Pcfccn/Dash/docs/future/README.md

# Доработки: исследования, планы и сборка

Здесь — то, что начиналось как исследование или план. Часть уже в прошивке (статус ниже), остальное ждёт деталей или решения. Каждая доработка — отдельный файл: идея, железо, BOM, план интеграции в прошивку и открытые вопросы.

| Доработка | Статус | Файл |
|---|---|---|
| GPS-скорость и замер разгона (0–100, 1/4 мили, «свой Dragy») | **в прошивке** — страница PERF (`perf.c`, 2026-10-22); в машине не проверено | [gps-performance-meter.md](gps-performance-meter.md) |
| Свой одометр по GPS (общий, поездка, счётчик A) и расход дизеля (мгновенный, за поездку, средний) | одометр **в прошивке** — страница TRIP, хранение в SPI NOR (`odo.c`, `nvlog.c`, 2026-10-22); расход — источник на E98 ещё искать | [gps-odometer-fuel.md](gps-odometer-fuel.md) |
| Чистовая сборка: питание, CAN, драйвер подсветки, разъёмы, корпус, список покупок | выбран вариант A, детали заказаны; порядок проверки — §5 | [build-hardware.md](build-hardware.md) |
| Плата-носитель 7×9 см: раскладка, гнёзда под WeAct, клеммники с ключами, список проводов | раскладка готова, не собрана (2026-10-14) | [carrier-board.md](carrier-board.md), чертёж [carrier-board.svg](carrier-board.svg), шаблон [carrier-template.pdf](carrier-template.pdf) |
| Сборка платы-носителя по шагам: каждая деталь и провод, проверка после шага | готово к сборке (2026-10-20) | [assembly.md](assembly.md), картинки в [assembly/](assembly/) |
| Жгут: пять веток из коробки (питание, CAN, GPS, кнопки + габариты, дисплей), цвета, врезки | готово к сборке (2026-10-21) | [harness.md](harness.md), [harness.svg](harness.svg), общая схема [wiring-overview.svg](wiring-overview.svg) |
| Экран: качество картинки и скорость (этап 0 без покупок, IPS-замена, ESP32-S3 со встроенным экраном и CAN) | этап 0 сделан 2026-10-09; палитра под TN и проверка контроллера (настоящий ILI9488) — 2026-10-22; новое железо не выбрано | [display-upgrade.md](display-upgrade.md) |

Чертежи (`*.svg`, `assembly/`, `carrier-template.pdf`) генерируются скриптами из `tools/drawings/` — правится скрипт, а не картинка.
