Pcfccn/Dash/design/Photos/20260724_9/SESSION_NOTES.md

# Сессия 2026-07-24, утро (~10:19–10:20) — расшифровка фото

25 фото. Прошивка с коммитами `1c3979f` (passive CAN oil P), `e9b38e5` (RAIL в bar), `49c65be` (fix false 0.0).
Двигатель запускался, работал на холостом, несколько раз газовали.

---

## DRIVE page

| Фото | RPM  | CLT | OIL | ATF | OIL P | Статус  |
|---|---|---|---|---|---|---|
| 434  | 0 | 13°C  | 13°C  | 13°C  | 0.7 bar 🟠 | CHECK 1 |
| 435  | 842  | 29°C  | 14°C  | 19°C  | 2.5 bar 🟢 | NOMINAL |
| 440  | 787  | 28°C  | 14°C  | 18°C  | 0.5 bar 🟠 | NOMINAL |
| 441  | 2550 | 29°C  | 14°C  | 19°C  | 1.5 bar 🟡 | NOMINAL |
| 442  | 1021 | 27°C  | 14°C  | 17°C  | 0.5 bar 🟠 | NOMINAL |
| 447  | 763  | 17°C  | 13°C  | 14°C  | 2.3 bar 🟢 | NOMINAL |
| 451  | 916  | 17°C  | 13°C  | 14°C  | 0.4 bar 🔴 | NOMINAL |
| 453  | 1023 | 27°C  | 14°C  | 17°C  | 1.2 bar 🟢 | NOMINAL |
| 458  | 842  | 29°C  | 14°C  | 19°C  | 2.0 bar 🟢 | NOMINAL |

Все фото: GEAR=P, Speed=0 km/h, BOOST=0.0 bar. OIL temp не греется — двигатель работал коротко, холодный.

**Проблема:** OIL P хаотично скачет даже на одном и том же RPM — 842 RPM даёт и 2.5 и 2.0 bar, 916 RPM — 0.4 bar (RED), 787 RPM — 0.5 bar. Нет корреляции с RPM. Подозрение на неверный CAN-фрейм или смещение байта в passive decode.

---

## DIAG page

| Фото | BATT | IAT | LOAD | RAIL | Debug footer | Статус  |
|---|---|---|---|---|---|---|
| 439  | 11.9V🟡| 16°C  | 0% | 2 bar | GR 01 OILP 00=0.70 NRC 22/31 | WARN 1  |
| 449  | 13.8V  | 16°C  | 18%  | 395 bar | GR 01 OILP 00=1.17 NRC 22/31 | NOMINAL |
| 455  | 13.7V  | 17°C  | 16%  | 394 bar | (footer обрезан) | NOMINAL |
| 457  | 13.7V  | 16°C  | 20%  | 365 bar | GR 01 OILP 00=1.50 NRC 22/31 | NOMINAL |

Все фото: MIL/CHECK ENGINE=OFF, NO STORED CODES ✓, PID probe: no reply yet.

**Debug строка формат:** `GR 01 OILP [OBD_byte]=[passive_CAN_decoded] NRC 22/31`
- OBD grouped mode-01 всегда возвращает `00` для oil pressure (ECM игнорирует PID)
- `=X.XX` — это значение из passive CAN decode (работает!)
- NRC 22/31 = negative response на DID probe (как и ожидалось)

**BATT 11.9V** в фото 439 (двигатель не работал) — граничное значение, предупреждение появилось.
**RAIL 365–395 bar** при работающем двигателе — норма для дизеля на холостом.
**RAIL 2 bar** при заглушенном — остаточное давление, нормально.

---

## DPF page

| Фото | SOOT | dP DPF | EGT | SINCE REGEN | EGR T° | Статус  |
|---|---|---|---|---|---|---|
| 436  | 8% | 0.0 kPa | -- °C  | -- km | -- °C  | NOMINAL |
| 437  | 8% | -- kPa 🔴 | -- °C  | -- km | -- °C  | WARN 1  |
| 448  | -- % | -- kPa | -- °C  | -- km | -- °C  | NOMINAL |
| 458b | 8% | -- kPa | -- °C  | -- km | -- °C  | NOMINAL |

**ВАЖНО:** dP DPF теперь показывает `--` (NaN) вместо `0.0 kPa` — Astra K DID не отвечает на этом ECM.
Фото 448 — SOOT тоже `--` (NaN!), значит иногда DID для soot тоже не отвечает.
Фото 436 показывает SOOT=8% и dP=0.0 kPa — другое состояние.
REGEN=Inactive, EGT/EGR T°/SINCE REGEN — всегда NaN, как ожидалось.

---

## SNIFF page

### Фото 438 — WARN 1, 60 fps, IDS 38, L120 (повёрнут)
**STATE**:
```
287.0  4  820043C1
0C9.7  2  FF00
0C9.3  4  000D070A
199.0  4  (нечётко)
```
**ANALOG**:
```
1E1.1  00>FF =00
0BE.5  00>FF =FF
19D.3  00>FF =FD
3D3.5  00>FF =00
1AA.2  06>F6 =16
```

### Фото 443 — NOMINAL, 45 fps, IDS 31, L322, OBD paused
**STATE** (ключевые данные):
```
0BE.0  4  04080C00
0BE.5  4  FFFEFD00
0C9.1  2  0F0E           ← НОВОЕ: 2 байта; 0x0F=15, 0x0E=14 (похоже на температуры)
0C9.3  4  070A0D00
191.3  6  B4B0AFB1B2B5   ← расширился до 6 байт (вчера было 5)
191.5  6  B4B0AFB1B2B5
```
**ANALOG**:
```
0BE.5  00>FF =FE
1E1.1  00>FE =FE
19D.3  00>FE =FE
1AA.5  00>F0 =40
0C9.2  27>FF =FF         ← НОВОЕ: диапазон 0x27(39)..0xFF(255), сейчас 0xFF
```

### Фото 446 — NOMINAL, 46 fps, IDS 31, L327, OBD paused
**STATE**:
```
0BE.0  4  04080C00
0BE.5  4  FFFEFD00
0C9.3  4  070A0D00
191.1  7  B4B1B0AFB1B2B5B6  ← 7 байт! (вчера 5, сегодня раньше 6)
191.3  7  B4B0AFB1B2B5B6
191.5  7  B4B0AFB1B2B5B6
```
**ANALOG**:
```
0BE.5  00>FF =FE
1E1.1  00>FF =FD
19D.3  00>FE =FE
1AA.5  00>F0 =50
0C9.2  27>FF =E1
```

### Фото 458 — NOMINAL, 45 fps, IDS 30, L313, OBD paused
**STATE**:
```
0BE.0  4  04080C00
0BE.5  4  FFFEFD00
0C9.3  4  070A0D00
0F1.0  4  8DB1A599
199.0  2  CF0F
199.5  2  8D90
```
**ANALOG**:
```
0BE.5  00>FF =FE
1E1.1  00>FE =FD
19D.3  00>FD =00
1AA.5  00>F0 =00
287.0  00>C1 =82
```

---

## Сводный анализ сессии

### Что работает (улучшения после коммитов)
1. **OIL P читается с CAN** — passive decode подхватывает значение, "--" больше нет при работающем двигателе
2. **RAIL в bar** — 365-395 bar на холостом, физически корректно
3. **Нет false 0.0 CRIT** при работающем двигателе (в большинстве случаев)
4. **MIL OFF / NO STORED CODES** — чисто

### Проблемы

#### 1. OIL P нестабильна — приоритет высокий
| Состояние | Значение | Ожидание |
|---|---|---|
| RPM=0 (прогрев) | 0.7 bar 🟠 | должно быть NaN или скрыто |
| RPM=842 | 2.5 / 2.0 bar | норма ~2-3 bar ✓ |
| RPM=787 | 0.5 bar 🟠 | слишком мало |
| RPM=916 | 0.4 bar 🔴 | CRIT при работающем моторе |
| RPM=2550 (газ)  | 1.5 bar 🟡 | при 2550 ожидается 4-5 bar |

Вывод: passive CAN decode видит нужный фрейм, но **значения не коррелируют с RPM** и физически неправдоподобны. Скорее всего: неверный байт или неверная формула масштабирования. При 2550 RPM должно быть >4 bar, а показывает 1.5 bar.

#### 2. DPF данные нестабильны
- SOOT: иногда 8%, иногда "--" — DID отвечает не каждый раз
- dP DPF: иногда 0.0, иногда "--" — аналогично
- Astra K DIDs (soot, dP) на этом ECM ненадёжны

#### 3. DPF page WARN при dP=NaN
Фото 437: dP показывает "--" и статус WARN — скорее всего alert триггерится на NaN для dP DPF, что неверно. NaN = не читается, а не критическое значение.

#### 4. BATT 11.9V — WARN alert
При заглушенном двигателе (ключ вставлен). Реальная проблема или порог слишком высокий?

### Новые CAN ID (интересные)
- `0C9.1` байты = `0F 0E` → 15, 14 в десятичном. Совпадает с ATF (~14-16°C) и OIL (~13-14°C) — возможно, это broadcast темп. масло/КПП?
- `0C9.2` analog range `27>FF` = 39..255 — широкий диапазон, возможно давление масла в raw байтах? 0x27=39 (min), 0xFF=255 (max). При текущем значении 0xFF=255 и 0xE1=225 — с формулой `/36` → 7 bar и 6.25 bar. Выглядит как давление масла!
- `199.0/199.5` = `CF0F` / `8D90` — значения меняются; неизвестный смысл
- `191.x` расширился с 5 до 7 байт — странно (либо фрейм CAN длиннее, либо разные субфреймы захватываются)
