Pcfccn/Dash/docs/enhanced-dids.md

# GM-enhanced DIDs (mode 22) for the Colorado 2.8 / E98

These are the manufacturer-specific parameters that apps like Car Scanner,
Torque and OBD Fusion read — not standard J1979 PIDs, but **UDS mode 22
ReadDataByIdentifier** DIDs. The scaling GM uses varies by ECM and model year,
so every value here is decoded but **must be checked against a known reading on
the car** (the DIAG probe line surfaces the raw byte and, for a wrong DID, the
negative-response code) before its scaling is trusted.

Header: engine parameters are requested from the **ECM at 0x7E0** (response
0x7E8); transmission parameters from the **trans controller at 0x7E2** (response
0x7EA) — confirmed for this truck.

## Confirmed on this vehicle

| Parameter | DID | request | formula | notes |
|---|---|---|---|---|
| Trans fluid (ATF) temp | `0x1940` | `22 19 40` → 7E2 | A − 40 °C | reads plausibly (19 °C cold, KOEO 2026-07-21) |
| Engine oil temp | `0x1154` | `22 11 54` → 7E0 | A − 40 °C | ✅ confirmed — DRIVE OIL 17 °C cold (KOEO 2026-07-21) |
| DPF soot accumulation | `0x336A` | `22 33 6A` → 7E0 | A × 100/255 % | ✅ confirmed — SOOT 8 % (KOEO 2026-07-21); intermittent 2026-07-24 (polled-RX era); **polled again as a DIAG probe since 2026-10-23** |
| DPF differential pressure | `0x20F4` | `22 20 F4` → 7E0 | SIGNED(A) kPa | ✅ answers — 0.0 kPa engine-off (correct); scaling under load TBD; **DIAG probe since 2026-10-23** |
| Selector / PRNDL | (broadcast `0x1F5`, not a DID) | — | b3: 1 P / 2 R / 3 N / 4 D | see [sniff-selector.md](sniff-selector.md) |

## Oil pressure — mode 22 confirmed absent on this E98

Both known GM mode-22 DIDs have been probed with engine running and rejected:

| DID | result |
|-----|---|
| `0x1470` | ❌ NRC 22/31 (requestOutOfRange) — not in this ECM's table |
| `0x115C` | ❌ NRC 22/31 (requestOutOfRange) with engine running, confirmed 2026-07-23 |

The gasoline Colorado V6 uses a different ECM where `0x1470` works; it does not carry over to the diesel E98.

> **Update 2026-10-10:** the LWN's oil pressure is GM PID **`0xA22C`** (`A × 4 kPa`),
> read GMLAN-style with `$2C`/`$AA` per ScanGauge's LWN 2.8 list — now in the
> firmware, see [oil-pressure-test.md](oil-pressure-test.md). The broadcast hunt
> below is history: `0x1BA[3]` was rejected and `0x0C9[2]` is the RPM low byte.

### Oil pressure via passive CAN broadcast (superseded)

The OEM cluster reads oil pressure from a periodic broadcast frame the ECM transmits unconditionally (same approach as the selector via `0x1F5`).

**Candidate: CAN ID `0x1BA`, byte 3**
- Source: SNIFF ANALOG capture, 2026-07-23
- Observed range: `0x06..0xF6` (6–246 counts)
- Values at cold idle (RPM ≈ 1056): 214–246 counts
- Provisional formula: `bar = A / 100.0` → 2.14–2.46 bar at cold idle ✓
- KOEO: 6 counts → 0.06 bar (sensor unloaded) ✓
- **Status: FDCAN filter 2 + passive decode ADDED to firmware** (provisional)
- **Confirmation needed:** throttle blip with SNIFF active — byte 3 of `0x1BA` must track RPM rise; if it doesn't, try byte 6 (range `0x09..0xF9`, near-identical) or other ANALOG candidates (`0x1AA` byte 2, `0x287` byte 0)

## DPF probe (2026-10-23)

The four DPF DIDs were dropped on 2026-07-24 (`b92b875`) as "never answered".
The notes of that day show soot reading 8 % on some photos and `--` on others.
At the time RX was drained only from the main loop behind a blocking display
flush, which also killed every multi-frame reply. Since stage C, RX is
interrupt-driven, so they are asked again, as a probe, not a gauge:

- **When:** the second slow slot (`req_dpf()`), once the PID support maps are
  read. One DID per slot in turn (soot → ∆p → regen → since-regen), each about
  every 2–3 s.
- **Refused:** a DID refused with an NRC other than `0x21` busy / `0x22`
  conditions-not-correct is not asked again (`Xnn` on DIAG).
- **Silent:** a DID unanswered 10 times in a row is not asked again either
  (`SIL`). Each miss holds the one transaction slot for 150 ms.
- **DIAG line 3, view 4:** `DPF SOOT 23% DP 1kPa REGEN OFF KM --`.
- **DIAG line 3, view 5:** `DPF OK S48/48 P46/48 R48/48 K48/48`, answers per
  our requests for each DID. These counts decide whether a gauge or a strip
  alarm (soot high, regeneration running) is worth building.

## Added, awaiting on-car confirmation
| Distance since regen | `0x3039` | `22 30 39` → 7E0 | A×256 + B km | ⚠️ answers **0xFFFF** = no-data (now guarded → `--`); confirm real value after a recorded regen |
| DPF regen status | `0x20F6` | `22 20 F6` → 7E0 | A & 1 → active | reads Inactive KOEO — can't distinguish answer from default; verify during active regen |

The DPF set comes from the **Opel/Vauxhall Astra-K** extended-PID lists — the
same GM Global-B diesel family as this E98, so the `22 30xx / 33xx / 20xx` DID
block is expected to carry over. The soot `A×100/255 %` scaling also matches the
independent Colorado hint that soot there is reported in percent, not grams.
Other Astra-K DIDs seen and worth trying if these miss: `0x2320/0x2321` (O2
sensors, A×0.01 V), `0x3035` (DPF Δp sensor raw, A×5.5/255 V), `0x20F5`
(calculated DPF flow).

The standard oil-temp PID `0x5C` and the wide diesel PIDs `0x6B` (EGR temp) and
`0x78` (EGT) are **not answered** by this E98, so the enhanced DIDs above are the
real source. Oil pressure decodes to bar; DIAG line 3 (its first view) shows
the probe as `OILP <path> 22/<nrc> 2C/<nrc> AA/<nrc> RAW <byte>` — verify the
raw byte against ~2–3 bar warm idle before the tile loses its `?`
(docs/oil-pressure-test.md).

## Standard diesel PIDs: what the support maps say (not polled)

No open source gives a verified formula for the LWN 2.8 diesel-emissions set, and
the Colorado forums are paywalled. An earlier image probed the standard J1979
diesel PIDs below one per cycle; **that probe is gone** (each unanswered PID held
the one transaction slot for 150 ms, and 0x78 never answered). Today the ECM's
own PID support maps are read once per power-up and shown on DIAG line 3
(`PID 00:… 20:… 40:…`, then `60:… 80:… A0:… 5E±`, 8 hex digits per map,
`--------` = not read): whether a PID below is supported is read off those
bits (`obd_pid_supported()`), and only then is it worth a decoder. Their
decoders still run on another tester's replies. The DPF values themselves come
from the GM DIDs above (DIAG views 4 and 5, `DPF SOOT …` / `DPF OK …`).

| PID | parameter | data bytes | notes |
|---|---|---|---|
| `0x78` | EGT bank 1 | 9 | sensor 1 = (256·B+C)/10−40 °C (already decoded) |
| `0x7A` | DPF differential pressure | 7–9 | scaling TBD from raw |
| `0x7C` | DPF temperature | 9 | (256·B+C)/10−40 °C likely, confirm from raw |
| `0x8B` | diesel aftertreatment status | 7 | bit-encoded regen/soot status |
| `0x86` | particulate matter (soot) | 5 | scaling TBD from raw |
| `0x6B` | EGR temperature | 5 | B−40 °C (this ECM did not answer earlier) |

If the maps show one of these as supported, it goes back on the scheduler for
its raw bytes, and the scaling is derived against known conditions (e.g. DPF
dp ≈ 0 at idle, EGT ≈ ambient cold) before it gets a decode and a gauge.

Community hint to check against the raw: on the 2.8 the DPF **soot is reported
in percent, not grams**, and one forum listed soot via `PID 8B` byte C as
`(100/255)·C`.

If a standard PID never answers, the fallback is the SNIFF ANALOG list (a
warm-up / throttle-blip broadcast capture) — the method that found the selector.

## Sources

- [coloradofans — GM PIDs for scantools/OBD tools](https://www.coloradofans.com/threads/gm-pids-for-scantools-obd-tools-torque-app-xgauge-etc.294922/)
- [ssforums — OBD2 PID codes](https://www.ssforums.com/threads/obd2-pid-codes.41346/)
- [Torque forum — GM oil pressure PID](https://torque-bhp.com/community/main-forum/gm-oil-pressure-pid-2/)
- [Harry's LapTimer forum — GM oil temp & pressure, trans temp](http://forum.gps-laptimer.de/viewtopic.php?t=2292)
