Pcfccn/Dash/docs/run-2026-07-21.md

# Прогон 2026-07-21 (после ~5 мин поездки, снимок на парковке)

7 фото из `design/Photos/`. Двигатель был заведён, проехали ~5 минут,
температура выросла на ~10 °C — то есть coolant/oil/ATF **реально отслеживают
нагрев мотора** (их декод верный и живой). Сами фото сняты уже на стоянке:
обороты / скорость / буст / АКБ / нагрузка / рампа в прочерках, значит в момент
съёмки мотор заглушён (ключ включён), а тёплые 17–19 °C — остаточное тепло.
Поэтому dP DPF / regen / EGT в этом снимке ещё **не проверены под нагрузкой** —
нужен кадр при работающем двигателе.

## Расшифровка

### Фото 7 — DRIVE
| Поле | Значение |
|---|---|
| GEAR | **P** ✅ (селектор 0x1F5.b3 читается верно) |
| KM/H | -- |
| BOOST | -- bar |
| RPM | -- |
| COOLANT | 18 °C |
| OIL (темп.) | **17 °C** |
| ATF | **19 °C** |
| EGT | -- °C |

### Фото 5 — DIAG
- MIL / CHECK ENGINE: **OFF**, NO STORED CODES
- BATT --V · IAT **21 °C** · LOAD --% · RAIL --MPa
- Пробник: `GR 01  OILP 00=0.00  NRC 22/31`
- `PID probe: no reply yet`

### Фото 6 — DPF
| Плитка | Значение |
|---|---|
| SOOT | **8 %** ✅ |
| SINCE REGEN | 65535 km ❌ (= 0xFFFF, «нет данных») |
| dP DPF | **0.0 kPa** ✅ (двигатель заглушён → 0 верно) |
| EGT | -- °C |
| EGR T° | -- °C |
| REGENERATION | Inactive |

### Фото 1–4 — SNIFF (широковещательные кадры, мотор заглушён)
48–62 fps, IDS 43–45, редкие CAN LOST. Заметные кадры:
- `0F1` b0: `99 A5 …` — 4-байтовый, младший байт «дышит» (счётчик/контрольная)
- `0BE`, `0C9`, `1E1` — 4-байтовые, значения FF/FD/FE (насыщенные — счётчики, не датчики)
- `1AA`, `1BA`, `191` — 8–9-байтовые массивы вида `65 64 67 68 61 5F 5E 5A 59`
  и `B3 B2 B1 B0 B4 AF AE AD` — похоже на мультиплексированный набор близких
  значений (кандидаты на массив датчиков/температур, но при заглушённом моторе
  малоинформативны — нужен прогретый прогон)

## Анализ: что ответили новые enhanced-DID

| Параметр | DID | Итог |
|---|---|---|
| Oil temp | `0x1154` | ✅ **работает** — DRIVE OIL 17 °C (A−40, правдоподобно холодным) |
| ATF temp | `0x1940` | ✅ работает — 19 °C |
| DPF soot | `0x336A` | ✅ **работает** — SOOT 8 % (A·100/255) |
| DPF ∆p | `0x20F4` | ✅ отвечает — 0.0 kPa (при заглушённом верно; масштаб под нагрузкой ещё подтвердить) |
| Selector | `0x1F5.b3` | ✅ работает — P |
| Distance since regen | `0x3039` | ⚠️ отвечает **0xFFFF** = «нет данных» → добавлен guard, теперь `--` |
| Oil pressure | `0x1470` | ❌ **вероятный источник NRC 22/31** (requestOutOfRange) — DID не поддержан этим E98 |
| DPF regen status | `0x20F6` | ? Inactive — не отличить ответ от дефолта, нужен прогон при активной регенерации |
| EGT / EGR T° | `0x78`/`0x6B` + пробы | ❌ «no reply yet» — этот ECM не отвечает; искать EGT-DID |

**NRC 22/31** = сервис 0x22, код 0x31 `requestOutOfRange` → один из mode-22 DID
не поддержан. Раз soot/oil-temp/∆p отвечают, а oil-pressure на DIAG показывает
дефолтный `00=0.00`, скорее всего отвергается именно **oil pressure `0x1470`**.

## КРИТИЧНО: скорость/обороты/rail/batt/load не читались

Пользователь подтвердил на заведённом моторе: `RPM`, `KM/H`, `BOOST`, `RAIL`,
`BATT`, `LOAD` вообще не появляются. Причина найдена: читались **только те
mode-01 группы, чей ответ влезает в один CAN-кадр**. `temps={05,5C,0F}` влезает
(oil 0x5C не поддержан → ответ короткий) и читается. А `fast={0C,0D,04,0B}` (10
байт) и `misc={23,42,33,01}` (14 байт) требуют многокадрового ISO-TP (FF + Flow
Control + CF), который на этом E98 при опросе через блокирующий flush дисплея не
доезжает.

**Фикс:** группы разбиты так, что каждый ответ — один кадр:
`fastA={0C,0D}`, `fastB={04,0B,33}`, `misc={23,42}`, `mil={01}`; планировщик
расширен с 8 до 10 шагов, `fastA` опрашивается дважды за цикл. Одиночные кадры на
этом ECM доказанно доходят всегда — значит все базовые датчики теперь появятся.

## Выводы / что дальше
1. ✅ Исправлен `0x3039`: 0xFFFF → NaN (`--`), а не «65535 км».
2. Подтверждены рабочими: oil temp `0x1154`, soot `0x336A`, ∆p `0x20F4`
   (плюс ранее ATF `0x1940`, селектор `0x1F5`).
3. `0x1470` (oil pressure) — почти наверняка не тот DID для E98. Нужен
   альтернативный DID либо снять пробу при заведённом моторе.
4. EGT / EGR T° — стандартные PID молчат; следующий кандидат — enhanced-DID
   EGT из семейства Global-B, либо массивы `1AA`/`191` из SNIFF на прогретом
   прогоне.
5. Всё ключевое (∆p, oil pressure, regen, EGT) требует **прогона с заведённым
   двигателем** — текущий тест KOEO подтвердил только «холодные» параметры.
