Pcfccn/Dash/docs/future/carrier-board.md

# Плата-носитель 7×9 см: раскладка и провода

Картинка: [carrier-board.svg](carrier-board.svg) — вид сверху (сторона, где стоит WeAct). Что к чему подключается снаружи платы (машина, экран, кнопки, GPS) — [wiring-overview.svg](wiring-overview.svg). **Пайка по шагам, с каждой деталью и проводом — [assembly.md](assembly.md).** **Шаблон 1:1 для печати** — [carrier-template.pdf](carrier-template.pdf): вид сверху, вид снизу (зеркально, с шинами), бирки на провода. Схема узлов и номиналы — [build-hardware.md](build-hardware.md) §3, маркировка жгута X1–X5 — там же, «Маркировка жгута».

**Статус:** план для пайки, 2026-10-14; 2026-10-26 — гнёзда клеммников на проводах, ключи на X1 / X2 / X4, X3 перенесён из-под штекера USB-C, 100 Ом в линиях GPS. Ничего из этого ещё не собрано и не проверено.

## 1. Распиновка гребёнок WeAct

Источник — схема WeAct `STM32H7xx SchDoc V12.pdf` и чертёж `BoardShape V12` (репозиторий WeActStudio/MiniSTM32H7xx, папка `Hardware`). Две гребёнки 2×22: **P1** и **P2**. **Перед пайкой сверить с шелкографией своей платы:** у P1 вывод 1 = GND, 2 = 5V; у P2 вывод 1 = GND, 2 = 3V3. По чертежу (вид сверху) у P1 нечётные выводы снаружи, у P2 — внутри.

| P1 нечёт. | P1 чёт. | | P2 нечёт. | P2 чёт. |
|---|---|---|---|---|
| 1 GND | 2 **5V** | | 1 GND | 2 **3V3** |
| 3 PE1 | 4 PE0 | | 3 PE2 | 4 PE3 |
| 5 PB9 | 6 PB8 | | 5 PE4 | 6 PE5 |
| 7 PB7 | 8 PB6 | | 7 PE6 | 8 VBAT |
| 9 PB5 | 10 PB4 | | 9 PC13 (KEY) | 10 NRST |
| 11 PB3 | 12 PD7 | | **11 PC0** — дисплей CS | 12 PC1 |
| 13 PD6 | 14 PD5 | | 13 PC2 | 14 PC3 |
| 15 PD4 | 16 PD3 | | 15 GND | 16 VREF+ |
| 17 PD2 | **18 PD1** — CAN TX | | 17 PA0 | 18 PA1 |
| **19 PD0** — CAN RX | 20 PC12 | | **19 PA2** — TX → GPS | **20 PA3** — RX ← GPS |
| 21 PC11 | 22 PC10 | | 21 PA4 | 22 PA5 |
| 23 PA15 | 24 PA12 | | 23 PA6 | 24 PA7 |
| 25 PA11 | 26 PA10 | | **25 PC4** — дисплей DC | **26 PC5** — дисплей RST |
| 27 PA9 | **28 PA8** — подсветка (ШИМ) | | 27 PB0 | 28 PB1 |
| 29 PC9 | 30 PC8 | | 29 PB2 | **30 PE7** — ▶ |
| 31 PC7 | 32 PC6 | | **31 PE8** — ● | **32 PE9** — ◀ |
| 33 PD15 | 34 PD14 | | 33 PE10 | 34 PE11 |
| 35 PD13 | 36 PD12 | | 35 PE12 | 36 PE13 |
| 37 PD11 | 38 PD10 | | 37 PE14 | **38 PE15** — габариты |
| 39 PD9 | 40 PD8 | | 39 PB10 | 40 PB11 |
| **41 PB15** — дисплей SDI | 42 PB14 | | **41 3V3** | **42 5V** |
| **43 PB13** — дисплей SCK | 44 PB12 | | **43 GND** | 44 GND |

Жирным — то, что подключается. PE10–PE14 заняты экраном статуса на самой WeAct, PC13 — кнопка KEY. Земля платы-носителя берётся только с P2.43 (§5): P2.44 и P2.15 к шине не подключаются.

По чертежу `BoardShape V12` плата WeAct — 40.64 × 66.88 мм. Вывод 1 обеих гребёнок и разъём SWD (4 вывода: 3.3V, DIO, CLK, GND) — на одном торце, USB-C — на противоположном; центр USB-C — в 28.2 мм от края со стороны P2.

## 2. Гнёзда под WeAct: хватит двух 1×40

Гребёнок 4 ряда по 22 = 88 выводов, а гнёзд в заказе 2 × 40 = 80. Хватает, потому что **выводы 1–4 обеих гребёнок не нужны**: GND / 5V / 3V3 есть и внизу (P2.41–44), а PE0–PE3 не используются.

- Женская гребёнка режется **через гнездо** — одно гнездо на каждом разрезе пропадает. Из каждой 1×40 получится 20 + 19.
- **Полоски по 20** — на P1 (обе колонки): выводы 5–44. **Полоски по 19** — на P2: выводы 7–44 (P2.5 / P2.6 = PE4 / PE5, не нужны).
- Выводы 1–4 (и 5–6 у P2) просто висят над платой без гнёзд — штырьки WeAct короче высоты гнёзд и до макетки не достанут.
- Вставить гнёзда на штырьки WeAct, поставить всё вместе на макетку и только потом паять — так ряды встанут ровно.

## 3. Клеммники 3.81 мм на сетке 2.54: гнёзда на проводах

Клеммники с шагом 3.81 под макетку 2.54 выбраны ошибочно: 3.81 — это полтора шага сетки, в отверстия выводы сами не встают. Подошли бы 5.08 (ровно два шага). Клеммники уже пришли, поэтому каждый вывод попадает в своё отверстие со сдвигом.

Размеры — из чертежей KEFA KF2EDGV-3.81 (гнездо) и KF2EDGK-3.81 (вилка):

- вывод — квадрат **0.8 × 0.8 мм**, длина под корпусом **3.7 мм**;
- корпус гнезда 7.0 мм в глубину, 9.2 мм в высоту, n × 3.81 + 0.8 мм в длину; ряд выводов — в 3.0 мм от одной стенки, не посередине;
- вилка такой же длины, 11.1 мм в глубину, 15.6 мм в высоту.

### Карта отверстий

Одна для обоих способов ниже. Выводы идут парами навстречу друг другу: 1 и 2, 3 и 4, 5 и 6, 7 и 8. Каждый вывод стоит в 0.635 мм (четверть шага) от своего отверстия. Пара попадает в два соседних отверстия, между парами одно отверстие пропускается. Непарный последний вывод (у 3-контактного) сдвигается наружу. На картинке: ■ — где вывод выходит из корпуса, ● — его отверстие, ✕ — ключ (ниже, «Ключи»): вывода нет, отверстие пустое.

| Клеммник | Отверстия ряда от вывода 1 | Где на плате | Ключ |
|---|---|---|---|
| 3 конт. — X1 питание | 1, 2, 4 | C30, D30, F30 | вывод 2 (D30) |
| 4 конт. — X2 CAN | 1, 2, 4, 5 | P30, Q30, S30, T30 | вывод 3 (S30) |
| 4 конт. — X3 GPS | 1, 2, 4, 5 | W26, W27, W29, W30 | — |
| 6 конт. — X4 кнопки + габариты | 1, 2, 4, 5, 7, 8 | W16, W17, W19, W20, W22, W23 | вывод 6 (W23) |
| 8 конт. — X5 дисплей | 1, 2, 4, 5, 7, 8, 10, 11 | W2, W3, W5, W6, W8, W9, W11, W12 | — |

Отверстия **не сверлить**. В первой версии здесь было «рассверлить до Ø1.4», а через шаг — «отверстия металлизированы, припой затечёт». Одно исключает другое: сверло снимает металлизацию, и пайка держится только на пятачке снизу.

### Способ 1 — основной, для машины: гнездо на проводах

Выводы гнезда в макетку не вставляются. К каждому выводу припаивается короткая проволочка, и в своё отверстие входит уже она — обычное, металлизированное. Корпус гнезда приклеен к плате: когда вилку вставляешь и вынимаешь, усилие идёт в клей, а не в пайки. Так же гнёзда работают как разъём «провод–провод» в жгуте (build-hardware.md, «Разъёмы и жгут»).

Что нужно:

- **проволочки** — по одной на вывод, 22 шт. (ключам не нужны). Жила 22 AWG без изоляции: зачистить кусок ~12 мм, скрутить, залудить. Или откушенные ножки резисторов;
- **термоусадка 3 мм** — на каждый вывод с проволочкой. Её ещё нет: она в списке покупок (build-hardware.md §8). Белая 5.5 мм из заказа не годится: после усадки она ~2.75 мм, а стык вывода с проволочкой ~1.5 × 0.8 мм — болтается и сползает;
- **клей под корпус** — эпоксидка (5-минутка) или двусторонний вспененный скотч, тоже в списке покупок. Термоклей не годится: он размягчается при 60–70 °C, а на торпеде бывает 70–90 °C. Стяжкой корпус не прижать: в отверстие макетки (~1 мм) стяжка 2.5 мм не пройдёт, а поверх гнезда она мешает вилке.

Порядок:

1. **Ключи** — сначала (ниже, «Ключи»): вынуть штыри-ключи из гнёзд X1, X2, X4.
2. **Проволочки.** Надеть на проволочку кусок термоусадки 3 мм длиной ~4 мм. Припаять проволочку внахлёст к выводу, на 2–3 мм от кончика, **с той стороны, куда сдвинуто его отверстие**: к соседу по паре, у непарного — наружу. Ось проволочки отойдёт от оси вывода на ~0.7 мм. Это и есть нужный сдвиг: прямая проволочка сама смотрит в своё отверстие. Сдвинуть термоусадку на стык и усадить.
3. **Примерить.** Все проволочки входят в отверстия без усилия, ничего не гнуть. Корпус встанет на ~4 мм над платой: вывод 3.7 мм плюс зазор над пятачком. Подложить под корпус что-то такой толщины (стопку картона), чтобы он стоял ровно.
4. **Паять снизу**, лишнее откусить до ~1 мм (§7).
5. **Приклеить корпус.** Эпоксидку — в зазор под корпусом, с обеих длинных сторон, мимо проволочек. Или вместо картона сразу полоски вспененного скотча толщиной в зазор: они и выставят высоту, и удержат корпус. Вилку не вставлять, пока клей не встал (у эпоксидки — сутки).
6. **Прозвонить:** каждый вывод — со своим отверстием, соседние между собой — нет.

Если места под крышкой мало (§7), выводы гнёзд можно до пайки укоротить бокорезами до ~2 мм. Корпус тогда встанет на ~2.5 мм над платой.

### Способ 2 — гнуть выводы: только для стола

Каждый вывод сам входит в своё отверстие, со ступенькой на 0.635 мм. Способ годится, только если прямой вывод запасного гнезда входит в отверстие без усилия. По диагонали квадрат 0.8 мм даёт 1.13 мм, а отверстия у таких макеток около 1.0 мм. Не входит — способ отпадает: остаётся способ 1. Пробовать на запасном 2-контактном — их 20 при 10 вилках.

- Зажать вывод плоскогубцами у самого корпуса, отогнуть к соседу по паре на **~40°**, перехватить на 1 мм ниже и выпрямить кончик. Ступенька — 1 мм · sin 40° ≈ 0.64 мм, по высоте она занимает ~0.8 мм. Это внутри зазора 1.5 мм под корпусом. (Было «на 20°»: это 1 · sin 20° ≈ 0.34 мм, вдвое меньше нужного.)
- Корпус — на 1.5 мм над платой, на время пайки подложить полоску картона. Снизу кончик выходит всего на ~0.4 мм: 3.7 − 1.5 − 1.6 (плата) = 0.6 мм, и ещё ~0.2 съедает ступенька.
- **Почему только стол.** Пайка держится на коротком кончике, изгиб у корпуса расшатывает вывод в пластике, а всё усилие вилки идёт в эти пайки. От вибрации в машине они трескаются.

Если вывод сломался — припаять к остатку проволочку, как в способе 1.

### Ключи: чтобы вилка не вошла в чужое гнездо

Короткая вилка входит в любое более длинное гнездо. Без ключей вилка X1 (+12 В) встаёт в гнездо X3, и 12 В попадают на шину 3V3. Вилка X2 (CAN) встаёт в X3: CAN-H на 3V3, CAN-L на GND, и шина машины зажата в доминантном состоянии.

Схема — без покупок, из того, что есть (пар 3-контактных 10, 4-контактных 5):

- **X1** — 3-контактный: 1 +12 В ACC, **2 ключ**, 3 GND;
- **X2** — 4-контактный: 1 CAN-H, 2 CAN-L, **3 ключ**, 4 GND;
- **X4** — ключ на месте 6 (было «запас»);
- X3 и X5 — без ключа.

**Как сделать ключ:**

- **В гнезде** — вынуть этот штырь: плоскогубцами за вывод снизу. Не выходит — откусить заподлицо с обеих сторон корпуса.
- **В вилке** — это же место заткнуть. Вставить вынутый штырь в это место вилки — в отверстие, куда входит штырь гнезда, — до упора, откусить заподлицо с торцом вилки, затянуть винт этого места. Если штырь откушен и пропал — взять штырь из запасного 2-контактного гнезда.
- Проверить: штырь из вилки рукой не вынимается. Если винт его не держит — капля того же клея.

**Что получается** (перебором всех пяти вилок по всем пяти гнёздам, если торцы гнёзд закрыты):

- вилка X4 (в ней ILL+, 12 В) входит только в X4, вилка X2 — только в X2: CAN-H на 3V3 больше не попадёт;
- вилка X1 входит в X1 и ещё в X2, со сдвигом на одно место: +12 В тогда на CANL трансивера, масса на GND. Постоянные 12–14.8 В линии SN65HVD230 (−4…+16 В) выдержат, но TVS стоит у гнезда X1, не на этом пути: выброс бортсети дойдёт до CANL без ограничения (ревью C9). Поэтому вилку X1 — только по метке, и после установки проверить: на X2.1 / X2.2 нет 12 В;
- в вилках X3 и X5 12 В нет. Вилка X3 входит ещё в X2, X4 и X5, а в X5 на её RX попадут 5 В подсветки. Поэтому её всё равно вставлять по метке.

**Проверить на запасном гнезде:** закрыты ли торцы корпуса. Если открыты, вилка может встать со свесом за край гнезда, и ключ это не поймает. Тогда записать и сообщить.

### Вилка и провода

**Вилка** KF2EDGK шире гнезда: 11.1 мм против 7, по длине такая же. Она свисает примерно на 4 мм в одну сторону, на картинке пунктиром. Свес на высоте больше 10 мм, над низкими деталями, поэтому не мешает. Нарисован наружу, к краю платы.

**Провод** входит в вилку с торца, противоположного контактам. На вертикальном гнезде провода выходят **вверх**, винты смотрят вбок. Вилку удобнее прикрутить к проводам снаружи коробки и потом вставить. Из-за проводов вверх плата стоит на гайках, а не на стойках (§7).

## 4. Что где стоит

- **WeAct** — в левой части: P2 в колонках A–B, P1 в колонках O–P, ряды 2–23 (вид на картинке). Под ней на плате — только провода и шины. Вывод 1 и разъём SWD — у верхнего края (ряд 1), USB-C — у нижнего, смотрит на ряд 30. Центр USB-C — между колонками K и L, край WeAct — между рядами 25 и 26.
- **Полоса под штекер USB-C — колонки I–N, от ряда 26 до края платы.** Прямой штекер с кабелем — 15–21 мм, шириной ~12 мм, на высоте ~11–17 мм над платой (WeAct на гнёздах 8.5 мм). В этой полосе ничего не ставить. Раньше здесь, в H–L ряда 30, стоял X3 — штекер упёрся бы в его вилку. PD65W поставить в коробке за нижним краем платы, чтобы кабель шёл прямо. Если штекер толще 12 мм или кабель всё равно упирается — кабель с угловым штекером USB-C (90°), он в списке покупок «по желанию».
- **SWD смотрит в стенку коробки.** Разъём SWD WeAct — у верхнего края платы, штырями наружу. Чтобы прошивать в коробке, у этого края оставить ≥ 15 мм под колодку Dupont или заранее надеть на SWD шлейф и вывести его под крышку. В машине прошивать с открытой крышкой. Если плата при этом питается от машины, от клона ST-LINK подключать только SWDIO, SWCLK и GND, **не его 3.3 В**: иначе два источника 3V3 работают друг на друга.
- **Правый край (колонки R–X):**
  - X5 дисплей (8, ряды 2–12), X4 кнопки + габариты (6, ряды 16–23) и X3 GPS (4, ряды 26–30) — вертикально в колонке W;
  - между ними и WeAct: драйвер подсветки (2N7000 + 3 резистора, ряды 2–8), кнопки (3 × 1 к подтяжка + 3 × 100 нФ + 3 × 1 к в линию к PE7–PE9, ряды 10–16), датчик габаритов (BC547, 47 к, 100 к, 100 нФ, 1N4148, 10 к, ряды 17–23), GPS — 2 × 100 Ом в линию (ряды 26–27, колонки R–U).
- **Нижний край, ряд 30:** X1 питание (3, колонки C–F) и X2 CAN (4, P–T), между ними — полоса USB-C. Над X1, в рядах 26–27, колонки B–H, — TVS 1.5KE20A.
- **Шины по нижней стороне:** GND — голым лужёным проводом вдоль ряда 25, 3V3 — вдоль ряда 24, обе от колонки B/C до V. Каждая берётся с одной точки (P2.43 и P2.41) — без петель.
  - **3V3:** от P2.41 (B22) сначала вправо в C22, потом по колонке C вниз до ряда 24 и по ряду 24. **Не вниз по колонке B:** там P2.43 (B23) — это GND, получится КЗ.
  - **GND:** от P2.43 (B23) вниз по колонке B до ряда 25 и по ряду 25.
  - В рядах 24–25 детали не ставить: их выводы лягут на шины. Поэтому датчик габаритов — в рядах 17–23.
  - Как это выглядит снизу — лист 2 шаблона [carrier-template.pdf](carrier-template.pdf).
- **Вне платы, в коробке на двустороннем скотче:**
  - PD65W — за нижним краем платы (под прямой кабель USB-C); вход от X1 через TVS, USB-C → WeAct;
  - модуль CAN SN65HVD230;
  - модуль Si4599.

  Размеры модулей у меня неточные, поэтому на макетке под них место не планировал. Если поместятся на плату — тем лучше, провода те же.

## 5. Провода

Номер вывода WeAct — `P1.n` / `P2.n` из таблицы §1. Провод внутри платы — тонкий одножильный (или ножки деталей) по нижней стороне.

| Цепь | Откуда | Куда | Через / заметка |
|---|---|---|---|
| +12 В | X1.1 | вход PD65W «+» | TVS 1.5KE20A: катод (полоска) на X1.1, анод на GND |
| ключ | X1.2 | — | вывода нет (§3, «Ключи») |
| Масса бортсети | X1.3 | вход PD65W «−», шина GND | — |
| 5 В | кабель USB-C PD65W | USB-C WeAct | WeAct питается от него; прямой штекер — по полосе I–N (§4) |
| 5 В на плату | P2.42 | исток Si4599, R1 (10 к) | только подсветка дисплея; ~4.6–4.8 В: 5 В USB идут через диод D10 на WeAct |
| 3V3 | P2.41 | шина 3V3 | GPS, CAN-модуль, дисплей, подтяжки |
| GND | P2.43 | шина GND | одна точка; P2.44 и P2.15 к шине не подключать |
| Подсветка: ШИМ | P1.28 (PA8) | R2 1 к → затвор 2N7000 | R3 100 к затвор → GND |
| Подсветка: ключ | сток 2N7000 | затвор Si4599 и R1 10 к → 5 В | исток 2N7000 → GND; прошивка `-D BACKLIGHT_ACTIVE_LOW=0` |
| Подсветка: выход | сток Si4599 | X5.8 (LED) | 5 В через ключ |
| CAN TX | P1.18 (PD1) | CTX / TXD модуля CAN | — |
| CAN RX | P1.19 (PD0) | CRX / RXD модуля CAN | — |
| CAN питание | шина 3V3, GND | VCC, GND модуля CAN | 120 Ом на модуле снять |
| CAN-H / CAN-L | CANH / CANL модуля | X2.1 / X2.2 | витая пара; X2.3 — ключ; X2.4 → GND |
| GPS 3V3 / GND | шина 3V3 / GND | X3.1 / X3.2 | **только 3V3**; провод выходит из коробки — КЗ в нём гасит всю плату, прокладка и PTC по желанию — build-hardware.md, «GPS» |
| GPS TX → МК | X3.3 | 100 Ом → P2.20 (PA3) | резистор у X3: ряды 26–27, колонки R–U |
| МК → GPS RX | P2.19 (PA2) | 100 Ом → X3.4 | так же. Провод до GPS ~1.5 м выходит из коробки — как 1 к у кнопок (build-hardware.md, «Подключение кнопок»). На 115200 бод не влияет |
| ▶ | X4.1 | P2.30 (PE7) | узел: 1 к → 3V3, 100 нФ → GND; от узла к выводу — 1 к в линию |
| ● | X4.2 | P2.31 (PE8) | так же |
| ◀ | X4.3 | P2.32 (PE9) | так же |
| Общий кнопок | X4.4 | шина GND | — |
| Габариты | X4.5 (ILL+, в жгуте у врезки уже есть 10 к — [harness.md](harness.md), X4) | 47 к → база BC547 | база: 100 к → GND, 100 нФ → GND, 1N4148 катодом к базе, анодом к GND; эмиттер → GND |
| ключ | X4.6 | — | вывода нет |
| Габариты → МК | коллектор BC547 | P2.38 (PE15) | 10 к → 3V3 |
| Дисплей VCC / GND | шина 3V3 / GND | X5.1 / X5.2 | — |
| Дисплей CS | P2.11 (PC0) | X5.3 | провода дисплея — короткие |
| Дисплей RST | P2.26 (PC5) | X5.4 | — |
| Дисплей DC | P2.25 (PC4) | X5.5 | — |
| Дисплей SDI | P1.41 (PB15) | X5.6 | SPI 18.75 МГц |
| Дисплей SCK | P1.43 (PB13) | X5.7 | SPI 18.75 МГц |

## 6. Проверки до установки WeAct

1. Прозвонить каждую строку §5. Соседние выводы гнёзд и клеммников между собой не звонятся — у клеммников особенно пары в соседних отверстиях (1–2, 4–5, …). X3.3 ↔ PA3 и X3.4 ↔ PA2 — по ~100 Ом.
2. Шины: 3V3 ↔ GND и 5 В ↔ GND — не звонятся.
3. PE7 / PE8 / PE9 / PE15 не звонятся ни с землёй, ни друг с другом (кнопки отпущены, габариты выключены).
4. GPS (X3.1) — на 3V3, не на 5 В.
5. **Ключи:** примерить каждую из пяти вилок в каждое гнездо. Вилка X1 входит только в X1 и (со сдвигом) в X2, X2 — только в X2, X4 — только в X4.
6. **WeAct на место, кабель USB-C вставлен:** штекер ни во что не упирается, плата не выгибается.
7. После установки WeAct и прошивки: на DIAG кнопки листают страницы, режим яркости показывает DAY / NIGHT, GPS в строке 2 сначала `?`, потом `V…` или скорость.

## 7. Высота в коробке 140×82×38

Внутри ~33 мм — коробка пришла, измерить. Самое высокое на плате — клеммник с вилкой:

- корпус гнезда над платой: ~4 мм на проволочках (§3, способ 1), ~2.5 мм с укороченными выводами, ~1.5 мм с гнутыми (способ 2, только стол);
- гнездо 9.2 мм;
- вилка над гнездом 9.0 мм: у неё 15.6 мм, из них 6.6 уходит в гнездо.

Итого **~22 мм над платой** (на проволочках). Сверху должно остаться место на изгиб провода, который выходит из вилки вверх (§3):

| Под платой | Гнёзда | До верха вилки | Над вилкой |
|---|---|---|---|
| стойки 8 мм (заказаны) | любые | 8 + 1.6 + 19.7 ≈ 29 мм и выше | ≤ 4 мм — провод упрётся в крышку, **не годится** |
| **одна гайка M3, 2.4 мм** | на проволочках | 2.4 + 1.6 + 22.4 ≈ 26.5 мм | ~6.5 мм — впритык: мягкий силиконовый 22 AWG загнуть можно |
| одна гайка M3 | на проволочках, выводы укорочены до 2 мм | 2.4 + 1.6 + 20.7 ≈ 25 мм | ~8 мм |
| одна гайка M3 | гнутые (стол) | 2.4 + 1.6 + 19.7 ≈ 24 мм | ~9 мм |

Если по замеру над вилкой меньше 6 мм — укоротить выводы гнёзд (§3).

- **Крепёж.** Винт M3×8 изнутри: головка на плате → плата → гайка-проставка → дно коробки → гайка снаружи. Это 1.6 + 2.4 + дно ~2 мм, на внешнюю гайку остаётся ~2 мм резьбы. Если дно толще 2 мм, нужен M3×10. Стойки 8 мм остаются в запас.
- **Снизу до дна 2.4 мм.** Все выводы после пайки обкусить до ~1 мм. Хвосты гнёзд под WeAct торчат ~1.4 мм — это нормально.
- **WeAct:** 2.4 + 1.6 + гнёзда 8.5 + WeAct с деталями ~5 ≈ 18 мм — ниже клеммников. Штекер USB-C — на ~11–17 мм над платой (§4).
- **Отверстия под провода в стенке** — высоко, у самой крышки, на ~28–31 мм от дна, напротив клеммников: провод выходит из вилки вверх и сразу уходит вбок.
