Pcfccn/Dash/docs/future/display-upgrade.md

# Экран: качество картинки и скорость

**Статус:** этап 0 сделан; железо не выбрано. Цены найдены 2026-10-09, обновлены для Австралии 2026-10-22 (§0). Цены ориентировочные, перед заказом проверить.

**Претензия.** Не нравится качество основного 4" экрана. Ниже разобраны обе стороны: **скорость** (рывки, медленное обновление) и **картинка** (углы обзора, «молочный» чёрный, яркость, чёткость).

---

## 0. Обновление 2026-10-22: «двоится», два глаза видят разные цвета

**Почему так.** Нынешняя панель — TN. У TN углы несимметричны. У похожей 4" панели на ILI9488 (buydisplay ER-TFT040-5) по даташиту 70° влево и вправо, 70° вверх и только 50° вниз. Это для родной ориентации, вертикальной 320×480, в которой прошивка и рисует. По вертикальной оси цвет и контраст меняются резко, сильнее всего на тёмных и средних тонах (с 2026-10-22 палитра их избегает, см. ниже). Если смотреть на экран, положенный горизонтально, как на столе на фото, глаза оказываются как раз вдоль плохой оси. Тогда разница углов между глазами (~5° с полуметра) уже даёт разный цвет, и кажется, что двоится.

**Бесплатная проверка до покупки.**
1. Поставить модуль вертикально, текстом прямо, на уровне глаз, и смотреть перпендикулярно. Если двоение пропало, дело в положении. В машине экран тогда ставить вертикально и наклонять так, чтобы взгляд попадал в «хорошую» сторону: поворачивать и смотреть, с какой стороны картинка лучше.
2. Если двоится и вертикально — нужен IPS. Программно у TN это не лечится.

### Что ещё можно сделать с нынешним TN (2026-10-22)

Угол обзора у TN не исправить, но то, насколько заметно двоение, зависит от того, что и как рисовать.

1. **Палитра под TN — сделано.** Двоение видно на полутонах. У канала между «выключен» и «включён» уровень меняется с углом, поэтому смешанный цвет (мягкий зелёный, янтарный, серо-синий) каждый глаз видит своим оттенком. Канал на 0 или 255 почти не меняется. Теперь все цвета собраны из каналов «полностью вкл / выкл»: белый, жёлтый, голубой, зелёный, красный на чёрном — так устроены индикаторы в кабинах самолётов. Линии и подложки шкал — один синий канал: с углом он темнеет или светлеет, но оттенок не меняет. Нормальные показания белые: это самый яркий и устойчивый цвет. Цвет у числа теперь всегда что-то значит: голубой — двигатель холодный или параметр сейчас не оценивается, жёлтый — внимание, красный — авария. Зелёный остался для маленьких «всё хорошо»: точки, полосы, READY. Надписи NOMINAL больше нет (2026-10-23): когда всё в порядке, верхняя полоса пустая. Прежняя палитра (зелёные числа, как в макете) — вариант `-D UI_PALETTE_TN=0` («LOOK PAL0»), для сравнения.
2. **Перевернуть модуль, если на него смотрят снизу** (у нашего модуля на столе это ничего не дало, 2026-10-23). У похожих панелей плохая сторона — снизу (50° против 70°). Если экран стоит выше глаз, перевернуть модуль на 180° и прошить вариант `-D LCD_FLIP=1` («LOOK FLIP»): картинка повернётся, плохая сторона уйдёт от водителя. Проверка на столе: посмотреть сверху и снизу под одинаковым углом; где хуже, та сторона и плохая.
3. **Наклон.** Экран — перпендикулярно взгляду водителя. Разница углов между глазами та же, но у перпендикуляра цвет меняется на градус меньше всего.
4. **Узнать контроллер — вариант `-D LCD_PROBE=1`** («PROBE»). Часть 4" SPI-модулей с надписью ILI9488 на деле на ST7796S (так, например, у 4" модулей LCDWIKI). Наш init написан для ILI9488; на ST7796 команды гаммы и напряжений (E0/E1, C0/C1/C5) значат другое или без разблокировки игнорируются, и картинка может быть хуже, чем умеет панель. Образ при включении 4 с показывает три полосы, переданные 16-битными пикселями:
   - три чистые полосы на весь экран — красная, зелёная, синяя сверху вниз: это **не** ILI9488 (скорее ST7796). Тогда стоит написать init ST7796 и выводить RGB565 — заодно кадр на треть быстрее;
   - серый экран (сверху серое, ниже тёмная полоса, низ не тронут): настоящий ILI9488. Он принимает байты как 18-битные пиксели, выходят чередующиеся пурпурные и зелёные точки, а на таком шаге они сливаются в серый.

   Провод SDO для этого не нужен.

   **Результат для нынешнего 4" модуля (2026-10-22): серый — настоящий ILI9488.** Наш init — для того чипа, что стоит; выигрыша от смены драйвера нет.
5. **Полужирный мелкий текст — сделано (2026-10-23).** Мелкий текст (12 / 14 / 20 px) был встроенным Montserrat Medium, тонким: у тонкой линии больше полутонов сглаживания, а они и «плывут». Теперь он SemiBold, как крупные цифры. Раскладку проверили отрисовкой на ПК (`python tools/ui_render.py`): ничего не вылезает. Заодно: в верхней полосе метки (MIL, CLT, …) видны только при тревоге по своей системе, показания, которые ничто не оценивает (IAT, LOAD, RAIL, BOOST), белые, а не голубые.
6. **VCOM и гамма для угла почти ничего не дают.** VCOM (`C5`, сейчас `0x1E`) уже поднят против «молока»; трогать, если чёрный стал сероватым или появилось мерцание. Гамма E0/E1 влияет на полутона, а в новой палитре их почти нет.

**Провода.** Для картинки нужны 8: VCC, GND, CS, RESET, DC/RS, SDI(MOSI), SCK, LED. SDO(MISO), тач (T_*) и SD-карта на качество не влияют, их можно не подключать. Если плохо контачит один из восьми, картинка не «чуть хуже», а сломана: нет изображения, мусор или нет подсветки. Длинные провода на 18.75 МГц дают точки и полосы, а не другие цвета; тогда — провода короче или делитель SPI `/16` (`LCD_SPI_PRESCALER` в `lv_port_disp.c`).

**Замена на IPS, с доставкой в Австралию** (цены 2026-10-22, проверить перед заказом):

| Модуль | Контроллер | Что менять в прошивке | Размер | Цена | Где |
|---|---|---|---|---|---|
| **DFRobot DFR0669**, IPS 320×480 SPI, 300 кд/м², −20…+70 °C | **ILI9488 — как сейчас** | почти ничего: тот же драйвер, возможно, инверсия цвета / BGR | 3.5" | **47.90 AUD** с GST | [Core Electronics](https://core-electronics.com.au/3-5-480x320-tft-lcd-capacitive-touchscreen.html.plain.md), склад в Сиднее |
| **Waveshare 3.5" Capacitive Touch Display (F)**, IPS 320×480 SPI | ST7796S | init ST7796, вывод проще и на треть быстрее (RGB565), ~1 вечер | 3.5" | **35.30 AUD** с GST | [Core Electronics](https://core-electronics.com.au/waveshare-3-5-inch-touchscreen-for-pi-f.html.md), в наличии; к МК — кабелем GH1.25 13P из комплекта |
| Waveshare 3.5" Capacitive Touch LCD (WS-29318), IPS | ST7796S | то же | 3.5" | ~37 AUD | [Little Bird](https://littlebirdelectronics.com.au/products/3-5-capacitive-touch-ips-display-320x480-st7796s-ft6336u-ws-29318.md), везут от Waveshare |
| LCDWIKI MSP3525 / Hosyond 3.5 IPS | ST7796U | то же | 3.5" | ~15–25 AUD с доставкой | AliExpress, 2–3 недели; в названии и спецификации должно быть **IPS** |
| Waveshare ESP32-S3-LCD-4, IPS 480×480, CAN и вход 7–36 В на плате | ST7701 (RGB) | перенос прошивки на ESP32-S3, квадратная вёрстка | 4" | US$26 + доставка | waveshare.com |

**4" IPS с SPI так и не нашлось.** Все найденные 4" модули на ST7796/ILI9488 (LCDWIKI MSP4020/4030, Elecrow, Hosyond, eBay) — TN с углом обзора «12 o'clock». IPS на 4" — это RGB-панели 480×480, к нашему WeAct их не подключить (см. §4C и «Рассмотрено»).

**Рекомендация.** Сначала проверка выше. Если нужен IPS: **DFR0669** — единственный найденный IPS-модуль с тем же ILI9488. Прошивку почти не трогать, провода те же, в Австралии со склада. Дешевле — Waveshare (F) за 35 AUD, но под него драйвер ST7796. Цена обоих — размер 3.5" вместо 4" (рабочая область 49×73 мм против 56×84).

### Почему для STM32 так мало вариантов и что вместо этого

Дело не в STM32, а в интерфейсе и в нашей плате. Готовые модули «на SPI» несут свой контроллер с памятью кадра (ILI9488, ST7796). Их делают для Arduino, поэтому на 4" они дешёвые и TN. Хорошие IPS-панели от 4" и выше сделаны для телефонов и промышленности: у них RGB (16–24 линии данных и синхронизация) или MIPI DSI, своей памяти нет, кадр нужно гнать непрерывно. Для этого нужен контроллер дисплея (LTDC — в H743 он **есть**), память под кадр (800×480×2 = 750 КБ) и 20+ пинов. На WeAct MiniSTM32H743 корпус LQFP100, SDRAM нет, а нужные пины заняты экраном статуса (PE10–PE14), FDCAN и флешками. Поэтому у нас остаётся только SPI.

| Путь | Что | Экран | Цена | Чем платим |
|---|---|---|---|---|
| **Другая плата на том же STM32H743** | Китайская «Core»-плата **STM32H743IIT6** (LQFP176) с SDRAM и разъёмом RGB, продаётся с экранами 4.3" / 5" / 7" ([LVGL forum](https://forum.lvgl.io/t/support-for-affordable-stm32h743-core-board-rgb-lcd-touch/23360)); то же у Waveshare: CoreH743I / OpenH743I-C + их RGB-экраны | RGB, 800×480 и выше; **IPS — проверять по конкретному лоту** | ~US$60 с экраном (по форуму) | Перенос на другую плату того же семейства: FDCAN, FreeRTOS, LVGL, логика остаются; новый драйвер LTDC (проще SPI и быстрее), раскладка пинов, экрана статуса ST7735 нет, трансивер CAN — свой модуль |
| ST Discovery | **STM32H735G-DK**: 4.3" 480×272 RGB, тач, **3 × CAN FD на плате**; **STM32H747I-DISCO**: 4" 800×480 MIPI DSI | тип панели в доступных описаниях не указан | ~€70–90 | Тот же перенос; дороже; 480×272 — грубее нынешнего |
| Экран со своим «мозгом» по UART | **DWIN DGUS** 4.3" 800×480 **IPS** (85/85/85/85°, 270–900 кд/м², с тачем и без) | IPS | ~₹1 400–2 800 (≈ AUD 25–50) в Индии; в Австралии искать | Интерфейс рисуется в программе DWIN, плата шлёт только числа. Наш LVGL-интерфейс выбрасывается |
| EVE по SPI (BT817, Riverdi) | WeAct остаётся | IPS, до 1000 кд/м² | от ~US$60, обычно по запросу | Дорого; LVGL с EVE работает ограниченно |
| ESP32-S3 со встроенным экраном | §4C / §4D | IPS 480×480 / 800×480 | US$26–44 | Перенос на ESP32 (другой HAL) |
| IPS 3.5" по SPI | §0 | IPS | 35–48 AUD | Только размер |

**Если хочется 4"+ IPS и остаться на STM32** — плата на STM32H743IIT6 с RGB-экраном: тот же чип, код в основном переносится. Перед заказом в лоте проверить: «IPS» в характеристиках панели; разводку платы, чтобы были свободны пины FDCAN (PD0/PD1 или PB8/PB9) и UART под GPS; есть ли там SPI-флешка под журнал (иначе — внутренняя флеш H743).

### Все варианты одной таблицей (2026-10-22)

Цены — с найденных страниц, перед заказом проверить; «AUD» — с доставкой по Австралии или со склада в Австралии. «Прошивка» — сколько менять в нашем коде.

| # | Вариант | Экран | Плюсы | Минусы | Прошивка | Цена | Где заказать |
|---|---|---|---|---|---|---|---|
| 0 | **Оставить нынешний TN 4"**, поставить правильно | 4" TN 320×480 | бесплатно | TN: узкая ось никуда не денется; сначала проверить, что вертикально не двоится | ничего | 0 | — |
| 1 | **DFRobot DFR0669** | 3.5" IPS 320×480, ILI9488, 300 кд/м², −20…+70 °C | тот же контроллер, что сейчас, те же провода; склад в Сиднее | меньше: 3.5"; тач и SD лишние | почти ничего (возможно, инверсия цвета / BGR) | 47.90 AUD | [Core Electronics](https://core-electronics.com.au/3-5-480x320-tft-lcd-capacitive-touchscreen.html) |
| 2 | **Waveshare 3.5" Capacitive Touch Display (F)** | 3.5" IPS 320×480, ST7796S | дешевле всех местных; в наличии; RGB565 по SPI — вывод на треть быстрее | 3.5"; подключение кабелем GH1.25 13P (в комплекте) — сверить распиновку | драйвер ST7796, ~1 вечер | 35.30 AUD | [Core Electronics](https://core-electronics.com.au/waveshare-3-5-inch-touchscreen-for-pi-f.html) |
| 3 | Waveshare 3.5" Capacitive Touch LCD (WS-29318) | 3.5" IPS 320×480, ST7796S | гребёнка, документация Waveshare | везут от Waveshare, не со склада | драйвер ST7796 | ~37 AUD | [Little Bird](https://littlebirdelectronics.com.au/products/3-5-capacitive-touch-ips-display-320x480-st7796s-ft6336u-ws-29318) |
| 4 | Elecrow DLS30035B | 3.5" IPS 320×480, ST7796 | гребёнка, понятный магазин | доставка дороже экрана | драйвер ST7796 | US$31.19 с доставкой (16.90 + 14.29) | [Elecrow](https://www.elecrow.com/3-5-ips-spi-lcd-capacitive-touch-module-st7796-driver-320-480-resolution.html) |
| 5 | LCDWIKI MSP3525 / Hosyond 3.5 IPS | 3.5" IPS 320×480, ST7796U | самый дешёвый | 2–3 недели; под тем же названием бывают TN / ILI9488 — в лоте должно быть **IPS** | драйвер ST7796 | ~15–25 AUD | AliExpress: искать «MSP3525 IPS ST7796U» |
| 6 | Display Visions EA TFT035-34AI | 3.5" IPS 320×480, HX8357D, **850–1000 кд/м²** | читается на солнце, −20…+70 °C | голая панель со шлейфом: своя переходная плата и драйвер подсветки; дорого | init HX8357D | ~US$80 | DigiKey / Mouser (на [LCSC](https://www.lcsc.com/product-detail/LCD-Screen_Display-Visions-EA-TFT035-34AITC_C17476479.html) нет в наличии) |
| 7 | **Плата STM32H743IIT6 «Core» + RGB-экран** | 4.3" / 5" / 7" RGB, 800×480+; IPS — по лоту | **4"+ и тот же чип**: CAN, FreeRTOS, LVGL, логика переносятся; SDRAM 32 МБ, LTDC — быстрее SPI | безымянный продавец; проверять IPS и распиновку; нет маленького экрана статуса; трансивер CAN — свой модуль | перенос на другую плату, драйвер LTDC, ~1–2 выходных | ~US$35 плата, ~US$60 с экраном | AliExpress: [поиск STM32H743IIT6](https://www.aliexpress.com/w/wholesale-stm32h743iit6.html); [LVGL forum](https://forum.lvgl.io/t/support-for-affordable-stm32h743-core-board-rgb-lcd-touch/23360) |
| 8 | Waveshare OpenH743I-C + RGB-экран Waveshare | 4.3" IPS 800×480 RGB (16249) | тот же чип, документация Waveshare | дорого; совместимость экрана с этой платой проверить | как №7 | US$74 плата + ~€30 экран | [Waveshare (платы)](https://www.waveshare.com/product/mcu-tools/development-boards.htm), [экран 16249](https://welectron.com/Waveshare-16249-43inch-Capacitive-Touch-LCD) |
| 9 | ST **STM32H735G-DK** | 4.3" 480×272 RGB, тач; тип панели не указан | официальная плата ST; **CAN FD** на плате; H7 — код переносится | 480×272 грубее нынешнего; дорого | как №7 | 166.86 AUD | [RS Australia](https://au.rs-online.com/web/p/microcontroller-development-tools/2102028) |
| 10 | ST STM32H747I-DISCO | 4" 800×480 MIPI DSI, тач | 4" высокой чёткости, официальная плата | тип панели не указан; DSI сложнее; дорого | как №7 + DSI | ~€85–91 | [ST (дистрибьюторы)](https://www.st.com/en/evaluation-tools/stm32h747i-disco.html) |
| 11 | **DWIN DGUS** DMG80480T043 | 4.3" **IPS 800×480**, 85/85/85/85°, 270–900 кд/м² | IPS 4.3" дёшево; WeAct остаётся (4 провода UART) | интерфейс рисуется заново в программе DWIN, наш LVGL — в мусор; продавцы найдены только в Индии | связь по UART вместо LVGL | ~₹1 400–4 500 (≈ AUD 25–80) | [Evelta](https://evelta.com/4-3inch-800x480-display-capacitive/), [Hubtronics](https://hubtronics.in/dmg80480t043_09wn) |
| 12 | Riverdi EVE4 4.3" (BT817) | 4.3" IPS 480×272, 850–1000 кд/м² | ярко; WeAct остаётся (SPI) | дорого; LVGL с EVE ограниченно | драйвер EVE | ~US$109 | DigiKey (через [findchips](https://www.findchips.com/search/RVT43)) |
| 13 | **Waveshare ESP32-S3-LCD-4** / Touch-LCD-4 | 4" **IPS 480×480** | **CAN-трансивер и вход 7–36 В на плате**; одна плата вместо всего | перенос на ESP32 (другой процессор), квадратная вёрстка | перенос + вёрстка | US$25.99 / 32.99 | [Waveshare](https://www.waveshare.com/esp32-s3-touch-lcd-4.htm) |
| 14 | Waveshare ESP32-S3-Touch-LCD-4.3B | 4.3" IPS 800×480, 550 кд/м² | ярче остальных доступных; CAN, 7–36 В | ландшафт; подсветка только вкл/выкл | перенос + вёрстка | ~US$37 | [Waveshare](https://www.waveshare.com/esp32-s3-touch-lcd-4.3b.htm) |
| 15 | Guition ESP32-4848S040 | 4" IPS 480×480 | дешевле всех на 4" | **CAN нет** — нужен модуль; китайский ноунейм | перенос + вёрстка | ~US$20–28 | AliExpress; [описание](https://devices.esphome.io/devices/guition-esp32-s3-4848s040) |

#### Проверено в браузере на AliExpress (2026-10-22, цены для Австралии с доставкой)

| Лот | Что | Цена | Отзывы, IPS | Ссылка |
|---|---|---|---|---|
| **JR E-Shop, «IPS HD 3.5 inch SPI ILI9488»** — вариант **IPS No Touch ILI9488** | 3.5" IPS 320×480, **ILI9488, SPI, та же 14-пиновая гребёнка, что у нынешнего красного модуля** | **AU$19.44**, доставка бесплатно, ~1 неделя | 4.9★, 154 отзыва, 1000+ продано. Покупатели: «IPS-версия, нужна инверсия цвета»; «разогнал до 80 МГц». В лоте есть и TN-варианты (без «IPS» в названии), брать **с IPS** | [лот](https://www.aliexpress.com/item/1005001999296476.html) |
| XunMing, «IPS 3.5 Inch Red Module With Touch ILI9488 14Pin» | то же, с резистивным тачем | AU$20.39, бесплатно, ~1 неделя | 4.7★, 42 отзыва: «действительно IPS, очень широкие углы»; один — «углы коротковаты»; пример: 65 МГц SPI на STM32, кадр 59 мс | [лот](https://www.aliexpress.com/item/1005006333922639.html) |
| «3.5 Inch IPS Red Module No Touch ILI9488» | без тача | AU$14.59 | всего 2 продажи | [лот](https://www.aliexpress.com/item/1005009310165991.html) |
| EC-Buying: **FANKE FK743M2-IIT6** + «4.3 inch TFT LCD» | STM32H743IIT6, SDRAM, RGB, тач на 5 касаний | плата AU$32.79 + экран AU$44.39 + доставка AU$2.63 ≈ **AU$80** | тип панели **не указан**. Разъём экрана FANKE (по [схеме](https://github.com/nr-electronics/STM32H743_FANKE)) заявлен совместимым с 7" **AT070TN83 — это TN** → IPS **спросить у продавца до покупки** | [лот](https://www.aliexpress.com/item/1005004790156132.html) |
| iSolution: STM32H743XIH6 core + RGB-экраны | плата + 4.3" 800×480 / 5" / 7" | плата AU$55.99 + 4.3" AU$41.39 (5" AU$52.69, 7" AU$62.69) + AU$12.02 | тип панели не указан, документация — «вики по запросу» | [лот](https://www.aliexpress.com/item/1005010022213160.html) |

**Плата FANKE FK743M2-IIT6 под наш проект** (по схеме V1.0):
- **CAN:** PD0/PD1 заняты SDRAM. FDCAN1 переносится на **PB8/PB9** (свободны), запасной вариант — FDCAN2 на PB12/PB13.
- **GPS:** PA2 занят экраном (LCD_R1). Взять USART3 (PB10/PB11), UART4 (PA0/PA1) или USART6 (PC6/PC7).
- **Кнопки:** свободных пинов хватает (PC0–PC7, PC13, PB0/1, PB3–5, PB12–15).
- **Подсветка:** PH6 (LCD_BL), ШИМ TIM12; разъём экрана питается от 5 В.
- **Флешка для журнала:** W25Q на **QSPI**, а не на SPI — `spi_nor.c` надо переписать под QSPI.
- **ST7735:** экрана статуса нет.

**Отзыв покупателя «пришлось использовать ST7789.h».** Под одним названием продают разные контроллеры. ST7789 умеет не больше 240×320, на 480×320 его не бывает, так что отзыв, скорее всего, про меньший экран. Но и IPS 3.5" с надписью «ILI9488» может прийти на ST7796. При получении прошить вариант PROBE (§0, «Что ещё можно сделать», п. 4): он без провода SDO покажет, ILI9488 это или нет. Для ST7796 нужен свой init, ~вечер работы.

**Итог проверки:** самая выгодная замена — **IPS-вариант JR E-Shop за AU$19.44**: тот же ILI9488, те же 14 пинов и провода, в прошивке нужна только инверсия цвета (команда `0x21`), приезжает за неделю. Для 4"+ на STM32 плата FANKE подходит по пинам, но IPS её экрана не подтверждён — сначала спросить продавца.

**Коротко:**
- быстро и почти без работы — **IPS-вариант JR E-Shop** (AU$19.44) или **№1** (DFR0669);
- дешевле, но с драйвером — **№2**;
- 4"+ IPS и остаться на STM32 — **№7** (по лоту с IPS);
- лучшее «всё в одном» на 4" — **№13**, но это переход на ESP32.

## 1. Что сейчас и где теряется

> **Архив: таблица ниже — состояние до этапа 0 (2026-10-09).** Сейчас в прошивке: SPI2 /8 = **18,75 МГц**, flush через **DMA**, I-cache и D-cache **включены**, виджеты обновляются только при изменении. Полный кадр 320×480×3 байта по проводу ≈ **197 мс**, то есть не больше ~5 полных кадров в секунду: DMA освобождает CPU, но провод не ускоряет. Важна доля перерисовываемой площади, а не FPS всего экрана (ревью C7, PERF-01). Выводы про TN-панель, яркость и разрешение остаются в силе.

| | Сейчас | Чем плохо |
|---|---|---|
| Панель | Красный модуль «4.0'' TFT SPI 480X320 V1.0», ILI9488 ([wiring.md](../wiring.md)) | Скорее всего **TN**: на всех 4" модулях этого класса, у которых есть даташит, стоит TN (например, у LCDWIKI MSP4030 в даташите указаны «Panel Type TN» и «View Angle 12 O'CLOCK»). Отсюда цвет плывёт под углом и молочный чёрный, который уже пробовали лечить через VCOM в [lv_port_disp.c](../../Core/Src/lv_port_disp.c) |
| Яркость | Не измерялась. У аналогичных 4" модулей 300 кд/м² | На солнце мало. Для салона нужно 500+, для прямого солнца 800–1000 |
| Формат пикселей | ILI9488 по SPI принимает только 18 бит (3 байта на пиксель) | Передаётся на 50 % больше байт, чем при RGB565, плюс построчная конвертация на CPU |
| Частота SPI2 | **9,375 МГц** (делитель 16 от 150 МГц, [spi.c](../../Core/Src/spi.c)) | Полный кадр 320×480×24 бит = 3,69 Мбит, то есть **≈390 мс** |
| Передача | `HAL_SPI_Transmit` построчно, блокирующая, без DMA | Пока идёт передача, CPU ничего не делает. Суперцикл стоит сотни миллисекунд ([REVIEW.md R2](../REVIEW.md)) |
| Перерисовка | `cluster_ui_refresh()` каждые 40 мс заново ставит текст и стиль всем видимым виджетам. Рамка тревоги инвалидирует весь экран | Гоняются по SPI области, которые не менялись |
| Кэши | I-cache и D-cache выключены, SYSCLK 225 МГц | Рендер LVGL медленнее, чем мог бы быть |
| Разрешение | 320×480 на 4" ≈ 146 ppi | Шрифты и дуги заметно «ступенчатые» |

**Вывод.** Почти вся медлительность программная. Её можно убрать без покупок (раздел 3). Картинку (TN, яркость, разрешение) программно не исправить, для неё нужна другая панель (раздел 4).

## 2. Время передачи кадра

| Конфигурация | Полный кадр | Область цифр скорости ~200×90 px |
|---|---|---|
| **Было до этапа 0:** ILI9488, 18 бит, 9,375 МГц | **393 мс** | 46 мс |
| **Сейчас:** ILI9488, 18 бит, 18,75 МГц, DMA | **197 мс** | 23 мс |
| ILI9488, 18 бит, 37,5 МГц (делитель 4) | 98 мс | 11,5 мс |
| ST7796, 16 бит, 37,5 МГц | 66 мс | 7,7 мс |
| ST7796, 16 бит, 50 МГц (нужно поднять тактирование SPI123 до 200 МГц) | 49 мс | 5,8 мс |
| ESP32-S3 + RGB-панель | Нет шины-узкого места: панель сканируется DMA из PSRAM, LVGL пишет только изменённые области | — |

Расчёт: пиксели × бит на пиксель / частоту SPI, без учёта команд окна. С DMA и двумя буферами LVGL рендер следующей области идёт параллельно с передачей предыдущей.

Предел по частоте: у ILI9488 на практике потолок около 40 МГц (на ESP32 40 МГц работают, на 80 МГц экран чёрный). На проводах Dupont длиной 15–20 см выше 20–30 МГц может не заработать, для 40 МГц нужны короткие провода или шлейф.

## 3. Этап 0: без покупок (сделать в любом случае)

> **Сделано 2026-10-09 (`b7f9470`), прошито, на панели не проверено.** Пункты 0.1, 0.3, 0.4 как описано ниже. По 0.2 выбран делитель **8 (18,75 МГц)**, а не 4: панель висит на проводах ~15 см. Пункт 0.5 сделан не осциллографом, а замером на экране: в первой строке DIAG `LOOP` — самая долгая итерация суперцикла за секунду, мс. Детали для ревью в [REVIEW.md](../REVIEW.md), раздел «Этап 0 дисплея».

Даёт основной прирост скорости и разгружает суперцикл, а это заодно чинит OBD-таймауты из [REVIEW.md R2](../REVIEW.md). Все пункты нужны при любом выборе железа, кроме варианта на ESP32.

| # | Что | Где | Эффект |
|---|---|---|---|
| 0.1 | Обновлять текст и стиль виджета только если значение изменилось (кэш на виджет). Рамку тревоги не трогать, если цвет не поменялся | `cluster_ui.c` | Через SPI уходят только реально меняющиеся цифры, а не весь экран |
| 0.2 | SPI2: делитель 16 → 4 (37,5 МГц), пробовать ступенями 8 → 4. GPIO SPI2 и CS/DC: `GPIO_SPEED_FREQ_VERY_HIGH` | `spi.c` (секции USER CODE или `.ioc`) | Полный кадр 393 → ~98 мс |
| 0.3 | Flush через DMA: SPI2 TX на DMA1, конвертация RGB565 → RGB666 в буфер на всю область, `lv_display_flush_ready()` из колбэка завершения DMA. Буферы в некэшируемой области (MPU) или с явной очисткой D-cache | `lv_port_disp.c` | CPU свободен на время передачи, рендер идёт параллельно |
| 0.4 | Включить I-cache и D-cache (`SCB_EnableICache/DCache`) с MPU-регионом для DMA-буферов | `main.c` (USER CODE) | Рендер LVGL быстрее в разы |
| 0.5 | Замерить: дёргать GPIO на входе и выходе flush и смотреть осциллографом или логическим анализатором | — | Цифры вместо расчёта |

**Ограничение этапа 0:** TN-панель, яркость 300 кд/м² и 146 ppi остаются. Если после этапа 0 раздражает именно картинка, переходить к разделу 4.

## 4. Варианты железа

### A. IPS 3.5" ST7796U по SPI — дешёвая замена «один в один»

- **Что:** LCDWIKI **MSP3525** (без тача) / MSP3526 (с тачем), или аналог Hosyond «3.5 inch 320x480 IPS ST7796U». По [спецификации LCDWIKI](https://www.lcdwiki.com/3.5inch_IPS_SPI_Module_ST7796): IPS, 320×480, ST7796U, 4-проводной SPI, 300 кд/м², «ALL O'CLOCK» (полные углы обзора), активная область 48,96×73,44 мм, модуль 55,5×98 мм, питание 5 В.
- **Плюсы:** тот же формат 320×480 портрет, **UI не меняется**. Те же 5 проводов на SPI2 и тот же PA8 на подсветку. ST7796 принимает **RGB565 по SPI** (16 бит), поэтому конвертация в `lv_port_disp.c` не нужна и данных на треть меньше. IPS: нормальные углы, глубже чёрный.
- **Минусы:** экран **меньше**: 3,5" против 4" (активная область 49×73 мм против 56×84 мм). Яркость та же, около 300 кд/м². Чёткость почти та же (165 ppi).
- **4" IPS на ST7796 не нашёл:** все найденные 4" модули на ST7796 (LCDWIKI MSP4030/4031, Elecrow, Hosyond 4.0) по спецификации **TN**. Если продавец пишет «4.0 IPS», просить даташит с полем Panel Type.
- **Цена:** ~$10–15 (LCDWIKI на AliExpress). Готовые аналоги с понятным магазином: **Elecrow DLS30035B**, 3.5" IPS SPI ST7796, 320×480, [$16.90](https://www.elecrow.com/3-5-ips-spi-lcd-capacitive-touch-module-st7796-driver-320-480-resolution.html); **Waveshare 3.5" Capacitive Touch LCD** (IPS, ST7796S, SPI), у дистрибьюторов около $38. Тач не нужен, но на этих моделях он есть.
- **Прошивка:** новая init-последовательность ST7796 и `COLMOD = 0x55` (16 бит), flush без конвертации (сразу DMA из буфера LVGL, с перестановкой байт RGB565 через `lv_draw_sw_rgb565_swap()` или 16-битным режимом SPI). Вместе с этапом 0 это 1–2 вечера.

### B. Яркий IPS 3.5" EA TFT035-34AI — читаемый на солнце, тот же формат

- **Что:** Display Visions (Electronic Assembly) **EA TFT035-34AI**: IPS, 320×480, **850–1000 кд/м²** (меньшая цифра с тачем), контроллер HX8357D, интерфейсы SPI, 8/16-битный параллельный, RGB на одном шлейфе, 3,3 В, рабочая температура −20…+70 °C, 54,7×83,0×2,2 мм.
- **Плюсы:** формат тот же, UI не меняется, читается на солнце. HX8357D по SPI принимает 16-битный цвет.
- **Минусы:** это голая панель со шлейфом FPC, а не модуль с гребёнкой. Нужна своя переходная плата (разъём FPC, повышающий драйвер подсветки на 6 светодиодов, ключ). Дорого.
- **Цена:** DigiKey, версия с тачем EA TFT035-34AITC: **$80,90** за 1 шт (по агрегатору, проверить). Без тача немного дешевле.
- **Прошивка:** как в варианте A, init под HX8357D.

### C. ESP32-S3 со встроенным 4" 480×480 IPS и CAN — основной кандидат на апгрейд

- **Что:** **Waveshare ESP32-S3-Touch-LCD-4** (или версия без тача ESP32-S3-LCD-4). По [wiki Waveshare](https://www.waveshare.com/wiki/ESP32-S3-Touch-LCD-4):
  - 4" **480×480**, контроллер ST7701 по RGB-шине, 65K цветов, IPS, угол обзора 160°;
  - ESP32-S3, 240 МГц, 2 ядра, 16 МБ flash, 8 МБ PSRAM;
  - **CAN-трансивер TJA1051T/3 на плате**, RS485 (SP3485);
  - **питание 7–36 В** (XL1509), USB-C;
  - яркость в документации не указана.
- **Плюсы:**
  - одна плата вместо WeAct + модуль CAN + экран + плата подсветки;
  - нет шины-узкого места: RGB-панель сканируется DMA из PSRAM, LVGL рисует только изменения;
  - 480×480 на 4" ≈ 170 ppi, IPS;
  - CAN в ESP32-S3 встроен (TWAI), транслятор уже распаян;
  - LVGL 9 штатно поддерживается в ESP-IDF, `cluster_ui.c` переносится почти как есть.
- **Минусы:**
  - **квадрат вместо портрета 2:3**: раскладку страниц нужно перекомпоновать (и макет в `design/`);
  - **порт прошивки**: `fdcan_obd.c` на TWAI, суперцикл на задачи FreeRTOS ESP-IDF, `app_main.c`. Логика OBD и ISO-TP уже отделена и покрыта host-тестами (`tests/host/`), это помогает;
  - яркость не указана, вероятно 250–400 кд/м²;
  - рабочая температура Waveshare-плат обычно 0…65 °C (у 4.3B так и написано), для торпеды на солнце мало.
- **Цена:** **$25,99** без тача / **$32,99** с тачем (магазин Waveshare, проверить). Тач для приборки не нужен.
- **Две схемы:**
  - **C1 (рекомендую):** всё на ESP32-S3. CAN через TWAI, STM32 и WeAct больше не нужны.
  - **C2:** STM32 остаётся источником данных и шлёт `g_obd` по UART, ESP32 только рисует. Меньше переписывать OBD, но две прошивки, протокол между ними и лишний узел. Свободных UART на плате Waveshare мало (RS485 занимает GPIO43/44), это нужно проверить по схеме.

### D. Waveshare ESP32-S3-Touch-LCD-4.3B — больше и ярче

- **Что:** [wiki Waveshare](https://www.waveshare.com/wiki/ESP32-S3-Touch-LCD-4.3B): 4.3" **800×480 IPS, 550 кд/м²**, RGB, 65K цветов, CAN (TJA1051) + RS485 + изолированные входы и выходы на клеммнике, **питание 7–36 В**, 112,4×75,1 мм (в корпусе 116,3×79 мм), 0…65 °C. Подсветка только вкл/выкл через расширитель CH422G, **без ШИМ-диммирования**.
- **Плюсы:** ярче, чем всё остальное доступное (550 против ~300). 217 ppi, самый чёткий вариант. CAN и питание от бортсети на плате. Есть версия в корпусе.
- **Минусы:**
  - **ландшафт**: для портретного UI нужен поворот на 90°, а программный поворот на RGB-панели ESP32-S3 стоит производительности. Либо переделать UI под ландшафт;
  - физически больше 4";
  - нет плавной регулировки яркости, ночью 550 кд/м² могут слепить (нужно проверить, можно ли подключить ШИМ к драйверу подсветки);
  - порт прошивки как в C.
- **Цена:** ~$37 у Waveshare (без доставки), ~$43–44 на Amazon и AliExpress (по обзору CNX 2024, проверить).

### Рассмотрено и не рекомендуется

| Вариант | Почему нет |
|---|---|
| Оставить STM32 и подключить панель по параллельной шине FMC 8080 | Скорость да, качество нет (те же TN-панели). На LQFP100 FMC D2/D3 сидят на PD0/PD1 (FDCAN1, переносить на PB8/PB9), а D4–D12 на PE7–PE15, где встроенный ST7735 (PE10–PE14). Слишком много переделок |
| STM32 + LTDC + RGB-панель | Тот же конфликт пинов. Кадр 320×480×2 = 300 КБ влезает в AXI SRAM (512 КБ) впритык вместе с LVGL. Внешней SDRAM на WeAct нет |
| EVE BT817 (Riverdi 4.3" 1000 кд/м², Crystalfontz CFA800480E0-043SC 850 кд/м²) | Яркие и с графическим ускорителем, но цена только по запросу. LVGL поддерживает EVE ограниченно (рендерер EVE: только 4-битные шрифты, без слоёв, или пиксели по SPI, а это снова медленно) |

## 5. Рекомендация

1. **Сейчас:** этап 0. Бесплатно, делается за вечер-два, убирает рывки и разгружает OBD-цикл.
2. **Если после этапа 0 мешает картинка** (углы, молочный чёрный, яркость):
   - быстрая и дешёвая проба: **вариант A** (IPS 3.5" ST7796U, ~$12). Подключается к тем же проводам, UI тот же. Главный компромисс — размер 3,5";
   - нормальный апгрейд: **вариант C1** (Waveshare ESP32-S3-Touch-LCD-4, ~$26–33). IPS, 480×480, CAN и питание от бортсети на плате, без SPI-узкого места. Цена — порт прошивки и перекомпоновка UI под квадрат;
   - если важна яркость днём: **вариант D** (4.3B, 550 кд/м²) или **B** (EA TFT035, 1000 кд/м²).

## 6. Что купить

| Путь | Позиция | Кол-во | Цена | Где |
|---|---|---|---|---|
| Этап 0 | — | — | 0 | — |
| Этап 0 (по желанию) | Логический анализатор 24 МГц 8 каналов (клон Saleae) для замера flush | 1 | ~$8 | AliExpress |
| A | IPS 3.5" SPI 320×480 ST7796U без тача (LCDWIKI MSP3525 или Hosyond 3.5 IPS). **В названии обязательно «IPS»**, в спецификации Panel Type = IPS | 1 | ~$10–15 | AliExpress (магазин LCDWIKI/QDtech), Amazon (Hosyond) |
| A | Короткий шлейф или провода ≤ 10 см для SPI на 37,5 МГц | 1 | ~$2 | — |
| B | EA TFT035-34AI (без тача) или -34AITC (с тачем) | 1 | ~$70–81 | DigiKey, Mouser |
| B | Переходная плата: FPC-разъём, драйвер подсветки (boost CC), своя разводка | 1 | ~$10–20 + JLCPCB | своя |
| C1 | **Waveshare ESP32-S3-LCD-4** (без тача) или ESP32-S3-Touch-LCD-4 | 1 | $25,99 / $32,99 | waveshare.com, AliExpress (официальный магазин Waveshare) |
| C1 | Защита питания от бортсети: TVS SMBJ24A, Шоттки SS54, самовосстанавливающийся предохранитель 1,1 А. Вход 7–36 В на плате не защищён от выбросов 12-вольтовой сети. Номера LCSC в разделе 6a | 1 компл. | < $1 | LCSC |
| C1 | Разъём OBD-II (CAN-H/CAN-L, +12 В через замок зажигания, GND) — тот же, что сейчас | — | есть | — |
| D | Waveshare ESP32-S3-Touch-LCD-4.3B (есть версия в корпусе) | 1 | ~$37–44 | waveshare.com, AliExpress |
| C1 / D (по желанию) | Антибликовая матовая плёнка под размер экрана | 1 | ~$3 | AliExpress |

## 6a. Что из этого есть на LCSC (проверено 2026-10-09)

Весь раздел «LCD, OLED, Graphic» на lcsc.com (2567 позиций) выгружен через API сайта и отфильтрован по размеру 2.8–7", разрешению и контроллеру. Плюс поиск по ключевым словам: ST7796, ST7701S, 480x480, ESP32-S3 LCD, Waveshare, LCSC-boards.

**Экрана под эту задачу на LCSC нет.** Подходящие по характеристикам позиции все без наличия, а те, что в наличии, не лучше текущего экрана.

| LCSC | Что | Наличие | Цена за 1 шт | Почему не подходит |
|---|---|---|---|---|
| C19632787 | HS HS35B01A, 3.5" 480×320 ILI9488 | 12 шт | $9.42 | По даташиту TN («12 o'clock»), 300 кд/м², **16-битная параллельная шина**. Не лучше текущего |
| C17653087 | Focus E35RG13248LW6M250-N, 3.5" 320×480 ILI9488, SPI/MCU/RGB | нет | $55.07 | Normally White, угол «6 o'clock», 250 нит. Та же технология, что сейчас |
| C17675494 / C17476479 | EA TFT035-34AINN / -34AITC (вариант B) | нет | $77.44 / $170.19 | Нет в наличии |
| C17523578 | 4D Systems 4DLCD-35480320-CTP-CLB-IPS | нет | $98.93 | Нет в наличии, контроллер не указан |
| C17548258, C17436145 | Focus E40RD-FS1000-N / E40RC-FS1000-N, 4" 480×480 ST7701 | нет | $95–111 | Нет в наличии. Голая RGB-панель, для WeAct не годится (нужен LTDC) |
| C17463544 / C17589541 | AZ Displays ATM0400D1 / D1K, 4" 480×480 | нет | $73–90 | То же |
| C7380512 | LCKFB-LSP-RGB-4.3inch-screen (собственный бренд LCSC) | 544 шт | $14.79 | RGB-интерфейс для их платы на GD32F470 (нужен LTDC), паспорт без характеристик |
| C3294587 | Waveshare 4.3inch-DSI-LCD 800×480 | 5 шт | $33.57 | MIPI DSI для Raspberry Pi, к МК не подключить |
| — | ST7796 / ST7796S / ST7796U | 0 позиций | — | На LCSC нет ни одной |
| — | Waveshare ESP32-S3-LCD-4 / -Touch-LCD-4 / -4.3B | 0 позиций | — | Waveshare на LCSC продаёт только мелкие SPI-экраны, e-paper и HDMI/DSI-дисплеи для Raspberry Pi |

**Значит:** сам экран (или плату с экраном) придётся заказывать не на LCSC:
- вариант A: AliExpress, официальный магазин LCDWIKI/QDtech (MSP3525) или Hosyond;
- варианты C и D: магазин Waveshare (waveshare.com, отправка DHL/FedEx) или официальный магазин Waveshare на AliExpress;
- вариант B: DigiKey или Mouser.

**С LCSC берётся обвязка** для вариантов C и D (защита входа 7–36 В от бортсети), всё в наличии:

| LCSC | Что | Зачем | Цена |
|---|---|---|---|
| C123819 | MDD SMBJ24A, TVS 600 Вт, SMB, ограничение 38,9 В | Срезает выбросы бортсети ниже 40 В (предел XL1509 на плате Waveshare) | $0.061 |
| C22452 | MDD SS54, Шоттки 40 В 5 А, SMA | Последовательно по плюсу, защита от переполюсовки | $0.045 |
| C142747 | Littelfuse 1812L110/33MR, самовосстанавливающийся предохранитель 1,1 А / 33 В | Местная защита платы, вдобавок к предохранителю в фьюз-тапе | $0.124 |
| C99101 / C99102 | Amass XT30U-M / XT30U-F | Разъёмный ввод питания, чтобы снимать экран | $0.23 / $0.21 |

Для варианта A с LCSC ничего не нужно: модуль подключается к тем же проводам SPI2.

## 7. Подводные камни

- **Яркость против бликов.** На солнце мешает не только яркость, но и отражение. Матовая антибликовая плёнка и козырёк дают больше, чем +200 кд/м².
- **Температура.** У большинства модулей рабочий диапазон 0…50 / 0…65 °C. Торпеда на солнце может быть горячее, так что место установки важнее модели.
- **Питание 7–36 В на платах Waveshare** — не автомобильный вход. Нужны TVS, предохранитель и фильтр (как сейчас для понижающего преобразователя, [vehicle-install.md](../vehicle-install.md)).
- **ESP32-S3 RGB:** при одном буфере в PSRAM возможны «дрожание» и сдвиг картинки. Использовать ESP-IDF 5.x, bounce buffer, октальный PSRAM на 120 МГц, 2–3 кадровых буфера. Wi-Fi выключить, если не нужен.
- **Правило NaN и тики** из CLAUDE.md переносятся на любую платформу: `--` вместо 0, таймауты без привязки к длительности рендера.
- **GPS из [gps-performance-meter.md](gps-performance-meter.md)** в варианте C/D подключается к UART ESP32, а не к USART2 STM32.
- **Подсветка:** у вариантов A и B остаётся текущий ключ на PA8 и нерешённый вопрос полярности ШИМ ([REVIEW.md R5](../REVIEW.md)).

## 8. Вопросы до начала работы

1. Что именно не нравится сильнее всего: рывки и медленное обновление, углы обзора и цвет, яркость днём или чёткость шрифтов? От этого зависит, хватит ли этапа 0.
2. Какой размер влезает в место установки: только ~4" портрет или можно 4.3" ландшафт или квадрат?
3. Готов ли ты к перекомпоновке UI (квадрат или ландшафт) ради ESP32-варианта?
4. Нужна ли плавная регулировка яркости ночью? Это исключает D без доработки.
