Pcfccn/Dash/docs/future/carrier-template.pdf

# Плата-носитель 7×9 — шаблон 1:1, вид СВЕРХУ (сторона деталей)

Печатать в масштабе 100 % («фактический размер», без «подогнать»). Сверить линейку 50 мм внизу.
Положить на макетку отверстиями к отверстиям (колонка A слева, ряд 1 сверху) — и ставить детали по меткам.
Синие точки — используемые выводы WeAct, зелёные — отверстия под выводы гнёзд клеммников (carrier-board.md §3), красный ✕ — ключ: штыря нет, отверстие пустое. Рыжий пунктир — где ставить мелочь (assembly.md, шаги 1, 4, 6–8). Ряды 24–25 — снизу идут шины: туда детали не ставить. Полоса под штекер USB-C (колонки I–N) — пустая.

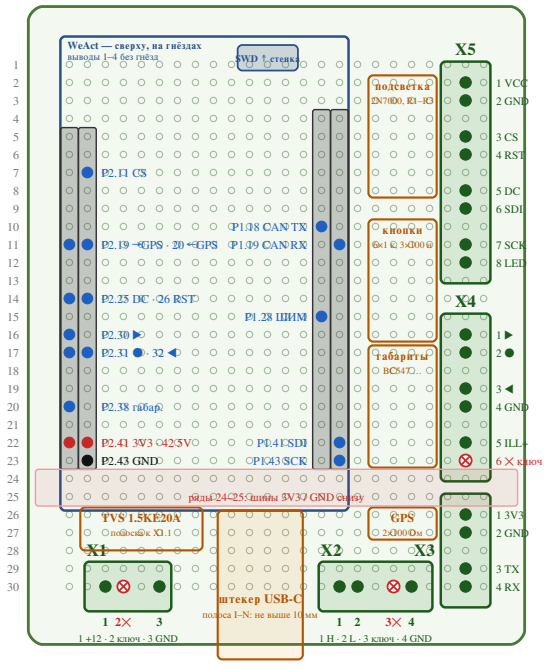
[picture p3: figure]
WeAct — сверху, на гнёздах выводы 1–4 без гнёзд; P1.18 CAN TX P1.19 CAN RX; P1.28 ШИМ; P1.41 SDI P1.43 SCK; P2.19 →GPS · 20 ←GPS; P2.25 DC · 26 RST; P2.38 габар.; P2.41 3V3 · 42 5V P2.43 GND; 1 VCC 2 GND; 3 CS 4 RST; 5 DC 6 SDI; 7 SCK 8 LED; 3 ◀ 4 GND; 5 ILL+ 6 ✕ ключ; 1 3V3 2 GND; 1 +12 · 2 ключ · 3 GND; 1 H · 2 L · 3 ключ · 4 GND; подсветка 2N7000, R1–R3; кнопки 6×1 к, 3×100 н; габариты BC547 …; TVS 1.5KE20A полоска к X1.1; GPS 2×100 Ом; штекер USB-C полоса I–N: не выше 10 мм; SWD ↑ стенка; ряды 24–25: шины 3V3 / GND снизу

A B C D E F G H I J K L M N O P Q R S T U V W X

50 мм — проверить настоящей линейкой

# Плата-носитель 7×9 — шаблон 1:1, вид СНИЗУ (сторона пайки, зеркально)

Так плата лежит, когда её паяешь: колонка A справа, ряд 1 сверху. Подписи выводов WeAct и клеммников — как они
видны снизу. Голые шины: 3V3 (красная) и GND (чёрная). 3V3 у P2.41 сначала уходит в колонку C (изолированной перемычкой), а потом вниз — чтобы не пройти по P2.43, это GND. Остальные провода — в изоляции,
по таблицам assembly.md.

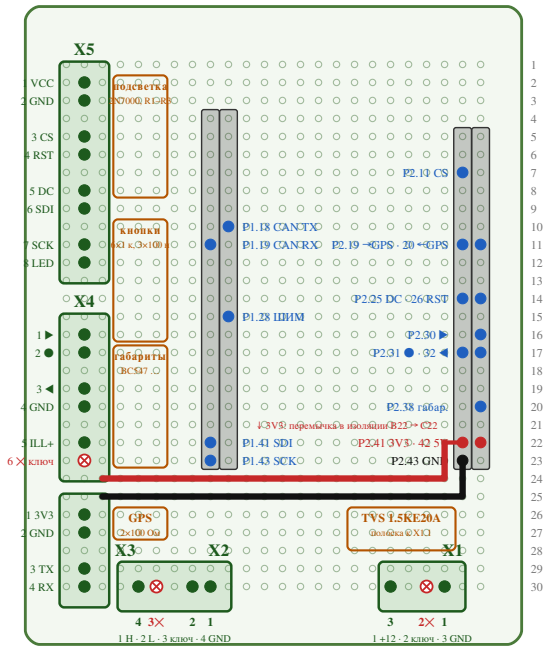
[picture p4: figure]
P1.18 CAN TX P1.19 CAN RX; P1.28 ШИМ; P1.41 SDI P1.43 SCK; P2.19 →GPS · 20 ←GPS; P2.25 DC · 26 RST; P2.38 габар.; P2.41 3V3 · 42 5V P2.43 GND; 1 VCC 2 GND; 3 CS 4 RST; 5 DC 6 SDI; 7 SCK 8 LED; 3 ◀ 4 GND; 5 ILL+ 6 ✕ ключ; 1 3V3 2 GND; 3 2✕ 1 1 +12 · 2 ключ · 3 GND; 1 H · 2 L · 3 ключ · 4 GND; подсветка 2N7000, R1–R3; кнопки 6×1 к, 3×100 н; габариты BC547 …; TVS 1.5KE20A полоска к X1.1; GPS 2×100 Ом; ↓ 3V3: перемычка в изоляции B22 → C22

X W V U T S R Q P O N M L K J I H G F E D C B A

50 мм — проверить настоящей линейкой

# Бирки на провода жгута — по две на провод (оба конца)

Вырезать по пунктиру, сложить пополам по средней линии вокруг провода, сверху — прозрачный скотч или прозрачная термоусадка. Надпись читается с обеих сторон. Последний ряд — бирки на сами вилки X1…X5.
X1.2, X2.3, X4.6 — ключи: провода нет, бирки нет. Таблица проводов — harness.md.

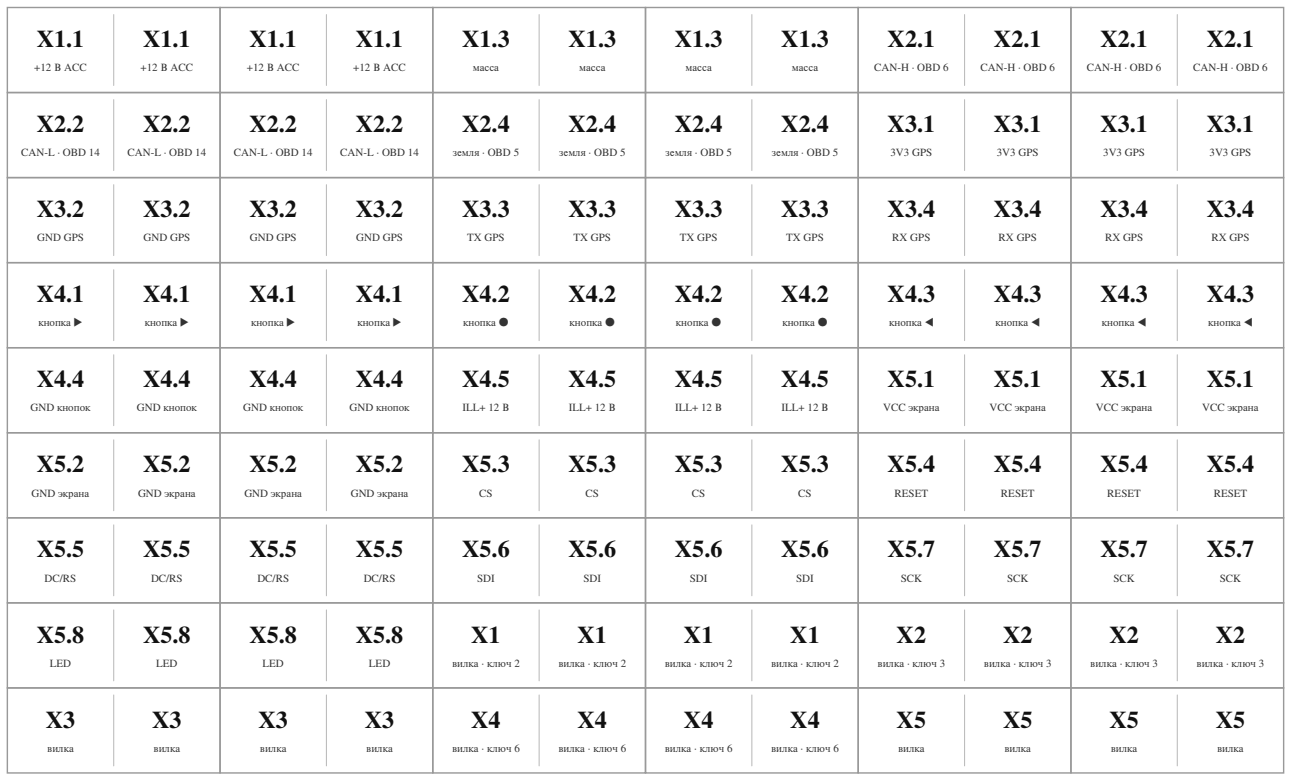
[picture p5: figure]
+12 В ACC; масса; CAN-H · OBD 6; CAN-L · OBD 14; земля · OBD 5; 3V3 GPS; GND GPS; TX GPS; RX GPS; кнопка ▶; кнопка ●; кнопка ◀; GND кнопок; ILL+ 12 В; VCC экрана; GND экрана; RESET; SDI; SCK; LED; вилка · ключ 2; вилка · ключ 3; вилка; вилка · ключ 6
