Pcfccn/Dash/docs/REVIEW.md

# Dash — обзор проекта для ревью

## Ревью C9 (2026-10-28) — полное ревью `main` и исправления

Ревью `main` @ `d169b6c` (после исправлений C8): прошивка прочитана целиком, инструменты и документы по железу проверены отдельными проходами, каждая находка сверена по файлам. Проверка тестов — намеренными поломками («мутациями») кода: из 14 поломок старые тесты поймали 9, пять пропущенных теперь ловятся. У каждого исправления прошивки есть тест, который **падает на прежнем коде** (подстановкой прежней логики или мутацией). Исправления — коммиты `65135a0` (bus-off и тесты), `8894e1c` (ассерты LVGL, инструменты), `83fe2e0` (документы по железу) в `main`. **На STM32, панели и в машине не проверено** — перед машиной прошить новый образ и пройти [bench-first-flash.md](bench-first-flash.md) §1.

**Проверки.** Тесты на ПК: 15 наборов, 0 ошибок — OBD 484 (было 446), `OILP_DPID_ENABLE 1` 525 (было 487), тревоги 139 + 139, NMEA 43, дисплей 41, perf 39, ST7735 37, GPS 33, сниффер 32, nvlog 31, одометр 31, кнопки 25, калибровка скорости 20, статистика 16. Сборки без предупреждений: `--lint-variants` (39 файлов + 62 прохода с переключателями), `-D OILP_DPID_ENABLE=1`, `OBD_DEMO=1`, `BACKLIGHT_ACTIVE_LOW=0`, `FAULT_TEST=4`. Все страницы отрисованы `tools/ui_render.py --m32`, куча LVGL — пик 57 %. Чертежи из `tools/drawings` пересобираются байт в байт; изменились только три, где добавлен резистор у врезки ILL+.

| Пункт | Что было | Что сделано | Тест / проверка |
|---|---|---|---|
| **FW-01 (P2)** bus-off без паузы | `obd_check_health()` перезапускал контроллер на каждой проверке (100 мс), без паузы и предела: модель на настоящем `fdcan_obd.c` — 600 перезапусков в минуту. При неисправности на нашей стороне (перепутаны CAN-H / CAN-L, мёртвый трансивер, плохая масса) узел 10 раз в секунду возвращался на шину ECM ↔ TCM в активном режиме ошибок и портил чужие кадры. Кроме того, PSR.BO держится всю последовательность восстановления (129 × 11 рецессивных бит), и повторный Stop её перезапускал: на загруженной шине узел мог не вернуться никогда | одно событие — на фронт BO; первый bus-off в серии — перезапуск сразу, следующие (в пределах 60 с) — пауза 1 / 5 / 15 с в режиме наблюдения шины (CCCR.MON: приём есть, на шину ничего — ни кадров, ни ACK, ни флагов ошибок; запросы не ставятся в очередь), пятый — только слушать до следующего включения. DIAG, строка 1: `BUS-OFF xN: TX PAUSED, LISTENING` / `TX OFF, CHECK CAN WIRING`, восстановленные — `BOFF<n>` | `c9_busoff_backs_off`, `c9_busoff_once_at_once`, `c9_pause_listens_resumes`, `c9_recovery_not_restarted` — на прежней логике падают все четыре (13 проверок); заглушка HAL теперь моделирует BO со временем восстановления, CCCR.MON и флаг потери FIFO |
| **HW-01 (P2)** ILL+ без предохранителя | X4.5 — 12 В от цепи габаритов (предохранитель TAIL 10–15 А) проводом 22 AWG без своей защиты, в клеммнике рядом с X4.4 (масса): одна жилка — и ночью гаснут габариты, задние фонари и подсветка приборов | 10 кОм 0.25 Вт в разрыв провода у самой врезки, под термоусадку: КЗ в любом месте после него — ~1.5 мА. Плата не меняется; порог датчика 2.5 → ~2.9 В, ток базы при 9 В 0.14 мА (запас 4×) | harness.md (X4), build-hardware.md §5 / §6c, carrier-board, assembly; чертежи harness, wiring-overview, шаг 8 |
| **HW-02 (P2)** отрезанный хвост разветвителя | «отрезать хвост и найти 6, 14, 5» — без слова об остальных жилах, а пин 16 — +12 В постоянно, без ключа | каждую лишнюю жилу обрезать вразбежку и изолировать отдельно, пин 16 — первым; проверка мультиметром | harness.md, X2 |
| **TEST-01** окно «ECM слышен» | `miss_counts()`: поломка до `return ecm_heard;` проходила все 446 + 487 проверок — случай «ECM отвечал, потом замолчал (ACC)» не проверялся, а это ровно исправление C8 | тест на старый кадр ECM (`ECM_ALIVE_MS`) и на кадр внутри окна | `c9_ecm_went_silent`: на мутации — 9 отказов |
| **TEST-02** ответ до запроса | нижнюю границу `arrived_in_time()` можно было удалить незаметно | кадр со штампом ISR раньше запроса декодируется, но транзакцию не закрывает | `c9_reply_before_request`: на мутации — отказ |
| **TEST-03** здоровье шины в тестах | в заглушке флаг потери FIFO всегда 0, bus-off не бывает: `LOST` от FIFO и восстановление не исполнялись | `__HAL_FDCAN_GET_FLAG` читает IR, модель bus-off (выше) | `c9_fifo_lost_counted`: на мутации — отказ |
| **FW-02 (P3)** ассерт LVGL = «WATCHDOG» | `LV_ASSERT_HANDLER` по умолчанию `while(1);`: кончившаяся куча LVGL (ожидаемый отказ по мере роста страниц) показывалась как `LAST RESET: WATCHDOG`, как любое зависание | `lv_conf.h`: `fault_assert_failed(__FILE__, __LINE__)` → `LAST RESET: ASSERT lv_xxx.c:<line>`; в `ui_render` ассерт завершает рендер с местом, а не висит | сборка; в рендере — заглушка |

**P3, тоже исправлено:**
- **Инструменты:**
  - `build.py` проверяет у `-D` и значение (0 / 1, `FAULT_TEST` 0..4): `-D LCD_PROBE=on` раньше собирал обычный ROAD в `build-lcd_probe_on/`. У каждого переключателя теперь `_Static_assert` — правка заголовка в CubeIDE тоже не превратится в 0 молча;
  - `ui_render.py` проверяет `-D` так же (раньше никак), удаляет картинки прошлого запуска, пересобирает LVGL при изменении любого заголовка LVGL и версии компилятора; новые сцены DIAG — со счётчиками и после отказа от передачи (там нашлось, что строка 1 с `TXOFF` не влезала, — переделана);
  - `host_test.py` честно говорит, что у zig нет ASan (на Linux / macOS он молча выбрасывал флаг), и включает для zig UBSan в режиме trap.
- **Документы:**
  - vehicle-install.md: земля — масса питания на болт кузова, OBD 5 — только опора CAN, OBD 4 не подключается (было три разных указания); что делать, если на шине ~120 Ом;
  - build-hardware.md:
    - §5: прозвонка платы — до первого включения WeAct (стояла после); ссылка на assembly.md;
    - §6c: таблица действий ● — что в прошивке, что «план» (описывала несделанное как сделанное); STATS-сброс — в любой момент;
    - SN65HVD230: ESD на линиях — 16 кВ HBM по даташиту TI, слабое место — −4…+16 В и нет ISO 7637;
    - вилка X1 в гнезде X2 — не «не страшно»: TVS не на этом пути, проверять 12 В на X2;
    - питание GPS уходит из коробки — КЗ гасит всю плату: прокладка, PTC по желанию;
    - оговорка про X1.3 + X2.4 как параллельную перемычку массы — 47 Ом в X2.4 по желанию;
  - Vgs Si4599 «выключено» — −1.3…−1.5 В (исток за D10 на 4.6–4.8 В), не −1.7 В: build-hardware, wiring, vehicle-install, комментарий в `app_main.c`;
  - docs/future/README.md: добавлены carrier-board, assembly, harness; статусы GPS-разгона и одометра — «в прошивке».

**Не менялось, решения прежние:** давление масла не входит в полосу тревог и после `OILP_VALIDATED 1` (C7, [oil-pressure-test.md](oil-pressure-test.md)); RPM у красной зоны красит только цифру, полосу и рамку — нет. Неотслеживаемый `.vscode/settings.json` владельца (`cmake.sourceDirectory` → LVGL) не трогался: с расширением CMake Tools он настроит LVGL в ту же папку `build/`, что и `build.py`.

**Проверить на железе (новое):**
- bus-off — **только на столе**, со вторым узлом CAN на шине (USB-CAN адаптер и два терминатора): без второго узла передача кончается ошибкой ACK, а она до bus-off не доводит. **В машине не проверять:** это ровно та помеха шине ECM ↔ TCM, от которой защищает исправление. Поменять CAN-H / CAN-L на X2: примерно за минуту (5 bus-off по ~5 с и паузы 1 / 5 / 15 с) DIAG должен дойти до `BUS-OFF x5: TX OFF, CHECK CAN WIRING`. После возврата проводов передача идёт только после перезапуска;
- ILL+ через 10 кОм — ночь при 9 / 12 / 14.4 В.

---

## Ревью C8 (2026-10-26) — полное ревью `main` и исправления

Ревью `main` @ `20e94d6`: прошивка, инструменты, документы, железо. Каждый пункт сверен с кодом; где можно на ПК — воспроизведён моделью на настоящем исходнике, и у исправления есть тест, который **падает на прежнем коде**. Исправления — коммиты `5252f50` … `8a27dc7` в `main`. **На STM32, панели и в машине не проверено** — перед машиной прошить новый образ и пройти [bench-first-flash.md](bench-first-flash.md) §1.

**Проверки.** Тесты на ПК: 15 наборов, 0 ошибок — OBD 446, `OILP_DPID_ENABLE 1` 487, тревоги 139 + 139, NMEA 43, дисплей 41, perf 39, ST7735 37, GPS 33, сниффер 32, nvlog 31, одометр 31, кнопки 25, калибровка скорости 20, статистика 16 (`zig cc`, UBSan). Сборки без предупреждений: по умолчанию, `--lint-variants` (39 файлов + 62 прохода с переключателями), `-D OILP_DPID_ENABLE=1`, `OBD_DEMO=1`, `BACKLIGHT_ACTIVE_LOW=0`, `FAULT_TEST=4`, `UI_PALETTE_TN=0`, `OILP_VALIDATED=1`, `LCD_PROBE=1`. Все страницы отрисованы `tools/ui_render.py`; куча LVGL на 32 бит — пик 57 %.

| Пункт | Что было | Что сделано | Тест / проверка |
|---|---|---|---|
| **ODO-01 (P1)** одометр считал дважды | `feed_gps()` отдаёт новейший фикс до разбора кадров CAN того же периода; кадр OBD на несколько мс старше уже учтённого фикса давал беззнаковое переполнение `t − gps_last_t` → «GPS нет» → участок считался ещё раз. Модель цикла на настоящем `odo.c`: +4 % (цикл 5–10 мс) … +94 % (затыки 200 мс); TOTAL пишется во флеш и не сбрасывается | все сравнения времени в `odo.c` знаковые; стоянка тоже двигает точку стыка; после паузы GPS старая скорость не начало участка; `trip_app_service()` получает время после разбора RX (`5252f50`) | `test_odo.c`: `obd_older_than_fed_gps`, `spike_after_stop`, `stamp_after_now`, `gps_gap_old_speed` — на старом коде 5 отказов |
| **GPS-01 (P2)** PERF выдумывал разгон | `fix_ms` ставится только при фиксе, `feed_gps()` срабатывал по нему — потерю фикса (туннель) и обрыв NMEA не видели ни PERF, ни одометр: READY висел, секундомер RUN шёл, READY + 20 с без фикса + 55 км/ч → 0-60 = 6.00, 0-100 = 10.00 в LAST и BEST | `rmc_ms`/`gga_ms`, `gps_gga_fresh()`; `feed_gps()` на каждый RMC; пауза снимает и READY; `perf_tick()` закрывает READY / RUN без выборок; пауза в истории OBD ломает «ровную скорость» (`c574d2c`) | `test_perf.c` `gap_disarms_ready`, `tick_without_samples`; `test_gps.c` `c8_no_fix_rmc_is_stamped`; `test_speed_cal.c` `pause_breaks_steadiness`; старый `perf.c` в том же сценарии — 6.00 / 10.00 |
| **IN-01 (P2)** сброс счётчиков из режима яркости | `btn_hold()` не смотрел на режим яркости: ● 2 с там обнулял TRIP / A, PERF, STATS, а на главном экране режим не виден | удержание ● / ◀ в режиме яркости ничего не делает (`648aa90`) | логика в `app_main.c`, на ПК не тестируется |
| **OBD-01 (P2)** отказ от проб по ложным промахам | давление масла (3), DPF (10), карты PID (6) сдаются до выключения, а считали любой таймаут — и потерянный на передаче (TXBCF), и при молчащем ECM (ACC): 10 с на ACC → `OILP NONE` | `miss_counts()`: промах — только если ни один буфер TX транзакции не отменён **и** ECM слышен ≤ 500 мс; попытка карт — по промаху, не по отправке; отказ `$22` — дважды без ответа между (NRC не называет DID) (`82351bf`) | `c8_silent_ecm_not_a_miss`, `c8_lost_tx_not_a_miss`, `c8_pidsup_silent_ecm`, `c8_dpf_refusal_then_answer`; на старом коде набор падает в 11 сценариях |
| **OBD-02 (P2)** BOOST нет на STATS | `update_boost()` ставил метку свежести, но не звал `obd_on_stamp()` | метка на каждое чтение MAP (`82351bf`) | `c8_boost_and_gear_stamps` |
| **DOC-01 (P2)** откат и вариант `INV` | `git checkout flashed-1d56fd2` + `build.py` — в теге нет `tools/`; `ROAD INV` не доходил до KOEO, отката, задач VS Code | §5–§7 чек-листа: каждый образ платы-носителя с `INV`, откат — старый тег в отдельном `git worktree` с сегодняшним `build.py` (проверено: собирается чисто), для платы-носителя — `flashed-7d0acf9` с `INV`; варианты `KOEO INV`, `DEMO INV` в VS Code (`8ffec8f`, `d30c73a`) | сборка отката в worktree |
| **TOOL-01 (P2)** UBSan молчал вне Windows | без `-fno-sanitize-recover` тест выходил с 0 | `-fno-sanitize-recover=all`, тайм-аут 120 с на тест (`d30c73a`) | — |
| **HW-01 (P2)** пайка клеммников 3.81 | §3 противоречил себе: рассверловка до Ø1.4 снимает металлизацию, а пайка рассчитывала на неё; изгиб 20° с перехватом 1 мм даёт 0.34 мм, а не 0.635 | carrier-board.md §3: одна карта отверстий; **способ 1 (для машины)** — гнездо на проволочках в обычные металлизированные отверстия, корпус на клею; способ 2 (гибка ~40°, без сверления) — только стол | расчёт по чертежу KEFA |
| **HW-02 (P2)** вилки без ключа | короткая вилка входит в любое длинное гнездо: X1 (+12 В) в X3 → 12 В на 3V3; X2 в X3 → CAN-H на 3V3, шина зажата | ключи из имеющихся деталей: X1 — 3 конт. (ключ 2), X2 — 4 конт. (ключ 3), X4 — ключ 6; штырь вынут из гнезда и зажат в вилке; таблица «что во что входит» | перебор 5 × 5; на запасном гнезде проверить, закрыты ли торцы |
| **HW-03 (P2)** USB-C упирался в X3 | центр USB-C WeAct (x ≈ 32.7 мм) смотрел в X3 на ряду 30 | X3 — вертикально в колонке W (ряды 26–30), TVS — в B–H, полоса I–N под штекер пустая; SWD у стенки — заметка про прошивку в машине (только SWDIO / SWCLK / GND клона) | по чертежу WeAct V12 и координатам генератора |

**P3, тоже исправлено:**
- **Журнал NOR** (`cbe129c`, `8a27dc7`):
  - неудачная проверка записи тратит свой `seq`, повтор с более новыми данными больше не проигрывает старому;
  - голова сектора ищется за испорченными слотами (было только 0 и 1 — новейший сектор стирался);
  - сбой чтения посреди загрузки → «NO FLASH», а не нули поверх TOTAL;
  - поиск ограничен 8 слотами.
  Тесты `c8_verify_glitch`, `c8_two_torn_slots`, `c8_read_fail_mid_scan`.
- **OBD:** DPF только после карт PID; `CAP` не считает сеансы SNIFF; ровная средняя ротация (`uint8 % 7` терял MIL раз в 256); передача / селектор −1 → NaN в STATS. **SNIFF:** байт из более длинного кадра — база, не «изменение» (`dc52981`).
- **Кнопки / свет** (`648aa90`):
  - нажатие, засчитанное EXTI на выборку позже, — то же нажатие;
  - EXTI считает нажатие только после отпускания;
  - PE15 — защёлка спада для ШИМ на ILL+;
  - старт сразу на профиле день / ночь, плавный переход по времени;
  - ST7735 округляет как главный экран;
  - `LCD_PROBE` с подсветкой.
- **UI** (`51a36e2`, `d30c73a`):
  - `LAST RESET xN:` — серия не теряется (буфер 56);
  - TRIP / PERF / STATS обновляются при входе (не старый кадр);
  - TN: «не оценивается» белым, не голубым «холодный», зелёный `C_OK` у передачи;
  - строка MEMORY через `cat()`;
  - гонка `s_need_repaint`;
  - подсказка SNIFF больше не наезжает на точки страниц.
- **Инструменты** (`d30c73a`):
  - `-D` только из переключателей прошивки;
  - `--lint-variants`;
  - метка `+` видит неотслеживаемые файлы и `build.py`;
  - `--clean` не трогает кэши тестов и рендера;
  - поиск CubeProgrammer;
  - рендер без Pillow, все виды DIAG и SNIFF, честные заглушки;
  - `OILPV` в метке образа.
- **Документы** (`8ffec8f`): CLAUDE.md, oil-pressure-test, enhanced-dids, vehicle-install, wiring, gps-performance-meter, bench-first-flash — по коду.
- **Железо** (build-hardware, carrier-board, assembly, harness + все чертежи из `tools/drawings`, пересобраны байт в байт):
  - R3 драйвера подсветки 10 к → 100 к (на затворе 3.27 В вместо 3.0 = max Vgs(th));
  - на гребёнке 5 В за диодом D10 — ждать ~4.6–4.8 В; резисторы CC на WeAct есть;
  - замер вывода LED экрана до пайки драйвера (может быть управляющим входом);
  - цвета GPS (TX белый, RX синий) и ряды зоны кнопок (10–16) — везде одинаково;
  - 2 × 100 Ом в линиях GPS;
  - отвод CAN ≤ 30 см вместе с хвостом разветвителя;
  - врезка в ACC с вынутым ключом и подальше от SRS;
  - пуск от ACC = перезапуск;
  - коробка 140×82×38, провод 22 AWG, масса на болт кузова, одна точка GND;
  - в список покупок: штекер OBD2 (если у разветвителя нет хвоста), кольцевые клеммы, термоусадка 3 мм, клей под гнёзда.
- **Проверить на деталях:**
  - закрыты ли торцы гнёзд;
  - держит ли винт вилки штырь-ключ;
  - диаметр отверстий макетки;
  - высота под крышкой;
  - ширина штекера USB-C (≤ 12 мм);
  - ток в LED экрана;
  - есть ли хвост у разветвителя;
  - пропадает ли ACC на START;
  - болт массы.

**Не менялось:** `feed_gps()` по-прежнему отдаёт только новейший RMC итерации — для PERF это проверено моделью: при постоянном ускорении и выборках раз в 500 мс времена совпадают до 0.001 с; паузу > 600 мс PERF считает обрывом.

---

## Для ревьюера — состояние на 2026-10-15

**Новое после C6** (всё в `stage-c`, на железе не проверено):
- **ECM:** читает свои карты поддержки PID (DIAG, строка 3).
- **GPS:** драйвер ATGM336H (USART2, сам находит модуль и настраивает 115200 / 10 Гц).
- **Кнопки:** ▶ ● ◀ на PE7–PE9.
- **День / ночь:** по габаритам (PE15) — два профиля яркости.
- **Документ:** раскладка платы-носителя (`docs/future/carrier-board.md`).
- **Исправления по ревью C7:** статус — первая таблица ниже. Проверки там же: 8 наборов тестов на ПК, 4 сборки без предупреждений.
- **После C7:**
  - метка образа (коммит и вариант ROAD / BENCH / INV) на DIAG и на ST7735 при старте;
  - счётчики `TXL` (потерянные одиночные передачи CAN) и `O<n>` (потерянные байты GPS);
  - тревоги с выдержкой и гистерезисом (`alert.c`, C7 SW-05);
  - чек-лист первой прошивки — [bench-first-flash.md](bench-first-flash.md).

Абзацы ниже до разделителя — состояние на 2026-10-11, оставлены для истории.

**Машина уточнена:** это **Toyota Land Cruiser 100** (1998–2007) **со свапом Holden Colorado RG 2.8 Duramax** — ECM E98 и АКПП от Colorado. Всё, что читается по CAN, — от ЭБУ Colorado, и проверенная в машине таблица сигналов (CLAUDE.md) остаётся в силе. А всё «салонное» — тойотовское: заглушки кнопок, предохранители, подсветка приборов, бак. Приборки и BCM от Colorado в машине нет, если их не оставили при свапе. Ранние документы, где написано «в RG Colorado», читать именно так.

**Ветки.** `main` — прошитая `f0a0844` (+ коммит графа). **`stage-c`** — всё новое, на железе **не прошито и не проверено**. Ревьюить `stage-c`.

**Прошивка после ревью C5** (`8184c94`, `667befe`): проверки «был ли сбой SPI на этом шаге» (окно, init) идут по счётчику событий `s_err_seq` без насыщения, а не по счётчику DIAG, который стоит на 0xFFFF (C5-SW-01). `BACKLIGHT_ACTIVE_LOW` задаётся при сборке; по умолчанию 1, как сейчас (C5-HW-04).

**Прошивка после ревью C4** (`d0aad74`): owed re-init дисплея теперь отдельный флаг `s_reinit_pending`, хороший DMA-кадр его не снимает (C4-SW-01, таблица ниже).

**Прошивка после ревью C3** (`6e98002`, `2c281cd`, `ab08a11`, `8b6d3d6`, статус — таблица ниже):
- ISO-TP: последний CF после 10-секундного предела больше не закрывает транзакцию.
- SNIFF: неудачный возврат узкого фильтра повторяется (`WIDE` на DIAG); честное `NOT LISTENING`; ранжирование по возрасту через переход тиков.
- Дисплей: тесты драйвера на ПК с внесением отказов; найденная ими ошибка (неудачный re-init не повторялся) исправлена.
- DIAG: три строки без обрезки; плитка `OIL P ?`.

**Проверки:** `python tools/host_test.py` — 4 набора, 0 ошибок: OBD по умолчанию 261, экспериментальная сборка (`OILP_DPID_ENABLE 1`) 302, сниффер 29, дисплей 41 проверка (15 сценариев). `python tools/build.py` и `python tools/build.py -D OILP_DPID_ENABLE=1` — без предупреждений. На STM32, панели и в машине — ничего.

**Новые проекты доработок** (только документы, кода нет), `docs/future/`:

| Документ | Что | На что посмотреть |
|---|---|---|
| [gps-odometer-fuel.md](future/gps-odometer-fuel.md) | Одометр по GPS (интеграл доплеровской скорости, запасной путь — скорость машины с поправкой, обученной по GPS); расход дизеля — источник на E98 ещё искать (PID `0x5E` / кадр ECM / DID подачи), калибровка по заправкам; хранение в SPI NOR | Подход к расходу без MAF; журнал в NOR и обрыв питания посреди записи |
| [build-hardware.md](future/build-hardware.md) | Сборка из макетки, **один выбранный вариант A** (после C4-HW-04): питание от купленного PD65W (вход 8–30 В) + TVS 1.5KE20A + 2 А; драйвер затвора подсветки на 2N7000 (10 к / 1 к); GPS ATGM336H-6N (только 3V3) на макетке с пассивным патчем; клеммники вместо Dupont; лист LCSC (§6b); **управление (§6c)**; чек-лист (§8) | См. вопросы ниже |
| [gps-performance-meter.md](future/gps-performance-meter.md) | Замер разгона; модуль выбран: ATGM336H-6N, NMEA 10 Гц (±0.1 с на 0–100 владельца устраивает) | — |

**Управление (§6c).** Экран под панелью, поэтому кнопки отдельные — OE-style Toyota LC100 (40×20, momentary) в штатных заглушках. ▶ страница / удержание = яркость (+10 % на нажатие, как сейчас с KEY), ● действие / удержание = сброс, ◀ по желанию, ▶ + ● = сервисный режим (DIAG, SNIFF). Энкодер убран. День/ночь — по габаритам: 12 В подсветки приборов через делитель 220 к / 100 к на затвор 2N7000 → PE15 (кнопки PE7 / PE8 / PE9; не PD3–PD6, C4-HW-01), чтобы выключенная плата не питалась от габаритов; два профиля яркости. Подсветка самих кнопок — от штатного реостата.

**Вопросы ревьюеру:**
1. ~~Датчик габаритов через 2N7000~~ — подтверждено в C5-HW-05 (Vgs(th) до 3.0 В против 2.81 В при 9 В), заменён на BC547 с 47 к / 100 к и 1N4148 от отрицательных выбросов. Открыто: постоянный ли ILL+ в LC100 и подпитка выключенной платы через переход база–коллектор (C6, стенд в §5).
2. Кнопки на 12 В / 3 А как «сухой» контакт: подтяжка 1 кОм (~3 мА) для смачивания — разумно ли.
3. PD65W: допущение, что без запроса быстрой зарядки модуль держит 5 В; на WeAct может не быть резисторов CC 5.1 кОм — тогда модуль не отдаст ничего.
4. ~~1.5KE22A против входа до 30 В~~ — подтверждено в C4-HW-03, заменён на 1.5KE20A (ограничение ≤ 27.7 В). Открыто: настоящий предел PD65W неизвестен (смотреть контроллер и входные конденсаторы, когда модуль придёт).
5. ATGM336H на макетке: пассивный патч на проводке ~5 мм от `RF_IN`, земля — медный скотч. Насколько это рабоче.
6. Раскладка кнопок по страницам: не перегружено ли для двух кнопок на ходу.

Лист заказа владельца (не в репозитории): `C:\CLD\Parts and Hardware\order-2026-10-11.md` (папка раньше называлась `myHardware`).

---

## Статус исправлений (2026-10-09)

Разделы 1–9 ниже — исторический снимок на `f9635ab`, по которому делались ревью. Что с тех пор изменилось:
- ветка `review/stage-a` влита в `main` (`9843f1f`), прошита (тег `flashed-110c90d`) и **на столе работает**, в поездке ещё не проверялась;
- поверх неё сделан «этап 0» ускорения дисплея (`b7f9470`, подробности в разделе ниже). Собран, прошит, **на панели и в поездке не проверен**.

Все пункты собраны (`tools/build.py`, 0 предупреждений) и, где это касается протокола, покрыты тестами на ПК (`tools/host_test.py`).

### Ревью Stage C7 (2026-10-15) — статус

Полное ревью (архив `Dash-stage-c.zip`, без `.git`). Ветка `stage-c`. Каждый пункт сверен с кодом; подтверждённые дефекты исправлены, у каждого исправления, которое можно проверить на ПК, есть тест, и он **падает на прежнем коде** (сверено подстановкой старых файлов: EGT — 5 отказов, передача — 3, GPS — 2; тест ST7735 со старым драйвером не собирается — там нет API ремонта).

Тесты на ПК: 8 наборов, 0 ошибок:

| Набор | Проверок |
|---|---:|
| OBD | 293 |
| OBD, сборка `OILP_DPID_ENABLE 1` | 334 |
| сниффер | 29 |
| GPS | 29 |
| NMEA | 43 |
| кнопки | 19 |
| главный дисплей | 41 |
| ST7735 (новый набор) | 33 |

Здесь это `zig cc` (Clang) с UBSan; GCC и ASan за ревьюером. Сборки — без предупреждений: по умолчанию, `-D OILP_DPID_ENABLE=1`, `-D BACKLIGHT_ACTIVE_LOW=0`, `-D FAULT_TEST=4`. **На STM32, панели и машине не проверено.**

**Исправлено в коде:**

| Пункт | Что сделано | Тест / проверка |
|---|---|---|
| CAN-01 (P2) маска EGT `$78` | Датчик 1 берётся только при `A.bit0`. Без бита значение возвращается в NaN («никогда не присылали») и не получает метку свежести. Этот ECM `$78` не опрашивает; ответ мог прийти на запрос другого сканера | `c7_egt_mask`: маски 0x00 / 0x02 / 0x01 / 0x03 / 0x0E, края −40 и 6513.5 °C |
| CAN-02 (P2) передача «свежая» до первого ответа | `policy_value(M_GEAR)` — NaN при `gear < 0`. Это и −1 при старте, и сырой байт ≥ 0x80. DRIVE берёт `policy_fresh()`, а не голый `obd_is_fresh()`. Общая причина записана у `policy_fresh()`: при `upd_ms = 0` метка «свежая» первые `metric_stale_ms` после загрузки, поэтому «хоть раз пришло» проверяется по значению | `c7_gear_not_fresh_before` |
| SW-01 (P1) ST7735 без восстановления | Сделано по образцу главного экрана (подробнее под таблицей) | `test_st7735_status.c`: 9 сценариев — ошибка в init, удержание, команда без параметров, не чаще 1/с, повтор после отказа init SPI4, насыщенный счётчик DIAG |
| SW-02 (P2) ST7735 перерисовывает без изменений | `key_dbg()` и окно яркости пишут надпись и флаг только при изменении | там же, 2 сценария |
| SW-03 (P2) `off += lv_snprintf` в SNIFF | Обе таблицы SNIFF (STATE, ANALOG) переведены на `cat()`. Ошибка была скрытой: сегодня 6 строк в буфер помещаются. Но после обрезанного поля `sizeof rows - off` как `size_t` становится огромным, и следующий `"\n"` пишется за массив | на ПК не тестируется: у `cluster_ui.c` тестов нет; `cat()` уже используется в DIAG |
| SW-04 (P2) нажатия читаются несогласованно | `btn_snapshot()`: счётчик и время нажатия читаются парой под PRIMASK. Последствие было мелкое: новое нажатие засчитывалось сразу, только если кнопку уже отпустили, то есть при очень коротком касании | логика `btn_step()` — `test_input.c`; гонка с ISR на ПК не воспроизводится |
| SW-06 (P2) время GPS = время выгрузки | Метки времени ставятся в IRQ (подробнее под таблицей) | `c7_fix_time_is_receive_time`: цикл стоит 1.9 с, фикс свежий до t0 + 2 с, а не до t0 + 3.9 с |
| SW-07 (P2) `osThreadNew` не проверяется | `NULL` → `FAULT_RTOS_INIT` и остановка, плату сбрасывает IWDG загрузки. DIAG живёт в этой задаче, поэтому код увидит только отладчик | сборка |
| SW-08 (P2) `configASSERT` → безликий WATCHDOG | `configASSERT` → `fault_assert_failed(__FILE__, __LINE__)` → `FAULT_ASSERT`. На DIAG `LAST RESET: ASSERT tasks.c:1234`; файл — адрес строки во flash, перед чтением сверяется с диапазоном flash и с инверсной копией. Новый `FAULT_TEST 4` = `configASSERT(0)`; `FAULT_TEST` задаётся через `-D`, `_Static_assert` 0..4 | образ `-D FAULT_TEST=4` собран; на столе не проверено |
| SW-10 (P3) ссылка на несуществующий макет | Шапка `cluster_ui.c` → `design/Diesel_Cluster_v2_3.html` и сознательные отличия от него (ниже) | — |
| CAN-05 (P2) смысл «нет кодов» | DIAG: `ECM: NO EMISSION CODES` / `ECM: n EMISSION CODES`. Счётчик из PID 0x01 есть только у ECM, а у TCM, ABS и SRS свои коды. Строки «NO STORED CODES» в прошивке нет | — |
| PERF-03 (P2) «1 КБ ≈ 0.9 с» | Комментарий исправлен (подробнее под таблицей). Переполнения считаются (`gps_state()->overruns`); **после C7** выводятся на DIAG: `O<n>` после поля GPS | — |
| §8 сборка: флаги не инвалидируют объекты | `build.py` хранит хэш версии компилятора и всех флагов (`flags.stamp`). Если что-то из этого изменилось, пересобирается всё | первый запуск: «rebuilding everything», второй — инкрементальный |

**Подробности к исправлениям:**

- **ST7735 (SW-01).** Что сделано:
  - `st_tx()` возвращает `bool`, каждая ошибка считается в `st_err_seq` (без насыщения; счётчик DIAG стоит на 0xFFFF);
  - пока ремонт не сделан, весь трафик держится: один таймаут 50 мс на попытку, а не на каждую передачу;
  - `st7735_status_service()` (в цикле перед `lv_timer_handler()`) делает DeInit/Init SPI4 и перерисовывает весь экран, не чаще 1/с;
  - команды init при загрузке не пропускаются никогда;
  - отказ `HAL_SPI_Init` при ремонте не вызывает `Error_Handler`, ремонт просто повторяется.

  **Не сделано:** повторный init контроллера панели. Базовый init MIPI в LVGL — `static`. Таймаут на стороне MCU панель не сбрасывает, а самосброс панели от просадки не даёт ошибки, как и у главного экрана.
- **GPS (SW-06).** IRQ ставит метку времени на каждый `'\r'`/`'\n'` (отдельное кольцо на 128 меток, синхронное с байтами). `rx_ms` и `fix_ms` берутся по метке конца предложения; `now` для автомата связи берётся после выгрузки.
- **GPS-буфер (PERF-03).** Сколько покрывает 1 КБ:
  - сплошной поток на 115200 — 89 мс;
  - настроенный трафик (RMC + GGA 10 Гц) — ~0.7 с;
  - 9600 — больше 1 с.

  Это «хватает против затыка 0.2–0.4 с», но не гарантия.

**Не менялось — решение или замер за владельцем:**

| Пункт | Почему / что нужно |
|---|---|
| SW-05 гистерезис, движок тревог | **Сделано после C7** (`fdb0391`, `test_alert.c`): `alert.c` — выдержка до входа, гистерезис и выдержка на выходе; АКБ и давление масла оцениваются только при работающем двигателе; без свежего значения состояния нет. Пороги — из макета, времена — первые прикидки: подбирать по логам из машины |
| SW-09 SPI2 `/16` в `spi.c`, `/8` в рантайме | Рантайм-переинициализация главная и описана в CLAUDE.md; ещё одна таблица дрейф CubeMX не остановит |
| SW-11, §2 разбить большие файлы, модель `quality` у сигналов, профили `ROAD`/`BENCH`/`HW_REV` | Согласен в принципе; после того, как контракты подтвердятся в машине. Сейчас вариант железа задаёт `BACKLIGHT_ACTIVE_LOW` (с `_Static_assert` и меткой BL INVERT) |
| SW-12 `AutoRetransmission = DISABLE` | Осознанно (подробнее под таблицей). **После C7** (`9d4a7ac`): счётчик `TXL` на DIAG |
| PERF-01, PERF-02 SPI2 и кольцо CAN | Телеметрия уже есть: `LOOP`, `Q`, `LOST`, `R`, `F`. Решать по цифрам со стола и из машины; частоту SPI без осциллографа не поднимать |
| CAN-03 «read-only ≠ passive» | Согласен, формулировка в CLAUDE.md исправлена. Журнал отправленных SID — не сделан |
| CAN-04 тайминги, калибровка скорости | После замеров в машине; многоточечная сверка GPS ↔ OBD (40/60/80/100) — в плане GPS |
| HW-01…HW-06 | Питание A — стенд и опытная езда (C5-HW-03, без изменений). Подпитка через габариты — стенд §5 шаг 3a (C6). Перфоплата с подогнутыми клеммниками 3.81 — прототип, согласен (`carrier-board.md` §3). Яркость ST7735 ночью: у него только вкл/выкл (PE10) — открыто |
| §8 Release-профиль, CI, `FW_VERSION`, ветки | Испытуемый образ — Debug; `-O2` — отдельный эксперимент со своим прогоном на столе. CI (GitHub Actions: тесты на ПК + сборка ARM) — **решение владельца**. Работа уже идёт в `stage-c`, `main` = прошитое |
| Макет ↔ прошивка | Сознательные отличия: на DRIVE нет строки-заголовка; четвёртая плитка температур — `OIL P ?` вместо EGT (EGT этот E98 не даёт); PRNDL — из рассылки `0x1F5`. `IAT` подписан как IAT, не как наружная температура |

- **SW-12, `AutoRetransmission = DISABLE`.** Запрос, проигравший арбитраж или испорченный ошибкой, аппаратно не повторяется. Транзакция закрывается по таймауту (150 мс), и планировщик идёт дальше. Плюс: на столе без второго узла кадр без ACK не повторяется бесконечно. На момент C7 отдельного счётчика потерянных одиночных передач не было, и в DIAG такая потеря была неотличима от неответа. **После C7 он есть:** буфер TX, закончившийся TXBCF, а не TXBTO, считается в `TXL` (DIAG, строка 1; тест `c7_tx_lost_counted`). На столе без шины `TXL` растёт — запросы некому подтвердить; в машине он покажет, нужно ли включать повтор.

### Ревью Stage C6 (2026-10-11) — статус

Ревьюер принял C6 как базу: дефект C5 закрыт (его тесты на коде C5 дают 3 отказа, на C6 — 0), новых ошибок в коде не найдено; GCC и Clang с ASan + UBSan у ревьюера — 0 ошибок. Ветка `stage-c`, коммит ниже. **На STM32, панели и машине не проверено.**

| Пункт | Что сделано | Проверка |
|---|---|---|
| Проверка `BACKLIGHT_ACTIVE_LOW` ∈ {0, 1} | Макрос переехал в `app_main.h`; `_Static_assert` (не `#if`: там `-D …=yes` прочиталось бы как 0) | `-D BACKLIGHT_ACTIVE_LOW=2` и `=yes` не собираются; 0 и 1 — без предупреждений |
| Метка варианта железа | Образ `=0` в режиме яркости пишет на ST7735 «BRIGHTNESS / BL INVERT». У маленького экрана своя подсветка: метку видно, даже когда не тот образ погасил большой экран | раскладка на панели не проверена |
| BC547: порог открытия преувеличен | «от ~1 В» — только начало проводимости; уверенный ноль на PE15 (усиление 10) — примерно от 2.5 В; на 9–16 В запас в 5–10 раз | расчёт, §6c |
| BC547: подпитка выключенной платы | Утверждение «не запитает» снято: **не проверено**. Добавлен стенд (ACC выкл., габариты вкл., плата без питания: 3V3, PE15, ток) и готовая развязка — BAT85 в коллектор анодом к PE15 (из лота CubeCrossPro) | §5 шаг 3a, §6c |
| Питание A для постоянной установки | Без изменений: стенд и опытная езда; постоянная — после замеров или с модулем с документированной стойкостью | — |

### Ревью Stage C5 (2026-10-11) — статус

Ветка `stage-c`. C5-SW-01 — `8184c94`: тесты ревьюера добавлены без изменений по сути (убран лишний `reset()`, его и так делает обвязка); на прежнем драйвере упали 3 проверки, как в ревью. C5-HW-04 — `667befe` (сборочный флаг, по умолчанию поведение то же). Остальное — документы. Тесты на ПК: OBD 261 + 302, сниффер 29, дисплей 41 — 0 ошибок; здесь это `zig cc` (Clang) с UBSan, **GCC и ASan на этой машине (Windows) нет** — их прогон за ревьюером. Сборки по умолчанию, `-D OILP_DPID_ENABLE=1` и `-D BACKLIGHT_ACTIVE_LOW=0` — без предупреждений. **На STM32, панели и машине не проверено.**

| Пункт | Что сделано | Тест / проверка | Остаётся |
|---|---|---|---|
| C5-SW-01 (P2) насыщение `s_spi_err` ослепляет проверки | `s_err_seq` (uint32, без насыщения, не сбрасывается) растёт в `spi_err()`; окно в `disp_flush_cb()`, init при загрузке и re-init сравнивают его, а не `s_spi_err`. Счётчик DIAG не тронут | `saturated_init_failure`, `saturated_window_failure` (падали на прежнем коде); 37 прежних проверок проходят | — |
| C5-HW-01, C5-HW-02 | Приняты ревьюером | — | PE7/8/9/15 по схеме WeAct и прозвонкой; ВЧ-тракт голого модуля на макетке — риск, запасной вариант — готовая плата GPS с антенной (другая схема питания) |
| C5-HW-03 (P1) питание A не доказано | `build-hardware.md` §2/§3/§6: питание A — **стенд и опытная езда, не постоянная установка**; убрано «сгорит предохранитель — так задумано»; предохранитель — защита проводки при КЗ, не от выбросов и не доказанная от переполюсовки; 27.7 В — только точка даташита (10/1000 мкс, 54 А); маркировка контроллера и конденсаторов — необходимое условие, не доказательство. Путь к постоянной установке: замеры (5 В при 9–16 В, пуск, выбросы на входе осциллографом) или модуль с документированной стойкостью (§6a) | — | **за владельцем** |
| C5-HW-04 (P1) драйвер подсветки инвертирует логику | `app_main.c`: `#ifndef BACKLIGHT_ACTIVE_LOW` → по умолчанию 1 (нынешняя проводка); образ для платы с 2N7000 — `python tools/build.py -D BACKLIGHT_ACTIVE_LOW=0`. Документы называют это переходом: старый образ на новой плате = подсветка выключена при «100 %» | дизассемблер: образы отличаются только `backlight_set()` (`rsb …, #100` есть только в образе по умолчанию) | на столе: 0 / 50 / 100 %, уровень при сбросе и загрузке, Vgs, нагрев |
| C5-HW-05 (P2) датчик габаритов на 2N7000 на грани | Заменён на **BC547**: 47 к / 100 к, 100 нФ, 1N4148 к базе от отрицательных выбросов; открывается от ~1 В, при 9 В насыщение с большим запасом. Детали: BC547 из лота CubeCrossPro (6 шт., там 2), остальное дома. Брать ILL+ (TAIL), а не ILL− реостата | расчёт в §6c | постоянный ли ILL+ (мультиметр / осциллограф), работа при 9 В и на холоде |
| C5-DOC-01 (P3) износ NOR | 7200 записей в день = ~56 стираний в день (было «меньше 30»); ~10 циклов на сектор в год по кругу | — | проверить, когда будет код журнала |

### Ревью Stage C4 (2026-10-11) — статус

Ветка `stage-c`. C4-SW-01 — коммит `d0aad74`. Сначала приложенный тест ревьюера и вариант с загрузкой упали на прежнем драйвере: 4 проверки. Пункты по железу — правка документов `docs/future/` и `docs/wiring.md`, кода нет. Тесты на ПК: OBD 261 + 302, сниффер 29, дисплей 37 — 0 ошибок. Обе прошивки собираются без предупреждений. **На STM32, панели и машине не проверено.**

| Пункт | Что сделано | Тест / источник | Остаётся проверить |
|---|---|---|---|
| C4-SW-01 (P1) хороший DMA стирает долг re-init | `s_reinit_pending`: ставится при 3 ошибках подряд и при init с ошибкой (и при загрузке), снимается **только** чистым init; `HAL_SPI_TxCpltCallback()` его не трогает; сервис и пауза 5 с — от него | `failed_reinit_then_good_dma` (тест ревьюера; проверка «долг ещё есть» читает `s_reinit_pending`, потому что серию ошибок хороший кадр теперь сбрасывает по замыслу), `boot_errors_then_good_dma` (тот же дефект при загрузке: первый кадр уходит по DMA раньше первого прохода сервиса). Сохранён `good_area_resets_streak`: разрозненные ошибки re-init не вызывают | `FAULT_TEST 3` на столе: `R` растёт, экран восстанавливается |
| C4-HW-01 (P1) PD6 = CS SPI-флешки, PD4 = датчик SD | Подтверждено двумя описаниями платы (Zephyr DTS, MicroPython `mpconfigboard.h`); PD3 — D5 порта камеры. Кнопки → **PE7 / PE8 / PE9**, габариты → **PE15**; `wiring.md` дополнен CS, датчиком карты, пинами DCMI и запланированными входами | Zephyr: `cs-gpios = <&gpiod 6>`, `cd-gpios = <&gpiod 4>`; MicroPython: `SPIFLASH_CS (pin_D6)`, `SDCARD_DETECT_PIN (pin_D4)` | сверить PE7/8/9/15 со схемой WeAct и прозвонить до пайки |
| C4-HW-02 (P1) GPS: 5 В на схеме против 3V3 у модуля | Схема §3 перерисована под выбранный вариант: голый ATGM336H-6N — **только 3V3**; готовая плата (5N31) — отдельная деталь, питание по её стабилизатору; `gps-performance-meter.md` поправлен | документация ATGM336H: 2.7–3.6 В (для 6N сверить по даташиту 6N) | VCC GPS на 3V3 — прозвонка §5 шаг 4 |
| C4-HW-03 (P1) TVS ограничивает выше предела входа | 1.5KE22A (30.6 В) → **1.5KE20A** Littelfuse, LCSC C1976464: 17.1 В рабочее, ≤ 27.7 В. Следствие: от 19 В (прикуривание от 24 В) TVS проводит; сгорит ли предохранитель раньше TVS — не гарантировано (поправлено в C5-HW-03). Предохранитель назван защитой от КЗ и переполюсовки, а не от выбросов. Вариант Pololu: конденсатор 35 → **50 В** (1.5KE27A до 37.5 В) | LCSC API 2026-10-11: 285 шт., $0.16 | предел PD65W неизвестен: контроллер и конденсаторы смотреть по приходу (§5 шаг 1); устойчивость к ISO 7637-2 / 16750-2 **не подтверждена** и дома не проверяется |
| C4-HW-04 (P2) варианты и цены вперемешку | `build-hardware.md`: §2 — таблица выбранного варианта A, §3 — только его схема (PD65W, SN65HVD230, 2N7000 10 к / 1 к / 10 к), §6 — стоимость только A; Pololu / TJA1051 / u-blox — в §6a со своей схемой; цена Pololu US$23.95 + доставка. «PD65W держит 5 В» и «CC-резисторы на WeAct» — допущения, замер в §5 шаги 1–2 | — | замеры §5 |
| Средние 1–3: SNIFF-фильтр, раскладка DIAG, `flush_ready` до конца DMA | Согласен, только железо | — | **за владельцем**: `WIDE`, `Q`, `LOST`, вход/выход SNIFF; три строки DIAG между y = 382 и точками страниц; нет сбросов по сторожевому таймеру при постоянной перерисовке |
| Средний 4: `SNIFF_MAX_IDS` 80 | Не менялось; при переполнении новые ID тихо не попадают в таблицу | — | смотреть `IDS` в машине; флаг «таблица полна» — когда понадобится |
| Средний 5: `docs/future` — предложения | Согласен; CS флешки теперь записан, `0x3E9` и PID расхода в документах помечены как неподтверждённые | — | — |

### Ревью Stage C3 (2026-10-10) — статус

Ветка `stage-c`, коммиты `6e98002` (C3-01), `2c281cd` (C3-02), `ab08a11` (тесты дисплея), `8b6d3d6` (C3-03). C3-01 и C3-02 сначала воспроизведены тестами, которые падали на предыдущем коде. Тесты на ПК теперь: OBD 261 (сборка по умолчанию) + 302 (экспериментальная), сниффер 29, дисплей 32 — 0 ошибок; обе прошивки собираются без предупреждений. `OILP_DPID_ENABLE` по умолчанию 0. **На STM32, панели и машине ничего из этого не проверено.**

| Пункт | Изменения | Тест (проходит) | Возможная регрессия | Проверить на железе |
|---|---|---|---|---|
| C3-01 ISO-TP мимо 10-секундного предела | `past_txn_cap()`; путь CF: после предела — отказ транзакции, `CAP` один раз; опоздание N_Cr больше не считается `BAD` | `c3_01_cf_after_cap_rejected`, `…_before_cap_ok`, `…_cap_across_wrap` | ответ, легитимно дошедший позже 10 с, теряется (для наших чтений не ожидается); в режиме `POLL` предел только по времени обработки | `CAP` на DIAG остаётся скрытым |
| C3-02 неудачный возврат узкого фильтра | `can_sniff_set_active()` → bool, `restore_pending`, `can_sniff_service()` (повтор каждые 100 мс из `cluster_app_run`), `WIDE` на DIAG; на SNIFF `FILTER ERR: NOT LISTENING` и повтор входа 1/с | `test_can_sniff.c`: `failed_restore_is_retried`, `restore_retry_is_paced`, `failed_enter_reports`, `enter_while_restore_pending` | запись фильтра в момент восстановления контроллера — тот же цикл, что `obd_check_health()`, но на настоящем FDCAN не проверено | войти/выйти из SNIFF несколько раз: `WIDE` не появляется; при ошибке — исчезает сам |
| (найдено при тестах C3-02) сортировка SNIFF через переход 0 | ранжирование кандидатов по возрасту, не по сырой метке; изменение на тике 0 больше не теряется | `candidates_rank_by_age_wrap`, `change_at_tick_zero_counts` (на старом коде падали) | — | — |
| LCD без тестов | `tests/host/test_lv_port_disp.c` + моки SPI/DMA/LVGL; `host_test.py` берёт `tests/host/mock_<имя>/`; состояние сервиса — в `s_svc` | 11 сценариев: запасной путь OK/ошибка, 3 потери → re-init, неудачный re-init, ошибки при старте, окно CASET/PASET, пропущенное прерывание DMA, слишком большая область | — | `FAULT_TEST 3` на столе |
| (найдено тестом) неудачный re-init не повторялся | `lv_port_disp_service()`: флаг ремонта держится, пока re-init ещё должен состояться | `failed_reinit_retried` (на прежнем коде падал) | при постоянных ошибках SPI — перерисовка раз в секунду и re-init раз в 5 с, как задумано | `R` растёт не чаще раза в 5 с |
| C3-03 обрезка DIAG | `cat()` с ограничением смещения, буфер 160; три строки по ≤ ~40 символов, y = 382; ошибки дисплея вытесняют длинную пробу масла в 3-й строке | (UI на ПК не тестируется; сборка) | раскладка не проверена на панели | нижние три строки DIAG не налезают на точки страниц |
| «Неподтверждённое» давление на DRIVE | плитка `OIL P ?`, пока `OILP_VALIDATED 0` | — | — | подпись помещается в плитку |
| ST7735: восстановление и лишние обновления | не менялось (повтор надписей уже убран в C) | — | — | только если маленький экран зависает |
| Схема, питание, CAN-защита, Si4599, сборка на STM32 у ревьюера | **за владельцем** | — | — | as-built схема и замеры |

### Глубокий аудит Stage C2 (дополнение, 2026-10-10) — статус

Ветка `stage-c`, коммиты `2210d23` (патч 1), `f0078d5` (2), `1f9dbb3` (3), `4f1c04f` (4). D01–D05 сначала воспроизведены тестами на ПК, которые падали на предыдущем коде (6 тестов, 9 проверок), затем исправлены. Тесты: 243 проверки (сборка по умолчанию, `OILP_DPID_ENABLE 0`) и 284 (экспериментальная сборка, `test_oilp_dpid.c`), 0 ошибок; обе прошивки собираются без предупреждений. **На машине и на панели ничего из этого не проверено**, одобрения для поездок по тестам на ПК нет.

| Пункт | Изменённые функции | Тест (проходит) | Возможная регрессия | Проверить в машине |
|---|---|---|---|---|
| Риск 1: `$2C` включён по умолчанию | `cluster_config.h` `OILP_DPID_ENABLE 0`; `tools/build.py -D` → `build-<tag>/` | сборка по умолчанию: мок TX падает на любом `$2C`/`$AA`; экспериментальная — `test_oilp_dpid.c` | давление масла `--`, если ECM отказывает в `$22 A22C` (тогда нужна экспериментальная прошивка на KOEO) | DIAG `OILP 22 …` в обычной прошивке; при `NONE 22/31` — KOEO-сессия с экспериментальной |
| Риск 2: допуск SNIFF и `$2C` в N / без селектора | `policy_sniff_allowed()` (только P), `oilp_standstill()` (P **и** свежие 0 км/ч) | `sniff_fail_closed`, `oilp_define_waits_standstill` | SNIFF больше не открывается в N (поиск по селектору — только из P) | в N и D SNIFF не открывается; из P открывается и закрывается при переключении |
| D01 SNIFF видит не все кадры | `obd_rx_poll()`: `can_sniff_feed()` сразу после проверки типа/DLC | `d01_sniff_sees_every_frame` (было 1 из 4, стало 4 из 4; при выключенном SNIFF 0) | нагрузка CPU на SNIFF при плотной шине (не измерена) | fps на SNIFF выше прежнего, `0x1F5`/`0x7E8` видны в таблице; `Q`/`LOST` при SNIFF |
| D02 `0xFF` оставлял старое давление | `oilp_value()` | `d02_oilp_ff_clears_value` | если `0xFF` на этом ECM — реальное значение, оно не покажется (`RAW FF` на DIAG) | значение `RAW` на KOEO и на ходу; появляется ли `FF` вообще |
| D03 бесконечные NRC 0x78 | `obd_rx_poll()` (продление ≤ `await_start + 10 с`), `obd_poll_tick()` (общий предел), `txn_cap_cnt` | `d03_nrc78_total_cap`, `d03_nrc78_within_cap` | ответ, легитимно ждущий дольше 10 с, будет брошен (для наших чтений не ожидается) | `CAP` на DIAG должен оставаться скрытым (0) |
| D04 частичный групповой ответ закрывал запрос | `req_mode01()` (`await_pids`), `mode01_covers()`, `reply_is_ours(…, complete)` | `d04_grouped_reply_must_cover` | ECU, который сам дробит групповой ответ на несколько SF, будет каждый раз ждать таймаут 150 мс | `LOOP` и частота RPM/скорости не хуже прежнего |
| D05 срок по времени обработки | `arrived_in_time()`; SF/FF/CF/UUDT; дедлайны NRC 0x78 и N_Cr от времени приёма | `d05_late_arrival_not_answer`, `d05_arrival_check_wrap` (переход счётчика через 0) | в режиме опроса без прерывания (`POLL` на SNIFF) правило прежнее — там время приёма неизвестно | `POLL` не горит; MIL не уходит в `--` без причины |
| D06 возраст в SNIFF по времени обработки | `can_sniff_feed(…, rx_ms)` | `d06_sniff_gets_rx_time` | — | порядок «недавно изменилось» на SNIFF после задержек отрисовки |
| D07 восстановление ST7735 | не менялось | — | — | только если на столе маленький экран зависает |
| D08 `FILTER ERR` залипал | `apply_filter()` | (не тестируется на ПК) | — | `FILTER ERR` гаснет после удачного входа в SNIFF |
| C2: MIL без срока по времени | `obd_mil_fresh()`, `MIL_STALE_MS 15 с`; DIAG, полоса тревог, `policy_complete()` | `mil_expires_by_time` | MIL `--` после 15 с без ответа на PID 01 (например, после долгого SNIFF) — это и есть цель | MIL/DTC после выхода из SNIFF возвращаются в течение ~секунд |
| C2: LCD — удачный запасной путь считался ошибкой; неудачный init не повторялся | `disp_flush_cb()`, `lcd_tx()` → bool, `lv_port_disp_init()`, `lv_port_disp_service()` | (на ПК не тестируется; сборка) | лишние повторные init при постоянных ошибках SPI — не чаще раза в 5 с | `SPI …  R F` на DIAG при ошибках; `FAULT_TEST 3` на столе |

### Канонический аудит Stage C (2026-10-10) — статус по пунктам

Всё в ветке `stage-c` (`244eceb`…`b3ba159`), собрано без предупреждений; протокол и решения UI покрыты тестами на ПК: два прогона одного набора, 245 и 207 проверок (с `OILP_DPID_ENABLE` 1 и 0). На железе ничего из этого ещё не проверено.

| Пункт | Статус | Что сделано / что осталось |
|---|---|---|
| A02 / SC-04 метка свежести = время декодирования | исправлен | у каждой записи кольца время приёма из ISR; все метки (метрики, MAP, передача, селектор, `last_rx_ms`) берут его. Тест: кадр, пролежавший 2,4 с, устаревает; мутационная проверка ловит старое поведение |
| A03 / SC-10 запас кольца | сделан замер | максимум заполнения кольца — `Q` в 1-й строке DIAG. Нагрузочный замер в машине (SNIFF + полная перерисовка) — за владельцем |
| C02 / SC-02 `$2C` без ограничений | ограничен | флаг `OILP_DPID_ENABLE`: при 0 `$2C`/`$AA` не отправляются никогда (отдельный прогон тестов падает на любом таком кадре). При 1: `$2C` только на стоянке (свежий P/N или свежие 0 км/ч, «неизвестно» ≠ стоянка), не больше 6 раз за включение, затем `NONE`. `FF` — не показание. После дополнения C2 флаг **по умолчанию 0**; `1` — только отдельная KOEO-сборка (`tools/build.py -D OILP_DPID_ENABLE=1`), `$2C` в ней только в P при свежих 0 км/ч |
| C02 / SC-06 тревоги OIL P без валидации | исправлен | `OILP_VALIDATED 0`: значение показывается, но никогда не окрашивается как тревога; верхних порогов нет (99). Процедура с независимым эталоном — [oil-pressure-test.md](oil-pressure-test.md). В полосу тревог OIL P не входит, решение после реальных цифр |
| §8 «read-only» в vehicle-install.md | исправлен | §3 перечисляет всё, что отправляется, включая временное определение пакета `$2C`; §5 приведён к проверенной таблице сигналов |
| U01 / SC-03 SNIFF открывается при неизвестном состоянии | исправлен | закрыт по умолчанию: только свежий P (после C2 — без N) и нет свежей скорости > 3 км/ч. Проверка и в `cluster_ui_set_page()` для любого вызова; выход с SNIFF при R/D или потере селектора (было с 390d9ec, теперь та же функция). `SNIFF_BENCH_OVERRIDE` для стенда. Тесты |
| U02 / SC-05 `NOMINAL` сильнее, чем проверено | исправлен | `NOMINAL` только когда свежи RPM, ОЖ, масло, ATF, АКБ и MIL; иначе серое `PARTIAL DATA`. Решения в `cluster_policy.h`, тесты |
| U04 / SC-08 АКБ на ST7735 без свежести | исправлен | общая проверка с главным экраном; строка связи `ECM OK` / `NO ECM` / `CAN --` (C05); надписи перерисовываются только при изменении |
| C03 / C04 / SC-09 скорость по одной точке, два источника M_OIL | исправлен | `SPEED_GPS_SCALE` в `cluster_config.h` с пометкой «нужно ещё 3–4 точки по GPS»; температура масла только из DID `0x1154`, чужой PID `0x5C` её не перезаписывает (тест) |
| D02 / SC-07 восстановление LCD | сделан, на панели не проверен | после любой ошибки SPI2 — полная перерисовка (≤ 1/с); после 3 ошибок подряд — сброс и инициализация панели (≤ 1 раз в 5 с), `R` в суффиксе SPI на DIAG; если окно CASET/PASET не установилось, пиксели области не шлются. `FAULT_TEST 3` вносит ошибки для проверки на столе. Сброс самой панели по питанию так не обнаружить |
| A04 серия сбросов | исправлен | `LAST RESET: WATCHDOG x3` — подряд идущие аварийные сбросы, обнуляется после 60 с работы (это и S02 ниже) |
| U06 пороги | частично | OIL P: противоречие шкалы и верхних порогов убрано. Остальные пороги — по-прежнему макет, нужны данные двигателя (S01); гистерезиса нет |
| H01–H04 / SC-01 схема, питание, CAN, Si4599, монтаж | **за владельцем** | as-built схема и BOM, замеры (ток, пульсации, Vgs, температура, прокрутка стартером) |
| SC-11 CI, README, сборка ARM у ревьюера | открыто | локально `tools/build.py` собирает без предупреждений. CI не добавлен: GitHub Actions в приватном репозитории тратит минуты, и workflow отсюда не проверить |
| U05 читаемость на солнце, D01/D03 реальный FPS | **за владельцем** | замеры на машине (`LOOP`, `Q`, `LOST`) |

### Полный аудит 2026-10-10 — статус по пунктам

**Про «откат» Stage C в main:** отката не было. Этапы B и C — отдельные ветки `stage-b` и `stage-c` (C поверх B), они ещё не влиты в `main` и ждут проверки на железе. `main` = прошитая `f0a0844` (+ коммит с обновлением графа graphify). Сравнивать нужно `stage-c` с `main` как «новое» с «прошитым», а не как регрессию.

| Пункт аудита | Статус | Где |
|---|---|---|
| A01 кольцо 64 — магическое число | кольцо 256 (6 KB), потери считаются в `LOST`; реальную частоту кадров измерить | `stage-c` |
| A02 таймауты в тиках | мс-дедлайны (было в C) | `stage-c` |
| A03 `HAL_SPI_ErrorCallback` не считает | считает; отказ старта DMA и отброшенная область — тоже | `stage-c` |
| C01 свежесть BOOST через BARO | BOOST не показывается до реального BARO, свежесть = свежесть MAP | `stage-c` |
| C02 бесполезные PID | убраны (этап B) | `stage-b` |
| C03 «второй сканер — fine» | документация: best effort, не во время программирования ECU | `stage-c` |
| C05 `pid_map[]` устарел | удалён, источник — `obd_poll_tick()` + таблица в CLAUDE.md | `stage-c` |
| UX01 зелёный NOMINAL без данных ECM | `NO ECM DATA` (жёлтый), пока RPM/ОЖ не свежие | `stage-c` |
| UX02 мини-экран показывает 0 | `--` (было в C) | `stage-c` |
| UX03 тревога без причины | сводка называет причину: `CLT 101°C`, `BAT 11.4V`, `MIL ON`, `n DTC` | `stage-c` |
| UX05 SNIFF на ходу | SNIFF только при P/N, сам уходит на DRIVE в R/D | `stage-c` |
| S03 знак у `fmt()` | исправлен | `stage-c` |
| M01 `.ioc` | синхронизирован + прошивка не зависит от регенерации (этап B); проверить Generate Code в CubeIDE | `stage-b` |
| M03 мёртвый код | убран (этап C) | `stage-c` |
| H01–H07 схема, питание, Si4599, CAN-защита, механика | **за владельцем**: нужна as-built схема, модель buck, замеры Vgs. Идея аудита: N-канал того же Si4599 как драйвер затвора P-канала, затем `BACKLIGHT_ACTIVE_LOW 0` | — |
| UX04 мёртвые плитки OIL P / EGT | OIL P: источник найден (PID `0xA22C`), на машине не проверен; EGT — нет источника | `stage-c` |
| S01 пороги без калибровки двигателя | **за владельцем**: нужны реальные нормы (термостат, ATF, АКБ при работающем двигателе) | — |
| S02 повторные watchdog-сбросы | счётчик: `LAST RESET: <причина> xN` | `stage-c` |
| M02/M04 CI, тесты UI/SPI/кнопки | открыто | — |

### Этап 0 дисплея (`b7f9470`) — что смотреть ревьюеру

Закрывает основную часть R2 (а, б, в, д из предложений ниже). План и расчёты: [future/display-upgrade.md](future/display-upgrade.md).

| Изменение | Где | На что обратить внимание |
|---|---|---|
| Flush через DMA: область целиком конвертируется в RGB666 в `tx_buf`, уходит по DMA1 Stream0 → SPI2 TX. `lv_display_flush_ready()` вызывается сразу после старта DMA, поэтому LVGL рендерит следующую область, а суперцикл крутит OBD, пока идёт передача. Следующий flush ждёт окончания предыдущего DMA (не дольше 100 мс, затем `HAL_SPI_Abort`) | [lv_port_disp.c](../Core/Src/lv_port_disp.c) `disp_flush_cb`, `dma_wait`, `HAL_SPI_TxCpltCallback` | `tx_buf` (38 400 Б) лежит в AXI SRAM (`.bss`, RAM_D1), до DTCM DMA1 не достаёт. CS поднимается в колбэке завершения. Обработчики `DMA1_Stream0_IRQHandler`/`SPI2_IRQHandler` определены в этом же файле, а не в `stm32h7xx_it.c`: если включить DMA для SPI2 в CubeMX, будет дубль символа при линковке (это намеренно громкая ошибка) |
| SPI2 18,75 МГц (делитель 8, было 16 = 9,4 МГц), ножки PB13–15 на `GPIO_SPEED_FREQ_HIGH` (было LOW, ~12 МГц) | `spi2_dma_init()` в lv_port_disp.c | Переинициализация `HAL_SPI_Init` после `MX_SPI2_Init`, всё в своём файле, так что регенерация из `.ioc` не откатит. R1 (расхождение `.ioc` и кода) это не чинит: в `.ioc` по-прежнему /32, mode 3, 2LINES. 37,5 МГц не пробовали: панель на проводах ~15 см |
| I-cache и D-cache включены | [main.c](../Core/Src/main.c) USER CODE Init | **Главный риск этапа.** Когерентность: единственный DMA — flush, буфер чистится `SCB_CleanDCache_by_Addr` перед каждой передачей (буфер выровнен на 32 и кратен 32). Запись `fault` в `.noinit` лежит в DTCM, она не кэшируется и переживает сброс. Message RAM FDCAN — память устройства. Любой новый DMA обязан чистить/инвалидировать буферы или жить в некэшируемом регионе MPU |
| `cluster_ui_refresh()` пишет текст и цвета, только если они изменились | [cluster_ui.c](../Core/Src/cluster_ui.c) `ui_text`, `ui_text_color`, `ui_bg_color`, `ui_border_color` | В LVGL 9.3 `lv_label_set_text` и `lv_obj_set_style_*` инвалидируют объект без сравнения. `lv_bar_set_value` и флаг `HIDDEN` уже проверяют изменение сами. Геттер цвета может вернуть унаследованное или тематическое значение, если локального стиля ещё нет; совпало — значит виджет и так выглядит нужным образом. `s_dirty` по-прежнему не используется |
| На DIAG в первой строке `LOOP` — самая долгая итерация суперцикла за последнюю секунду, мс (вместе с `osDelay(5)`) | [app_main.c](../Core/Src/app_main.c) `loop_time_tick`, cluster_ui.c | Это замер, которого просил R2. По расчёту полный кадр на проводе стал ≈197 мс против ≈393 мс, а обычная смена цифр — единицы мс |

Не сделано из R2: (г) приём FDCAN по прерыванию (этап C), поэтому правило «таймауты в тиках» остаётся. Init-команды панели по-прежнему идут блокирующим `HAL_SPI_Transmit` с `HAL_MAX_DELAY` (N6 частично). Таймауты IWDG (~3 с в работе) не ужесточались.

**Ошибка первой прошивки этапа 0 (`b7f9470`), исправлена в следующем коммите.** Экран мигал чёрным и белым и плата перезагружалась каждые ~4 с. Причина: `buf1`/`buf2` были объявлены как `lv_color_t[]`, а в LVGL 9 `lv_color_t` занимает 3 байта при любом формате дисплея. Буферы получились в 1,5 раза больше, LVGL отдавал flush области по 60 строк вместо 40, и конвертация писала 57 600 байт в `tx_buf` на 38 400. Чёрные пиксели (нули) затирали всё после него: `s_dma_tx`, `hspi2`, `st_buf`, `htim6`, `uwTick`. С обнулённым `htim6` обработчик тика не снимал флаг TIM6, началась лавина прерываний, цикл встал, IWDG сбрасывал плату. Старый построчный flush этого не замечал. Исправление: буферы `uint8_t` размером в байтах RGB565 и проверка `n > TX_BUF_BYTES` перед конвертацией. После исправления: 25 с без единого сброса (PR IWDG стабильно 4), ядро в основном в задаче простоя. Нашлось через ST-LINK: снимки PC, PR IWDG как индикатор сброса, бисекция с выключенным D-cache (с включённым отладчик читает RAM мимо кэша и видит устаревшие данные).

Проверка на железе (нужна): панель не мерцает и без артефактов на 18,75 МГц; `LOOP` на DIAG при CAN LOST и при живой шине; OBD-значения в поездке обновляются как раньше; `LOST` на DIAG не растёт.

### Таблица пунктов

| Пункт | Статус | Что сделано / что осталось |
|---|---|---|
| R1 CubeMX drift | исправлен, нужна проверка в CubeIDE | этап B: `.ioc` приведён к коду (FDCAN 4 фильтра + FIFO0 16, стек 16 KB, куча 64 KB, SPI2 mode 0 /16); прошивка больше не зависит от регенерации: `obd_init` восстанавливает раскладку message RAM, `lv_port_disp` задаёт все параметры SPI2, `_Static_assert` на кучу. Проверить: открыть `.ioc` в CubeIDE → Generate Code → `git diff` (ожидается только 2LINES в `spi.c`) |
| R2 перерисовка UI / блокирующий SPI | исправлен, нужен стенд | этап 0 дисплея (`b7f9470`): обновление только изменившегося, SPI 18,75 МГц, DMA, кэши, замер `LOOP`; этап C: приём FDCAN по прерыванию в кольцо 64 кадра, таймауты протокола в мс |
| R3 устаревшие значения | исправлен, пороги подобрать | этап C: у каждой метрики метка времени последнего декодирования и порог (`metric_stale_ms`: RPM/скорость/наддув/селектор 2 с, остальное 15 с — с запасом до замера `LOOP`); устаревшее показывается `--` и не участвует в полосе алертов; MIL/DTC — по 3 попыткам PID 01 |
| R4 давление масла | источник найден, нужна машина | источник — сам ECM, PID `0xA22C`, `A × 4 кПа` (ScanGauge для LWN 2.8): сначала `$22`, при отказе GMLAN `$2C`/`$AA` с ответом UUDT на `0x5E8`. Путь, NRC и сырой байт показаны во 2-й строке DIAG ([oil-pressure-test.md](oil-pressure-test.md)). `0x0C9[2]` оказался младшим байтом оборотов (ECMEngineStatus), `0x1BA[3]` отвергнут — оба кандидата удалены |
| R5 подсветка | программно исправлен, нужен замер | этап C: `backlight_set()` принимает яркость, полярность P-FET в `BACKLIGHT_ACTIVE_LOW`; диагностический 0 убран (электрически при загрузке то же). Открыто: замер Vgs при 0/50/100 %, при необходимости драйвер затвора |
| R6 зависание / watchdog | исправлен, нужен стенд | IWDG сразу после `HAL_Init`, до настройки тактирования (~10 с), в работе ~3 с; проверка стека, запись причины в `.noinit`, `LAST RESET` на DIAG; самотест `FAULT_TEST` |
| R7 ISO-TP SF за границей буфера | исправлен | проверка SF_DL ≤ 7 и ≤ DLC−1; тест |
| R8 владение FC | исправлен | одна диагностическая транзакция за раз (общая на все ECU): новый запрос не уходит, пока текущий не закрыт; ответ матчится по ID + SID + PID/DID, FC только своему FF. Остаётся неустранимое: другой сканер, спросивший ровно то же, неотличим |
| R9 дубли / неотвечающие запросы | исправлен | этап B: `0x5C`, `0x78` и mode 03 убраны из опроса (декодеры остались для чужих ответов); тест `schedule_contents` |
| R10 MIL без данных | исправлен | `--` / NO DATA до ответа PID 01 и после 3 пропусков |
| N1 длина кадров | исправлен | DLC проверяется для каждого ID, ответ mode 01 принимается только целиком; тесты |
| N2 игнор статусов HAL | в основном исправлен | TX запросов и Flow Control (TXF); этап B: отказ настройки фильтров/Start при инициализации — `Error_Handler` (`LAST RESET: HAL ERROR`), отказ Start после bus-off — повтор на каждой проверке (счётчик `start_fail`), отказ фильтра SNIFF — `FILTER ERR` на SNIFF, OBD не останавливается. Открыто: статусы SPI init-команд панели (N6) |
| N3 переполнение RX FIFO | замер | счётчики LOST/BAD/TXF на DIAG — нужен снимок после поездки |
| N5 FF > 64 | исправлен | отвергается до FC; CF только от отправителя FF; тест |
| N6 SPI без таймаута | исправлен | ожидание DMA flush ограничено 100 мс; этап C: все блокирующие передачи обоих дисплеев с таймаутом (10/100/50 мс), abort и счётчик `SPI` на DIAG |
| N8 подписи DTC | исправлен | «EMISSION CODES» (счётчик из PID 01) |
| N10 кнопка | исправлен, нужен стенд | EXTI + счётчик нажатий (A5) |
| N11 нет OEM-индикаторов | снят | экран дополнительный, штатная приборка остаётся |
| A1–A5 (ревью этапа A) | см. выше | A1 исправлен (R8), A2 исправлен, A3 исправлен, A4/A5 — нужен стенд |
| F1–F4 (повторное ревью) | исправлены | одна транзакция за раз; сборка ISO-TP закрывает только свою транзакцию; ожидание после NRC 0x78 до 40 тиков; невалидный ответ не закрывает транзакцию. Четыре теста ревьюера добавлены как есть и зелёные |
| F5 IWDG после тактирования | исправлен | запуск перенесён в USER CODE Init, до `SystemClock_Config` |
| F6 свежесть остальных метрик | исправлен | см. R3 |
| F7 семантика MIL_MAX_MISS | исправлен | `--` после ровно 3 попыток подряд без ответа (таймаут или отказ TX); тест |
| F8 ошибка отправки FC | исправлен | отказ FC прерывает сборку и закрывает транзакцию; тест |
| F9 комментарий FAULT_TEST=2 | исправлен | HardFault записывает причину, сброс делает IWDG через ~3 с |
| F10 состояние планировщика в тестах | исправлен | вынесено в `sched`, тесты сбрасывают |
| F11 кнопка | нужен стенд | — |
| F12 прочее | в основном закрыт | R1, R9 — этап B; R2, R3, R5 (программно), N6 — этап C; потери RX — приём по прерыванию, счётчик `LOST` |
| Мёртвый код | убран | этап C: заглушки `can_gauges`/`ui_dashboard`, неиспользуемые функции SNIFF, `s_dirty` |

---

Состояние на коммит `f9635ab` (2026-08-23), ветка `main`. Документ составлен по чтению кода, `docs/`, заметок с выездов и истории git. Я **не собирал** прошивку (на машине, где писался обзор, нет тулчейна STM32CubeCLT) и **не запускал её на железе**.

> Важно: последний коммит `f9635ab` в сообщении помечен как «Built clean … NOT yet flashed». Текущий `main` в машине ещё не проверялся. Последняя прошивка, которую реально гоняли, — `1d56fd2`.

---

## 1. Что это

Прошивка самодельного **дополнительного** экрана для **Toyota Land Cruiser 100** (1998–2007) **со свапом Holden Colorado RG 2.8 Duramax** (дизель, ECM **E98** и его АКПП). Данные — с ЭБУ Colorado; салон (заглушки кнопок, предохранители, подсветка) — тойотовский. Штатная приборка остаётся на месте со всеми обязательными индикаторами (уточнено у автора после составления обзора).

- **MCU:** STM32H743VIT6 на плате WeAct MiniSTM32H743. FreeRTOS (CMSIS-RTOS2), HAL, LVGL 9.3.
- **Источник данных:** HS-CAN 500 кбит/с через OBD-II разъём и трансивер SN65HVD230. Прошивка задумана как «только чтение»: ничего не пишет и не стирает коды (mode 04 не используется). Но это **активный узел шины**: она сама шлёт запросы OBD (mode 01/03/22) к ECM и TCM, как сканер.
- **Дисплеи:**
  - основной 4" **ILI9488** 320×480 на SPI2, страницы DRIVE / DIAG / SNIFF;
  - встроенный в плату 0.96" **ST7735** 160×80 на SPI4, отладочный экран статуса. Его SPI/GPIO настроены вручную в коде, мимо `.ioc`.
- **Ввод:** одна кнопка KEY (PC13). Короткое нажатие листает страницы, удержание 3 с переключает режим «яркость».
- **Подсветка 4":** ШИМ TIM1_CH1 (PA8) на модуль с MOSFET Si4599 (P-канал, ключ по плюсу).

Проект одиночный: пуш прямо в `main`, без PR, без CI и без тестов. Большая часть коммитов сделана с Claude Code, поэтому в репо есть `CLAUDE.md` с инструкциями для агента. Он местами устарел (см. §7).

**Объём собственного кода:** около 2 900 строк C в `Core/`, без сгенерированного CubeMX и без шрифтов. Вендорные `Drivers/` (HAL, CMSIS) и `Middlewares/` (FreeRTOS, LVGL) лежат в репо целиком.

**История:** 66 коммитов с 2026-07-15 по 2026-08-23. Основная работа шла 15–24 июля, затем один коммит 23 августа.

---

## 2. Что работает в машине (по заметкам с выездов)

| Сигнал | Откуда | Статус |
|---|---|---|
| Обороты | mode 01 PID `0x0C` | ✅ работает |
| Наддув | PID `0x0B` (MAP) − PID `0x33` (баро) | ✅ работает |
| Скорость | PID `0x0D` × 60/67 | ✅ читается. Поправка на GPS снята по **одной точке** (60 по GPS = 67 на экране). Перенос в быструю полосу опроса на машине **не проверен** |
| ОЖ, IAT, нагрузка, рейка, АКБ | PID `0x05`, `0x0F`, `0x04`, `0x23`, `0x42` | ✅ работают |
| Температура масла | DID `0x1154` на 0x7E0 | ✅ правдоподобно. В то же поле пишет и PID `0x5C`, но он на этом ECM не отвечает |
| Температура ATF | DID `0x1940` на **0x7E2** | ✅ работает, `A − 40` |
| Передача (номер) | DID `0x199A` на 0x7E2 | ✅ но это включённая передача, а не положение селектора: P тоже даёт 1 |
| Селектор P/R/N/D | широковещательный кадр `0x1F5`, байт 3 | ✅ найден через страницу SNIFF |
| MIL и число DTC | PID `0x01` | ✅ |
| Список DTC | mode 03 | запрашивается, но ответ **игнорируется** |
| EGT | PID `0x78` | ❌ ECM не отвечает, но всё ещё опрашивается |
| **Давление масла** | PID `0xA22C` у ECM: `$22`, иначе `$2C FE A22C` + `$AA 01 FE` → `0x5E8` `[FE][A]`, `A × 4 кПа` | ⚠️ **на машине ещё не проверено**. Прежние кандидаты мертвы: `0x1BA[3]` не следует за оборотами, `0x0C9[2]` — младший байт RPM |
| Сажевый фильтр (сажа, ΔP, регенерация) | — | удалено из кода: на этом ECM данных нет |

Подробности: [enhanced-dids.md](enhanced-dids.md), [oil-pressure-test.md](oil-pressure-test.md), [sniff-selector.md](sniff-selector.md), заметки с выездов в `design/Photos/*/SESSION_NOTES*.md`.

---

## 3. Архитектура

### Поток управления

Вся логика крутится в одной задаче FreeRTOS, по сути это суперцикл. Прерываний от FDCAN нет, приём идёт опросом.

```
StartDefaultTask (freertos.c, стек 16 KB)
├─ AppMain_Init()                         app_main.c
│   ├─ LED PE3, кнопка PC13
│   ├─ lv_port_disp_init()                lv_init + ILI9488 на SPI2
│   ├─ cluster_app_init()                 cluster_ui_build() + obd_init() (фильтры FDCAN, старт)
│   ├─ st7735_status_init()               второй дисплей на SPI4
│   └─ старт ШИМ подсветки
└─ for (;;) { AppMain_Run(); osDelay(5); }
    ├─ heartbeat_led_tick(), автомат жестов кнопки
    ├─ lv_timer_handler()                 рендер + БЛОКИРУЮЩИЙ SPI flush обоих дисплеев
    ├─ cluster_app_run()                  cluster_app.c
    │   ├─ obd_rx_poll()                  вычитать RX FIFO0, декодировать → g_obd
    │   ├─ obd_poll_tick()        ≥25 мс: отправить ОДИН OBD-запрос
    │   ├─ obd_watchdog_tick_1hz()  1 с: can_ok = false, если шина молчит > 1 с
    │   └─ cluster_ui_refresh()   ≥40 мс: переписать все виджеты из g_obd
    └─ st7735_status_*()         ≥250 мс
```

Данные идут в одну сторону: ECM/TCM → FDCAN1 → `obd_rx_poll()` → декодеры → глобальная структура `g_obd` → UI. Поток один, гонок нет; `volatile` у `g_obd` по сути лишний, но не мешает.

### Модули

| Файл | Строк | Роль |
|---|---|---|
| [cluster_config.h](../Core/Inc/cluster_config.h) | 195 | Доменная модель: ключи метрик, пороги и цвета (`metrics[]`), CAN ID, флаг `OBD_DEMO` |
| [fdcan_obd.c](../Core/Src/fdcan_obd.c) | 550 | OBD-II поверх FDCAN: фильтры, планировщик запросов, ISO-TP, декодеры, состояние шины, демо-сценарий |
| [cluster_ui.c](../Core/Src/cluster_ui.c) | 903 | LVGL UI: построение 3 страниц, полоса алертов, рамка тревоги на весь экран, `cluster_ui_refresh()` |
| [can_sniff.c](../Core/Src/can_sniff.c) | 338 | Пассивный детектор изменений на шине для страницы SNIFF: им искали селектор и давление масла |
| [app_main.c](../Core/Src/app_main.c) | 171 | Инициализация, суперцикл, кнопка, светодиод, подсветка |
| [lv_port_disp.c](../Core/Src/lv_port_disp.c) | 178 | Драйвер ILI9488: init-последовательность, flush с конвертацией RGB565 → RGB666 построчно |
| [st7735_status.c](../Core/Src/st7735_status.c) | 281 | Второй дисплей через встроенный драйвер LVGL |
| [cluster_app.c](../Core/Src/cluster_app.c) | 29 | Связка OBD ↔ UI, частоты вызовов |
| `can_gauges.c`, `ui_dashboard.c` | 3 | Пустые заглушки от старой реализации |

CubeMX-файлы (`main.c`, `gpio.c`, `spi.c`, `tim.c`, `fdcan.c`, `freertos.c`, `stm32h7xx_*`) — шаблонный код плюс правки (см. находку R1).

### Ключевые соглашения (их легко сломать)

1. **NaN = «шина это значение ещё не присылала».** Все float в `g_obd` стартуют с `NaN`, UI рисует их как `--`. Подставлять 0 по умолчанию нельзя: неподдерживаемый PID нарисует правдоподобную ложь вроде «0 В на АКБ».
2. **Таймауты считаются в тиках опроса, а не в миллисекундах.** Одна итерация цикла может длиться сотни мс из-за блокирующего flush. Дедлайн по `HAL_GetTick()` истекал до следующего `obd_rx_poll()`, и все многокадровые ответы ISO-TP молча терялись ([fdcan_obd.c:50-58](../Core/Src/fdcan_obd.c#L50-L58)).
3. **Каждый ответ mode 01 должен помещаться в один кадр CAN** (≤7 байт полезной нагрузки). Отсюда пары PID в запросах и чередование MAP/скорости в быстрой полосе ([fdcan_obd.c:424-445](../Core/Src/fdcan_obd.c#L424-L445)).
4. **Flow Control отправляется только на свой запрос** (`await_resp_id`), чтобы не мешать второму сканеру на той же шине.
5. **SNIFF ставит OBD-опрос на паузу.** Широкий фильтр забивает тот же RX FIFO, поэтому сниффинг включается только при видимой странице SNIFF.

### Планировщик запросов (`obd_poll_tick`)

Один запрос за тик (тик — не чаще раза в 25 мс, фактически раз за итерацию цикла):

- **FAST** (~62 % тиков): RPM в каждом тике, вторым PID по очереди MAP и скорость.
- **MEDIUM** (каждый 3-й тик, ~31 %): по кругу 7 запросов — рейка+АКБ, ATF, передача, температуры (`0x05`/`0x5C`/`0x0F`), MIL, mode 03, нагрузка+баро.
- **SLOW** (каждый 16-й тик, ~6 %): DID `0x1154` (масло) и PID `0x78` (EGT).

### Фильтры FDCAN

Из 4 стандартных фильтров ([fdcan_obd.c:350-422](../Core/Src/fdcan_obd.c#L350-L422)): `0x7E8–0x7EA` (ответы ECU), `0x1F5` (селектор), `0x5E8` (UUDT-пакеты ECM — ответ на `$AA` за давлением масла); четвёртый слот свободен. Остальное отбрасывается. SNIFF на время работы переключает фильтр 0 на весь диапазон `0x000–0x7FF`.

---

## 4. Сборка, прошивка, инструменты

- Проект **STM32CubeIDE** (Eclipse `.project`/`.cproject`), не CMake. Конфигурация периферии лежит в [Dash.ioc](../Dash.ioc).
- Сборка из CLI возможна через makefile, который генерирует CubeIDE в `Debug/`. Но `Debug/` в `.gitignore`, поэтому **в свежем клоне собрать без CubeIDE нельзя**. Инструкции и подводные камни описаны в [CLAUDE.md](../CLAUDE.md) (главное: всегда `make all`, голый `make` делает clean).
- Прошивка и отладка через ST-LINK ([Dash.launch](../Dash.launch)); для VS Code есть `.vscode/`.
- `OBD_DEMO` в `cluster_config.h` включает 40-секундный синтетический сценарий для проверки на столе. Сейчас стоит `0`, как и нужно для машины.
- `graphify-out/` — граф знаний о коде для Claude Code. Он **устарел**: собран на `558e291`, на 4 коммита раньше HEAD. `.claude/settings.json` вешает хуки, которым нужен CLI `graphify`. Для ревью всё это не требуется.

---

## 5. Находки ревью

Отсортированы по важности. Номера строк даны для `f9635ab`.

### Высокий приоритет

**R1. Перегенерация из CubeMX молча сломает прошивку.** Ключевые параметры правились прямо в сгенерированном коде вне блоков `USER CODE`, а `.ioc` остался со старыми значениями:

| Параметр | В `.ioc` | В коде | Что будет после «Generate Code» |
|---|---|---|---|
| SPI2 direction | `2LINES` | `1LINE` ([spi.c:42](../Core/Src/spi.c#L42)) | откат режима |
| SPI2 CPOL/CPHA | mode 3 | mode 0 ([spi.c:44-45](../Core/Src/spi.c#L44-L45)) | по комментарию в коде, клон ILI9488 работает только в mode 0, то есть дисплей, вероятно, погаснет |
| SPI2 prescaler | /32 (4,7 МГц) | /16 (9,4 МГц) ([spi.c:47](../Core/Src/spi.c#L47)) | flush станет вдвое медленнее |
| FDCAN `StdFiltersNbr` | не задан (0) | 4 ([fdcan.c:55](../Core/Src/fdcan.c#L55)) | фильтры не установятся |
| FDCAN `RxFifo0ElmtsNbr` | не задан (0) | 16 ([fdcan.c:57](../Core/Src/fdcan.c#L57)) | приём умрёт полностью (комментарий: «was 0 → nothing could be received») |
| Стек `defaultTask` | 1024 слова (4 KB) | 16 KB ([freertos.c:55](../Core/Src/freertos.c#L55)) | вернётся переполнение стека, которое уже раз «молча вешало цикл» |
| `configTOTAL_HEAP_SIZE` | 40960 | 65536 ([FreeRTOSConfig.h:72](../Core/Inc/FreeRTOSConfig.h#L72)) | куча уменьшится |

Предложение: занести эти значения в `.ioc` и перегенерировать, проверив diff. Либо явно объявить `.ioc` мёртвым и написать об этом в README/CLAUDE.md.

**R2. UI каждые 40 мс перерисовывает всё подряд, а вывод на экран блокирующий и медленный.** Скорее всего, отсюда растут ноги у большинства обходных решений в OBD-коде.

- `cluster_ui_refresh()` безусловно вызывает `lv_label_set_text()` и `lv_obj_set_style_*()` для всех виджетов ([cluster_ui.c:668-897](../Core/Src/cluster_ui.c#L668-L897)). В LVGL 9.3 оба вызова инвалидируют объект **без сравнения со старым значением** (проверено по `lv_label.c:133`, `lv_obj_style.c:275`). Скрытые страницы пропускаются, но всё видимое перерисовывается на каждом обновлении.
- Флаг `s_dirty` выставляется в `obd_on_update()`, но **нигде не читается** ([cluster_ui.c:104](../Core/Src/cluster_ui.c#L104), [:900](../Core/Src/cluster_ui.c#L900)).
- Когда видна рамка тревоги (любой CRIT **или CAN LOST**), ей каждый раз заново ставится `border_color`. Это инвалидирует **весь экран 320×480**.
- Flush идёт через `HAL_SPI_Transmit` построчно, без DMA, на 9,375 МГц. Полный кадр — 460 800 байт, то есть **≈390 мс только на передачу**.
- Итог: суперцикл стоит сотни миллисекунд, причём дольше всего в момент, когда шина ещё не поднялась (горит CAN LOST). Отсюда в OBD-коде таймауты в тиках, запрет многокадровых ответов и 10-секундная задержка скорости, которую чинили переносом PID в быструю полосу.
- Что предлагаю, по возрастанию трудозатрат: (а) обновлять текст и стиль, только если значение изменилось (кэш на виджет) или хотя бы по `s_dirty`; (б) поднять частоту SPI и скорость GPIO (сейчас `GPIO_SPEED_FREQ_LOW`, [spi.c:104](../Core/Src/spi.c#L104)); (в) flush через DMA; (г) приём FDCAN по прерыванию в кольцевой буфер, чтобы приём не зависел от рендера; (д) включить I-cache: сейчас кэши выключены, SYSCLK 225 МГц.
- Это вывод из кода и расчёта. **Стоит замерить** длительность итерации на железе, например дёргая GPIO.

**R3. Нет признака устаревших данных по каждому сигналу.** «Живость» — это один флаг `can_ok`, и его поддерживают **широковещательные кадры** `0x1F5`, `0x1BA`, `0x0C9` ([fdcan_obd.c:275-308](../Core/Src/fdcan_obd.c#L275-L308)). Если ECM перестанет отвечать на OBD (второй сканер, сессия программирования, наши запросы теряются), а broadcast продолжится, то скорость, обороты и ОЖ **замрут на последних значениях и будут показываться как живые**. Например, ОЖ застынет на 88 °C, пока реальная температура растёт. Предложение: метка времени на каждое поле и `--` после N секунд без обновления.

**R4. Плитка OIL P на DRIVE показывает непроверенную догадку.** Сейчас это `0x0C9[2] / 36` ([fdcan_obd.c:301-308](../Core/Src/fdcan_obd.c#L301-L308)), и при < 0,4 бар плитка красная. Два замечания:
- По открытым описаниям GMLAN (по памяти, **не проверял**) кадр `0x0C9` обычно несёт **обороты двигателя в байтах 1–2**. Если это так, байт 2 — младший байт RPM. Он и выглядит как «широкий диапазон 0x27..0xFF». Дешёвая проверка: на DIAG сравнить `(b1·256 + b2)/4` с живыми оборотами.
- Давления масла нет в полосе алертов ([cluster_ui.c:837-847](../Core/Src/cluster_ui.c#L837-L847)), поэтому настоящее падение давления не включит красную рамку. Пока источник не подтверждён, это даже правильно, но решение стоит принять явно.

**R5. Подсветка: ШИМ работает наоборот, и в коде остался диагностический ноль.**
- `BACKLIGHT_DUTY_PCT 0u` с пометкой «DIAGNOSTIC… Revert to 100u» ([app_main.c:12](../Core/Src/app_main.c#L12)), а комментарии всё ещё говорят про IRF520.
- Ключ — P-канальный по плюсу: PA8 LOW = подсветка горит ([vehicle-install.md §5](vehicle-install.md)). Таймер же настроен как PWM1 с полярностью HIGH ([tim.c:62-64](../Core/Src/tim.c#L62-L64)), и `backlight_set(pct)` ставит pct % времени в HIGH. В итоге реальная яркость ≈ 100 − pct: в режиме «яркость» нажатие «+10 %» делает экран темнее, а «100 %» на маленьком экране означает, что подсветка выключена. Мигание светодиода с кодом уровня тоже перевёрнуто.
- Аппаратная гипотеза, требует проверки: если исток P-FET сидит на 5 В, а затвор качается 0–3,3 В, то в «выключенном» состоянии Vgs ≈ −1,7 В. Этого может не хватить, чтобы транзистор закрылся полностью. Тогда диммирование будет слабым или его не будет вовсе. Обычно ставят NPN/N-FET, который тянет затвор, и подтяжку к 5 В.

**R6. Зависание замораживает последний кадр на экране.** Нет IWDG. `Error_Handler()` — это `__disable_irq(); while(1);`. Проверка переполнения стека FreeRTOS не включена (`configCHECK_FOR_STACK_OVERFLOW` не задан), хотя такое переполнение уже случалось. ILI9488 хранит кадр в своей памяти, так что при любом зависании на приборке **навсегда остаются последние правдоподобные цифры**. Это ровно та «правдоподобная ложь», с которой проект борется через NaN. Предложение: IWDG, который сбрасывается из суперцикла, `configCHECK_FOR_STACK_OVERFLOW 2` с хуком, а в `Error_Handler` — по возможности гасить подсветку.

### Средний приоритет

**R7. Чтение за границей буфера в ISO-TP Single Frame.** `len = d[0] & 0x0F` может быть до 15, а `dispatch(&d[1], len)` читает из 8-байтового `d[]` на стеке ([fdcan_obd.c:322-325](../Core/Src/fdcan_obd.c#L322-L325)). Сработает только на кривом кадре, но исправление в одну строку: отбрасывать `len > 7`.

**R8. Защита Flow Control смотрит только на ID ответа.** `reply_is_ours()` сравнивает ID, но не содержимое запроса. Если второй сканер получает многокадровый ответ на `0x7E8`, пока мы ждём свой ответ от того же ECM, наш FC всё равно уйдёт. Сейчас риск мал, потому что многокадровыми бывают только ответ на `0x78` (его нет) и mode 03 с большим числом кодов. Но документация ([vehicle-install.md](vehicle-install.md)) обещает больше, чем код гарантирует.

**R9. В одно поле пишут два источника, и опрашивается то, что не отвечает.**
- `g_obd.oil` пишут PID `0x5C` ([fdcan_obd.c:155](../Core/Src/fdcan_obd.c#L155)) и DID `0x1154` ([:185](../Core/Src/fdcan_obd.c#L185)). Сейчас `0x5C` не отвечает, но если он появится, по экрану не понять, откуда пришло значение.
- `0x5C` и `0x78` подтверждённо не отвечают, но остаются в ротации. mode 03 запрашивается, хотя ответ `0x43` игнорируется ([fdcan_obd.c:215](../Core/Src/fdcan_obd.c#L215), [:497](../Core/Src/fdcan_obd.c#L497)). Это лишняя нагрузка на шину и потерянные слоты опроса.

**R10. DIAG показывает «MIL OFF» без данных.** `d.mil` по умолчанию `false`, и текст `OFF` рисуется, даже когда `live == false` ([cluster_ui.c:721](../Core/Src/cluster_ui.c#L721)). Мелочь, но противоречит принципу NaN.

### Низкий приоритет и гигиена

- **Мёртвый код:** заглушки `can_gauges.*` и `ui_dashboard.*`; функции `can_sniff_top`, `can_sniff_top_ids`, `can_sniff_get`, `can_sniff_frame_count` не вызываются; таблица `pid_map[]` нигде не используется и уже разошлась с кодом (в ней `0x5C` и EGT как рабочие); не используются `OBD_REQ_TCM`/`OBD_RESP_TCM`; `s_dirty` (см. R2).
- **Слепое пятно SNIFF:** кадры `0x1F5`, `0x1BA`, `0x0C9` обрабатываются до `can_sniff_feed()` и в сниффер не попадают ([fdcan_obd.c:275-317](../Core/Src/fdcan_obd.c#L275-L317)).
- Поправка скорости 60/67 вшита в декодер и снята по одной точке GPS. Её стоит вынести в `cluster_config.h` и подтвердить ещё парой скоростей.
- `fmt()` теряет минус у отрицательных значений с одним знаком после запятой (−0,4 → «0.4»). Сейчас таких метрик нет.

---

## 6. Что сделано хорошо

- Соглашение NaN = «нет данных» последовательно проведено от декодера до UI и задокументировано, включая причину.
- Комментарии объясняют **почему**, со ссылками на конкретные выезды и симптомы. По ним можно восстановить историю каждого решения.
- Учтён второй сканер на шине (FC только на свои запросы), есть восстановление после bus-off и счётчики переполнения FIFO и состояния шины на экране.
- Неизвестные сигналы ищут методично: страница SNIFF с ранжированием по числу значений и по размаху, затем проверка через корреляцию с оборотами на снимках. Каждый выезд задокументирован фотографиями и разбором.
- Есть демо-режим со сценарием, чтобы проверить всю визуализацию без машины.

---

## 7. Устаревшая документация (расходится с кодом)

- [CLAUDE.md](../CLAUDE.md): «3-page DRIVE / DPF / DIAG» и «4-page … DPF(1)» — на деле 3 страницы, DRIVE / DIAG / SNIFF. В таблице сигналов селектор PRNDL числится как «no known identifier», хотя он найден (`0x1F5`); давления масла и поправки скорости там нет.
- [vehicle-install.md §5](vehicle-install.md): там написано, что EGR `0x6B` опрашивается (нет) и что «всё по J1979 работает как есть», включая масло `0x5C` и EGT (не работают).
- [enhanced-dids.md](enhanced-dids.md): сажа `0x336A` помечена «✅ confirmed — SOOT 8 %», а коммит `b92b875` удалил DPF, потому что «this E98 never answered». Одно из двух неверно.
- Комментарии в коде: [app_main.c:52](../Core/Src/app_main.c#L52) («DRIVE → DPF → DIAG»), IRF520 в `app_main.c`, заголовок [cluster_ui.c](../Core/Src/cluster_ui.c#L12) (DPF), заголовок `fdcan_obd.c` (0x7E1/0x7E9 вместо 0x7E2/0x7EA). Комментарий к фильтру 2 в [fdcan_obd.c:379-392](../Core/Src/fdcan_obd.c#L379-L392) говорит, что `0x1BA` питает `oil_press` (уже нет), и ссылается на несуществующий `OILP_BCAST_ENABLED`.
- `graphify-out/` собран на `558e291`.

---

## 8. Вопросы автору

1. `.ioc` ещё считается источником истины для периферии, или перегенерацию забросили? От ответа зависит, как чинить R1.
2. Как на самом деле ведёт себя подсветка при 0 %, 50 % и 100 % в коде? Меряли напряжение на затворе и истоке?
3. Сажевый фильтр: «SOOT 8 %» из `enhanced-dids.md` реально был или это ошибка документа?
4. Когда источник давления масла подтвердится, должно ли низкое давление включать красную рамку на весь экран?
5. Нормально ли, что приборка в движении постоянно шлёт запросы ECM с частотой цикла? Были ли проблемы с другими блоками или дилерской диагностикой?

---

## 9. В каком порядке читать

1. [cluster_config.h](../Core/Inc/cluster_config.h) — доменная модель и CAN ID.
2. [fdcan_obd.h](../Core/Inc/fdcan_obd.h) → [fdcan_obd.c](../Core/Src/fdcan_obd.c) — самая содержательная часть.
3. [cluster_app.c](../Core/Src/cluster_app.c) и [app_main.c](../Core/Src/app_main.c) — как всё крутится.
4. [cluster_ui.c](../Core/Src/cluster_ui.c), функции `cluster_ui_refresh()` и `set_metric()`.
5. [lv_port_disp.c](../Core/Src/lv_port_disp.c) — функция `disp_flush_cb()`, причина R2.
6. [can_sniff.c](../Core/Src/can_sniff.c) — по желанию, инструмент для стенда.
7. `docs/` и `design/Photos/*/SESSION_NOTES*.md` — контекст с машины. Визуальный эталон UI: `design/Diesel_Cluster_v2_3.html`.
