Pcfccn/Dash/docs/bench-first-flash.md

# Первая прошивка stage-c: чек-лист

**Статус:** 2026-10-23 на столе образ `ROAD` `7d0acf9` (тег `flashed-7d0acf9`, `main`): stage-c, TRIP / PERF, журнал во флешке, палитра под TN, полужирный текст, полоса только с тревогами, проба DPF на DIAG. По ST-LINK сбросов нет, на столе экраны посмотрены глазами. **В машине ещё не был** — §6. Последний образ, который ездил, — `flashed-1d56fd2`.

**2026-10-26, ревью C8:** в `main` исправления — одометр больше не считает дважды, PERF и одометр видят потерю GPS, удержание ● в режиме яркости ничего не сбрасывает, проба давления масла / DPF / карт PID не сдаётся, пока ECM молчит. Тесты на ПК и сборки чистые, **на железе ещё не прошито** — перед машиной прошить новый образ и пройти §1.

В `stage-c` всё, что сделано после прошлой прошивки (`flashed-f0a0844`):

- GPS;
- кнопки ▶ ● ◀ и день/ночь;
- карты PID;
- восстановление обоих экранов;
- тревоги с выдержкой;
- метка образа;
- правки ревью C4–C7.

Здесь — что прошить, что должно быть на экранах и что записать. Порядок:

1. стол сейчас;
2. DEMO;
3. сбросы;
4. GPS;
5. плата-носитель;
6. машина.

Если что-то не так — фото DIAG и маленького экрана, и откат (§7).

## 0. Какой образ шить

| Железо / задача | Сборка | Файл | Метка (DIAG внизу справа, ST7735 первые 10 с) |
|---|---|---|---|
| **Сейчас:** макетка, подсветка — затвор Si4599 прямо от PA8 | `python tools/build.py` | `build/Dash.elf` | `ROAD` |
| Плата-носитель с 2N7000 | `python tools/build.py -D BACKLIGHT_ACTIVE_LOW=0` | `build-backlight_active_low_0/Dash.elf` | `ROAD INV` |
| Стол без машины: цвета и тревоги | `python tools/build.py -D OBD_DEMO=1` | `build-obd_demo_1/Dash.elf` | `BENCH DEMO` (жёлтым) |
| Проверка сбросов, n = 1…4 | `python tools/build.py -D FAULT_TEST=n` | `build-fault_test_n/Dash.elf` | `BENCH FTn` |
| Прежняя палитра, для сравнения с TN-палитрой | `python tools/build.py -D UI_PALETTE_TN=0` | `build-ui_palette_tn_0/Dash.elf` | `ROAD PAL0` |
| Модуль перевёрнут на 180° | `python tools/build.py -D LCD_FLIP=1` | `build-lcd_flip_1/Dash.elf` | `ROAD FLIP` |
| Какой контроллер у экрана: 4 с полос при старте ([display-upgrade.md](future/display-upgrade.md) §0) | `python tools/build.py -D LCD_PROBE=1` | `build-lcd_probe_1/Dash.elf` | `ROAD PROBE` |

**Прошить** — STM32CubeProgrammer (из CubeCLT или отдельно), ST-LINK по SWD:

```
STM32_Programmer_CLI -c port=SWD -w build/Dash.elf -v -rst
```

Можно и из CubeIDE (`Dash.launch`), но CubeIDE собирает свою конфигурацию Debug: это всегда образ по умолчанию, а на DIAG вместо хэша будет `IDE`. Варианты с `-D` — только через `tools/build.py`. В CubeIDE перед первой сборкой нажать Refresh: появились новые файлы `alert.c`, `gps*.c`, `input.c`.

**Слева внизу на DIAG** — коммит, из которого собран образ. `+` после хэша значит, что исходники отличались от коммита.

## 1. Стол сейчас: WeAct + 4" на макетке, KEY, без машины и GPS

Образ `ROAD`.

1. **Светодиод на WeAct (PE3).** Мигает — цикл идёт, это главное.
   - Не горит вовсе — не дошло до `AppMain_Init`.
   - Горит постоянно — завис init дисплея.
   - После загрузки мигает кодом яркости: число вспышек = уровень / 10, потом длинная пауза.
2. **ST7735, первые 10 с:** внизу `ROAD` (или `ROAD INV` для образа под 2N7000), потом `P0 KEY0 #0`. Выше:
   - `SPEED km/h --`;
   - `RPM --`;
   - `CAN --` (красным);
   - `B --`;
   - `t Ns` (секунды растут).
3. **Главный экран:** страница DRIVE, в полосе сверху `CAN LOST`, красная рамка по краю. **Без машины так и должно быть.**
4. **KEY коротко** → TRIP → PERF → DIAG → STATS → DRIVE. SNIFF пропускается: нет свежего селектора в P. Так и задумано, страница закрыта «на отказ».
   - **TRIP** без машины и GPS: счётчики `0.0` (или сохранённые), `SPEED FROM -- (no speed)`, внизу `MEMORY: EMPTY #0` или `MEMORY: OK #n`. `MEMORY: NO FLASH` — флешка WeAct не ответила, пробег и яркость не сохраняются: сказать мне.
   - **PERF** без GPS: `NO GPS`, все времена `--`.
   - **На STATS в шапке** `FOR m:ss  LOOP n  MEM a/b%`. **MEM** — занятость памяти LVGL сейчас / в пике. Записать. Если пик выше ~85 % — сказать мне: при нехватке памяти плата уходит в перезагрузки.
   - Строки сигналов без машины — прочерки и `0`.
5. **DIAG:**
   - **Вверху** `LAST RESET: POWER ON` / `RESET PIN` / `SOFTWARE` серым — норма. Жёлтым (`WATCHDOG`, `HARDFAULT`, `ASSERT …`, `HAL ERROR`, `STACK OVERFLOW`) — сбой, сфотографировать. `xN` значит N аварийных перезагрузок подряд.
   - **Внизу:** слева хэш, справа `ROAD`.
   - **Строка 1** `NRC -- LOOP n Q0`. **Записать LOOP** — самую долгую итерацию цикла за секунду, мс. Отдельно — значение LOOP сразу после перелистывания страницы (полная перерисовка ~200 мс по проводу).
     - Если модуль CAN к PD0 / PD1 не подключён, вывод RX висит, передача не видит свои же биты и узел уходит в bus-off. Тогда примерно через минуту строка 1 целиком меняется на `BUS-OFF x5: TX OFF, CHECK CAN WIRING` (ревью C9: после пяти bus-off подряд узел только слушает до перезапуска). **Без трансивера это нормально.** LOOP тогда читать в шапке STATS. С модулем CAN, но без машины, этого быть не должно: там запросы кончаются ошибкой ACK, а она до bus-off не доводит.
   - **Строка 2** `LOST 0 BAD 0 TXF n GPS -`. **Без шины `TXF` и `TXL` (в строке 1) растут — это нормально:** запросы некому подтвердить. В машине должны стоять на 0 или почти.
   - **Строка 3** каждые 4 с меняется, пять видов по кругу 20 с: `OILP …` → `PID 00:-------- …` → `60:… 5E?` → `DPF SOOT …` → `DPF OK …`. Без ECM — прочерки.
6. **Яркость:**
   - KEY держать 3 с — на ST7735 `DAY` и `100%`;
   - каждое короткое нажатие +10 %, после 100 — снова 10 %;
   - 4" должен заметно меняться, светодиод — менять число вспышек;
   - через 5 с без нажатий режим выходит сам;
   - удержание ● в режиме яркости ничего не сбрасывает (на TRIP, PERF, STATS — тоже).
7. **День / ночь:** перемычка **PE15 (P2.38) → GND**. Через ~0.6 с (фильтр от дребезга и ШИМ реостата) яркость плавно уходит на 30 % — ещё ~0.7 с, в режиме яркости подпись `NIGHT`. Снять перемычку — обратно на дневной уровень. Уровни сохраняются во флеш WeAct и переживают выключение (с 2026-10-22). Включить плату с перемычкой — подсветка сразу на ночном уровне, без вспышки 100 %.
8. **Кнопки ▶ ● ◀**, если уже подключены. Это PE7 / PE8 / PE9 = P2.30 / P2.31 / P2.32, замыкание на GND.
   - ▶ — следующая страница, ◀ — предыдущая.
   - В режиме яркости ▶ даёт +10 %, ◀ и ● дают −10 %.
   - Неподключённые выводы сами не срабатывают: внутренние подтяжки.
9. **10–15 минут просто включённым:** картинка не замирает, светодиод мигает, `t` на ST7735 растёт, `LAST RESET` после этого не поменялся.

## 2. Образ DEMO: цвета и тревоги без машины

`-D OBD_DEMO=1`. Внизу DIAG `BENCH DEMO` жёлтым, справа в полосе `DEMO` (с тревогой — `DEMO ⚠ …`).

Сценарий идёт по кругу 40 с:

| Время в цикле | Что на экране |
|---|---|
| 0–12 с | крейсер: числа белые, полосы шкал зелёные, меток в полосе нет |
| 12–20 с | R: оранжевая рамка и оранжевая `R` |
| 20–26 с | P |
| 26–40 с | температура ОЖ растёт 88 → 108 °C |

Что проверить — тревоги с выдержкой (`alert.c`):

- жёлтый на ОЖ (и метка `CLT` в полосе) появляется **примерно через 2 с** после 93 °C, а не в момент перехода;
- красный и рамка — **примерно через 1 с** после 97 °C;
- когда в начале цикла ОЖ падает обратно на 88, красное держится ещё **~3 с** и гаснет сразу в норму;
- АКБ (14.1 В) оценивается только через 3 с после «запуска», обороты ≥ 500.

После проверки — прошить обратно `ROAD`.

## 3. Проверка сбросов (FAULT_TEST)

Прошить `-D FAULT_TEST=n`, держать KEY **10 с**. Через 3 с включится режим яркости — это не мешает, держать дальше.

| n | Что делает | Ожидание |
|---|---|---|
| 1 | цикл зависает | через ~3 с перезагрузка, DIAG: `LAST RESET: WATCHDOG` жёлтым |
| 2 | HardFault | перезагрузка, `LAST RESET: HARDFAULT` |
| 3 | ошибки SPI главного экрана, без перезагрузки | пока держите: экран перерисовывается, не чаще раза в 5 с переинициализируется. В строке 3 DIAG (в первом из пяти сменяющихся видов, где обычно `OILP`) — `SPI n/0 Rm`; этот вид на экране 4 с из каждых 20. Отпустить — работает дальше |
| 4 | `configASSERT(0)` | перезагрузка, `LAST RESET: ASSERT fault.c:<строка>` |

- Повторить один и тот же пункт подряд — должно стать `x2`.
- Через минуту нормальной работы серия сбрасывается.

После всех — прошить обратно `ROAD`.

## 4. Когда придёт GPS (ATGM336H)

**Подключение:**

| Модуль | WeAct |
|---|---|
| VCC | **только 3V3** (P2.41) |
| GND | GND |
| TX | PA3 (P2.20) |
| RX | PA2 (P2.19) |

Антенну — к окну или на улицу. Если на плате GPS есть PPS, он пока не нужен.

**Что видно на DIAG (строка 2, после `GPS`):**

| Показание | Что значит |
|---|---|
| `?` | ищет модуль: слушает 115200, потом 9600. При первом включении он на 9600; прошивка сама переключит его на 115200 / 10 Гц и один раз сохранит это в модуль |
| `V0`…`V5` | модуль слышен, фикса нет, число спутников. Первый холодный фикс на улице — до нескольких минут |
| `9/0.0` | фикс: спутники / скорость, км/ч |
| `-` | модуля нет на обеих скоростях: проверить TX ↔ RX (часто перепутаны), 3V3, землю |

`O<n>` после поля GPS — потерянные байты. Должно не появляться; если появляется — записать вместе с LOOP.

## 5. Когда будет плата-носитель

Что куда паять — по шагам: [assembly.md](future/assembly.md); общая картинка — [wiring-overview.svg](future/wiring-overview.svg). Сборка и прозвонка — [carrier-board.md](future/carrier-board.md) §6 и [build-hardware.md](future/build-hardware.md) §5.

Образ — **`ROAD INV`** (`-D BACKLIGHT_ACTIVE_LOW=0`). В первые 10 с ST7735 должен показать `ROAD INV`.

- Если главный экран тёмный, а на ST7735 `ROAD` — прошит не тот образ.
- Дальше — яркость 0 / 50 / 100 %: подсветка меняется в ту же сторону, ключ не греется.

**С этого момента каждый образ для этой платы — с `-D BACKLIGHT_ACTIVE_LOW=0`**, иначе главный экран тёмный: KOEO — `-D OILP_DPID_ENABLE=1 -D BACKLIGHT_ACTIVE_LOW=0` (`BENCH KOEO INV`), DEMO — `-D OBD_DEMO=1 -D BACKLIGHT_ACTIVE_LOW=0`. В VS Code — варианты с `INV` в «Build + flash image variant». Задача `Flash (ST-LINK)` и F5 шьют образ CubeIDE по умолчанию, то есть **без** `INV`: для этой платы ими не пользоваться.

## 6. Первый раз в машине

Подключение — [vehicle-install.md](vehicle-install.md) §4 (60 Ом на CAN, ключ на ON, потом пуск). Разветвитель OBD2 1 → 2 есть: Dash и сканер можно держать одновременно. Образ — `ROAD` на макетке, **`ROAD INV` на плате-носителе**: внизу DIAG коммит не старше исправлений C8 (§ «Статус»).

**Как читать верхнюю полосу.**

| Полоса | Что значит |
|---|---|
| пустая | данные полные, тревог нет |
| метки `CLT` `ATF` `BAT` `MIL` `DTC` `CAN` … жёлтым / красным, справа самая серьёзная с показанием | тревога по этим системам; красная рамка по экрану — критическая |
| `PARTIAL DATA` | тревог нет, но не все нужные значения приходят |
| `NO ECM DATA` | кадры на шине есть, ECM не отвечает |
| `CAN LOST` | шины нет |

Число без цвета — норма или параметр, который никто не оценивает. Голубое — двигатель холодный (< 50 °C), жёлтое — внимание, красное — авария.

### 6.1 Ключ на ON, двигатель заглушён — фото

- ST7735: `ECM OK` зелёным.
- DIAG: `LAST RESET` без `xN`; `LOST`, `BAD`, `TXF`, `TXL` — 0 или единицы.
- **Все пять видов строки 3 DIAG** (меняются каждые 4 с, круг 20 с):
  - `OILP …` — проба давления масла;
  - `PID 00/20/40` и `60/80/A0 5E…` — что ещё отдаёт этот ECM, в том числе есть ли расход топлива (`0x5E`);
  - `DPF SOOT … DP … REGEN … KM …` — сажевый фильтр: сажа %, перепад, идёт ли регенерация, км после неё (`--` — нет свежего ответа, `Xnn` — ECM отказал с кодом nn, `SIL` — не отвечал и больше не спрашиваем);
  - `DPF OK S…/… P…/… R…/… K…/…` — сколько наших запросов к каждому параметру получили ответ. По этим счётчикам решим, делать ли метку DPF в полосе.
- Полоса: через несколько секунд после включения — **пустая**. В первые секунды может стоять `PARTIAL DATA`: температура масла (`0x1154`) спрашивается в медленном слоте и приходит не сразу. АКБ с заглушённым двигателем не оценивается, метки `BAT` быть не должно.

### 6.2 Давление масла — по желанию, только стоя в P

Отдельный образ `BENCH KOEO`: на макетке `python tools/build.py -D OILP_DPID_ENABLE=1 --flash`, на плате-носителе `python tools/build.py -D OILP_DPID_ENABLE=1 -D BACKLIGHT_ACTIVE_LOW=0 --flash` (`BENCH KOEO INV`). Порядок — [oil-pressure-test.md](oil-pressure-test.md). Потом вернуть `ROAD` / `ROAD INV`. Если давление подтвердится, ячейка `OIL P ?` станет настоящим датчиком.

### 6.3 Пуск

- Dash питается от ACC, а у Тойоты ACC на время прокрутки (START) обычно отключается — плата перезагрузится. После пуска `LAST RESET: POWER ON` серым, без `xN` — это норма. Жёлтый `LAST RESET` или `xN` — нет: фото.
- Если ACC на прокрутке не пропадает (плата не перезагрузилась), во время прокрутки не должна появиться метка `BAT`: при оборотах прокрутки ниже 500 АКБ не оценивается.
- После пуска полоса пустая; на холодном двигателе температуры голубые.

### 6.4 Поездка — смотрит пассажир, не водитель

- **DRIVE:** скорость, обороты, передача (P/R/N/D + ступень), температуры; цвет только при отклонении.
- **DIAG:** `LOOP` (максимум за секунду), `Q`, `TXL`; после поездки — снова оба вида `DPF` в строке 3. Если по дороге началась регенерация (обороты холостого выше, вентилятор, запах) — фото вида `DPF SOOT …`: `REGEN` должен стать `ON`.
- **TRIP:** пробег растёт; строка `SPEED FROM GPS` (без GPS — `OBD x SCALE`); `MEMORY: OK #n` — номер растёт, пока едем (запись раз в секунду).
- **PERF** (только с GPS): после остановки на 1 с — `READY - GO`. Замер разгона — только там, где это безопасно и законно.
- **Спидометр:** 40 / 60 / 80 / 100 км/ч ровным ходом, хотя бы по минуте на каждой (STATS, внизу; нужен GPS).
- **Экран днём:** читается ли с места водителя, бликует ли, двоится ли ещё.

### 6.5 Выключить и включить зажигание

TRIP / A / TOTAL те же — они в журнале во флешке. Если машина стояла больше 30 минут и GPS поймал время, TRIP обнуляется сам — так задумано.

### 6.6 В конце — фото всех страниц, особенно STATS

STATS копит с включения. Удержание ● 2 с на ней сбрасывает статистику: например, после прогрева, чтобы видеть только поездку. В шапке `MEM сейчас/пик` — куча LVGL. На ПК в 32-битной сборке пик 57 % (`python tools/ui_render.py --m32`); если на плате больше 85 % — сообщить.

| Столбец | Что значит |
|---|---|
| `N` | сколько раз пришёл сигнал |
| `P95` | 95 % интервалов между приходами не длиннее этого, мс — по нему настраивается свежесть (`metric_stale_ms`, сейчас «с запасом» 2 / 15 с) |
| `GAP` | самый длинный перерыв. Сюда попадают и паузы, пока открыт SNIFF или ECM молчит, поэтому смотреть надо `P95` |
| `MIN..MAX` | диапазон за поездку — сверить с порогами тревог |

**Внизу STATS — спидометр против GPS** по диапазонам скоростей:
- `1.000` — показывает верно;
- `0.980` — показывает на 2 % больше, чем на самом деле;
- **строка `ALL`** даёт текущую поправку `SCALE` и новую. Подставлять её в `SPEED_GPS_SCALE` (cluster_config.h) только если диапазоны между собой близки, иначе ошибка не пропорциональная.

Считаются только ровная скорость от 40 км/ч и GPS с ≥ 6 спутниками.

**SNIFF** — только стоя в P. Ничего не нажимать на ходу.

## 7. Потом

Фото — мне. По ним:
- свежесть (`metric_stale_ms`) по `P95`;
- поправка `SPEED_GPS_SCALE`;
- есть ли источник расхода (`5E`);
- отвечают ли параметры DPF стабильно (счётчики `DPF OK`) — тогда метка DPF в полосе при высокой саже и во время регенерации;
- пороги тревог по `MIN..MAX`.

**Если в машине что-то сломалось** — фото DIAG и маленького экрана, затем откат. Рабочую копию не переключать: старый образ собирается в отдельном дереве git. Путь — короткий (у Windows предел длины пути, глубокий каталог ломает сборку LVGL).

- **Макетка (Si4599 от PA8):** последний образ, который ездил, — `flashed-1d56fd2`. В нём ещё нет `tools/build.py`, поэтому взять сегодняшний (проверено 2026-10-26: собирается без предупреждений):
  ```
  git worktree add C:/Temp/dash-1d56fd2 flashed-1d56fd2
  copy tools\build.py C:\Temp\dash-1d56fd2\tools\
  cd C:/Temp/dash-1d56fd2
  python tools/build.py --flash
  ```
  Этот образ не знает кнопок ▶ ● ◀ (только KEY) и не показывает коммит на DIAG.
- **Плата-носитель (2N7000):** `flashed-1d56fd2` на ней — тёмный экран (флага `BACKLIGHT_ACTIVE_LOW` тогда не было) и без кнопок. Откат — на последний прошитый `flashed-7d0acf9`, в нём `tools/build.py` уже есть:
  ```
  git worktree add C:/Temp/dash-7d0acf9 flashed-7d0acf9
  cd C:/Temp/dash-7d0acf9
  python tools/build.py -D BACKLIGHT_ACTIVE_LOW=0 --flash
  ```

Вернуться — в основной рабочей копии (`main`): `python tools/build.py --flash` (на плате-носителе — с `-D BACKLIGHT_ACTIVE_LOW=0`). Дерево отката убрать: `git worktree remove C:/Temp/dash-…`.
