Pcfccn/Dash/docs/sniff-selector.md

# SNIFF capture — selector / PRNDL search

Transcribed from the two in-vehicle SNIFF runs (`design/Photos/1/` and `/2/`,
2026-07-21). Firmware: full-payload watch view (commit `dce35ed`), so each row
is `ID  b0 b1 b2 b3 b4 b5 b6 b7  age`. Bus was healthy throughout: **48 fps**,
`ERRPASS` + rising `L` overflow count are expected on the promiscuous filter and
do not affect reception.

Goal: find the byte that tracks the gear selector (P R N D M 1 2 3).

---

## Run 1  (design/Photos/1/, frames 023–035)

```
frame  ID   b0 b1 b2 b3 b4 b5 b6 b7   (fps/ids/lost)
023    1AA  00 66 06 64 6A 00 00 00    48 / 50 / L505
       135  00 00 00 02 00 00 00 00
       1BA  16 B3 6B 46 63 65 36 5F
       19D  C0 00 3F FD 01 00 00 FF
       1F5  0F 0F 00 01 00 00 03 00
       0F9  00 00 40 00 00 00 00 FF
       1A1  00 10 05 00 5C 5C 00 00
       1C3  06 A0 06 53 00 00 00 00
024    1F5  0D 0D 00 03 00 00 03 00    49 / 50 / L491
       0F9  79 FD 40 00 00 00 00 FF
       1A1  00 10 45 00 5C 5C 00 00
       19D  80 00 3F FE 01 00 00 FF
025    1F5  0D 0D 00 03 00 00 03 00    48 / 50 / L477
       1A1  00 10 05 00 5C 5C 00 00
       0F9  00 00 40 00 00 00 00 FF
026    1F5  0D 0D 00 04 00 00 03 00    48 / 48 / L464
       0F9  07 A3 40 00 00 00 00 FF
       1A1  00 10 45 00 5C 5C 00 00
027    1F5  0D 0D 11 04 00 01 03 00    48 / 48 / L453
       0F9  07 A3 40 00 00 00 00 00
028    1F5  0D 0D 12 04 00 01 03 00    48 / 48 / L441
       0F9  04 74 40 00 00 00 00 00
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

### Conclusion

**The selector frame is `0x1F5`, byte 3.** It takes exactly four values and steps
them in sweep order across both runs (start 01 → up → back to 01):

```
1F5.3 = 01  →  P   (rest position at start & end of every sweep)
1F5.3 = 02  →  R
1F5.3 = 03  →  N
1F5.3 = 04  →  D
```

While in D (`b3=04`), **`1F5` byte 2** carries the manual/commanded gear
(`0x11/0x12/0x13` ≈ manual 1/2/3) and **byte 5** is a "manual mode" flag — that
is where the tap-shift positions live, not in byte 3.

**0F9 is ruled out**: its changing bytes (0 and 1) sweep a wide continuous range
(00…FD) — a 16-bit sensor value, not the small fixed code set a selector has.

Confidence: high on `1F5.3` being the PRNDL range and on the P=01…D=04 order
(clean 4-value staircase, matches the physical detent order); medium on the
byte-2 manual-gear codes. The distinct-value "candidates" view (commit `d0b338d`,
already flashed) will confirm the exact map in one slow sweep — `1F5.3` should
list `01 02 03 04` in swept order.

### Next

1. One slow sweep on the candidate view to lock `1F5.3` and the byte-2 map.
2. Decode `0x1F5` (listen-only, no request needed — it is broadcast) and render
   real P/R/N/D on the DRIVE page in place of the gear number.
