Pcfccn/Dash/design/Photos/20260722_21/photo_1_2026-07-21_22-55-05.jpg

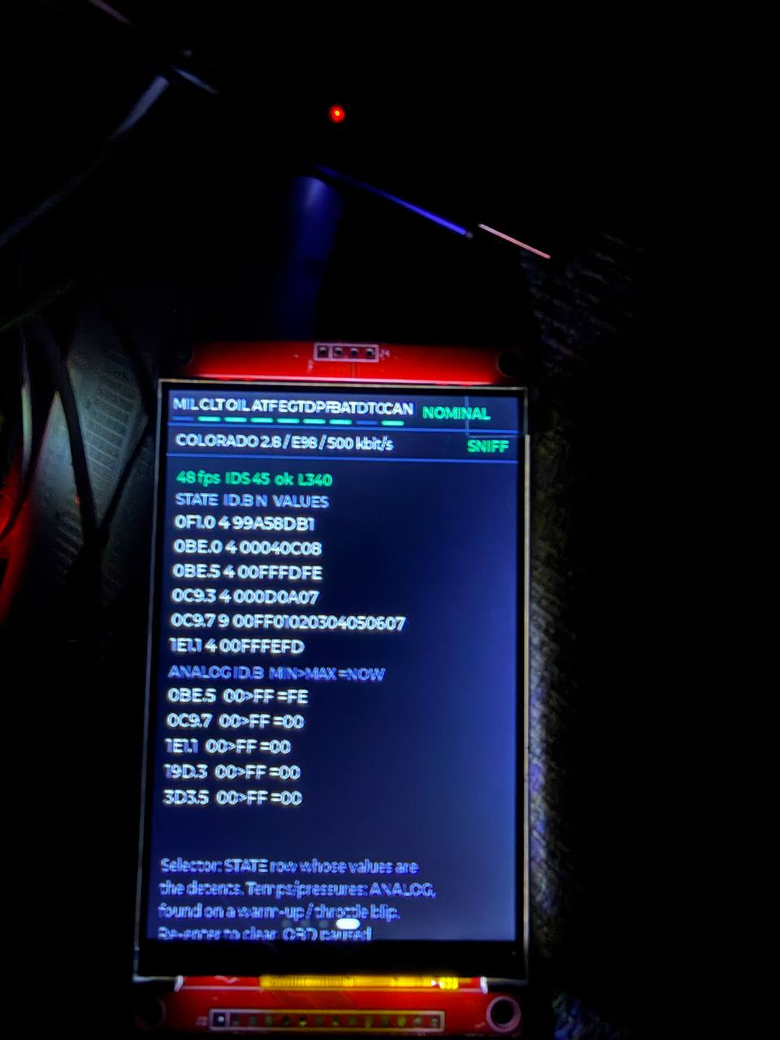
design/Photos/20260722_21/photo_1_2026-07-21_22-55-05.jpg
