Pcfccn/Dash/design/Photos/20260722_21/photo_3_2026-07-21_22-55-06.jpg

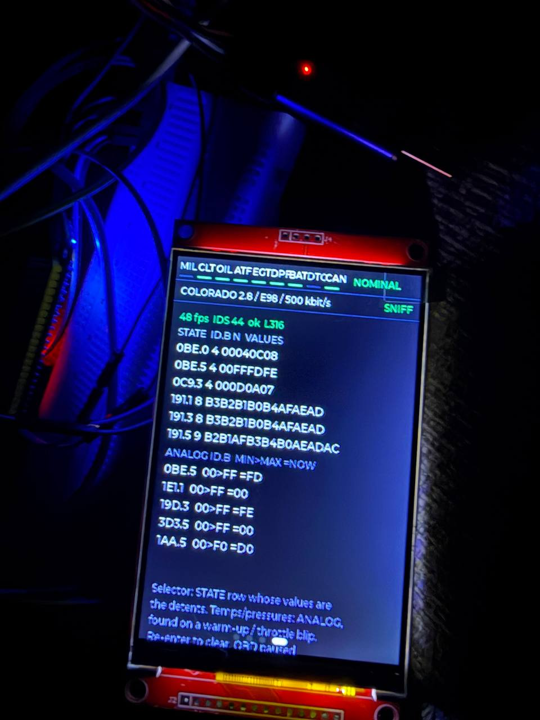
design/Photos/20260722_21/photo_3_2026-07-21_22-55-06.jpg
