Pcfccn/Dash/design/Photos/20260723_9/photo_5407021963907111625_y.jpg

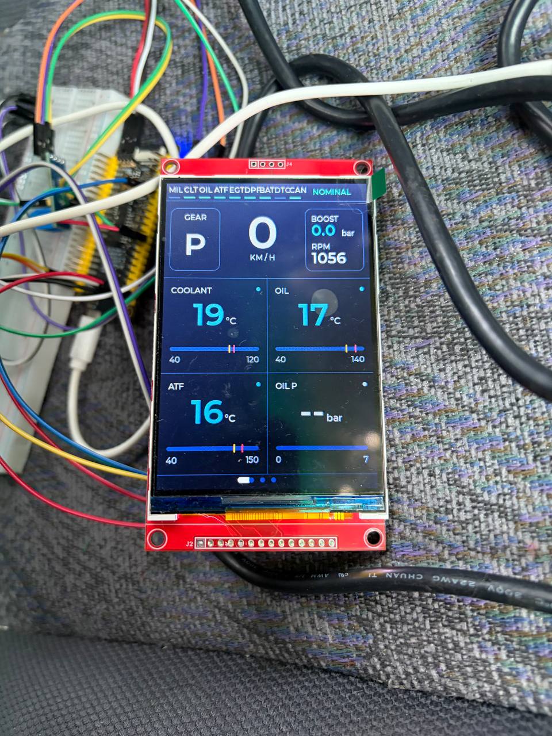
design/Photos/20260723_9/photo_5407021963907111625_y.jpg
