Pcfccn/Dash/design/Photos/20260724_9/photo_5411108204382459439_y.jpg

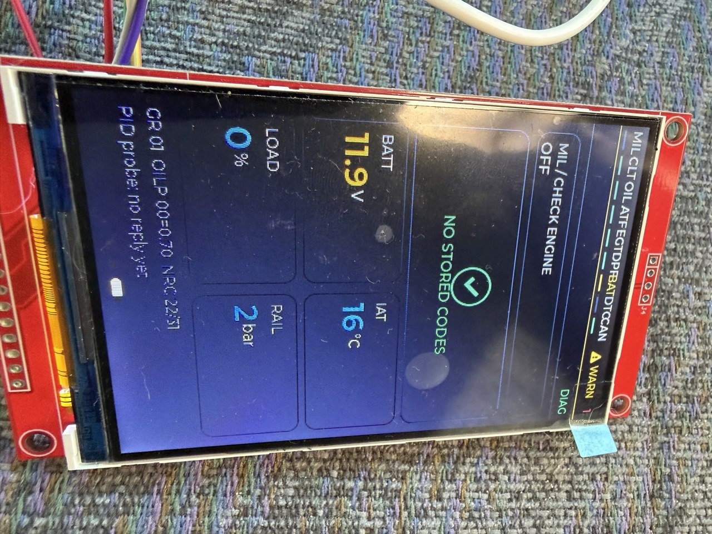
design/Photos/20260724_9/photo_5411108204382459439_y.jpg
