Pcfccn/Dash/design/Photos/20260724_9/photo_5411108204382459448_y.jpg

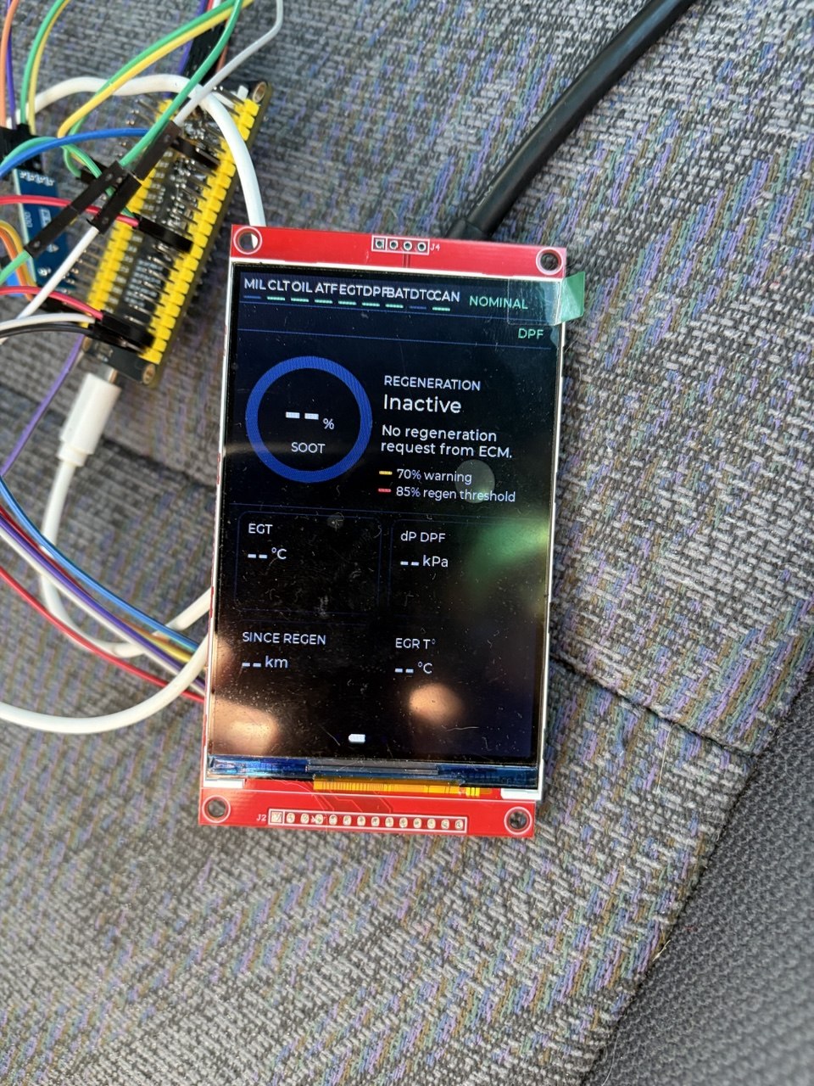
design/Photos/20260724_9/photo_5411108204382459448_y.jpg
