Pcfccn/Dash/design/Photos/20260724_9/photo_5411108204382459456_y.jpg

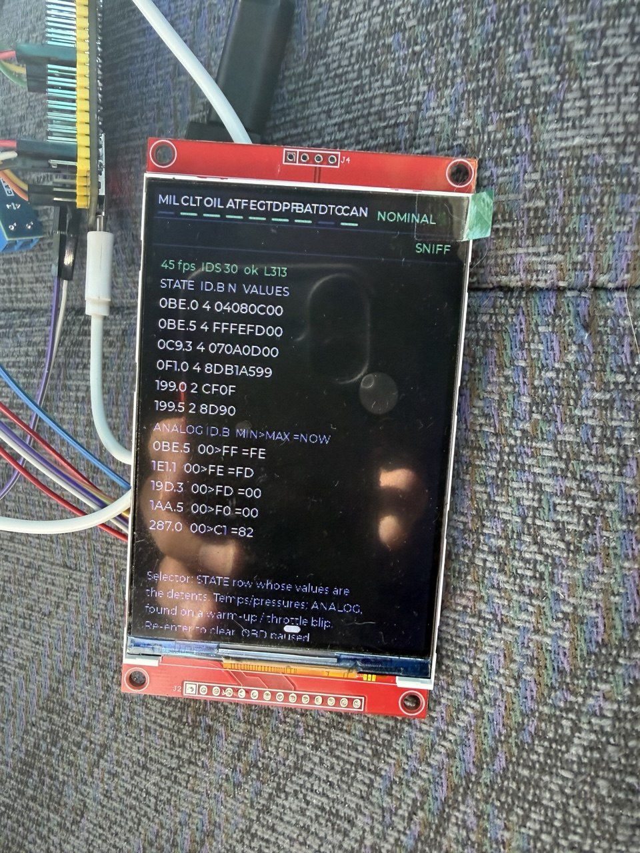
design/Photos/20260724_9/photo_5411108204382459456_y.jpg
