Pcfccn/Dash/design/Photos/20260823/photo_13_2026-08-23_19-55-01.jpg

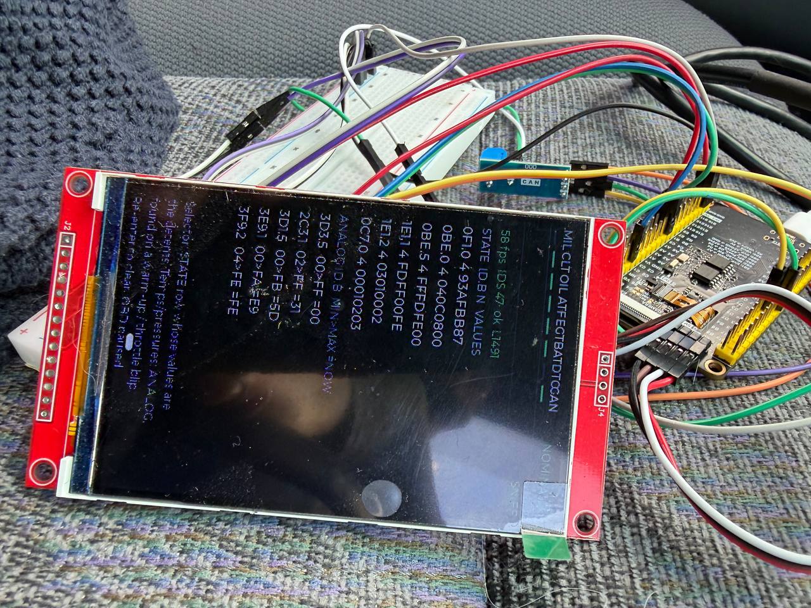
design/Photos/20260823/photo_13_2026-08-23_19-55-01.jpg
