Pcfccn/Dash/docs/vehicle-install.md

# In-vehicle install — from bench demo to a live car

How to take this cluster off the desk (USB-powered, `OBD_DEMO 1`) and run it in
the car — a Toyota Land Cruiser 100 with a Holden Colorado RG 2.8 Duramax swap
(the CAN data is the Colorado ECU's; fuses, switch blanks and illumination are
Toyota's) — for real: powering the WeAct board from the car, tapping
the HS-CAN bus through the SN65HVD230, and the bring-up sequence.

> **Firmware prerequisite:** `OBD_DEMO` in `Core/Inc/cluster_config.h` must be
> `0` (real CAN). It is now 0. With demo on, the screens show synthetic values
> and the CAN transceiver is never actually read.

---

## 1. Powering the board in the car

> **The build as chosen (2026-10):** a PD65W-type module (8–30 V in) feeds the
> WeAct's **USB-C**, with a TVS and a 2 A fuse, from the **ACC wire tapped
> directly** (no add-a-fuse), ground to a body bolt — see
> [build-hardware.md](future/build-hardware.md) §2/§3 and
> [harness.md](future/harness.md). On USB-C the 5 V rail sits behind D10:
> expect ~4.6–4.8 V on the header `5V` pins, not 5.0. Toyota's ACC usually
> drops during START, so the board restarts on every crank (`LAST RESET:
> POWER ON` without `xN` afterwards is normal). The rest of this section is
> the general background and the alternative of a buck on `V+`.

The WeAct MiniSTM32H743 wants **3.3–5.5 V** on its 5 V/USB input (onboard DC-DC,
~1 A). The car's electrical system is nominally 12 V but swings **~9 V during
cranking to ~14.8 V charging**, with much larger transient spikes (load dump).
You **cannot** feed 12 V straight in, and you **must** protect against the noise.

**Use a 12 V → 5 V step-down (buck) converter:**

- Pick an **automotive-grade buck** with a wide input range (e.g. 8–40 V in) and
  **≥ 2 A at 5 V** output. The board + 4" ILI9488 + its backlight + the 0.96"
  status panel can pull several hundred mA; 2 A gives headroom.
- A quality **12 V USB car-charger module** (the guts of a car phone charger)
  works and already has automotive input filtering — feed its 5 V/USB into the
  board's USB/5 V.
- Add a **1–3 A inline fuse** on the 12 V feed, as close to the tap as possible.
- Add **reverse-polarity protection** (a series Schottky, or a P-FET ideal-diode)
  if your buck doesn't have it.

**Where to tap 12 V — use IGNITION-SWITCHED power, not constant:**

- Tap a **switched/accessory (ACC) circuit** so the cluster powers down with the
  car. The chosen build taps the ACC wire directly with its own inline fuse
  (harness.md); a fuse-tap ("add-a-fuse") on an ACC fuse in the cabin fuse box
  is the alternative. Make the tap with the key out, and keep clear of the
  yellow SRS harness.
- **Do NOT** power from OBD pin 16 (constant +12 V) for a permanent install — it
  never switches off and will **flatten the battery** over days. (Fine for a quick
  bench/driveway test only.)
- During engine **crank** the rail dips; the board may brown-out/reset on start.
  That's acceptable — it comes back once the alternator is up. If you want it to
  survive cranking, use a buck with a low dropout and a bulk input capacitor.

**Grounding:** one common ground on the board. The supply's ground, the board's
ground, and the SN65HVD230's ground all tie to **vehicle chassis ground** at a body
ground bolt (X1.3), not to OBD pin 4/5. OBD **pin 5** (signal ground) goes to X2.4
as the CAN reference only; **pin 4 is not connected** (harness.md, build-hardware.md
§3). One caveat (review C9): X1.3 + X2.4 make a thin parallel strap between body
and ECM signal ground; build-hardware.md §3 has the optional 47 Ω in X2.4 that
keeps starter current out of it if the engine ground strap ever fails.

**Where the 5 V actually connects on the board — there is NO power jack.** Per the
WeAct V1.2 schematic the power path is:

```
USB-C VBUS ─► D10 (Schottky) ─► 5V rail ─► DC-DC U2 (1-2 A) ─► 3V3 rail
```

Feed the buck's output into the board's supply input:

- Buck **+5 V → the `V+` pin** (next to the DC-DC input caps). This is the entry
  of the **5 V rail** that feeds the regulator; it's the same net as the header
  `5V` pins, so those work too, but `V+`/`GND` is the intended input pair.
- Buck **GND → the `GND`** beside it.
- Supply **5 V (max 5.5 V — DC-DC input limit).** The board makes 3.3 V from it and
  the same 5 V rail feeds the panel backlight.
- The `3V3` pins are the regulator **output** — do NOT inject supply there.
  `VBAT` is RTC backup only (BAT54C), not a power input.
- USB is **diode-isolated** from the 5 V rail by D10, so external 5 V can't
  back-feed the USB port — but run one source at a time. (In the chosen build
  USB-C *is* the supply input and `V+` stays unused.)
- Multimeter sanity check: `V+` ↔ header `5V` = continuity (same rail); `V+` ↔
  `3V3` = none (post-regulator); `V+` ↔ USB-C 5 V = reads through D10 as a diode
  drop (~0.2-0.3 V), NOT a dead short — that's normal.

**Current display wiring (bench, keep it):** the 4" panel's **VCC is on the
board's 3.3 V** and its **backlight is on the board's 5 V**. Feeding the board 5 V
as above reproduces this 1:1 — the board passes 5 V to the backlight and makes
3.3 V for VCC, just like USB does. (This is also why a 3.3 V-only supply won't
work as wired: the backlight would lose its 5 V.)

---

## 2. Connecting to the CAN bus (OBD-II port)

The RG's **HS-CAN** (ISO 15765-4, 500 kbps — what this firmware speaks) is on the
**OBD-II / DLC connector** under the dash:

| OBD-II pin | Signal | Connect to |
|---|---|---|
| **6** | **CAN-H** | SN65HVD230 **CANH** |
| **14** | **CAN-L** | SN65HVD230 **CANL** |
| 4 | Chassis GND | **not connected** (power ground is the body bolt, X1.3) |
| 5 | Signal GND | X2.4 — CAN reference only |
| 16 | +12 V constant | (bench test power only — see above) |

**SN65HVD230 transceiver (3.3 V):**

- **VCC = 3.3 V** — this is a 3.3 V part; do **not** feed it 5 V. Take 3.3 V from
  the board's 3V3 pin.
- **TXD → PD1** (MCU `FDCAN1_TX`), **RXD → PD0** (MCU `FDCAN1_RX`). 3.3 V logic
  both sides — direct wire, no level shifter.
- **Rs pin → GND** for high-speed mode (fine for 500 kbps). Most breakout modules
  handle this on-board.
- Keep **CANH/CANL as a twisted pair** and the stub from the OBD port short.

### Sharing the OBD port with another device

Running this cluster alongside a scan tool / insurance dongle / logger (Y-splitter
or a second tap on pins 6 + 14) works on a best-effort basis — CAN is multi-drop
and this firmware never writes or clears anything, but it is an active tester
too. **Never run it during ECU programming or a dealer tool session**: unplug it
(or keep it on the SNIFF page, which pauses its polling). Two wiring rules:

- **Do not add a termination resistor.** The vehicle already has 2 x 120 Ω (60 Ω
  total). Many SN65HVD230 breakout boards ship with a 120 Ω resistor populated —
  remove/disable it, or the bus impedance drops far enough to cause errors.
- **Keep each stub short** (< ~30 cm); long branches reflect at 500 kbps.

Protocol-wise the firmware tries to stay out of a second tester's way: one
request at a time, and it only answers a multi-frame **First Frame** with Flow
Control when the reply matches its own outstanding request by module, service
and PID/DID (`reply_is_ours()` in `fdcan_obd.c`). A tester asking the very same
thing at the same moment is indistinguishable — test the combination before
relying on it. Without that gate both
readers would send Flow Control for the same transfer and corrupt each other's
multi-frame reads (mode 22 DIDs, mode 03 DTC lists). Single-frame replies are
decoded regardless of who asked, and `decode_mode01()` keys off the echoed PID —
so the other tool's polling transparently feeds these gauges as a bonus.

### ⚠️ Bus termination — the #1 thing to get right

HS-CAN is already terminated by the vehicle: **120 Ω at each end = 60 Ω total**.
Many SN65HVD230 breakout boards ship with **their own 120 Ω resistor on board**.
If you add that as a third terminator you load the bus to ~40 Ω and can cause
bus errors / no comms.

- **Remove or disable the module's 120 Ω resistor** when tapping the live bus.
- **Verify:** ignition OFF, measure resistance CANH↔CANL at the OBD port — a
  healthy bus reads **~60 Ω**. If you see ~40 Ω, your module's resistor is still
  in circuit — take it out.
- **~120 Ω with the module unplugged** (review C9): the bus has only one
  terminator — a swap can lose the second one with a body module that was left
  out — or one has failed. Do not "fix" it with the module's resistor: a
  terminator belongs at the end of the bus, not on a 30 cm stub. Note it, check
  the truck's own CAN (ECM ↔ TCM) for errors with a scan tool, and decide then.
  Dash itself works on a 120 Ω bus; the module's resistor stays off either way.
- **0 Ω / open:** a short in the wiring / the wrong pins (harness.md, X2).

---

## 3. What the firmware sends

It is an **active diagnostic node** (it transmits requests, like any scan tool)
that never writes calibrations, memory or actuators and **never clears codes**
(no mode 04). Requests:

- **Reads:** OBD mode 01 live data and, once per power-up, the ECM's PID
  support maps (mode 01 PIDs `0x00`, `0x20` … `0xC0`); `$22`
  (ReadDataByIdentifier) for the GM DIDs: ATF temp and gear on `0x7E2`; oil
  temp `0x1154`, oil pressure `0xA22C` and the DPF probe (soot `0x336A`, ∆P
  `0x20F4`, regen `0x20F6`, since-regen `0x3039`, one per slow slot) on
  `0x7E0`. Mode 03/07 (DTC lists) is not requested; the DTC count comes from
  PID `0x01`.
- **One volatile configuration, for oil pressure only:** if the ECM refuses
  `$22 A22C`, GMLAN `$2C FE A22C` defines diagnostic data packet `0xFE` in ECM
  RAM (gone at the next ECM reset), then `$AA 01 FE` reads it. This is **not a
  pure read**, so it is **off in the default build** (`OILP_DPID_ENABLE 0` in
  `cluster_config.h`: `$2C`/`$AA` are never sent — host-tested). Only a
  separate KOEO experiment build turns it on, and even then `$2C` goes out
  only with the selector in P and a fresh 0 km/h, at most 6 times per
  power-up. A second tester on the port using DPID `0xFE` may redefine it;
  see `docs/oil-pressure-test.md`.

Do the first power-up **key-on / engine-off (KOEO)** to validate before driving.

---

## 4. Bring-up sequence

1. **Flash** the firmware with `OBD_DEMO 0` (done) via ST-LINK.
2. *(Optional but recommended)* Bench-test CAN first with a USB-CAN adapter or an
   OBD-II simulator, so you know the transceiver + wiring work before the car.
3. In the car, **KOEO**: connect CAN + power (buck on switched 12 V).
   - Check the small status screen: **ECM OK** (green; amber **NO ECM** = frames
     on the bus but the ECM answers nothing), speed `0`, battery **~12.4 V**.
   - If CAN shows `--` (red): re-check termination (60 Ω), CANH/CANL not swapped,
     transceiver VCC = 3.3 V, and PD0/PD1 not reversed.
4. **Verify termination** reads ~60 Ω (ignition off) if you haven't already.
5. **Start the engine**: RPM, coolant, load, MAP/boost, rail pressure and battery
   should come alive on the main 4" cluster.
6. **Road-test** safely (ideally a passenger watches the screen, or parked).

---

## 5. Known gaps for a "complete" in-car build

- **Enhanced metrics.** What this truck answers is the signal table in
  `CLAUDE.md` (verified in the car): ATF temp `0x1940` and gear `0x199A` on
  `0x7E2` work; oil temp comes from DID `0x1154`; EGR temp `0x6B`, EGT `0x78`
  and oil temp `0x5C` are not supported by this E98. **Oil pressure** (PID
  `0xA22C`) is wired but not yet seen in the car — `docs/oil-pressure-test.md`.
  **DPF soot %, ∆P, regen and distance-since-regen** are polled again as a
  DIAG probe (2026-10-23, DIDs from the Astra-K list, `docs/enhanced-dids.md`):
  DIAG line 3 shows the values and answered/asked counts per DID; no gauge or
  alarm until the counts show they answer reliably. (ScanGauge's LWN 2.8 list
  reads them the `$2C`/`$AA` way, as for oil pressure — the fallback.)
- **Main-display backlight polarity.** The Si4599 **P-channel** (high-side)
  MOSFET conducts while PA8 is LOW. `app_main.c` handles that with
  `BACKLIGHT_ACTIVE_LOW 1`: `backlight_set()` takes **brightness** (100 = full,
  PA8 held LOW at boot as before), and brightness mode steps really brighten.
  Still to measure on the bench: gate–source voltage at 0/50/100 %. From a 3.3 V
  pin with the FET source on 4.6–4.8 V (5 V after the WeAct's D10 diode), "off" is
  only Vgs ≈ −1.3…−1.5 V and may not fully
  close the FET, so dimming can be weak; the fix is a small NPN/N-FET stage
  pulling the gate — the carrier board's 2N7000 (build-hardware.md §3), whose
  image is `python tools/build.py -D BACKLIGHT_ACTIVE_LOW=0` (`ROAD INV`).
- **Mounting:** secure the board and modules, insulate exposed pins (no shorts to
  chassis), and keep the LCDs out of direct sun-baked dash heat where possible.

---

## Appendix: full connection & power map

### Power distribution

Everything hangs off the WeAct board. Drawn here for the buck-on-`V+`
alternative; the chosen build feeds the same 5 V net through USB-C and D10
(section 1).

```
Car 12 V  (IGNITION/ACC, inline fuse 2-3 A)
  │
  └─►  12 V → 5 V buck (automotive, ≥ 2 A)
             +5V │              │ GND
                 ▼              ▼
        WeAct pin `5V`     WeAct pin `GND`
        (5 V net after D10: no other protection — one source at a time)
                 │
    ── on the board, already wired ─────────────────────────────
        board passes 5 V ───────────►  4" backlight LED+  (5 V)
        board regulator → 3V3 rail ─►  4" panel VCC        (3.3 V)
                                   └─►  SN65HVD230 VCC      (3.3 V, never 5 V)
                                   └─►  STM32H743 + on-board 0.96" ST7735

GND: one common star ground — buck GND · WeAct GND · display GND · transceiver
     GND · vehicle chassis at a body bolt (X1.3); OBD pin 5 only as the CAN
     reference (X2.4), OBD pin 4 not connected.
```

### Signal wiring (all MCU I/O is 3.3 V logic — do not exceed ~3.6 V on any pin)

| MCU pin | Function | Connect to |
|---|---|---|
| PB13 | SPI2 SCK | 4" ILI9488 **SCK** |
| PB15 | SPI2 MOSI | 4" **SDI/MOSI** |
| PB14 | (SPI2 MISO) | **not wired** — the firmware drives SPI2 TX-only (1-line); `-D LCD_PROBE=1` tells the controller without it |
| PC0 | GPIO | 4" **CS** |
| PC4 | GPIO | 4" **DC/RS** |
| PC5 | GPIO | 4" **RESET** |
| PA8 | TIM1_CH1 PWM | breadboard: **Si4599 gate** (active-LOW, default image); carrier board: **2N7000 gate** through R (`ROAD INV`) |
| PD1 | FDCAN1_TX | SN65HVD230 **TXD/D** |
| PD0 | FDCAN1_RX | SN65HVD230 **RXD/R** |
| — | CAN bus | SN65HVD230 **CANH → OBD pin 6**, **CANL → OBD pin 14** (twisted pair) |
| — | transceiver mode | SN65HVD230 **Rs → GND** (high-speed) |
| PA2 / PA3 | USART2 TX / RX | GPS module **RX / TX** (ATGM336H, 3V3 only) |
| PE7 / PE8 / PE9 | GPIO, EXTI, pull-up | buttons **▶ ● ◀** to GND (1 k series, build-hardware.md §6c) |
| PE15 | GPIO, EXTI, pull-up | parking-light sense (BC547 collector; LOW = lights on) |

**On-board already, nothing to wire:** 0.96" ST7735 status screen (SPI4: SCK PE12,
MOSI PE14, CS PE11, DC PE13, backlight PE10), KEY button (PC13), heartbeat LED (PE3).

### Voltage / current — how much can/should each take

| Node | Feed it | Draw (typical) | Hard limit |
|---|---|---|---|
| 5 V rail (buck out) | 5 V | ~0.4–0.6 A total | size buck ≥ 2 A |
| WeAct board input | 5 V (3.3–5.5 V ok) | — | onboard DC-DC 3V3 rail = **1 A max** |
| STM32H743 (3V3) | 3.3 V (from board) | ~0.2–0.3 A | — |
| 4" panel VCC (logic) | 3.3 V (from board 3V3) | ~20–40 mA | 3.3–5 V |
| 4" backlight | 5 V (from board 5V pin) | ~40–120 mA | — |
| SN65HVD230 VCC | **3.3 V** (from board) | ~20 mA | **3.6 V max — never 5 V** |
| OBD pin 16 (+12 V) | 12 V constant | bench test only, fuse it | drains battery if left on |

Notes:
- As wired now, **everything is fed through the WeAct board** — you only connect
  the buck's 5 V to the board's `5V` pin. The board passes 5 V to the backlight and
  its regulator makes 3.3 V for the panel VCC, transceiver, MCU and ST7735.
- The backlight's 5 V draw passes through the board's `5V`/USB net (not the 1 A
  3V3 DC-DC), so the onboard regulator only carries the 3.3 V loads.
- Backlight PWM sense is inverted (P-FET, PA8 LOW = ON); `BACKLIGHT_ACTIVE_LOW`
  in `app_main.c` compensates, so brightness 100 % holds PA8 LOW. Confirm on the
  bench before wiring in the car.
