Pcfccn/Dash/docs/future/gps-performance-meter.md

# GPS-скорость и замер разгона («свой Dragy»)

**Статус:** замер разгона **реализован** — `perf.c` (страница PERF, тесты `tests/host/test_perf.c`); скорость на DRIVE по-прежнему из OBD. Ниже — исходное исследование; цены и наличие проверены 2026-10-09.

> **Решение 2026-10-11:** модуль — **ATGM336H-6N-74** (LCSC C5804601, $3) с патч-антенной C784398, см. [build-hardware.md](build-hardware.md) §6b. Точность замера 0–100 около ±0.1 с владельца устраивает. Поэтому прошивка разбирает **NMEA** (RMC — скорость и время, GGA/GSA — фикс, число спутников, HDOP), частота 10 Гц, а не UBX NAV-PVT, как в §4–§6 ниже. ~~Время отсчётов берётся из поля времени RMC~~ — сделано иначе: время отсчёта — момент приёма конца строки RMC, метка `HAL_GetTick()` из прерывания UART (`gps_hw.c`, как у кадров CAN). Поле времени RMC с шагом 0.1 с ровнее, но его не с чем сопоставить по шкале платы, а задержка модуля постоянна и в разности времён сокращается. Переход на u-blox M10 (C4153167, ~$11) возможен без переделки платы: тот же корпус, но нужно подключить `VCC_IO` (вывод 7).

**Идея.** Подключить GNSS-модуль к той же плате WeAct и получить:
1. точную скорость на DRIVE вместо OBD-шной;
2. замеры разгона как у Dragy: 0–60, 0–100, 60–100, 100–200 км/ч, 1/8 и 1/4 мили. К каждому заезду прикладываются обороты, наддув и передача из OBD.

---

## 1. Зачем GPS, если есть OBD-скорость

По заезду 2026-08-23 (`design/Photos/20260823/SESSION_NOTES.md`) у OBD-скорости (PID `0x0D`) такие проблемы:
- отставание до ~10 с (частично вылечено переносом в быструю полосу опроса, на машине ещё не проверено);
- завышение ~12 % относительно GPS. Сейчас это компенсирует зашитый коэффициент 60/67, снятый по одной точке;
- шаг 1 км/ч;
- скорость считается по колёсам, поэтому зависит от размера шин и врёт при пробуксовке.

Для замера 0–100 с точностью до сотых нужна скорость по эффекту Доплера от GNSS.

## 2. Аналоги

| Устройство | GNSS | Частота | Прочее | Цена |
|---|---|---|---|---|
| Dragy DRG70-C | u-blox 10-го поколения, 4 системы | до 25 Гц (10/20/25 настраивается) | Расхождение с официальным хронометражем на 1/4 мили ≤ 0.03 с; откат 1 фут по NHRA; показывает уклон | $130–180 |
| RaceBox Mini / Micro | u-blox SAM-M10Q (Micro) | 25 Гц | Акселерометр и гироскоп 1 кГц | — |

## 3. Выбор GNSS-чипа

| Чип | Частота | Комментарий |
|---|---|---|
| **u-blox M10** (SAM-M10Q, MAX-M10S) | До 25 Гц на 1 системе, 20 Гц на 2, 16 Гц на 3, 10 Гц на 4. По даташиту MAX-M10S в режиме по умолчанию: 10 Гц на GPS+Galileo; в high performance mode — 20 Гц | На нём сделаны Dragy и RaceBox. Высокую частоту нужно включать настройкой |
| **u-blox NEO-M9N** | 25 Гц сразу на 4 системах, точность скорости 0.05 м/с | Проще настраивать, но дороже |
| NEO-6M / 7M | ≤ 5–10 Гц | Устарели, не брать |
| ATGM336H (Zhongkewei) | — | Дешёвый, но чувствительность −148 дБм и только NMEA. Не для замеров |

**Оценка точности.** Colorado разгоняется до 100 примерно за 10 с, ускорение около 2.8 м/с². Погрешность скорости 0.05 м/с даёт ≈ 0.02 с на каждом конце замера. С линейной интерполяцией моментов пересечения 0 и 100 км/ч между отсчётами **10 Гц достаточно** (±0.02–0.04 с). 20–25 Гц полезны для 1/4 мили и скорости на финише.

## 4. Интеграция в текущую систему

Отдельного контроллера, экрана и питания не нужно. GPS становится вторым источником данных рядом с CAN:

```
ECM/TCM ─CAN─► obd_rx_poll() ─► g_obd ─┐
                                       ├─► cluster_ui_refresh() ─► DRIVE / PERF / DIAG
GPS ─UART/DMA─► gps_poll() ──► g_gps ──┤
                                       └─► perf_tick() (автомат замера)
```

### Железо
- 4 провода до гребёнки WeAct. По `Dash.ioc` ни один UART не занят. Предлагается **USART2: PA2 = TX → RX модуля, PA3 = RX ← TX модуля**. Запасной вариант — USART3 (PD8/PD9). Ни тот, ни другой не пересекаются с SPI2, SPI4, FDCAN1, TIM1 и периферией на плате (SPI-флешка PB3/PB4/PD7 + CS PD6, QSPI, SD PC8–PC12/PD2 + датчик карты PD4).
- Питание зависит от того, что куплено. **Голый модуль ATGM336H-6N** (выбран) — **только 3V3** с WeAct, 5 В ему нельзя ([build-hardware.md](build-hardware.md) §3 «GPS»). 5 В — только плате со своим стабилизатором: готовой плате ATGM336H, если на ней есть стабилизатор, или своей плате u-blox (вариант C ниже, AP2112). Потребление десятки мА. UART 3.3 В, преобразователь уровней не нужен (перед подключением проверить мультиметром).

### Изменения в прошивке

| Что | Где |
|---|---|
| `gps_ubx.c/.h`: инициализация USART2 и DMA (кольцевой буфер + прерывание IDLE), разбор UBX-NAV-PVT (время эпохи `iTOW`, скорость `gSpeed` в мм/с, точность `sAcc`, `fixType`, `numSV`, высота), настройка модуля при старте. Структура `g_gps` с тем же правилом: `NaN` = нет фикса | новый файл |
| `perf.c/.h`: автомат замера. Читает `g_gps`, на отсечках сохраняет снимок `g_obd` (обороты, наддув, передача) | новый файл |
| Вызовы `gps_poll()` и `perf_tick()` рядом с `obd_rx_poll()` | `cluster_app.c` |
| Страница PERF (страниц станет 4). DRIVE показывает GPS-скорость при хорошем фиксе и OBD при плохом. Метка `GPS` в полосе алертов | `cluster_ui.c` |
| Пороги, частота, набор систем | `cluster_config.h` |
| Число спутников и состояние фикса | `st7735_status.c` |

**Настройка UART.** Пока `Dash.ioc` расходится с кодом (см. ревью, пункт R1), USART2 безопаснее поднять вручную в коде, как уже сделано для ST7735. Иначе перегенерация из CubeMX затрёт чужие правки.

**Кнопка.** Короткое нажатие уже листает страницы, поэтому замер взводится автоматически: стоим с хорошим фиксом → `READY` → тронулись → время пошло. Кнопка нужна только для сброса или удаления результата.

**Бонус.** Поправку OBD-скорости можно подбирать автоматически по GPS (при ровном движении и хорошем `sAcc`) вместо зашитого 60/67. Тогда без фикса OBD-скорость тоже станет точнее.

### Отдельная коробка: почему нет
Вариант «ESP32 + GPS + приложение на телефоне» — по сути самодельный Dragy; проще купить готовый. Он не даёт связки с OBD, требует отдельного питания и телефона, а скорость на основном экране так и останется OBD-шной. Слать данные с коробки на приборку по CAN нельзя: проект сознательно не пишет в шину машины ничего, кроме стандартных OBD-запросов.

## 5. План прошивки и трудозатраты

| Этап | Объём |
|---|---|
| Драйвер UART+DMA, разбор UBX, настройка модуля (частота, системы, `dynModel` = automotive, отключение NMEA, скорость UART 115200+) | 1–2 дня |
| GPS-скорость на DRIVE с откатом на OBD | ~0.5 дня |
| Автомат замера: интерполяция старта назад к нулю, отсечки, 1/4 мили по интегралу скорости, опциональный откат 1 фут, отмена при торможении, проверка уклона по высоте и качества фикса | 2–3 дня |
| Страница PERF: таймер, скорость, история заездов | 1–2 дня |
| Сохранение результатов во внутреннюю флешку или в SPI NOR 8 МБ на плате | по желанию; пока результаты только в RAM (до выключения) |
| Проверка на машине, сравнение с Dragy или приложением | основное время |

Итого рабочая версия — примерно неделя-две вечерами.

## 6. Подводные камни

- **Время брать из GNSS (`iTOW`), а не из `HAL_GetTick()`.** Суперцикл стоит до сотен мс из-за блокирующего вывода на экран; с временем эпохи эти тормоза не влияют на точность.
- **Сообщения нельзя терять.** NAV-PVT занимает ~100 байт; на 25 Гц это ~2.5 КБ/с, а цикл стоит до ~400 мс. Нужен кольцевой DMA-буфер с запасом (~4 КБ) или разбор в прерывании.
- **Живой таймер будет дёргаться,** пока экран перерисовывается целиком каждые 40 мс (ревью, пункт R2). R2 лучше исправить до страницы PERF или параллельно с ней.
- **Антенна.** Нужен вид на небо: модуль под лобовым стеклом или внешняя активная антенна на крыше. Атермальное лобовое может глушить сигнал.
- **Холодный старт ~27 с** при каждом включении зажигания (см. §7). Всё это время работает откат на OBD-скорость.
- **Настройки модуля сбрасываются** при снятии питания, поэтому прошивка отправляет их при каждой загрузке.

## 7. Резервное питание модуля: не нужно

Приборка питается от зажигания (ACC), поэтому при выключенном ключе модуль обесточен полностью. Батарейка на `V_BCKP` дала бы горячий старт (~1 с вместо ~27 с), но:
- данные спутников устаревают за несколько часов, и после ночной стоянки старт всё равно почти холодный;
- первые ~30 с скорость берётся из OBD, а заезды сразу после запуска мотора не делают;
- настройки и так отправляются при загрузке.

Решение: батарейку не ставить, `V_BCKP` соединить с `VCC` (рекомендация u-blox для схем без резерва; сверить с integration manual).

Если когда-нибудь понадобится быстрый старт, можно питать `V_BCKP` от постоянных +12 В через маломощный стабилизатор, рассчитанный на бортовую сеть. Потребление десятки мкА, но нужен отдельный провод на постоянный предохранитель.

## 8. Железо: варианты и BOM

### Вариант A — готовый модуль на M10 (рекомендуется для прототипа), ~$30–60

| Позиция | Цена | Комментарий |
|---|---|---|
| GNSS-модуль u-blox M10 со встроенной антенной, например **Matek M10Q-5883** | $46–52 | SAM-M10Q, вход 4–9 В, JST-GH-6P, 20×20 мм. По умолчанию UBX 5 Гц на 4 системах. Компас не используется |
| Дешёвые аналоги: Flying Tech M10Q-5883P, Diatone Mamba M10 Pro | £30 / €24 | Перед покупкой убедиться, что внутри u-blox M10, а не клон M8 |
| Кабель 1–2 м, 4 жилы (5V, GND, TX, RX), со стороны WeAct — Dupont | ~$3–5 | |
| Крепёж: скотч 3M VHB или корпус | ~$2–5 | |

У Matek наличие резервного ионистора в характеристиках не найдено. Это не важно, см. §7.

### Вариант B — 25 Гц на 4 системах, антенна на крыше, ~$95–110

| Позиция | Цена |
|---|---|
| SparkFun GPS Breakout NEO-M9N, SMA (GPS-17285) | $76.50 |
| Активная антенна на магните, SMA, 28 дБ, 3–5 В, кабель 3–5 м (SparkFun / Adafruit) | €14–22 |
| Провода Dupont, корпус | ~$7 |

### Вариант C — своя плата на компонентах с LCSC, ~$13 за детали

Готовых плат на u-blox на LCSC нет, только голые модули. Нужна своя плата ~50×50 мм (JLCPCB, 2 слоя), подключённая к WeAct 4-проводным кабелем. Имеет смысл в рамках будущей своей платы под всю приборку: на ней можно собрать GNSS, CAN-трансивер, преобразователь 12→5 В и разъёмы дисплеев.

| # | Позиция | LCSC | Кол-во | Цена | Мин. партия | Наличие |
|---|---|---|---|---|---|---|
| 1 | u-blox MAX-M10S-00B | [C4153167](https://www.lcsc.com/product-detail/C4153167.html) | 1 | $10.86 | 1 | 286 |
| 2 | Пассивная керамическая антенна 25×25×4 мм, 1575 МГц, 50 Ом, вывод в отверстие (BAT WIRELESS BWGNSCNX25-25W4) | [C784398](https://www.lcsc.com/product-detail/C784398.html) | 1 | $0.77 | 1 | 373 |
| 3 | Стабилизатор 3.3 В AP2112K-3.3TRG1 | [C51118](https://www.lcsc.com/product-detail/linear%20voltage%20regulators%20(ldo)_diodes%20incorporated_ap2112k-3.3trg1_C51118.html) | 1 | $0.17 | 5 | 31 110 |
| 4 | Конденсатор 10 мкФ 10 В X5R 0603 | [C19702](https://www.lcsc.com/product-detail/C19702.html) | 3 | $0.031 | 20 | 2.2 млн |
| 5 | Конденсатор 100 нФ 16 В X7R 0402 | [C1525](https://www.lcsc.com/product-detail/C1525.html) | 2 | $0.005 | 100 | 400 |
| 6 | Разъём JST GH 4P, SMD, угловой | [C189895](https://www.lcsc.com/product-detail/Wire-To-Board-Connector_JST-SM04B-GHS-TB-LF-SN_C189895.html) | 1 | $0.31 | 5 | 28 760 |
| 7 | Корпус ответной части JST GHR-04V-S | [C160418](https://www.lcsc.com/product-detail/_JST_GHR-04V-S_GH-1-4P-pitch1-25mm_C160418.html) | 1 | $0.12 | 5 | 8 875 |
| 8 | Контакты JST SSHL-002T-P0.2, 26–30 AWG | [C189897](https://www.lcsc.com/product-detail/C189897.html) | 4 | $0.014 | 100 | 743 100 |

С учётом минимальных партий около $17, без платы и доставки (не проверялось). Контакты GH обжимать сложно, проще взять готовые GH-кабели 4P и отрезать один конец.

**Подключение на плате** (сверить с MAX-M10S Integration Manual):
- 5V с кабеля → AP2112 (EN на вход) → 3.3 В на `VCC`, `VCC_IO`, `V_BCKP`.
- `RF_IN` → ВЧ-дорожка 50 Ом → вывод антенны; под антенной сплошная земля.
- `VCC_RF`, `LNA_EN` — не подключать (антенна пассивная).
- `TXD`/`RXD` → разъём → PA3/PA2 на WeAct.
- `RESET_N`, `SAFEBOOT_N` — на тестовые площадки: через `SAFEBOOT_N` модуль можно восстановить после неудачной прошивки или настройки.

**Другие u-blox на LCSC (для справки):**

| Модуль | LCSC | Цена | Наличие | Заметка |
|---|---|---|---|---|
| MAX-M10S-00B-01 | [C24834155](https://www.lcsc.com/product-detail/gnss-modules_u-blox-max-m10s-00b-01_C24834155.html) | $11.05 | 73 | Новая ревизия |
| NEO-M9N-00B | [C5119087](https://www.lcsc.com/product-detail/gnss-modules_u-blox-neo-m9n-00b_C5119087.html) | $16.47 | 814 | Если нужны 25 Гц на 4 системах; нужна внешняя антенна |
| SAM-M10Q-00B | [C5443880](https://www.lcsc.com/product-detail/gnss-modules_u-blox-sam-m10q-00b_C5443880.html) | $23.05 | нет | Со встроенной антенной; корпус LGA, только фен или печь |
| MAX-M10M-00B | [C6293820](https://www.lcsc.com/product-detail/C6293820.html) | $22.61 | 6 | Чувствительность хуже (−164 дБм), брать незачем |
| Taoglas SGGP.25.4.A.02 (патч 25×25) | [C5894699](https://www.lcsc.com/product-detail/antennas_taoglas-sggp-25-4-a-02_C5894699.html) | $18.89 | нет | Брендовая альтернатива антенне из п. 2 |
| Разъём U.FL Hirose U.FL-R-SMT-1(80) | [C88374](https://www.lcsc.com/product-detail/Connectors_HRS_U-FL-R-SMT-1-80_3310472280-IPE-XBoard-end-IPXConnector-SMD_C88374.html) | $0.11 | 57 660 | Если вместо патча ставить внешнюю антенну |

### Опционально (для любого варианта)

| Позиция | Цена | Зачем |
|---|---|---|
| USB-UART адаптер (CP2102 / CH340) | ~$3–5 | Подключить модуль к ПК и настроить в бесплатном u-center ещё до работы с прошивкой |
| microSD-карта | ~$5 | Слот SD на 4" дисплейном модуле не занят — можно писать туда логи заездов (4 провода SPI и работа в прошивке) |
| Акселерометр LSM6DSO / ICM-42688 (I2C) | ≈$10–20, не проверялось | Точнее ловит старт. Для 0–100 не обязателен |

## 9. Что решить перед началом

1. Путь по железу: A (готовый модуль) сейчас или сразу C (своя плата).
2. Целевая частота: 10 Гц (достаточно для 0–100) или 20–25 Гц (для 1/4 мили).
3. Исправлять ли R2 (полная перерисовка экрана) до страницы PERF.
4. Где ставить антенну и есть ли атермальное покрытие на лобовом.
5. Хранить ли историю заездов и где: внутренняя флешка, SPI NOR или SD.

## Источники

- [Dragy DRG70-C — Tegiwa](https://www.tegiwa.com/products/dragy-gps-performance-monitoring-box-drg70-c)
- [Dragy up to 25Hz, u-blox 10th gen — Carrefour UAE](https://www.carrefouruae.com/mafuae/en/mobile-accessories/new-dragy-gps-based-performance-meter-up-to-25hz-gps-laptimer-upgraded-ublox-10th-gen-high-performance-gps-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)
- [Dragy DRG70-C — Paragon Performance](https://paragonperf.com/products/dragy-gps-performance-meter-drg70-c)
- [Dragy DRG70 — Subispeed](https://www.subispeed.com/products/drg70-dragy-gps-based-performance-meter-universal)
- [Track vs VBOX vs Dragy — Audizine](https://www.audizine.com/forum/showthread.php/805028-Track-vs-vbox-vs-Dragy-results)
- [RaceBox Mini tech specs](https://www.racebox.pro/products/racebox-mini/tech-specs)
- [RaceBox Micro on SAM-M10Q — Hackster](https://hackster.io/news/the-racebox-micro-is-a-teeny-tiny-25hz-bluetooth-gnss-data-logger-for-rc-racing-and-more-cf7c12fe8929)
- [MAX-M10S datasheet — u-blox](https://content.u-blox.com/sites/default/files/MAX-M10S_DataSheet_UBX-20035208.pdf)
- [SparkFun NEO-M9N SMA](https://www.sparkfun.com/sparkfun-gps-breakout-neo-m9n-sma-qwiic.html)
- [Matek M10Q-5883 — GetFPV](https://www.getfpv.com/mateksys-m10q-5883-gnss-compass.html)
- [Matek M10Q-5883 — WREKD](https://wrekd.com/products/matek-m10q-5883-gnss-compass)
- [Flying Tech M10Q-5883P](https://www.flyingtech.co.uk/product/flying-tech-gnss-gps-compass-module-m10q-5883p/)
- [Diatone Mamba M10 Pro — FPV24](https://fpv24.com/en/diatone/diatone-fpv-mamba-m10-pro-gps-qmc5883l-compass)
- [GPS/GNSS Magnetic Mount Antenna — Elektor](https://www.elektor.com/gps-gnss-magnetic-mount-antenna-3-m-sma)
- [Adafruit GPS Antenna 28 dB 5 m](https://www.adafruit.com/products/960)
- [ATGM336H-5N31 — LCSC](https://www.lcsc.com/product-detail/C90770.html)
- Карточки LCSC — ссылки в таблицах §8.
