Pcfccn/Dash/Dash.ioc

Mcu.UserName=STM32H743VITx
PA8.Signal=S_TIM1_CH1
PB13.Signal=SPI2_SCK
PC0.GPIO_Label=LCD_CS
PC0.Signal=GPIO_Output
PB15.Signal=SPI2_MOSI
PB14.Signal=SPI2_MISO
PC4.GPIO_Label=LCD_DC
PC4.Signal=GPIO_Output
PC5.GPIO_Label=LCD_RST
PC5.Signal=GPIO_Output
PD0.Signal=FDCAN1_RX
PD1.Signal=FDCAN1_TX
