Pcfccn/Dash/Core/Inc/main.h

#define LCD_CS_Pin GPIO_PIN_0
#define LCD_CS_GPIO_Port GPIOC
#define LCD_DC_Pin GPIO_PIN_4
#define LCD_DC_GPIO_Port GPIOC
#define LCD_RST_Pin GPIO_PIN_5
#define LCD_RST_GPIO_Port GPIOC
