Pcfccn/Dash/Core/Src/montserrat_semibold_12.c

/*******************************************************************************
 * Size: 12 px
 * Bpp: 4
 * Opts: --font Montserrat-SemiBold.ttf -r 0x20-0x7F,0xB0,0x2022 --size 12 --format lvgl --bpp 4 --no-compress --force-fast-kern-format -o montserrat_semibold_12.c
 * Then by hand: .fallback = &lv_font_montserrat_12, so the LV_SYMBOL_* icons
 * (not in this font) come from the built-in Montserrat Medium of the same size.
 ******************************************************************************/

#ifdef LV_LVGL_H_INCLUDE_SIMPLE
#include "lvgl.h"
#else
#include "lvgl.h"
#endif

#ifndef MONTSERRAT_SEMIBOLD_12
#define MONTSERRAT_SEMIBOLD_12 1
#endif

#if MONTSERRAT_SEMIBOLD_12

/*-----------------
 *    BITMAPS
 *----------------*/

/*Store the image of the glyphs*/
static LV_ATTRIBUTE_LARGE_CONST const uint8_t glyph_bitmap[] = {
    /* U+0020 " " */

    /* U+0021 "!" */
    0x2f, 0x82, 0xf7, 0x1f, 0x70, 0xf6, 0xf, 0x50,
    0xf4, 0x0, 0x2, 0xe6, 0x2e, 0x60,

    /* U+0022 "\"" */
    0x5f, 0xf, 0x44, 0xe0, 0xf3, 0x4e, 0xf, 0x32,
    0x80, 0x81,

    /* U+0023 "#" */
    0x0, 0x6b, 0x4, 0xd0, 0x0, 0x8, 0x90, 0x6b,
    0x0, 0x5f, 0xff, 0xff, 0xff, 0x40, 0x2c, 0x72,
    0xb8, 0x20, 0x0, 0xd4, 0xb, 0x60, 0x0, 0xe,
    0x20, 0xd4, 0x0, 0xbf, 0xff, 0xff, 0xfd, 0x1,
    0x4f, 0x23, 0xf3, 0x20, 0x4, 0xc0, 0x2e, 0x0,
    0x0,

    /* U+0024 "$" */
    0x0, 0xa, 0x50, 0x0, 0x0, 0xa, 0x50, 0x0,
    0x4, 0xcf, 0xfc, 0x50, 0x2f, 0xcc, 0x9a, 0x70,
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

    /* U+007C "|" */
    0xe8, 0xe8, 0xe8, 0xe8, 0xe8, 0xe8, 0xe8, 0xe8,
    0xe8, 0xe8, 0xe8, 0xe8, 0xe8,

    /* U+007D "}" */
    0xcd, 0x30, 0x4e, 0xb0, 0xa, 0xd0, 0xa, 0xd0,
    0xa, 0xd0, 0x9, 0xe1, 0x3, 0xfc, 0x9, 0xf3,
    0xa, 0xd0, 0xa, 0xd0, 0xa, 0xd0, 0x4e, 0xb0,
    0xcd, 0x30,

    /* U+007E "~" */
    0x0, 0x0, 0x0, 0x0, 0xbf, 0x91, 0xb5, 0x4d,
    0x4c, 0xfe, 0x11, 0x10, 0x2, 0x0,

    /* U+00B0 "°" */
    0x9, 0xd9, 0x6, 0x80, 0x87, 0x68, 0x8, 0x70,
    0x9d, 0x90,

    /* U+2022 "•" */
    0xa, 0xa0, 0x3f, 0xf4, 0xd, 0xd1
};


/*---------------------
 *  GLYPH DESCRIPTION
 *--------------------*/

static const lv_font_fmt_txt_glyph_dsc_t glyph_dsc[] = {
    {.bitmap_index = 0, .adv_w = 0, .box_w = 0, .box_h = 0, .ofs_x = 0, .ofs_y = 0} /* id = 0 reserved */,
    {.bitmap_index = 0, .adv_w = 53, .box_w = 0, .box_h = 0, .ofs_x = 0, .ofs_y = 0},
    {.bitmap_index = 0, .adv_w = 53, .box_w = 3, .box_h = 9, .ofs_x = 0, .ofs_y = 0},
    {.bitmap_index = 14, .adv_w = 79, .box_w = 5, .box_h = 4, .ofs_x = 0, .ofs_y = 5},
    {.bitmap_index = 24, .adv_w = 137, .box_w = 9, .box_h = 9, .ofs_x = 0, .ofs_y = 0},
    {.bitmap_index = 65, .adv_w = 121, .box_w = 8, .box_h = 13, .ofs_x = 0, .ofs_y = -2},
    {.bitmap_index = 117, .adv_w = 165, .box_w = 10, .box_h = 9, .ofs_x = 0, .ofs_y = 0},
    {.bitmap_index = 162, .adv_w = 136, .box_w = 9, .box_h = 10, .ofs_x = 0, .ofs_y = -1},
    {.bitmap_index = 207, .adv_w = 42, .box_w = 2, .box_h = 4, .ofs_x = 0, .ofs_y = 5},
    {.bitmap_index = 211, .adv_w = 67, .box_w = 3, .box_h = 13, .ofs_x = 1, .ofs_y = -3},
    {.bitmap_index = 231, .adv_w = 67, .box_w = 4, .box_h = 13, .ofs_x = 0, .ofs_y = -3},
    {.bitmap_index = 257, .adv_w = 80, .box_w = 5, .box_h = 5, .ofs_x = 0, .ofs_y = 5},
    {.bitmap_index = 270, .adv_w = 113, .box_w = 7, .box_h = 6, .ofs_x = 0, .ofs_y = 2},
    {.bitmap_index = 291, .adv_w = 47, .box_w = 3, .box_h = 5, .ofs_x = 0, .ofs_y = -2},
    {.bitmap_index = 299, .adv_w = 74, .box_w = 4, .box_h = 3, .ofs_x = 0, .ofs_y = 2},
    {.bitmap_index = 305, .adv_w = 47, .box_w = 3, .box_h = 3, .ofs_x = 0, .ofs_y = 0},
    {.bitmap_index = 310, .adv_w = 71, .box_w = 6, .box_h = 12, .ofs_x = -1, .ofs_y = -1},
    {.bitmap_index = 346, .adv_w = 129, .box_w = 8, .box_h = 9, .ofs_x = 0, .ofs_y = 0},
    {.bitmap_index = 382, .adv_w = 73, .box_w = 4, .box_h = 9, .ofs_x = 0, .ofs_y = 0},
    {.bitmap_index = 400, .adv_w = 112, .box_w = 7, .box_h = 9, .ofs_x = 0, .ofs_y = 0},
    {.bitmap_index = 432, .adv_w = 112, .box_w = 7, .box_h = 9, .ofs_x = 0, .ofs_y = 0},
    {.bitmap_index = 464, .adv_w = 130, .box_w = 9, .box_h = 9, .ofs_x = 0, .ofs_y = 0},
    {.bitmap_index = 505, .adv_w = 112, .box_w = 7, .box_h = 9, .ofs_x = 0, .ofs_y = 0},
    {.bitmap_index = 537, .adv_w = 120, .box_w = 8, .box_h = 9, .ofs_x = 0, .ofs_y = 0},
    {.bitmap_index = 573, .adv_w = 117, .box_w = 7, .box_h = 9, .ofs_x = 0, .ofs_y = 0},
    {.bitmap_index = 605, .adv_w = 125, .box_w = 8, .box_h = 9, .ofs_x = 0, .ofs_y = 0},
    {.bitmap_index = 641, .adv_w = 120, .box_w = 7, .box_h = 9, .ofs_x = 0, .ofs_y = 0},
    {.bitmap_index = 673, .adv_w = 47, .box_w = 3, .box_h = 7, .ofs_x = 0, .ofs_y = 0},
    {.bitmap_index = 684, .adv_w = 47, .box_w = 3, .box_h = 9, .ofs_x = 0, .ofs_y = -2},
    {.bitmap_index = 698, .adv_w = 113, .box_w = 7, .box_h = 7, .ofs_x = 0, .ofs_y = 1},
    {.bitmap_index = 723, .adv_w = 113, .box_w = 7, .box_h = 5, .ofs_x = 0, .ofs_y = 2},
    {.bitmap_index = 741, .adv_w = 113, .box_w = 7, .box_h = 7, .ofs_x = 0, .ofs_y = 1},
    {.bitmap_index = 766, .adv_w = 112, .box_w = 7, .box_h = 9, .ofs_x = 0, .ofs_y = 0},
    {.bitmap_index = 798, .adv_w = 199, .box_w = 12, .box_h = 12, .ofs_x = 0, .ofs_y = -3},
    {.bitmap_index = 870, .adv_w = 144, .box_w = 11, .box_h = 9, .ofs_x = -1, .ofs_y = 0},
    {.bitmap_index = 920, .adv_w = 146, .box_w = 8, .box_h = 9, .ofs_x = 1, .ofs_y = 0},
    {.bitmap_index = 956, .adv_w = 138, .box_w = 9, .box_h = 9, .ofs_x = 0, .ofs_y = 0},
    {.bitmap_index = 997, .adv_w = 159, .box_w = 9, .box_h = 9, .ofs_x = 1, .ofs_y = 0},
    {.bitmap_index = 1038, .adv_w = 129, .box_w = 7, .box_h = 9, .ofs_x = 1, .ofs_y = 0},
    {.bitmap_index = 1070, .adv_w = 122, .box_w = 7, .box_h = 9, .ofs_x = 1, .ofs_y = 0},
    {.bitmap_index = 1102, .adv_w = 148, .box_w = 9, .box_h = 9, .ofs_x = 0, .ofs_y = 0},
    {.bitmap_index = 1143, .adv_w = 156, .box_w = 8, .box_h = 9, .ofs_x = 1, .ofs_y = 0},
    {.bitmap_index = 1179, .adv_w = 61, .box_w = 2, .box_h = 9, .ofs_x = 1, .ofs_y = 0},
    {.bitmap_index = 1188, .adv_w = 101, .box_w = 7, .box_h = 9, .ofs_x = -1, .ofs_y = 0},
    {.bitmap_index = 1220, .adv_w = 140, .box_w = 8, .box_h = 9, .ofs_x = 1, .ofs_y = 0},
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
    {.bitmap_index = 2781, .adv_w = 71, .box_w = 5, .box_h = 13, .ofs_x = 0, .ofs_y = -3},
    {.bitmap_index = 2814, .adv_w = 58, .box_w = 2, .box_h = 13, .ofs_x = 1, .ofs_y = -3},
    {.bitmap_index = 2827, .adv_w = 71, .box_w = 4, .box_h = 13, .ofs_x = 0, .ofs_y = -3},
    {.bitmap_index = 2853, .adv_w = 113, .box_w = 7, .box_h = 4, .ofs_x = 0, .ofs_y = 3},
    {.bitmap_index = 2867, .adv_w = 80, .box_w = 5, .box_h = 4, .ofs_x = 0, .ofs_y = 5},
    {.bitmap_index = 2877, .adv_w = 64, .box_w = 4, .box_h = 3, .ofs_x = 0, .ofs_y = 2}
};

/*---------------------
 *  CHARACTER MAPPING
 *--------------------*/

static const uint16_t unicode_list_1[] = {
    0x0, 0x1f72
};

/*Collect the unicode lists and glyph_id offsets*/
static const lv_font_fmt_txt_cmap_t cmaps[] =
{
    {
        .range_start = 32, .range_length = 95, .glyph_id_start = 1,
        .unicode_list = NULL, .glyph_id_ofs_list = NULL, .list_length = 0, .type = LV_FONT_FMT_TXT_CMAP_FORMAT0_TINY
    },
    {
        .range_start = 176, .range_length = 8051, .glyph_id_start = 96,
        .unicode_list = unicode_list_1, .glyph_id_ofs_list = NULL, .list_length = 2, .type = LV_FONT_FMT_TXT_CMAP_SPARSE_TINY
    }
};

/*-----------------
 *    KERNING
 *----------------*/


/*Map glyph_ids to kern left classes*/
static const uint8_t kern_left_class_mapping[] =
{
    0, 0, 1, 2, 0, 3, 4, 5,
    2, 6, 0, 7, 8, 9, 8, 9,
    10, 11, 0, 12, 13, 14, 15, 16,
    17, 18, 11, 19, 19, 0, 0, 0,
    20, 21, 0, 0, 0, 0, 0, 0,
    0, 0, 0, 0, 0, 0, 0, 0,
    0, 0, 0, 0, 0, 0, 0, 0,
    0, 0, 0, 0, 22, 23, 0, 0,
    24, 0, 0, 0, 0, 0, 0, 0,
    0, 0, 0, 0, 0, 0, 0, 0,
    0, 0, 0, 0, 0, 0, 0, 0,
    0, 0, 0, 0, 22, 0, 0, 8,
    25, 8
};

/*Map glyph_ids to kern right classes*/
static const uint8_t kern_right_class_mapping[] =
{
    0, 0, 1, 2, 0, 3, 4, 5,
    2, 0, 6, 7, 8, 9, 8, 9,
    10, 11, 12, 13, 14, 15, 16, 11,
    17, 18, 19, 20, 20, 0, 0, 0,
    21, 22, 0, 0, 0, 0, 0, 0,
    0, 0, 0, 0, 0, 0, 0, 0,
    0, 0, 0, 0, 0, 0, 0, 0,
    0, 0, 0, 0, 23, 24, 25, 0,
    26, 0, 0, 0, 0, 0, 0, 0,
    0, 0, 0, 0, 0, 0, 0, 0,
    0, 0, 0, 0, 0, 0, 0, 0,
    0, 0, 0, 0, 0, 0, 25, 8,
    27, 8
};

/*Kern values between classes*/
static const int8_t kern_class_values[] =
{
    0, 0, 0, 0, 0, 0, 1, 0,
    0, 0, 0, 2, 0, 0, 0, 0,
    1, 0, 0, 0, 0, 0, 0, 0,
    0, 0, 0, 0, 9, 0, 5, -4,
    0, 4, 0, -11, -12, 1, 9, 4,
    3, -8, 1, 9, 0, 8, 2, 6,
    -3, 0, 12, 2, -1, 4, 0, -6,
    0, 0, 0, 0, -4, 3, 4, 0,
    0, -2, 0, -1, 2, 0, -2, 0,
    -2, -1, -4, 0, 0, -2, 0, -4,
    -3, 0, -5, 0, -24, 0, -4, -10,
    4, 6, 0, 0, -4, 2, 2, 6,
    4, -3, 4, 0, 0, -11, 0, 0,
    -7, 0, 0, -5, -2, -9, 0, -8,
    -1, 0, -6, 0, 0, 7, 0, -6,
    -2, 0, 0, 0, -3, 0, 0, -1,
    -13, 0, 0, -15, -2, 6, -9, 0,
    0, 0, 0, 0, 0, 0, 0, 0,
    7, 0, 2, 0, 0, -4, 0, 0,
    0, 0, 0, 0, 0, 0, 8, 2,
    0, 0, 1, 4, 2, 6, -2, 0,
    4, -2, -7, -26, 1, 5, 4, 0,
    -2, 0, 6, 0, 6, 0, 6, 0,
    0, 0, 0, -2, 6, 0, 0, -3,
    -7, 0, 0, -2, 0, -1, 0, 1,
    -4, -3, -4, 1, 0, -2, 0, 0,
    0, -8, 1, 0, -12, 0, 0, 0,
    0, -11, 2, -12, 0, 0, -7, -1,
    0, 18, -2, -3, 2, 2, -1, 0,
    -3, 2, 0, 0, -11, -4, 0, -18,
    0, 2, -12, 0, 12, -4, 0, -7,
    7, 0, -13, -18, -13, -4, 6, 0,
    0, -12, 0, 2, -5, 0, -3, 0,
    -4, 0, 4, 6, -23, 9, 0, 1,
    0, 0, 0, 0, 1, 1, -2, -4,
    0, 0, 0, -2, 0, 0, -1, 0,
    0, 0, -4, 0, 0, -4, 0, -4,
    0, 0, 0, 0, 2, -1, 0, 0,
    -1, 2, 2, 0, 0, 0, 0, -3,
    0, 0, 0, 0, 0, 0, 0, 0,
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
};


/*Collect the kern class' data in one place*/
static const lv_font_fmt_txt_kern_classes_t kern_classes =
{
    .class_pair_values   = kern_class_values,
    .left_class_mapping  = kern_left_class_mapping,
    .right_class_mapping = kern_right_class_mapping,
    .left_class_cnt      = 25,
    .right_class_cnt     = 27,
};

/*--------------------
 *  ALL CUSTOM DATA
 *--------------------*/

#if LVGL_VERSION_MAJOR == 8
/*Store all the custom data of the font*/
static  lv_font_fmt_txt_glyph_cache_t cache;
#endif

#if LVGL_VERSION_MAJOR >= 8
static const lv_font_fmt_txt_dsc_t font_dsc = {
#else
static lv_font_fmt_txt_dsc_t font_dsc = {
#endif
    .glyph_bitmap = glyph_bitmap,
    .glyph_dsc = glyph_dsc,
    .cmaps = cmaps,
    .kern_dsc = &kern_classes,
    .kern_scale = 16,
    .cmap_num = 2,
    .bpp = 4,
    .kern_classes = 1,
    .bitmap_format = 0,
#if LVGL_VERSION_MAJOR == 8
    .cache = &cache
#endif
};



/*-----------------
 *  PUBLIC FONT
 *----------------*/

/*Initialize a public general font descriptor*/
#if LVGL_VERSION_MAJOR >= 8
const lv_font_t montserrat_semibold_12 = {
#else
lv_font_t montserrat_semibold_12 = {
#endif
    .get_glyph_dsc = lv_font_get_glyph_dsc_fmt_txt,    /*Function pointer to get glyph's data*/
    .get_glyph_bitmap = lv_font_get_bitmap_fmt_txt,    /*Function pointer to get glyph's bitmap*/
    .line_height = 14,          /*The maximum line height required by the font*/
    .base_line = 3,             /*Baseline measured from the bottom of the line*/
#if !(LVGL_VERSION_MAJOR == 6 && LVGL_VERSION_MINOR == 0)
    .subpx = LV_FONT_SUBPX_NONE,
#endif
#if LV_VERSION_CHECK(7, 4, 0) || LVGL_VERSION_MAJOR >= 8
    .underline_position = -1,
    .underline_thickness = 1,
#endif
    .dsc = &font_dsc,          /*The custom font data. Will be accessed by `get_glyph_bitmap/dsc` */
#if LV_VERSION_CHECK(8, 2, 0) || LVGL_VERSION_MAJOR >= 9
    .fallback = &lv_font_montserrat_12,   /* LV_SYMBOL_* icons: from the built-in font */
#endif
    .user_data = NULL,
};



#endif /*#if MONTSERRAT_SEMIBOLD_12*/
