Pcfccn/Dash/Core/Src/montserrat_semibold_20.c

/*******************************************************************************
 * Size: 20 px
 * Bpp: 4
 * Opts: --font Montserrat-SemiBold.ttf -r 0x20-0x7F,0xB0,0x2022 --size 20 --format lvgl --bpp 4 --no-compress --force-fast-kern-format -o montserrat_semibold_20.c
 * Then by hand: .fallback = &lv_font_montserrat_20, so the LV_SYMBOL_* icons
 * (not in this font) come from the built-in Montserrat Medium of the same size.
 ******************************************************************************/

#ifdef LV_LVGL_H_INCLUDE_SIMPLE
#include "lvgl.h"
#else
#include "lvgl.h"
#endif

#ifndef MONTSERRAT_SEMIBOLD_20
#define MONTSERRAT_SEMIBOLD_20 1
#endif

#if MONTSERRAT_SEMIBOLD_20

/*-----------------
 *    BITMAPS
 *----------------*/

/*Store the image of the glyphs*/
static LV_ATTRIBUTE_LARGE_CONST const uint8_t glyph_bitmap[] = {
    /* U+0020 " " */

    /* U+0021 "!" */
    0xaf, 0xf4, 0x9f, 0xf3, 0x8f, 0xf2, 0x8f, 0xf1,
    0x7f, 0xf0, 0x6f, 0xf0, 0x5f, 0xf0, 0x4f, 0xe0,
    0x4f, 0xd0, 0x18, 0x60, 0x1, 0x0, 0x7f, 0xe1,
    0xcf, 0xf5, 0x5e, 0xc0,

    /* U+0022 "\"" */
    0xdf, 0x40, 0xff, 0x1d, 0xf3, 0xf, 0xf1, 0xcf,
    0x30, 0xff, 0xc, 0xf2, 0xe, 0xf0, 0xcf, 0x20,
    0xef, 0x7, 0xa1, 0x8, 0x90,

    /* U+0023 "#" */
    0x0, 0x0, 0x9f, 0x30, 0x6, 0xf6, 0x0, 0x0,
    0x0, 0xbf, 0x10, 0x8, 0xf4, 0x0, 0x0, 0x0,
    0xdf, 0x0, 0xb, 0xf2, 0x0, 0xd, 0xff, 0xff,
    0xff, 0xff, 0xff, 0xfb, 0xb, 0xde, 0xff, 0xdd,
    0xdf, 0xfd, 0xda, 0x0, 0x3, 0xf9, 0x0, 0xf,
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
    0x2b, 0xef, 0x10,

    /* U+007C "|" */
    0x2f, 0xf3, 0x2f, 0xf3, 0x2f, 0xf3, 0x2f, 0xf3,
    0x2f, 0xf3, 0x2f, 0xf3, 0x2f, 0xf3, 0x2f, 0xf3,
    0x2f, 0xf3, 0x2f, 0xf3, 0x2f, 0xf3, 0x2f, 0xf3,
    0x2f, 0xf3, 0x2f, 0xf3, 0x2f, 0xf3, 0x2f, 0xf3,
    0x2f, 0xf3, 0x2f, 0xf3, 0x2f, 0xf3,

    /* U+007D "}" */
    0xaf, 0xd6, 0x0, 0xa, 0xff, 0xf5, 0x0, 0x3,
    0xff, 0xa0, 0x0, 0xc, 0xfc, 0x0, 0x0, 0xbf,
    0xc0, 0x0, 0xb, 0xfc, 0x0, 0x0, 0xbf, 0xc0,
    0x0, 0xb, 0xfe, 0x10, 0x0, 0x5f, 0xff, 0x50,
    0x3, 0xef, 0xf5, 0x0, 0xaf, 0xe2, 0x0, 0xb,
    0xfc, 0x0, 0x0, 0xbf, 0xc0, 0x0, 0xb, 0xfc,
    0x0, 0x0, 0xbf, 0xc0, 0x0, 0xc, 0xfb, 0x0,
    0x3, 0xff, 0x90, 0xa, 0xff, 0xf4, 0x0, 0xaf,
    0xd5, 0x0, 0x0,

    /* U+007E "~" */
    0x6, 0xdd, 0x60, 0x0, 0xda, 0x5f, 0xff, 0xfa,
    0x15, 0xf8, 0xbf, 0x32, 0xdf, 0xff, 0xf3, 0xec,
    0x0, 0x9, 0xfe, 0x50,

    /* U+00B0 "°" */
    0x0, 0x0, 0x0, 0x0, 0x1, 0xaf, 0xfc, 0x30,
    0xb, 0xe6, 0x5b, 0xf1, 0x2f, 0x40, 0x0, 0xe7,
    0x2f, 0x30, 0x0, 0xe8, 0xd, 0xc3, 0x29, 0xf3,
    0x2, 0xdf, 0xff, 0x50, 0x0, 0x2, 0x30, 0x0,

    /* U+2022 "•" */
    0x3, 0x51, 0x5, 0xff, 0xe1, 0xbf, 0xff, 0x7a,
    0xff, 0xf5, 0x1c, 0xf9, 0x0
};


/*---------------------
 *  GLYPH DESCRIPTION
 *--------------------*/

static const lv_font_fmt_txt_glyph_dsc_t glyph_dsc[] = {
    {.bitmap_index = 0, .adv_w = 0, .box_w = 0, .box_h = 0, .ofs_x = 0, .ofs_y = 0} /* id = 0 reserved */,
    {.bitmap_index = 0, .adv_w = 88, .box_w = 0, .box_h = 0, .ofs_x = 0, .ofs_y = 0},
    {.bitmap_index = 0, .adv_w = 89, .box_w = 4, .box_h = 14, .ofs_x = 1, .ofs_y = 0},
    {.bitmap_index = 28, .adv_w = 132, .box_w = 7, .box_h = 6, .ofs_x = 1, .ofs_y = 8},
    {.bitmap_index = 49, .adv_w = 228, .box_w = 14, .box_h = 14, .ofs_x = 0, .ofs_y = 0},
    {.bitmap_index = 147, .adv_w = 201, .box_w = 12, .box_h = 20, .ofs_x = 0, .ofs_y = -3},
    {.bitmap_index = 267, .adv_w = 275, .box_w = 17, .box_h = 14, .ofs_x = 0, .ofs_y = 0},
    {.bitmap_index = 386, .adv_w = 226, .box_w = 14, .box_h = 15, .ofs_x = 0, .ofs_y = -1},
    {.bitmap_index = 491, .adv_w = 70, .box_w = 3, .box_h = 6, .ofs_x = 1, .ofs_y = 8},
    {.bitmap_index = 500, .adv_w = 111, .box_w = 6, .box_h = 19, .ofs_x = 1, .ofs_y = -4},
    {.bitmap_index = 557, .adv_w = 111, .box_w = 6, .box_h = 19, .ofs_x = 0, .ofs_y = -4},
    {.bitmap_index = 614, .adv_w = 133, .box_w = 8, .box_h = 8, .ofs_x = 0, .ofs_y = 7},
    {.bitmap_index = 646, .adv_w = 189, .box_w = 10, .box_h = 10, .ofs_x = 1, .ofs_y = 3},
    {.bitmap_index = 696, .adv_w = 78, .box_w = 5, .box_h = 7, .ofs_x = 0, .ofs_y = -3},
    {.bitmap_index = 714, .adv_w = 123, .box_w = 6, .box_h = 3, .ofs_x = 1, .ofs_y = 5},
    {.bitmap_index = 723, .adv_w = 78, .box_w = 5, .box_h = 4, .ofs_x = 0, .ofs_y = 0},
    {.bitmap_index = 733, .adv_w = 119, .box_w = 10, .box_h = 19, .ofs_x = -1, .ofs_y = -2},
    {.bitmap_index = 828, .adv_w = 215, .box_w = 13, .box_h = 14, .ofs_x = 0, .ofs_y = 0},
    {.bitmap_index = 919, .adv_w = 122, .box_w = 6, .box_h = 14, .ofs_x = 0, .ofs_y = 0},
    {.bitmap_index = 961, .adv_w = 186, .box_w = 12, .box_h = 14, .ofs_x = 0, .ofs_y = 0},
    {.bitmap_index = 1045, .adv_w = 186, .box_w = 11, .box_h = 14, .ofs_x = 0, .ofs_y = 0},
    {.bitmap_index = 1122, .adv_w = 217, .box_w = 14, .box_h = 14, .ofs_x = 0, .ofs_y = 0},
    {.bitmap_index = 1220, .adv_w = 187, .box_w = 12, .box_h = 14, .ofs_x = 0, .ofs_y = 0},
    {.bitmap_index = 1304, .adv_w = 201, .box_w = 13, .box_h = 14, .ofs_x = 0, .ofs_y = 0},
    {.bitmap_index = 1395, .adv_w = 195, .box_w = 12, .box_h = 14, .ofs_x = 0, .ofs_y = 0},
    {.bitmap_index = 1479, .adv_w = 209, .box_w = 13, .box_h = 14, .ofs_x = 0, .ofs_y = 0},
    {.bitmap_index = 1570, .adv_w = 201, .box_w = 12, .box_h = 14, .ofs_x = 0, .ofs_y = 0},
    {.bitmap_index = 1654, .adv_w = 78, .box_w = 5, .box_h = 11, .ofs_x = 0, .ofs_y = 0},
    {.bitmap_index = 1682, .adv_w = 78, .box_w = 5, .box_h = 14, .ofs_x = 0, .ofs_y = -3},
    {.bitmap_index = 1717, .adv_w = 189, .box_w = 10, .box_h = 10, .ofs_x = 1, .ofs_y = 2},
    {.bitmap_index = 1767, .adv_w = 189, .box_w = 10, .box_h = 7, .ofs_x = 1, .ofs_y = 4},
    {.bitmap_index = 1802, .adv_w = 189, .box_w = 10, .box_h = 10, .ofs_x = 1, .ofs_y = 2},
    {.bitmap_index = 1852, .adv_w = 186, .box_w = 11, .box_h = 14, .ofs_x = 0, .ofs_y = 0},
    {.bitmap_index = 1929, .adv_w = 331, .box_w = 20, .box_h = 18, .ofs_x = 0, .ofs_y = -4},
    {.bitmap_index = 2109, .adv_w = 240, .box_w = 17, .box_h = 14, .ofs_x = -1, .ofs_y = 0},
    {.bitmap_index = 2228, .adv_w = 244, .box_w = 14, .box_h = 14, .ofs_x = 1, .ofs_y = 0},
    {.bitmap_index = 2326, .adv_w = 230, .box_w = 14, .box_h = 14, .ofs_x = 0, .ofs_y = 0},
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
    {.bitmap_index = 6135, .adv_w = 220, .box_w = 13, .box_h = 15, .ofs_x = 0, .ofs_y = -4},
    {.bitmap_index = 6233, .adv_w = 134, .box_w = 7, .box_h = 11, .ofs_x = 1, .ofs_y = 0},
    {.bitmap_index = 6272, .adv_w = 165, .box_w = 10, .box_h = 11, .ofs_x = 0, .ofs_y = 0},
    {.bitmap_index = 6327, .adv_w = 136, .box_w = 9, .box_h = 14, .ofs_x = 0, .ofs_y = 0},
    {.bitmap_index = 6390, .adv_w = 218, .box_w = 11, .box_h = 11, .ofs_x = 1, .ofs_y = 0},
    {.bitmap_index = 6451, .adv_w = 185, .box_w = 13, .box_h = 11, .ofs_x = -1, .ofs_y = 0},
    {.bitmap_index = 6523, .adv_w = 294, .box_w = 19, .box_h = 11, .ofs_x = 0, .ofs_y = 0},
    {.bitmap_index = 6628, .adv_w = 183, .box_w = 12, .box_h = 11, .ofs_x = 0, .ofs_y = 0},
    {.bitmap_index = 6694, .adv_w = 185, .box_w = 13, .box_h = 15, .ofs_x = -1, .ofs_y = -4},
    {.bitmap_index = 6792, .adv_w = 170, .box_w = 10, .box_h = 11, .ofs_x = 0, .ofs_y = 0},
    {.bitmap_index = 6847, .adv_w = 118, .box_w = 7, .box_h = 19, .ofs_x = 1, .ofs_y = -4},
    {.bitmap_index = 6914, .adv_w = 97, .box_w = 4, .box_h = 19, .ofs_x = 1, .ofs_y = -4},
    {.bitmap_index = 6952, .adv_w = 118, .box_w = 7, .box_h = 19, .ofs_x = 0, .ofs_y = -4},
    {.bitmap_index = 7019, .adv_w = 189, .box_w = 10, .box_h = 4, .ofs_x = 1, .ofs_y = 5},
    {.bitmap_index = 7039, .adv_w = 134, .box_w = 8, .box_h = 8, .ofs_x = 0, .ofs_y = 7},
    {.bitmap_index = 7071, .adv_w = 107, .box_w = 5, .box_h = 5, .ofs_x = 1, .ofs_y = 3}
};

/*---------------------
 *  CHARACTER MAPPING
 *--------------------*/

static const uint16_t unicode_list_1[] = {
    0x0, 0x1f72
};

/*Collect the unicode lists and glyph_id offsets*/
static const lv_font_fmt_txt_cmap_t cmaps[] =
{
    {
        .range_start = 32, .range_length = 95, .glyph_id_start = 1,
        .unicode_list = NULL, .glyph_id_ofs_list = NULL, .list_length = 0, .type = LV_FONT_FMT_TXT_CMAP_FORMAT0_TINY
    },
    {
        .range_start = 176, .range_length = 8051, .glyph_id_start = 96,
        .unicode_list = unicode_list_1, .glyph_id_ofs_list = NULL, .list_length = 2, .type = LV_FONT_FMT_TXT_CMAP_SPARSE_TINY
    }
};

/*-----------------
 *    KERNING
 *----------------*/


/*Map glyph_ids to kern left classes*/
static const uint8_t kern_left_class_mapping[] =
{
    0, 0, 1, 2, 0, 3, 4, 5,
    2, 6, 0, 7, 8, 9, 8, 9,
    10, 11, 0, 12, 13, 14, 15, 16,
    17, 18, 11, 19, 19, 0, 0, 0,
    20, 21, 0, 0, 0, 0, 0, 0,
    0, 0, 0, 0, 0, 0, 0, 0,
    0, 0, 0, 0, 0, 0, 0, 0,
    0, 0, 0, 0, 22, 23, 0, 0,
    24, 0, 0, 0, 0, 0, 0, 0,
    0, 0, 0, 0, 0, 0, 0, 0,
    0, 0, 0, 0, 0, 0, 0, 0,
    0, 0, 0, 0, 22, 0, 0, 8,
    25, 8
};

/*Map glyph_ids to kern right classes*/
static const uint8_t kern_right_class_mapping[] =
{
    0, 0, 1, 2, 0, 3, 4, 5,
    2, 0, 6, 7, 8, 9, 8, 9,
    10, 11, 12, 13, 14, 15, 16, 11,
    17, 18, 19, 20, 20, 0, 0, 0,
    21, 22, 0, 0, 0, 0, 0, 0,
    0, 0, 0, 0, 0, 0, 0, 0,
    0, 0, 0, 0, 0, 0, 0, 0,
    0, 0, 0, 0, 23, 24, 25, 0,
    26, 0, 0, 0, 0, 0, 0, 0,
    0, 0, 0, 0, 0, 0, 0, 0,
    0, 0, 0, 0, 0, 0, 0, 0,
    0, 0, 0, 0, 0, 0, 25, 8,
    27, 8
};

/*Kern values between classes*/
static const int8_t kern_class_values[] =
{
    0, 0, 0, 0, 0, 0, 2, 0,
    0, 0, 0, 3, 0, 0, 0, 0,
    2, 0, 0, 0, 0, 0, 0, 0,
    0, 0, 0, 0, 14, 0, 8, -6,
    0, 6, 0, -18, -19, 2, 14, 6,
    5, -13, 2, 14, 0, 13, 3, 10,
    -5, 0, 19, 3, -2, 6, 0, -10,
    0, 0, 0, 0, -6, 5, 6, 0,
    0, -3, 0, -2, 3, 0, -3, 0,
    -3, -2, -6, 0, 0, -3, 0, -6,
    -5, 0, -8, 0, -39, 0, -6, -16,
    6, 10, 0, 0, -6, 3, 3, 11,
    6, -5, 6, 0, 0, -18, 0, 0,
    -11, 0, 0, -8, -4, -14, 0, -13,
    -2, 0, -10, 0, 0, 11, 0, -10,
    -3, 0, 0, 0, -5, 0, 0, -2,
    -22, 0, 0, -26, -3, 10, -14, 0,
    0, 0, 0, 0, 0, 0, 0, 0,
    11, 0, 3, 0, 0, -6, 0, 0,
    0, 0, 0, 0, 0, 0, 13, 3,
    0, 0, 2, 6, 3, 10, -3, 0,
    6, -3, -11, -43, 2, 8, 6, 0,
    -4, 0, 10, 0, 10, 0, 10, 0,
    0, 0, 0, -3, 10, 0, 0, -5,
    -11, 0, 0, -3, 0, -2, 0, 2,
    -6, -5, -6, 2, 0, -3, 0, 0,
    0, -13, 2, 0, -21, 0, 0, 0,
    0, -18, 3, -21, 0, 0, -11, -2,
    0, 30, -4, -5, 3, 3, -2, 0,
    -5, 3, 0, 0, -18, -6, 0, -30,
    0, 3, -21, 0, 19, -6, 0, -11,
    11, 0, -22, -30, -22, -6, 10, 0,
    0, -21, 0, 3, -8, 0, -5, 0,
    -6, 0, 6, 10, -38, 14, 0, 2,
    0, 0, 0, 0, 2, 2, -4, -6,
    0, 0, 0, -3, 0, 0, -2, 0,
    0, 0, -6, 0, 0, -6, 0, -6,
    0, 0, 0, 0, 3, -2, 0, 0,
    -2, 3, 3, 0, 0, 0, 0, -5,
    0, 0, 0, 0, 0, 0, 0, 0,
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
};


/*Collect the kern class' data in one place*/
static const lv_font_fmt_txt_kern_classes_t kern_classes =
{
    .class_pair_values   = kern_class_values,
    .left_class_mapping  = kern_left_class_mapping,
    .right_class_mapping = kern_right_class_mapping,
    .left_class_cnt      = 25,
    .right_class_cnt     = 27,
};

/*--------------------
 *  ALL CUSTOM DATA
 *--------------------*/

#if LVGL_VERSION_MAJOR == 8
/*Store all the custom data of the font*/
static  lv_font_fmt_txt_glyph_cache_t cache;
#endif

#if LVGL_VERSION_MAJOR >= 8
static const lv_font_fmt_txt_dsc_t font_dsc = {
#else
static lv_font_fmt_txt_dsc_t font_dsc = {
#endif
    .glyph_bitmap = glyph_bitmap,
    .glyph_dsc = glyph_dsc,
    .cmaps = cmaps,
    .kern_dsc = &kern_classes,
    .kern_scale = 16,
    .cmap_num = 2,
    .bpp = 4,
    .kern_classes = 1,
    .bitmap_format = 0,
#if LVGL_VERSION_MAJOR == 8
    .cache = &cache
#endif
};



/*-----------------
 *  PUBLIC FONT
 *----------------*/

/*Initialize a public general font descriptor*/
#if LVGL_VERSION_MAJOR >= 8
const lv_font_t montserrat_semibold_20 = {
#else
lv_font_t montserrat_semibold_20 = {
#endif
    .get_glyph_dsc = lv_font_get_glyph_dsc_fmt_txt,    /*Function pointer to get glyph's data*/
    .get_glyph_bitmap = lv_font_get_bitmap_fmt_txt,    /*Function pointer to get glyph's bitmap*/
    .line_height = 21,          /*The maximum line height required by the font*/
    .base_line = 4,             /*Baseline measured from the bottom of the line*/
#if !(LVGL_VERSION_MAJOR == 6 && LVGL_VERSION_MINOR == 0)
    .subpx = LV_FONT_SUBPX_NONE,
#endif
#if LV_VERSION_CHECK(7, 4, 0) || LVGL_VERSION_MAJOR >= 8
    .underline_position = -2,
    .underline_thickness = 1,
#endif
    .dsc = &font_dsc,          /*The custom font data. Will be accessed by `get_glyph_bitmap/dsc` */
#if LV_VERSION_CHECK(8, 2, 0) || LVGL_VERSION_MAJOR >= 9
    .fallback = &lv_font_montserrat_20,   /* LV_SYMBOL_* icons: from the built-in font */
#endif
    .user_data = NULL,
};



#endif /*#if MONTSERRAT_SEMIBOLD_20*/
