Pcfccn/Dash/Core/Src/montserrat_bold_72.c

/*******************************************************************************
 * Size: 72 px
 * Bpp: 4
 * Opts: --font Montserrat-SemiBold.ttf -r 0x2D,0x30-0x39 --size 72 --format lvgl --bpp 4 --no-compress --force-fast-kern-format -o montserrat_bold_72.c
 ******************************************************************************/

#ifdef LV_LVGL_H_INCLUDE_SIMPLE
#include "lvgl.h"
#else
#include "lvgl.h"
#endif

#ifndef MONTSERRAT_BOLD_72
#define MONTSERRAT_BOLD_72 1
#endif

#if MONTSERRAT_BOLD_72

/*-----------------
 *    BITMAPS
 *----------------*/

/*Store the image of the glyphs*/
static LV_ATTRIBUTE_LARGE_CONST const uint8_t glyph_bitmap[] = {
    /* U+002D "-" */
    0x8, 0x88, 0x88, 0x88, 0x88, 0x88, 0x88, 0x88,
    0x88, 0x88, 0x60, 0xff, 0xff, 0xff, 0xff, 0xff,
    0xff, 0xff, 0xff, 0xff, 0xfc, 0xf, 0xff, 0xff,
    0xff, 0xff, 0xff, 0xff, 0xff, 0xff, 0xff, 0xc0,
    0xff, 0xff, 0xff, 0xff, 0xff, 0xff, 0xff, 0xff,
    0xff, 0xfc, 0xf, 0xff, 0xff, 0xff, 0xff, 0xff,
    0xff, 0xff, 0xff, 0xff, 0xc0, 0xff, 0xff, 0xff,
    0xff, 0xff, 0xff, 0xff, 0xff, 0xff, 0xfc, 0xf,
    0xff, 0xff, 0xff, 0xff, 0xff, 0xff, 0xff, 0xff,
    0xff, 0xc0, 0xff, 0xff, 0xff, 0xff, 0xff, 0xff,
    0xff, 0xff, 0xff, 0xfc,

    /* U+0030 "0" */
    0x0, 0x0, 0x0, 0x0, 0x0, 0x0, 0x0, 0x0,
    0x2, 0x56, 0x77, 0x65, 0x30, 0x0, 0x0, 0x0,
    0x0, 0x0, 0x0, 0x0, 0x0, 0x0, 0x0, 0x0,
    0x0, 0x0, 0x0, 0x0, 0x5, 0xbf, 0xff, 0xff,
    0xff, 0xff, 0xfd, 0x82, 0x0, 0x0, 0x0, 0x0,
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
    0x0, 0x6f, 0xff, 0xff, 0xff, 0xff, 0x0, 0x1f,
    0xff, 0xff, 0xff, 0xff, 0x0, 0x0, 0x0, 0x0,
    0x0, 0x0, 0x0, 0x0, 0x0, 0x2, 0xff, 0xff,
    0xff, 0xff, 0xf6, 0x2, 0xff, 0xff, 0xff, 0xff,
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
};


/*---------------------
 *  GLYPH DESCRIPTION
 *--------------------*/

static const lv_font_fmt_txt_glyph_dsc_t glyph_dsc[] = {
    {.bitmap_index = 0, .adv_w = 0, .box_w = 0, .box_h = 0, .ofs_x = 0, .ofs_y = 0} /* id = 0 reserved */,
    {.bitmap_index = 0, .adv_w = 444, .box_w = 21, .box_h = 8, .ofs_x = 3, .ofs_y = 16},
    {.bitmap_index = 84, .adv_w = 775, .box_w = 43, .box_h = 53, .ofs_x = 3, .ofs_y = -1},
    {.bitmap_index = 1224, .adv_w = 439, .box_w = 21, .box_h = 51, .ofs_x = 0, .ofs_y = 0},
    {.bitmap_index = 1760, .adv_w = 670, .box_w = 40, .box_h = 52, .ofs_x = 0, .ofs_y = 0},
    {.bitmap_index = 2800, .adv_w = 670, .box_w = 39, .box_h = 52, .ofs_x = 0, .ofs_y = -1},
    {.bitmap_index = 3814, .adv_w = 782, .box_w = 47, .box_h = 51, .ofs_x = 2, .ofs_y = 0},
    {.bitmap_index = 5013, .adv_w = 673, .box_w = 40, .box_h = 52, .ofs_x = 0, .ofs_y = -1},
    {.bitmap_index = 6053, .adv_w = 722, .box_w = 41, .box_h = 53, .ofs_x = 3, .ofs_y = -1},
    {.bitmap_index = 7140, .adv_w = 700, .box_w = 40, .box_h = 51, .ofs_x = 2, .ofs_y = 0},
    {.bitmap_index = 8160, .adv_w = 751, .box_w = 43, .box_h = 53, .ofs_x = 2, .ofs_y = -1},
    {.bitmap_index = 9300, .adv_w = 722, .box_w = 41, .box_h = 53, .ofs_x = 1, .ofs_y = -1}
};

/*---------------------
 *  CHARACTER MAPPING
 *--------------------*/

static const uint8_t glyph_id_ofs_list_0[] = {
    0, 0, 0, 1, 2, 3, 4, 5,
    6, 7, 8, 9, 10
};

/*Collect the unicode lists and glyph_id offsets*/
static const lv_font_fmt_txt_cmap_t cmaps[] =
{
    {
        .range_start = 45, .range_length = 13, .glyph_id_start = 1,
        .unicode_list = NULL, .glyph_id_ofs_list = glyph_id_ofs_list_0, .list_length = 13, .type = LV_FONT_FMT_TXT_CMAP_FORMAT0_FULL
    }
};

/*-----------------
 *    KERNING
 *----------------*/


/*Map glyph_ids to kern left classes*/
static const uint8_t kern_left_class_mapping[] =
{
    0, 1, 2, 0, 3, 4, 5, 6,
    7, 8, 0, 2
};

/*Map glyph_ids to kern right classes*/
static const uint8_t kern_right_class_mapping[] =
{
    0, 1, 2, 3, 4, 5, 6, 7,
    2, 8, 9, 10
};

/*Kern values between classes*/
static const int8_t kern_class_values[] =
{
    1, 6, -23, -17, -23, 6, 0, -12,
    0, 0, 6, 0, -1, -1, -12, 0,
    0, -6, 0, 0, -6, 0, 0, 0,
    0, -17, 0, 0, 0, 0, 0, 0,
    0, -6, -6, 0, -12, -12, 0, 0,
    12, 0, -29, 0, -12, 0, 0, -52,
    12, -6, 0, 0, 0, -6, -6, 0,
    -6, -15, 0, 0, 6, 0, 0, 0,
    0, 0, 0, -6, 0, 0, -58, -23,
    12, 0, -9, -75, -21, 0, -21, 0
};


/*Collect the kern class' data in one place*/
static const lv_font_fmt_txt_kern_classes_t kern_classes =
{
    .class_pair_values   = kern_class_values,
    .left_class_mapping  = kern_left_class_mapping,
    .right_class_mapping = kern_right_class_mapping,
    .left_class_cnt      = 8,
    .right_class_cnt     = 10,
};

/*--------------------
 *  ALL CUSTOM DATA
 *--------------------*/

#if LVGL_VERSION_MAJOR == 8
/*Store all the custom data of the font*/
static  lv_font_fmt_txt_glyph_cache_t cache;
#endif

#if LVGL_VERSION_MAJOR >= 8
static const lv_font_fmt_txt_dsc_t font_dsc = {
#else
static lv_font_fmt_txt_dsc_t font_dsc = {
#endif
    .glyph_bitmap = glyph_bitmap,
    .glyph_dsc = glyph_dsc,
    .cmaps = cmaps,
    .kern_dsc = &kern_classes,
    .kern_scale = 16,
    .cmap_num = 1,
    .bpp = 4,
    .kern_classes = 1,
    .bitmap_format = 0,
#if LVGL_VERSION_MAJOR == 8
    .cache = &cache
#endif
};



/*-----------------
 *  PUBLIC FONT
 *----------------*/

/*Initialize a public general font descriptor*/
#if LVGL_VERSION_MAJOR >= 8
const lv_font_t montserrat_bold_72 = {
#else
lv_font_t montserrat_bold_72 = {
#endif
    .get_glyph_dsc = lv_font_get_glyph_dsc_fmt_txt,    /*Function pointer to get glyph's data*/
    .get_glyph_bitmap = lv_font_get_bitmap_fmt_txt,    /*Function pointer to get glyph's bitmap*/
    .line_height = 53,          /*The maximum line height required by the font*/
    .base_line = 1,             /*Baseline measured from the bottom of the line*/
#if !(LVGL_VERSION_MAJOR == 6 && LVGL_VERSION_MINOR == 0)
    .subpx = LV_FONT_SUBPX_NONE,
#endif
#if LV_VERSION_CHECK(7, 4, 0) || LVGL_VERSION_MAJOR >= 8
    .underline_position = -7,
    .underline_thickness = 4,
#endif
    .dsc = &font_dsc,          /*The custom font data. Will be accessed by `get_glyph_bitmap/dsc` */
#if LV_VERSION_CHECK(8, 2, 0) || LVGL_VERSION_MAJOR >= 9
    .fallback = NULL,
#endif
    .user_data = NULL,
};



#endif /*#if MONTSERRAT_BOLD_72*/
