Pcfccn/Dash/Core/Src/montserrat_bold_28.c

/*******************************************************************************
 * Size: 28 px
 * Bpp: 4
 * Opts: --font Montserrat-SemiBold.ttf -r 0x20-0x7F --size 28 --format lvgl --bpp 4 --no-compress --force-fast-kern-format -o montserrat_bold_28.c
 ******************************************************************************/

#ifdef LV_LVGL_H_INCLUDE_SIMPLE
#include "lvgl.h"
#else
#include "lvgl.h"
#endif

#ifndef MONTSERRAT_BOLD_28
#define MONTSERRAT_BOLD_28 1
#endif

#if MONTSERRAT_BOLD_28

/*-----------------
 *    BITMAPS
 *----------------*/

/*Store the image of the glyphs*/
static LV_ATTRIBUTE_LARGE_CONST const uint8_t glyph_bitmap[] = {
    /* U+0020 " " */

    /* U+0021 "!" */
    0x2f, 0xff, 0xf0, 0x1f, 0xff, 0xe0, 0xf, 0xff,
    0xd0, 0xf, 0xff, 0xc0, 0xe, 0xff, 0xb0, 0xd,
    0xff, 0xb0, 0xd, 0xff, 0xa0, 0xc, 0xff, 0x90,
    0xb, 0xff, 0x80, 0xa, 0xff, 0x70, 0x9, 0xff,
    0x60, 0x9, 0xff, 0x60, 0x8, 0xff, 0x50, 0x0,
    0x0, 0x0, 0x0, 0x32, 0x0, 0xc, 0xff, 0x90,
    0x4f, 0xff, 0xf0, 0x3f, 0xff, 0xf0, 0x7, 0xee,
    0x50,

    /* U+0022 "\"" */
    0x6f, 0xf9, 0x0, 0xff, 0xf6, 0xff, 0x80, 0xf,
    0xff, 0x5f, 0xf8, 0x0, 0xff, 0xe5, 0xff, 0x70,
    0xe, 0xfe, 0x4f, 0xf7, 0x0, 0xef, 0xd4, 0xff,
    0x60, 0xd, 0xfd, 0x3f, 0xf6, 0x0, 0xdf, 0xc2,
    0xbb, 0x30, 0x8, 0xb8,

    /* U+0023 "#" */
    0x0, 0x0, 0x0, 0xcf, 0xb0, 0x0, 0x8, 0xff,
    0x0, 0x0, 0x0, 0x0, 0x0, 0xff, 0x90, 0x0,
    0xb, 0xfd, 0x0, 0x0, 0x0, 0x0, 0x1, 0xff,
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
    0x8f, 0xff, 0xff, 0xc2, 0x0, 0xaf, 0xd0, 0x1f,
    0xfe, 0xad, 0xff, 0xfa, 0xbf, 0xf9, 0x5, 0xff,
    0x20, 0x8, 0xff, 0xff, 0xfe, 0x10, 0x7f, 0xd0,
    0x0, 0x2, 0xbf, 0xfb, 0x20, 0x0
};


/*---------------------
 *  GLYPH DESCRIPTION
 *--------------------*/
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
