Pcfccn/Dash/Core/Src/montserrat_bold_48.c

/*******************************************************************************
 * Size: 48 px
 * Bpp: 4
 * Opts: --font Montserrat-SemiBold.ttf -r 0x20-0x7F --size 48 --format lvgl --bpp 4 --no-compress --force-fast-kern-format -o montserrat_bold_48.c
 ******************************************************************************/

#ifdef LV_LVGL_H_INCLUDE_SIMPLE
#include "lvgl.h"
#else
#include "lvgl.h"
#endif

#ifndef MONTSERRAT_BOLD_48
#define MONTSERRAT_BOLD_48 1
#endif

#if MONTSERRAT_BOLD_48

/*-----------------
 *    BITMAPS
 *----------------*/

/*Store the image of the glyphs*/
static LV_ATTRIBUTE_LARGE_CONST const uint8_t glyph_bitmap[] = {
    /* U+0020 " " */

    /* U+0021 "!" */
    0xc, 0xff, 0xff, 0xff, 0x30, 0xcf, 0xff, 0xff,
    0xf2, 0xb, 0xff, 0xff, 0xff, 0x20, 0xaf, 0xff,
    0xff, 0xf1, 0x9, 0xff, 0xff, 0xff, 0x0, 0x8f,
    0xff, 0xff, 0xf0, 0x8, 0xff, 0xff, 0xfe, 0x0,
    0x7f, 0xff, 0xff, 0xd0, 0x6, 0xff, 0xff, 0xfd,
    0x0, 0x5f, 0xff, 0xff, 0xc0, 0x4, 0xff, 0xff,
    0xfb, 0x0, 0x3f, 0xff, 0xff, 0xa0, 0x3, 0xff,
    0xff, 0xf9, 0x0, 0x2f, 0xff, 0xff, 0x80, 0x1,
    0xff, 0xff, 0xf8, 0x0, 0xf, 0xff, 0xff, 0x70,
    0x0, 0xff, 0xff, 0xf6, 0x0, 0xf, 0xff, 0xff,
    0x50, 0x0, 0xef, 0xff, 0xf4, 0x0, 0xd, 0xff,
    0xff, 0x30, 0x0, 0xcf, 0xff, 0xf2, 0x0, 0xb,
    0xff, 0xff, 0x20, 0x0, 0x58, 0x88, 0x80, 0x0,
    0x0, 0x0, 0x0, 0x0, 0x0, 0x0, 0x0, 0x0,
    0x0, 0x0, 0x0, 0x0, 0x0, 0x0, 0x4, 0x76,
    0x10, 0x0, 0x1c, 0xff, 0xff, 0x50, 0xb, 0xff,
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
    0x0, 0x0, 0x0, 0xdf, 0xff, 0xff, 0xff, 0xfa,
    0xbf, 0xff, 0x50, 0x0, 0x0, 0x0, 0x0, 0x0,
    0x0, 0x3f, 0xff, 0xff, 0xff, 0xff, 0xff, 0xff,
    0x70, 0x0, 0x0, 0x0, 0x0, 0x0, 0x0, 0x6,
    0xff, 0xff, 0xff, 0xff, 0xff, 0xff, 0xff, 0xb6,
    0x20, 0x0, 0x0, 0x0, 0x0, 0x0, 0x4e, 0xff,
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
