Pcfccn/Dash/(commit log)

2026-07-15 Initial commit: STM32H743 Colorado 3-page instrument cluster
    WeAct MiniSTM32H743 + ILI9488 4" (SPI2, portrait 320x480) + on-board
    ST7735 0.96" status screen (SPI4) + SN65HVD230 FDCAN transceiver.
    LVGL 9 + FreeRTOS. 3-page cluster (DRIVE/DPF/DIAG) with read-only OBD-II
    polling over FDCAN1 @500kbit/s. Page switching via KEY (PC13).
2026-07-15 Rich cluster UI closer to HTML + high-contrast status screen
    4" cluster: warn/crit tick markers on gauges, status symbols in the alert
    strip and DIAG page, colored threshold swatches on DPF.
    ST7735 status screen: black bg, big white speed, bright green/red CAN link,
    white battery/rpm, kept uptime, removed title; page# folded into KEY line.
    Includes the FreeRTOS defaultTask stack bump (4->16 KB) that fixed the
    render freeze, plus LVGL heap 128 KB and FreeRTOS heap 64 KB.
    [cluster_ui.c, st7735_status.c]
2026-07-16 Panel-tuned dark theme, SemiBold numbers, demo mode, cold/coolant states
    - Pure-black bg + outline cards + white labels (ILI9488 fogs grey fills/text)
    - Values coloured by state (green/blue/amber/red); softer template green 37d67a
    - Cold temperature <50C shows light blue (engine warming up)
    - COOLANT thresholds warn 93C / crit 97C
    - Montserrat SemiBold for the big numbers (generated fonts in Core/Src)
    - Status symbols in alert strip and DIAG page
    - OBD_DEMO bench mode: synthetic values + coolant sweep 40..100 (set 0 for car)
    - ILI9488 VCOM nudged; small status screen high-contrast + bold speed
2026-07-17 Add Graphify knowledge graph + config; drop redundant CLAUDE.md
    graphify-out/ (graph.json/html + report) committed so other clones/agents
    query the graph instead of scanning files. .graphifyignore scopes it to
    Core/. post-commit hook (local) rebuilds it; graph.json union merge-driver
    in .gitattributes.
2026-07-17 UI: port cluster to Diesel_Cluster_v2_3 design
    - rail: per-tag state underlines; monitored systems green when healthy,
    MIL/DTC grey when nominal; summary text -> "NOMINAL"
    - replace per-page topbar with calibration eyebrow (cal ID + page name);
    drop CAN/IDLE/DTC chips (state already shown in the rail)
    - DRIVE hero: gear | speed | boost+rpm column; boost cyan, no bars;
    IAT off DRIVE; 2x2 grid takes the reclaimed height
    - add GEAR metric (obd_data_t.gear, M_GEAR); demo D6, real TCM DID TBD
    - DPF: EGR -> "EGR T", fuller regen / threshold labels
    - DIAG: circular status badge (check / ! / -) in the codes box
    - design html: fix eyebrow hidden behind the absolute rail (.brow margin)
    Co-Autho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
    [cluster_config.h, cluster_ui.c, fdcan_obd.c, fdcan_obd.h]
2026-07-17 KEY backlight control + PE3 level indicator
    - PC13: 3 s hold toggles backlight mode; in that mode a short press steps
    the duty +10% (10..100, wraps back to 10) via TIM1_CH1; otherwise a
    short press still cycles the cluster page as before
    - PE3 heartbeat is now a blink code: (backlight% / 10) short pulses then
    a long gap, so the LED shows the current backlight level while still
    signalling that the loop is alive
    [app_main.c]
2026-07-19 Add backlight-level overlay to the status screen
    Shows the current backlight duty (%) full-screen on the small ST7735
    display while the KEY gesture is in brightness-control mode. Also sets
    BACKLIGHT_DUTY_PCT to 0 at boot as a diagnostic to confirm the MOSFET
    is in the backlight current path (revert to 100 once confirmed).
    [app_main.c, st7735_status.c, st7735_status.h]
2026-07-19 Add CLAUDE.md, rebuild knowledge graph, stop tracking machine-specific graphify files
    CLAUDE.md documents the project architecture and the AppMain/cluster_app/
    fdcan_obd/cluster_ui call flow for future Claude Code sessions. graphify-out
    is refreshed to match current code, and .graphify_python/.graphify_root
    (local interpreter path and scan root, both machine-specific) are dropped
    from tracking and ignored going forward.
2026-07-19 Document auto-commit/push policy in CLAUDE.md
    Push directly to main after each logical change, no confirmation gate:
    no CI or compile check is reachable from this shell, so waiting for one
    would just stall forever. Real validation happens on hardware.
2026-07-19 Add docs/wiring.md: hardware reference from WeAct's official examples
    Distills board specs, confirmed pinout, and vendor-example behavior for
    the MiniSTM32H743 core board (status LED, KEY button, onboard ST7735
    SPI4 wiring, unused onboard flash/SD/DCMI) from WeActStudio/MiniSTM32H7xx,
    and separates that from what this project added itself (main ILI9488 on
    SPI2, FDCAN1 + external CAN transceiver, backlight PWM). Fills in the
    docs/wiring.md reference already pointed to from a comment in app_main.c.
2026-07-19 docs/wiring.md: add the three external modules as purchased
    Documents the actual add-on hardware identified from the AliExpress order:
    - Main 4" display: generic "4.0'' TFT SPI 480X320 V1.0" red module, ILI9488,
    no-touch variant, with an unused onboard microSD slot (separate SPI header).
    - Backlight control: Si4599 N+P 40V MOSFET module on TIM1_CH1/PA8. Flags that
    the app_main.c comment still says "IRF520" — a discrepancy to reconcile.
    - CAN: SN65HVD230 (VP230) 3.3V transceiver, matches cluster_config.h.
2026-07-19 docs/wiring.md: explain why backlight needs a P-channel MOSFET
    The IRF520 (N-channel, low-side switch) can't drive this backlight: the
    backlight's minus is on common ground, so there's no low side to break.
    High-side switching on the plus rail is required, which needs a P-channel
    MOSFET (the Si4599's P-channel device). Also notes the resulting inverted
    gate polarity (gate LOW = backlight ON), consistent with the existing
    BACKLIGHT_DUTY_PCT=0 diagnostic in app_main.c.
2026-07-19 cluster_ui: match design proportions — bigger SPEED, units, filled cards
    Brings the LVGL render closer to the HTML mockup after comparing against
    browser-rendered references at 320x480:
    - SPEED now uses a new 72px bold font (montserrat_bold_72, digits+'-' only,
    generated from Montserrat-SemiBold via lv_font_conv) instead of 48px, so
    it dominates like the design. GEAR bumped 28->48px.
    - New mk_value() helper renders "89°C" / "3.1kPa" with the unit hugging the
    number (baseline-aligned inline) instead of floating at the card corner.
    Applied to DRIVE grid (adds °C), SOOT ring (adds %), DPF mini + DIAG stat
    cards; stat values bumped 24->28px.
    - DPF mini-cards and DIAG stat-cards en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
2026-07-19 Add VS Code build/flash/debug config; document CLI build via STM32CubeCLT
    STM32CubeCLT is now installed, so the project builds and links from the
    shell (validated: cluster_ui.c + montserrat_bold_72 compile clean, Dash.elf
    links). Wires that into VS Code and CLAUDE.md:
    - .vscode/tasks.json: Build (make all), Clean, Flash (STM32_Programmer_CLI),
    with the CubeCLT bins on PATH.
    - .vscode/launch.json: ST-LINK debug via Cortex-Debug + the H743 SVD.
    - .vscode/c_cpp_properties.json: include paths + defines for IntelliSense.
    - CLAUDE.md: CLI build steps and two makefile gotchas — must use `make all`
    (bare `make` hits the clean default-goal and wipes the build), and a new
    Core/Src file needs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
2026-07-19 Wire up graphify: Claude Code hooks, auto-update, refreshed graph
    - Add .claude/settings.json PreToolUse hooks (graphify consulted before
    Bash/Grep/Read/Glob) so the knowledge graph is used before raw file search.
    - Append graphify usage section to CLAUDE.md (correct CLI: query/path/explain/update).
    - .graphifyignore: skip .claude/ and .vscode/ tooling config (were zero-node warnings).
    - .gitignore: ignore dated graph backups (graphify-out/20*/) and
    .claude/settings.local.json (per-machine, may hold secrets).
    - Rebuild graph against current firmware (190 nodes, 316 edges, 27 communities).
    Auto-update is via git post-commit/post-checkout hooks + a graph.json merge
    driver (installed per-m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
2026-07-19 Fix KEY reliability + brightness label overflow on status screen
    KEY (PC13): the tap was only accepted on release when the press spanned
    >=40 ms of *sampled* time. A quick tap caught in a single superloop
    iteration measured ~0 ms and was dropped ("button doesn't always react").
    Rework the gesture FSM to fire the tap on the release edge regardless of
    held duration, with a 30 ms edge-debounce to reject contact bounce; the
    3 s hold-to-toggle gesture is unchanged.
    Status screen (ST7735, 80px wide): the "BRIGHTNESS" caption in the
    backlight overlay used montserrat_14 (~84px) and had no width, so it
    overflowed off both edges. Drop it to montserrat_12, give both the caption
    and the value the full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
    [app_main.c, st7735_status.c]
2026-07-19 graphify: drop auto-rebuild git hooks + graph.json merge driver
    Keep the knowledge graph committed (browsable on GitHub) but remove the
    post-commit/post-checkout hooks: they re-stamped graph.json with each new
    commit hash (built_at_commit), leaving the working tree perpetually dirty.
    New workflow: rebuild the graph with `graphify update .` (AST-only, zero
    API cost) right before committing code changes and include it in that same
    commit. No background rebuild, so the tree stays clean between changes.
2026-07-19 Disable demo mode + add in-vehicle install guide
    - cluster_config.h: OBD_DEMO 1 -> 0 (read real OBD-II over CAN, not synthetic
    bench values). Required before use in the car.
    - docs/vehicle-install.md: end-to-end guide to run in the RG Colorado --
    12V->5V buck power off a switched circuit (not OBD pin 16 constant),
    SN65HVD230 to OBD pin 6/14 with the critical 60R-vs-40R termination warning,
    read-only safety, KOEO bring-up sequence, and the enhanced-DID / backlight
    polarity caveats.
2026-07-19 Record researched enhanced DIDs for the 2.8 LWN / E98 in the PID map
    From GM/Torque/EFILive community sources (unverified on this car):
    - ATF/trans fluid temp: mode 22 DID 0x1940, A-40 degC, TCM on 7E2/7EA [H]
    - Current gear: mode 22 DID 0x199A on 7E2/7EA, scaling TBD [M]
    - EGR temp: standard J1979 mode 01 PID 6B (multi-byte) [M]
    - DPF soot % / DPF delta-p / distance-since-regen: GM-guarded or year-specific,
    best discovered on the car [L]
    Also documents that the transmission controller answers on 7E2/7EA (not the
    7E1/7E9 assumed by SRC_TCM) and that the RX filter must widen to accept 0x7EA.
    NOTE: the poller (fdcan_obd.c) is still mode-01-only and doesn't read pid_map[],
    so these are docu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
    [cluster_config.h]
2026-07-19 Poll GM-enhanced metrics: mode 22 ATF temp + gear, standard EGR temp
    Implements the enhanced-metric polling the DID research pointed to. The proven
    mode-01 path is untouched; a parallel mode-22 path is added alongside.
    fdcan_obd.c:
    - req_mode22() + decode_mode22() (0x62 responses).
    - obd_poll_tick(): request ATF temp (DID 0x1940) and gear (DID 0x199A) from the
    trans controller on 0x7E2, and EGR temp (std PID 0x6B) in its own frame.
    - decode_mode01(): PID 0x6B -> egr_t = B-40 degC.
    - RX widened to accept 0x7EA (trans controller): filter is now a 0x7E8..0x7EA
    range and the accept guard matches.
    cluster_config.h: add OBD_REQ_TCM2/OBD_RESP_TCM2 (0x7E2/0x7EA); pid_map notes
    which DIDs are n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
2026-07-19 docs/vehicle-install: add full connection & power map appendix
    Consolidated wiring reference: 5V-rail power distribution tree, the exact
    MCU-pin-to-module signal table (SPI2 PB13/PB15/PB14, CS/DC/RST PC0/PC4/PC5,
    backlight PA8, CAN PD0/PD1), and a voltage/current limits table (incl. the
    SN65HVD230 3.3V-only warning and the onboard DC-DC 1A cap).
2026-07-19 docs/vehicle-install: correct power to match actual wiring
    Real bench wiring: 4" panel VCC on the board's 3.3V, backlight on the board's
    5V -- so everything is fed through the WeAct board. Updated the guide to say:
    feed the buck's 5V into the board's `5V` header pin (no power jack; that pin is
    the unprotected USB 5V net, so don't dual-feed with USB), and the board fans out
    5V to the backlight and 3.3V to VCC/transceiver/MCU. Fixed the power tree and the
    voltage/current table (VCC is 3.3V, not 5V) accordingly.
2026-07-19 docs/vehicle-install: schematic-accurate board power input
    Confirmed against the WeAct V1.2 schematic (02-DC-DC.SchDoc): USB-C VBUS -> D10
    Schottky -> 5V rail -> DC-DC (SY8088/TLV62569) -> 3V3. External supply goes to
    the V+ / GND input pair (the 5V rail, same net as the header 5V pins); 3V3 is the
    regulator output and VBAT is RTC-only. USB is diode-isolated from the 5V rail by
    D10, so the continuity check to USB 5V reads a diode drop, not a short.
2026-07-19 obd: only send Flow Control for transfers we requested
    The OBD port is often shared with a scan tool / insurance dongle / logger.
    Those poll too, and their multi-frame replies arrive on the same
    0x7E8..0x7EA IDs we listen to. obd_rx_poll() answered *every* First Frame
    with a Flow Control frame, so with a second tester present the ECU got two
    FC frames for one transfer — corrupting the multi-frame read for both sides
    (mode 22 enhanced DIDs, mode 03 DTC lists). The shared itp_* reassembly
    buffer could also be clobbered mid-transfer by the other tool's traffic.
    Adds a single outstanding-request slot (expect_reply/reply_is_ours): each
    request arms the expected response id (req + 8) with a 50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
2026-07-19 OBD: report "no data" honestly; fix EGT/baro/boost decode
    The in-vehicle KOEO test showed several gauges reading a confident 0 for
    values the ECM never sent, and every mode-22 metric permanently dashed out
    regardless of what arrived on the bus. Both were the UI trusting the wrong
    signal.
    - g_obd floats now start as NaN ("never received"). The UI gates on that
    instead of the old is_enhanced() blacklist, which hid real data the moment
    a DID started working and showed 0.0 V / 0 degC for unsupported PIDs.
    Alert-strip tags gate the same way: metric_state() on NaN would silently
    report ST_OK, and the bogus BATT 0.0 V was what tripped "CHECK".
    - PID 0x78 (EGT) was decoded as A,B with a 2-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
    [app_main.c, cluster_ui.c, fdcan_obd.c, fdcan_obd.h, st7735_status.c]
2026-07-20 design: 8 dashboard concept mockups across distinct visual directions
    Each is a self-contained 320×480 HTML mockup with all 3 pages (Drive/DPF/Diag)
    and full tab switching, covering genuinely different gammas and layouts:
    01 military-amber — Courier mono, amber/gold, square borders, [bracket] labels
    02 deep-space — cyan on deep navy, centered speed ring, horizontal sensor rows
    03 race-telemetry — white/red on near-black, massive speed top, horizontal gauge strips
    04 phosphor-terminal — monochrome green only, CRT scanlines, ASCII bar gauges
    05 arctic-ice — ice blue, pill-shaped rounded cards, spacious layout
    06 copper-analog — conic arc gauges (270° sweep) in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
2026-07-20 OBD: fix multi-frame reply gate; gear DID is a ratio, not a range
    The road test explained every remaining "--" at once. Single-frame replies
    (coolant, IAT, ATF, gear) decoded fine while every multi-frame one -- SPEED,
    RPM, LOAD, BOOST, BATT, RAIL, EGT -- never arrived. Those are exactly the
    PIDs whose grouped responses exceed 7 bytes.
    Cause: the outstanding-request slot expired on a 50 ms wall clock, but
    lv_port_disp flushes the 320x480 panel with a blocking row-by-row
    HAL_SPI_Transmit, so a superloop iteration can run several hundred ms. The
    deadline had always passed by the time obd_rx_poll() next ran, so First
    Frames were dropped and no Flow Control was ever sent. Single frames survived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
    [cluster_ui.c, fdcan_obd.c]
2026-07-20 Add a CAN change-detector page to find the unmapped signals
    The selector range is needed and no OBD identifier we have found reports it.
    0x199A turned out to be the engaged gear ratio, and brute-forcing 65536 DIDs
    would take half an hour per module with no guarantee. But the OEM cluster
    displayed PRNDL, so it is broadcast as an ordinary frame on the 500 kbps
    HS-CAN -- the answer is on the bus already, we were just not listening to it.
    New SNIFF page (4th, workbench-only): watches every byte of every standard ID
    and lists the ones that changed most recently. Parked with the ignition on,
    almost nothing on the bus moves, so operating one control makes exactly its
    byte surface at the top. Bytes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
2026-07-20 Record the verified PID/DID map and the two g_obd conventions
    The in-vehicle results were living only in commit messages, so the next
    session would have re-derived them by guessing -- which is how the gear DID
    got a wrong P/R/N table in the first place. CLAUDE.md now states what this
    truck actually answers, that 0x199A is the engaged ratio rather than the
    selector range, and that a grouped mode-01 reply silently omits unsupported
    PIDs instead of returning an NRC (so a missing value there yields no NRC and
    is not evidence of a fault).
    Also documents the two conventions that are easy to break by "fixing" them:
    g_obd floats start as NaN so an unsupported PID cannot render as a believable
    zero,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
2026-07-21 SNIFF: show full-frame payloads to pin down the selector value map
    The road-test sweep (P-R-N-D-manual 1-2-3-2-1-D-N-R-P) narrowed the selector
    to one frame -- 0x1F5, byte 3 stepped 00/01/02/03/04 on the detents while its
    byte 0 was just a message counter (1A1 and 0F9 are weaker candidates). But the
    per-byte "recently changed" digest cannot say WHICH detent maps to which
    value: a snapshot is not annotated with the lever position at capture.
    So the SNIFF page now lists one row per recently-changed frame with its whole
    8-byte payload (can_sniff_top_ids + can_sniff_get), chatty frames still ranked
    out. Stepping the lever one detent at a time and photographing each row yields
    an unambiguous val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
2026-07-21 SNIFF: show CAN frame rate + bus health to explain a frozen table
    A live-vehicle sniff froze at FRAMES 77 / 30 IDs, everything 20-50 s stale.
    From the table alone "bus asleep" and "we stopped receiving" are
    indistinguishable, and the RX path is byte-identical to the build that
    happily reached 3700+ frames earlier -- so guessing which it was is pointless.
    Instrument it instead.
    The SNIFF status line now leads with frames-per-second and CAN controller
    health:
    - fps 0 (amber) = no traffic arriving: bus asleep / not connected / ignition
    not in RUN. Procedural, not a firmware fault.
    - fps nonzero (green) = receiving; a frozen row table then means the tracked
    bytes genuinely are not moving.
    -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
2026-07-21 SNIFF: rank bytes by distinct-value count to isolate the selector
    The live-bus sweep confirmed the bus is fine (48 fps) but also why the
    "recently changed" digest could not pin the selector: with the transmission
    active, many frames carry live counters that change every message, so
    most-recently-changed is dominated by noise and several bytes of 1F5 wiggle at
    once. Reading a clean staircase off the photos by eye is unreliable -- it is
    what produced a wrong P/R/N map once already.
    The discriminating property of a selector is cardinality, not recency: a PRNDL
    byte only ever takes the ~8 detent codes and holds each for seconds, while a
    counter saturates. So the sniffer now records the distinct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
    [can_sniff.c, can_sniff.h, cluster_ui.c]
2026-07-21 docs: transcribe both SNIFF runs and identify the selector frame
    All 29 photos from the two in-vehicle runs transcribed to text so the whole
    capture can be analysed at once rather than two IDs at a time.
    Finding: the selector is 0x1F5 byte 3, which takes exactly {01,02,03,04} and
    steps them in physical detent order across both sweeps (rests at 01 at the
    start and end of every run) -> 01=P 02=R 03=N 04=D. While in D, 1F5 byte 2
    carries the manual/commanded gear (0x11/12/13) and byte 5 is a manual-mode
    flag. 0F9 (the other guess) is ruled out: its live bytes sweep a wide
    continuous range, i.e. a 16-bit sensor, not a discrete selector.
    Bus health from these runs also settled the earlier "froz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
2026-07-21 Decode 0x1F5 selector (live P/R/N/D) + add ANALOG span view to SNIFF
    Two things:
    1. Selector, finished. 0x1F5 byte 3 (identified in docs/sniff-selector.md) is
    now accepted through a second RX filter -- it is a broadcast frame, not an
    OBD response, so the narrow OBD filter rejected it -- and decoded to
    g_obd.sel_range (1 P / 2 R / 3 N / 4 D). The DRIVE gear card shows real
    P/R/N/D, D in nominal green, replacing the old engaged-ratio number that
    could not express park/reverse/neutral. StdFiltersNbr bumped 1->2 in
    fdcan.c to allocate the extra filter.
    2. The other dashes. The candidate view finds selectors (few distinct values)
    but hides analogue signals: a coolant/oil/EG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
    [can_sniff.c, can_sniff.h, cluster_config.h, cluster_ui.c, fdcan_obd.c, fdcan_obd.h]
2026-07-21 Selector: show engaged gear number in D (e.g. "D3")
    In D the gear card now appends the engaged gear from DID 0x199A (g_obd.gear,
    which the road test confirmed follows D1/D2/D3), rendered as the design's
    white letter + green number. Falls back to bare "D" until the gear number
    arrives. P/R/N unchanged.
2026-07-21 Add GM-enhanced oil pressure + oil temp DIDs (mode 22)
    Apps like Car Scanner read these via manufacturer mode-22 DIDs, not standard
    PIDs. Researched the GM/Colorado set (docs/enhanced-dids.md) -- the trans-temp
    DID it lists, 0x1940, matches the ATF DID already working here, which
    cross-validates the source.
    - Oil temp: switch from standard 0x5C (this E98 never answers it) to enhanced
    DID 0x1154 (A-40). Feeds the existing DRIVE "OIL" tile, so it lights up with
    no UI change.
    - Oil pressure: new DID 0x1470, A*(116/256) psi -> bar, into g_obd.oil_press.
    - Both requested from the ECM (0x7E0) via a rotating probe slot in
    obd_poll_tick step 6 (which also still probes the unanswered 0x6B/0x78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
2026-07-21 Probe standard diesel PIDs and surface raw replies for the remaining dashes
    No open source has verified scaling for the LWN 2.8 diesel-emissions set (DPF
    differential pressure, DPF temp, soot, aftertreatment status) and the Colorado
    forums are paywalled, so guessing formulas blind is a dead end. Instead, use
    the truck as the oracle:
    - obd_poll_tick step 6 now rotates one diesel PID per cycle -- 0x78 EGT, 0x6B
    EGR, 0x7A DPF dp, 0x7C DPF temp, 0x8B aftertreatment, 0x86 PM -- plus the two
    working oil DIDs. One PID per request (never grouped) so an unsupported wide
    PID cannot desync the parse.
    - Unknown PIDs are captured raw into g_obd.probe_* and shown on a second DIAG
    line as "PID xx: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
2026-07-21 graphify: rebuild for diesel PID probes
2026-07-21 Add DPF soot/dP/regen/since-regen via Opel Astra-K GM diesel DIDs
    The Colorado forums are paywalled, but the Opel/Vauxhall Astra-K community
    posts the same GM Global-B diesel extended PIDs openly, and that DID block
    (22 30xx / 33xx / 20xx) is the same family as this E98. Added to the mode-22
    ECM probe rotation and decoded:
    - DPF soot % DID 0x336A A*100/255 -> g_obd.soot (SOOT arc)
    - Distance to regen DID 0x3039 A*256+B km -> g_obd.since_regen
    - DPF diff pressure DID 0x20F4 SIGNED(A) kPa -> g_obd.dpf_dp
    - DPF regen status DID 0x20F6 A&1 -> regen_active (DPF page text)
    These feed the DPF-page tiles that were dashed, so they light up the moment
    the DIDs answer. Cross-c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
2026-07-21 Split mode-01 polls to single-frame so core gauges read again
    In-vehicle the fast (rpm/speed/load/MAP) and misc (rail/batt/baro/MIL)
    groups painted "--" while temps (cool/iat) worked. The discriminator is
    frame count: temps' reply fits one CAN frame (oil 0x5C unsupported keeps
    it short), but the 4-PID groups return 10-14 bytes needing multi-frame
    ISO-TP, which does not survive the polled RX across the blocking display
    flush on this E98. Single-frame replies always arrive.
    Split into fastA={0C,0D}, fastB={04,0B,33}, misc={23,42}, mil={01};
    scheduler 8->10 steps, fastA polled twice per cycle. Every grouped
    mode-01 request is now <=7 payload bytes.
    Also guard DID 0x3039 (distance since regen)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
    [fdcan_obd.c]
2026-07-21 DRIVE: drop the vehicle-ID eyebrow text, add oil pressure tile
    Remove the "COLORADO 2.8 / E98 / 500 kbit/s" label from the eyebrow bar
    (kept the page name on the right) — it carried no live information.
    Add an OIL P tile to the DRIVE 2x2 grid in place of EGT, which was a
    duplicate of the EGT tile already on the DPF page. New metric M_OILP
    (THR_WINDOW, 0-7 bar, low-side warn/crit) sourced from g_obd.oil_press
    (DID 0x1470). Per-tile units array so the 4th tile reads "bar" not degC.
    NOTE: this E98 currently rejects DID 0x1470 with NRC 22/31, so the tile
    reads "--" until a supported oil-pressure DID is found; the readout is
    wired and ready for when it is.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
2026-07-21 DRIVE: drop empty eyebrow, reclaim space; hunt oil-pressure DID 0x115C
    DRIVE page no longer draws the eyebrow bar (it only held the page name
    after the vehicle-ID text was removed). Hero starts at y0 and the metric
    grid grows into the reclaimed 28px: taller tiles (cell 137->149px), hero
    128px with content re-centred.
    Oil pressure: 0x1470 is rejected by this E98 (NRC 22/31). Switch the
    probe + decode to 0x115C, the Colorado-community oil-pressure DID that
    sits right next to the working oil-temp 0x1154, formula (A*0.65-17.5)
    psi->bar. If OILP populates and NRC 22/31 clears on the next drive, the
    DID is confirmed; scaling is provisional and calibrated from the raw
    byte shown on DIAG. 0x1470 de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
    [cluster_config.h, cluster_ui.c, fdcan_obd.c]
2026-07-21 Full-screen alert border + bright-orange reverse gear
    Add a transparent-centre border overlay on top of every page:
    - red when any parameter is critical (high coolant, MIL, CAN lost, ...)
    reusing the alert strip's `worst` state,
    - bright orange (0xff7a1a) when reverse is engaged (selector 0x1F5 == R),
    red outranks reverse.
    The reverse "R" gear letter itself also glows the same bright orange;
    other ranges keep the white base (D still recolors its number green).
    The overlay is non-interactive (input is the physical KEY button) and
    hidden until refresh() picks a colour.
    [cluster_ui.c]
2026-07-21 Demo: scripted 40s scenario to bench-check the new visuals
    Rewrote obd_demo_tick() from a static cruise into a 40s loop that walks
    DRIVE cruise (green) -> REVERSE (orange full-screen border + orange "R")
    -> PARK -> coolant climbing past 93/97 into the red border. Also sets
    sel_range and oil_press so the selector-based gear and the new OIL P
    tile render in demo.
    OBD_DEMO is committed as 0 (main stays vehicle-safe per CLAUDE.md); flip
    it to 1 in cluster_config.h to build the simulation. The bench board was
    flashed with the =1 build for this check.
    [fdcan_obd.c]
2026-07-23 obd: tiered poll scheduler — RPM/speed fast, temps/probes slow
    Replace the flat 10-step round-robin in obd_poll_tick() with a
    three-band priority scheduler keyed off a tick counter:
    fast (default, ~2/3 of ticks): alternate fastA (rpm+speed) and
    fastB (load+MAP+baro). At 25 ms/tick → RPM every ~80 ms;
    even at 300 ms/tick (display-blocked loop) → ~500 ms vs the
    old ~1500 ms.
    medium (every 3 ticks): rail+batt, ATF, gear, temps, MIL, DTC,
    oil-pressure. Each item hits every ~560 ms at 25 ms/tick.
    slow (every 16 ticks): enhanced-DID probes + diesel mode-01 PIDs
    (EGT, soot, DPF, …), one per slow tick — full rotation every
    N_PROB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
    [fdcan_obd.c]
2026-07-23 obd: fix false 0.0 bar oil-pressure CRIT; document DID 0x115C failure
    DID 0x115C confirmed NRC 22/31 (requestOutOfRange) on this specific E98
    with engine running (2026-07-23). The DID is simply not in this ECM's
    table. Two fixes:
    1. decode_mode22 0x115C: only commit psi > 0; A=0 (KOEO fluke where
    the ECM briefly answered before refusing) decoded to -17.5 psi →
    clamped to 0.0 bar → false CRIT alert on the dash. Now leaves NaN
    so the gauge shows "--" instead of a red 0.0.
    2. docs/enhanced-dids.md: mark 0x115C as confirmed-failed alongside
    0x1470; add note to scan with BiScan/Torque for the real DID.
    LOAD 18% at cold idle 1056 RPM confirmed correct (PID 0x04 calculated
    load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
    [fdcan_obd.c]
2026-07-23 obd: tiered poll scheduler + passive CAN oil pressure decode
    Three-band scheduler replaces flat 10-step round-robin:
    - FAST (~67% ticks): RPM, speed, load, MAP, baro — alternating pairs
    - MEDIUM (every 3rd tick): coolant/oil/IAT temps, rail/batt, MIL, DTCs, TCM gear
    - SLOW (every 16th tick): mode-22 probe rotation (0x1154, 0x336A, 0x3039,
    0x20F4/F6) + standard diesel PID probes (0x78, 0x6B, 0x7A, 0x7C, 0x8B, 0x86)
    Removes 0x115C (oil pressure mode-22) from the poll cycle — confirmed NRC 22/31
    (requestOutOfRange) on this E98 with engine running; the DID is not in this ECM's
    table. KOEO A=0 response guarded: only update g_obd.oil_press when decoded psi > 0
    to prevent false 0.0-bar CRIT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
    [fdcan_obd.c]
2026-07-23 diag: RAIL in bar instead of MPa; drop dead 0x115C probe slot
    Rail pressure formula changed from ((A*256)+B)*10/1000 MPa to
    ((A*256)+B)/10 bar — same J1979 PID 0x23 data, more familiar unit.
    380 bar reads as 380, not 38. DIAG card unit updated to "bar".
    cluster_config.h max range 200→2000. Demo value 58→580.
    Removed 0x115C from probe_did[] slow rotation — this DID returns NRC
    22/31 on the E98, was kept there by mistake after being dropped from
    the medium band. Oil pressure now tracked via 0x1BA broadcast only.
    [cluster_config.h, cluster_ui.c, fdcan_obd.c]
2026-07-23 Fix build: hoist CAN_ID_OILP_BCAST to cluster_config.h
    The macro was #defined inside obd_init() (fdcan_obd.c:446) but first used
    by the RX decode in obd_rx_poll() ~90 lines earlier, so it was out of
    scope there and the CLI build failed with 'CAN_ID_OILP_BCAST undeclared'.
    Moved the define next to CAN_ID_SELECTOR in cluster_config.h where both
    users see it. No behavioural change (same 0x1BA).
    [cluster_config.h, fdcan_obd.c]
2026-07-24 ui: drop DPF page — no data available on this ECM
    Astra-K DIDs for soot/dP/EGT/since-regen are unreliable on this E98
    calibration (respond intermittently or not at all). The DPF page has
    been all-NaN ("--") in every on-car session; removing it reduces noise
    and page count from 4 to 3 (DRIVE → DIAG → SNIFF).
    The DPF tag in the alert strip is preserved — it still lights up if
    the soot DID ever starts responding consistently.
    [cluster_ui.c, cluster_ui.h]
2026-07-24 obd/ui: drop DPF data path, speed up RPM, add oil-pressure A/B test
    Three changes from the 2026-07-24 bench review:
    1. Remove the DPF/aftertreatment feature entirely. Soot, dP, EGT-zone
    probes, EGR temp, since-regen and regen status were all-NaN in every
    on-car session (this E98 never answered their DIDs/PIDs). Gone from the
    struct, decoders, poll rotation, metric enum/table, pid_map, and the
    DPF alert-strip tag. Frees the slow-probe band and removes dead polling.
    EGT (std PID 0x78) is kept — it is mainstream and may yet read.
    2. RPM latency: rpm+speed (fastA) now polls on EVERY fast tick instead of
    alternating with load/MAP/baro, ~2x more often. load/MAP/baro (fastB)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
2026-07-24 obd: pair MAP with RPM on the fast band so boost stays responsive
    Boost read ~0 on the bench because a no-load engine makes no boost, and
    the previous commit had demoted MAP to the medium band, so the small
    free-rev MAP bumps were sampled too slowly to show at all.
    Move MAP (0x0B) up to share the fast band with RPM as a single 6-byte
    request { 0x0C, 0x0B }; RPM still polls every fast tick. Speed (0x0D)
    takes MAP's old slot in the medium fastB group { 0x04, 0x0D, 0x33 } —
    speed tolerates ~0.5 s latency (0 on the bench, slow-changing on road).
    Baro stays medium (ambient, barely moves), so boost = MAP - baro is now
    recomputed on every fast tick.
    NOTE: boost only climbs under real load. On a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
    [fdcan_obd.c]
2026-07-24 photos: add 2026-07-24 session + notes; fix folder date; set model opus
    - Add the 25 photos from the 2026-07-24 morning bench run + SESSION_NOTES
    (transcribed screen readings and the per-page analysis).
    - Add SESSION_NOTES for the 2026-07-23 run.
    - Rename design/Photos/20262207_21 -> 20260722_21 (typo'd date in folder name).
    - .claude/settings.json: pin model to opus (from /model this session).
2026-08-23 obd: speed to fast band + GPS scale; oil-pressure A/B round 2
    Speed (PID 0x0D) moved off the MEDIUM band (where it lagged ~10 s behind
    the blocking display flush) onto FAST: RPM now polls every fast tick with
    MAP and speed alternating as the 2nd PID (payload budget is 7 bytes, so
    rpm+MAP+speed can't share one single-frame request). Speed also scaled by
    60/67 to match GPS — this ECM reads ~12% optimistic (60 GPS = 67 on screen,
    2026-08-23 road test).
    Oil pressure: candidate #1 (0x1BA[3]) is confirmed NOT oil pressure and no
    longer feeds the OIL P tile — it stayed 0.1-0.4 bar at warm idle and 0.2 bar
    at 1599 rpm / 71 km/h under way (real would be 3-5 bar). The tile now shows
    candidate #2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
2026-10-09 docs: add future/ with GPS speed + performance-meter research
    Captures the research for a Dragy-style 0-100 / 1/4-mile timer and GPS
    speed source: why OBD speed is not good enough, GNSS chip choice, accuracy
    estimate, how it plugs into the existing superloop (USART2 PA2/PA3, g_gps,
    PERF page), firmware plan, pitfalls, and three hardware paths with BOMs
    (ready M10 module, NEO-M9N, custom MAX-M10S board with LCSC links).
    Nothing implemented yet.
2026-10-09 docs: mark the display as an add-on; add project review
    The OEM cluster stays installed with all required tell-tales, so this is an
    auxiliary display (resolves review item N11). Also fixes stale CLAUDE.md facts:
    3 pages DRIVE/DIAG/SNIFF (DPF removed), selector found on 0x1F5, oil pressure
    has no confirmed source. Adds docs/REVIEW.md, the review whose R-numbers the
    following commits on this branch refer to.
2026-10-09 tools: CLI firmware build without STM32CubeIDE
    tools/build.py mirrors the Debug configuration from .cproject (defines,
    include paths, cortex-m7/fpv5-d16 hard-float, -O0 -g3, nano specs, same
    linker script) and compiles from build/ with ../ paths like CubeIDE does
    from Debug/, so the image is comparable: baseline f9635ab gives
    text=593960 with Arm GNU Toolchain 13.3.rel1 vs 593728 from CubeIDE
    (the 232 B gap is ST's vs Arm's GCC build). Incremental via -MMD deps,
    response file for the link, lists warnings in Core/ separately.
    CubeIDE stays the reference build; keep the flags in sync.
2026-10-09 obd: validate every received frame; drop unverified oil pressure from DRIVE
    Review items R4, R7, N1, N5 (+ N3 instrumentation):
    - R4: 0x0C9[2]/36 no longer feeds oil_press. It was a guess with a red
    low-pressure state on DRIVE; the OIL P tile now shows "--" until a
    source is checked against an independent gauge. Both candidate bytes
    stay raw on DIAG. Stale 0x1BA comments fixed (it was rejected 08-23).
    - R7: Single Frame length must be 1..7 and fit the received DLC. An
    unchecked SF_DL of 0x0F read 8 bytes past the frame buffer.
    - N1: every broadcast byte is read only if the DLC covers it; mode-01
    replies are validated whole (each PID known and complete, exact fit)
    before anything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
    [cluster_config.h, cluster_ui.c, fdcan_obd.c, fdcan_obd.h]
2026-10-09 diag: show MIL/DTC as unknown until PID 0x01 has answered
    Review items R10, N8. mil=false / dtc_count=0 are initial values, yet DIAG
    painted "OFF" and a green "NO STORED CODES" as soon as any broadcast kept
    can_ok alive, without PID 0x01 ever answering. New g_obd.mil_valid is set
    when PID 0x01 decodes; until then MIL shows "--", the DTC box "NO DATA",
    and the MIL/DTC alert tags stay neutral. The count is relabelled
    "EMISSION CODES": PID 0x01 counts emission-related DTCs only, and the
    mode-03 list is not decoded.
    Built with tools/build.py: 0 warnings, links (text=594488). NOT flashed.
2026-10-09 fault: IWDG, stack-overflow check and last-reset reason
    Review item R6. A hang used to freeze the last frame on the ILI9488
    (it keeps its GRAM) with plausible numbers on it forever.
    - IWDG1 (LSI /64, reload 1500 = 3 s) starts at the end of AppMain_Init and
    is fed only after a complete superloop iteration. 3 s is generous on
    purpose while a blocking full-screen flush can take ~0.4 s+; tighten it
    once the display path is non-blocking. Frozen under a debugger halt.
    - configCHECK_FOR_STACK_OVERFLOW 2 (in FreeRTOSConfig.h USER CODE) with a
    hook in fault.c that overrides the weak cmsis_os2 stub.
    - HardFault, stack overflow and Error_Handler record a code in an unused
    DTCM word (survives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
    [app_main.c, cluster_ui.c, fault.c, fault.h, main.c]
2026-10-09 key: latch PC13 presses in an EXTI so taps during a flush are not lost
    Review item N10. The key was sampled once per superloop iteration, and an
    iteration can block ~0.4 s in a full-screen SPI flush, so a tap that began
    and ended inside one iteration produced no sampled edge at all - the time
    debounce could not help. PC13 now also raises EXTI15_10 on both edges: a
    rising edge after KEY_DEBOUNCE_MS of quiet latches a press (bounce edges
    only restart the quiet window, so release bounce cannot latch a phantom
    press). The loop counts a latched press as a tap when it never saw the
    level go high, once the debounce window has passed; a press it does see
    is handled by level as before (3 s hold uncha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
2026-10-09 docs: CLAUDE.md for the CLI build, IWDG/fault module, frame validation and EXTI key
2026-10-09 obd: match replies by content, honour TX status, reject short CFs
    Stage A review items A1 (partly) and A2.
    - A1: the outstanding-request slot now records service + first PID/DID,
    and a reply only counts as ours (clears the slot, or gets our Flow
    Control) if its positive-response SID and echo match, or it is an NRC
    for our service. A same-ECU reply to another tester's request no longer
    clears our slot or gets our FC. NRC 0x78 (response pending) does not
    close the slot. can_send() returns the HAL status: a request the TX FIFO
    refused registers no pending reply and counts in TXF on DIAG.
    NOT done here (stage C): one outstanding transaction per ECU and a
    scheduler that waits for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
    [cluster_ui.c, fdcan_obd.c, fdcan_obd.h]
2026-10-09 obd: MIL/DTC go stale after 3 unanswered PID 0x01 requests
    Stage A review item A3. mil_valid stayed true forever after the first PID
    0x01 answer while broadcasts kept can_ok alive, so DIAG could show "MIL OFF"
    long after the ECM stopped answering. It is now cleared once three PID 0x01
    requests in a row went unanswered (DIAG falls back to "--" / NO DATA).
    Counted in requests, not ms, so it holds however slowly the loop runs.
    The general per-metric timestamp/quality model is still stage C.
    Built with tools/build.py: 0 warnings, links (text=596168). NOT flashed.
2026-10-09 fault: watchdog from early boot, .noinit record, bench self-test
    Stage A review item A4.
    - IWDG now starts in main() USER CODE SysInit (right after the clock is
    up) with a ~10 s boot timeout, so a hang in peripheral init, RTOS start
    or the display bring-up also resets; AppMain_Init switches to the ~3 s
    run timeout. fault_init() moved there too. Timeouts are nominal (LSI is
    untrimmed).
    - The PR/RLR update wait is bounded (tick and loop count) instead of
    spinning forever if the LSI never runs.
    - The fault record moved from a magic DTCM address to a NOLOAD .noinit
    section in STM32H743VITX_FLASH.ld (DTCM, 0x20000000) and carries
    magic + code + ~code, so garbage or a torn write is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
    [app_main.c, fault.c, fault.h, main.c]
2026-10-09 key: count EXTI presses instead of latching one
    Stage A review item A5. A single latch merged several short taps inside
    one stalled iteration into one, and the ISR and the loop both wrote it.
    The ISR now only increments a free-running press count; the loop keeps its
    own "seen" copy and replays the difference as taps (capped at 4): all of
    them when it never saw the key pressed, all but the newest when it sees
    the newest press by level (that one is then handled by level as before,
    3 s hold unchanged). Neither side overwrites the other's update.
    Still to be verified on the bench: 50-100 ms taps during a full-screen
    redraw, a double tap, the 3 s hold, and taps right after boot.
    Built with tool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
    [app_main.c]
2026-10-09 tests: host-side unit tests for the OBD frame/ISO-TP logic
    tests/host/test_fdcan_obd.c #includes the real Core/Src/fdcan_obd.c with a
    mocked HAL (tests/host/mock) and checks 25 cases / 60 assertions: valid and
    grouped SF decode; SF_DL 15, truncated PID and short DLC rejected (R7/N1);
    unknown PID ignored quietly; mode 01 only from the ECM, mode-22 DIDs only
    from their module; a good multi-frame EGT with our Flow Control; FF over
    64 B refused before FC (N5); empty, short, out-of-sequence CFs rejected and
    another sender's CF ignored; reassembly timeout (A2); another tester's SF
    keeps our slot and its FF gets no FC; a refused TX registers no pending
    reply (A1); NRC 0x78 keeps the slot; MIL goes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
    [test_fdcan_obd.c]
2026-10-09 docs: fix status table in REVIEW.md; CLAUDE.md on host tests and tick timeouts
    Stage A review item A6. REVIEW.md opens with a per-item status (fixed /
    partly / open / needs bench) for R1-R10, N1-N11 and A1-A5; the original
    sections are marked as the f9635ab snapshot they were written against.
    CLAUDE.md documents tests/host + tools/host_test.py and states that
    poll-tick timeouts are a workaround until RX is interrupt-driven.
2026-10-09 obd: one diagnostic transaction at a time
    Update-review items F1-F4, F7, F8, F10. The single await slot only did the
    bookkeeping: requests still went out every tick, so the next request
    overwrote the slot mid-transfer (F1), the old transfer's last CF then
    cleared the new request (F2), a NRC 0x78 wait lasted one tick (F3), and a
    malformed but matching SF closed the slot before validation (F4).
    - request() refuses while a transaction is open; obd_poll_tick() only ages
    it (await_ttl, or itp_ttl while its multi-frame answer arrives) and the
    band position does not advance. Replies normally land before the next
    iteration, so throughput is unchanged; an unanswered request costs
    OBD_AWAIT_T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
2026-10-09 fault: start the IWDG before SystemClock_Config; docs for the transaction model
    Update-review items F5, F9, plus docs.
    - F5: fault_init() + the ~10 s boot IWDG moved from USER CODE SysInit to
    USER CODE Init, right after HAL_Init and before SystemClock_Config, so a
    hang in its VOSRDY/PLL waits also resets. The IWDG runs from the LSI,
    independent of the clock tree being reconfigured; the bounded PR/RLR wait
    uses the HAL tick, which HAL_Init already started.
    - F9: FAULT_TEST=2 is not an immediate reset: HardFault records the code
    and stops, the IWDG resets ~3 s later. Comment fixed.
    - CLAUDE.md: fault/IWDG description matches the code; the
    one-transaction-at-a-time rule added to th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
    [fault.h, main.c]
2026-10-09 graphify: rebuild after merging review/stage-a
2026-10-09 graphify: include fault.c and the stage-a OBD changes in the graph
2026-10-09 docs: add future/display-upgrade.md — display quality and speed research
    Why the main display is slow (SPI2 at 9.375 MHz, 18 bpp, blocking
    row-by-row flush, full redraw every tick: ~390 ms per full frame) and what
    fixes it without buying anything (redraw only changed widgets, SPI /4,
    DMA flush, caches). Then the hardware options for picture quality:
    3.5" IPS ST7796U drop-in (all 4" ST7796 modules found are TN), the
    1000-nit EA TFT035-34AI, and Waveshare ESP32-S3 boards with a 4"
    480x480 / 4.3" 800x480 IPS panel, onboard CAN and 7-36 V input. BOM,
    pitfalls and open questions. Nothing implemented.
2026-10-09 docs: display-upgrade — what LCSC actually stocks
    Dumped the whole LCSC 'LCD, OLED, Graphic' category (2567 parts) and
    searched by controller/model: no suitable display is in stock there (no
    ST7796 at all, every 4" IPS 480x480 panel and the EA TFT035 out of stock,
    the in-stock HS35B01A is a TN 16-bit-parallel ILI9488). So the display has
    to come from LCDWIKI/Waveshare/DigiKey; LCSC covers the 7-36 V input
    protection (SMBJ24A, SS54, PTC, XT30) with in-stock C-numbers.
2026-10-09 docs: display-upgrade — concrete buy options for the 3.5" IPS ST7796 drop-in
2026-10-09 display: stage 0 speed-up — DMA flush, 18.75 MHz SPI, caches, change-only UI
    - lv_port_disp.c: the flush converts the area into one RGB666 buffer and
    sends it by DMA (DMA1 Stream0 -> SPI2 TX), reporting the flush done at
    once so LVGL renders the next area and the loop runs OBD while the wire
    is busy; the next flush waits for the previous DMA (bounded, 100 ms).
    SPI2 re-inited at /8 = 18.75 MHz (was /16 = 9.4 MHz), PB13-15 at HIGH
    pin speed. All set up in lv_port_disp.c so a CubeMX regen cannot drop it.
    - main.c: I-cache and D-cache on (USER CODE). The flush cleans its buffer;
    the fault record is in DTCM (never cached); no other DMA in the project.
    - cluster_ui.c: refresh writes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
2026-10-09 docs: review notes for the display stage 0; CLAUDE.md on DMA flush and caches
    - REVIEW.md: status now reflects stage-a merged/flashed and the stage 0
    display work, with a per-change table of what a reviewer should check
    (the D-cache being the main risk), what is left of R2/N6, and the
    hardware checks still needed. R2 -> mostly fixed, N6 -> partial.
    - CLAUDE.md: the flush is DMA now (tick-timeout rule still stands), SPI2
    is overridden in lv_port_disp.c outside CubeMX, caches are on and any
    new DMA must handle coherency, refresh uses the change-only helpers.
    - future/display-upgrade.md: stage 0 marked done (18.75 MHz, not 37.5).
    - fault.c: watchdog comment no longer claims a 0.4 s bl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
    [fault.c]
2026-10-09 display: fix stage 0 reset loop — render buffers were 1.5x too big
    buf1/buf2 were lv_color_t[], and lv_color_t is 3 bytes in LVGL 9 whatever
    the display format. LVGL divides the byte size by the RGB565 stride, so it
    flushed 60-line areas instead of 40; converting one to RGB666 wrote 57600
    bytes into the 38400-byte tx_buf and zeroed what follows (s_dma_tx, hspi2,
    st_buf, htim6, uwTick). With htim6 zeroed the tick IRQ never cleared TIM6
    UIF, the loop starved and the IWDG reset the board every ~4 s: the panel
    blinked black/white. The old row-by-row flush never noticed.
    Buffers are now uint8_t sized in RGB565 bytes, and the flush drops any
    area that would not fit tx_buf instead of overrunning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
    [lv_port_disp.c]
2026-10-09 graphify: rebuild after the stage 0 display fix
2026-10-10 obd: stop polling what this E98 never answers (R9)
    PID 0x5C (oil temp, omitted from grouped replies; DID 0x1154 is the
    source), PID 0x78 (EGT, no reply) and mode 03 (DTC list, never decoded;
    the count comes from PID 0x01) are dropped from the schedule. With one
    transaction at a time each unanswered request held the slot for
    OBD_AWAIT_TICKS, so they cost real polling time. Medium band is now 6
    items (temps = coolant+IAT), the slow band only the 0x1154 DID; the
    decoders stay so another tester's replies still feed us. req_mode03 and
    the 0x43 dispatch case removed; pid_map comments updated.
    Test schedule_contents: over 2000 unanswered ticks none of the dropped
    requests appears and every used si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
2026-10-10 config: Dash.ioc matches the code; firmware survives a regen (R1, N2)
    R1 - a CubeMX regeneration used to silently break CAN reception (RX FIFO0
    of 0, too few filter elements), shrink the task stack to 4 KB and the heap,
    and put SPI2 back to mode 3:
    - Dash.ioc: FDCAN1 StdFiltersNbr=4, RxFifo0ElmtsNbr=16; default task 4096
    words (16 KB); heap 65536; SPI2 mode 0 (CPOL low, CPHA 1edge) at /16.
    SPI2 Direction left 2LINES: half-duplex in CubeMX would also drop MISO.
    Not opened in CubeMX here - please Generate Code once and check git diff.
    - obd_init() re-lays out the FDCAN message RAM if the counts are short
    (HAL_FDCAN_Init again in READY). Too few filter elements does not make
    ConfigFil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
    [Dash.ioc, can_sniff.c, can_sniff.h, cluster_ui.c, fault.c, fdcan_obd.c, fdcan_obd.h, lv_port_disp.c]
2026-10-10 obd: receive CAN in the FDCAN interrupt, decode in the loop (stage C)
    The 16-deep hardware RX FIFO was drained only from the superloop, so any
    stall (rendering, a long flush) could overflow it. Now:
    - FDCAN1_IT0 (RX FIFO0 new message, priority 6) copies every frame into a
    64-entry SPSC ring - copy only, no protocol work in the ISR; the ISR
    advances rxq_head, the loop rxq_tail, with __DMB between entry and
    index. obd_rx_poll() decodes from the ring exactly as before.
    - If HAL_FDCAN_ActivateNotification fails, obd_rx_poll() pumps the FIFO
    itself (the old polled behaviour) and SNIFF shows POLL.
    - Ring drops are added to LOST on DIAG. The bus-off Stop/Start in the
    health check masks th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
    [cluster_ui.c, fdcan_obd.c, fdcan_obd.h, test_fdcan_obd.c]
2026-10-10 obd: millisecond deadlines now that RX is captured by the interrupt
    With frames captured into the ring by the FDCAN interrupt, a reply that
    arrived during a stall is already queued when the deadline is checked, so
    wall-clock deadlines are correct again:
    - answer 150 ms (OBD P2 is 50 ms), after NRC 0x78 5 s (UDS P2*), ISO-TP
    reassembly 1 s without FF/CF progress (N_Cr).
    - Deadlines are only checked in obd_poll_tick(), which cluster_app_run
    calls after obd_rx_poll() - the reply is processed before its deadline
    is looked at. The polled fallback keeps that property (replies wait in
    the FIFO and are drained first).
    - CLAUDE.md: RX is interrupt-driven; the poll-tick rule is replaced by the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
    [fdcan_obd.c, test_fdcan_obd.c]
2026-10-10 ui: per-metric freshness - stale values show "--" (R3/F6)
    can_ok only says some frame arrived: the selector or oil-pressure-candidate
    broadcasts kept it true while RPM, speed and coolant stayed frozen on screen
    after the ECM stopped answering.
    - g_obd.upd_ms[M_COUNT] (+ sel_upd_ms): every decode stamps its metric via
    set_m(), also when the value did not change. Demo mode stamps everything.
    - metric_stale_ms[] / SEL_STALE_MS in cluster_config.h: RPM, speed, boost,
    selector 2 s; temps, battery, rail, load, gear 15 s. Generous on purpose
    until DIAG's LOOP is measured - tighten with real update intervals.
    - obd_is_fresh()/obd_sel_fresh() used by the DRIVE/DIAG values, the gear
    and selec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
    [app_main.c, cluster_config.h, cluster_ui.c, fdcan_obd.c, fdcan_obd.h, st7735_status.c, st7735_status.h, test_fdcan_obd.c]
2026-10-10 display: bounded SPI timeouts for panel commands and fallbacks (N6)
    Every remaining HAL_SPI_Transmit(..., HAL_MAX_DELAY) on both displays is
    replaced by a bounded send that aborts and counts on timeout or error:
    ILI9488 commands/parameters 10 ms, the blocking fallback of a refused DMA
    flush 100 ms (a full area is ~17 ms), ST7735 transfers 50 ms (~7 ms for
    the largest). A dma_wait() abort counts too. Before, a stuck SPI hung the
    loop until the IWDG reset the board; now the transfer is dropped and the
    next repaint tries again.
    DIAG line 2 appends "SPI main/status" error counts only when non-zero.
    Built with tools/build.py: 0 warnings, links. NOT flashed.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
    [cluster_ui.c, lv_port_disp.c, lv_port_disp.h, st7735_status.c, st7735_status.h]
2026-10-10 backlight: backlight_set() takes brightness; polarity in one macro (R5, software)
    The Si4599 P-channel high-side switch conducts while PA8 is LOW, but the
    code treated the PWM duty as brightness: "+10 %" in brightness mode dimmed
    the panel and "100 %" turned it off, and BACKLIGHT_DUTY_PCT was a
    diagnostic 0 with an IRF520 comment.
    - BACKLIGHT_ACTIVE_LOW 1 + BACKLIGHT_BOOT_PCT 100: backlight_set() takes
    brightness and inverts for the P-FET. Electrically unchanged at boot (PA8
    held LOW = full on); brightness steps, the ST7735 overlay and the PE3 blink
    code now show real brightness (10 blinks at boot instead of 1).
    - CCR = (ARR+1) * high% / 100: exact 0 % and 100 % (ARR * pct / 100 never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
    [app_main.c]
2026-10-10 cleanup: remove retired stubs and unused SNIFF views; status docs for stage C
    - Deleted the empty can_gauges.c/.h and ui_dashboard.c/.h stubs (CubeIDE
    drops them on Refresh; a stale Debug/ makefile needs that refresh).
    - can_sniff: removed can_sniff_top/_get/_top_ids/_frame_count, sniff_hit_t,
    SNIFF_TOP_N/SNIFF_CHATTY and the prev[]/n_frames bookkeeping only they
    used. The SNIFF page uses the candidate/mover views and is unchanged.
    - cluster_ui: s_dirty was set but never read; removed. obd_on_update()
    stays as an (empty, documented) hook.
    - REVIEW.md status: R2, R3, F6, N6 fixed; R5 fixed in software (Vgs still
    to measure); dead code removed. CLAUDE.md updated.
    Built with tools/bu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
    [can_sniff.c, can_sniff.h, cluster_ui.c]
2026-10-10 obd: boost needs a real baro and follows MAP's freshness (audit C01)
    update_boost() ran on both MAP and baro and stamped M_BOOST each time, so a
    baro reply kept boost "fresh" while MAP had stopped. And until PID 0x33
    answered, boost used an assumed 101 kPa - off by ~0.1 bar per 900 m.
    Now no boost until a real baro is known, and its stamp is MAP's time.
    Tests: boost waits for baro and a fresh baro does not refresh a stale MAP;
    tick wrap-around for freshness and transaction deadlines. 51 / 148 green.
    Built with tools/build.py: 0 warnings, links. NOT flashed.
2026-10-10 obd: RX ring 64 -> 256 frames (audit A01)
    64 was a guess. A ~200 ms render stall with a busy bus (SNIFF's wide filter
    at ~1000 frames/s) is ~200 frames, which 64 + the 16-deep hardware FIFO
    cannot hold. 256 x 24 B = 6 KB of the plenty left in RAM_D1. Overflow is
    still counted into LOST on DIAG - the real rate is to be measured.
    Built with tools/build.py: 0 warnings, links (bss +4.6 KB). Host tests green.
    NOT flashed.
    [fdcan_obd.c, test_fdcan_obd.c]
2026-10-10 display: count every lost SPI2 area, not only timeouts (audit A03)
    HAL_SPI_ErrorCallback cleared busy without counting, a refused DMA start
    fell back silently and an oversized area was dropped silently. All three
    now count into the SPI counter on DIAG, next to blocking-send timeouts and
    abandoned DMA waits. flush_ready() is still signalled in each case so
    LVGL never stalls; the counter is what tells that a repaint was lost.
    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
    [lv_port_disp.c]
2026-10-10 ui: name the alarm; NO ECM DATA instead of a green NOMINAL (audit UX01/UX03)
    - The strip summary names its cause instead of a bare CHECK/WARN: the most
    severe tag with its reading ("CLT 101°C", "BAT 11.4V"), "MIL ON" or
    "n DTC". The tags and the red border are unchanged.
    - With the link live on broadcasts but neither RPM nor coolant fresh, the
    summary reads "NO ECM DATA" (amber strip) rather than NOMINAL: no alarm
    among observed values is not the same as a healthy system.
    - fmt() printed -0.4 as "0.4" (sign lost when the integer part is 0).
    Built with tools/build.py: 0 warnings, links. NOT flashed - check that the
    summary text fits next to the tags on the panel.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
2026-10-10 ui: SNIFF only in P/N, and it leaves by itself in R/D (audit UX05)
    SNIFF pauses OBD polling, and it was one tap away in the page cycle, so a
    tap while driving froze every OBD value. The selector broadcast keeps
    arriving while sniffing (OBD replies do not), so it gates the page: the
    cycle skips SNIFF unless the selector reads P or N, and an open SNIFF page
    returns to DRIVE once the selector goes to R or D. Without a fresh selector
    (bench, another car) SNIFF stays reachable unless a fresh speed > 3 km/h
    says the vehicle is moving. The page hint says "P/N only".
    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
    [cluster_ui.c]
2026-10-10 docs/config: drop the stale pid_map; second tester is best effort; audit status
    - cluster_config.h: removed pid_map[] (documentation-only, drifted from the
    poller - audit C05); the header now says what the file really owns and
    that the thresholds are from the mockup, not an engine calibration.
    - vehicle-install.md: running alongside another tester is best effort, never
    during ECU programming or a dealer session (audit C03).
    - REVIEW.md: per-item status of the 2026-10-10 audit, incl. that main never
    had stage B/C merged (no rollback), and what is left to the owner
    (electrical, layout, thresholds).
    Built with tools/build.py: 0 warnings, links. Host tests green.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
    [cluster_config.h]
2026-10-10 obd: oil pressure from the ECM itself, PID 0xA22C (no extra sensor)
    The E98 refuses the petrol-GM oil-pressure DIDs (0x115C/0x1470, NRC 31),
    but the diesel ECM's own value is PID 0xA22C, one byte, A x 4 kPa:
    ScanGauge's X-Gauge for the LWN 2.8 Duramax reads it as
    07E0 2C FE A22C, MTH 29/50 psi. The poller now asks for it in the medium
    band, one step per slot and one transaction at a time:
    - $22 A22C first (the ECM answers $22 for 0x1154 oil temp);
    - refused (or ignored 3x): GMLAN $2C FE A22C defines data packet 0xFE,
    then $AA 01 FE reads it once; the answer is a UUDT frame on 0x5E8,
    [FE][A], decoded only while our own $AA is open;
    - $2C refused too: NONE, the slot goes back to fast poll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
2026-10-10 obd: freshness is the frame's receive time; RX ring high-water mark
    Audit A02 (Stage C canonical review): set_m() stamped a metric with the
    time it was DECODED. A reply that waited in the RX ring through a 2.4 s
    render stall was stamped "now" and showed as fresh RPM. Each ring entry
    now carries rx_ms, taken in the ISR (pump time in the polled fallback),
    and every stamp — metrics, MAP for boost, gear, selector, last_rx_ms —
    uses it. Protocol deadlines are unchanged (they stay on HAL_GetTick in
    obd_poll_tick).
    SC-10: the deepest the ring has been is kept (rx_hwm) and shown as Q on
    DIAG line 1, so the 256-frame margin gets measured instead of guessed.
    Ring entry 24 -> 28 B (7 KB).
    Host te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
    [cluster_ui.c, fdcan_obd.c, fdcan_obd.h, test_fdcan_obd.c]
2026-10-10 obd: fence the oil-pressure $2C path; no oil-pressure alarm until validated
    Stage C canonical review C02/SC-02/SC-06/U06. $2C configures a packet
    definition in the ECM, so it is no longer an unconditional fallback:
    - OILP_DPID_ENABLE (cluster_config.h). 0 = $22 A22C only; $2C/$AA are
    never transmitted. A second host suite, test_oilp_off.c, rebuilds the
    whole fdcan_obd suite with the flag at 0 and its TX mock fails on any
    $2C or $AA frame.
    - With the flag at 1 (default on this branch, see note), $2C only goes
    out at standstill: fresh selector P/N and no fresh speed >= 1 km/h, or
    without a selector a fresh 0 km/h. Unknown is not standstill (a never-
    received selector counts as unk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
    [cluster_config.h, cluster_ui.c, fdcan_obd.c, test_fdcan_obd.c]
2026-10-10 ui: SNIFF fails closed; NOMINAL needs complete data; status screen freshness
    Stage C canonical review U01/SC-03, U02/SC-05, U04/SC-08, C05.
    The UI decisions move into a header-only cluster_policy.h so the host
    tests can check them (no CubeIDE build-list change):
    - SNIFF (it pauses OBD polling) opens only with a fresh selector in P/N
    and no fresh speed above 3 km/h. Before, unknown meant allowed: CAN
    lost, NaN or stale speed and no selector all let a tap open SNIFF on
    the move. A selector never received is unknown even inside its stale
    window (sel_upd_ms is 0 at boot). cluster_ui_set_page() now applies the
    gate for every caller, and the existing per-refresh exit uses the same
    te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
    [app_main.c, cluster_policy.h, cluster_ui.c, st7735_status.c, st7735_status.h, test_fdcan_obd.c]
2026-10-10 obd: one source for oil temp; speed correction lives in the config
    Stage C canonical review C03/C04/SC-09.
    - M_OIL is written only by DID 0x1154. PID 0x5C (not supported by this
    E98) could still arrive as another tester's reply and overwrite it with
    a different sensor/scaling; it is now parsed for length only, so the
    rest of a grouped reply still decodes. Host test.
    - The one-point GPS speed correction (60/67) is SPEED_GPS_SCALE in
    cluster_config.h, with where it came from and that it needs 3-4 more
    GPS points (and a refit after a tyre change).
    - cluster_app.c: the obd_init comment no longer says RX is polled.
    245 + 207 checks, 0 failed. CLI build clean.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
    [cluster_app.c, cluster_config.h, fdcan_obd.c, test_fdcan_obd.c]
2026-10-10 display: repaint after a lost area, re-init the panel after an error run
    Stage C canonical review D02/SC-07. A dropped flush still has to call
    lv_display_flush_ready() (LVGL would wait forever), but the panel kept
    the old pixels in that area until the widget happened to change, and
    nothing reacted to a run of errors.
    - Any SPI2 error marks the screen for repair; lv_port_disp_service(),
    called from the loop before lv_timer_handler(), invalidates the whole
    active screen, at most once a second (a full repaint is ~200 ms).
    - 3 errors with no good DMA area in between: reset + re-init the
    ILI9488 first (~400 ms, inside the 3 s IWDG), at most every 5 s,
    counted. DIAG's SPI suffix is now "S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
    [app_main.c, cluster_ui.c, fault.c, fault.h, lv_port_disp.c, lv_port_disp.h]
2026-10-10 fault: count abnormal resets in a row (LAST RESET: WATCHDOG x3)
    Stage C canonical review A04 (and S02 from the 2026-10-10 audit): a
    reset storm — fault, watchdog reset, same fault again — looked like a
    single reset on DIAG. The .noinit fault record now also keeps a streak
    (with its own inverted copy, read only after a non-cold reset like the
    code): +1 on every abnormal reset, 0 on a normal one, and cleared once a
    run has lasted 60 s. DIAG shows "LAST RESET: <cause> xN" for N > 1.
    CLAUDE.md: the streak, FAULT_TEST 3, and the display recovery.
    CLI build clean (no host tests for fault.c).
    [cluster_ui.c, fault.c, fault.h]
2026-10-10 docs: status table for the Stage C canonical audit
    docs/REVIEW.md: one row per finding of the Stage C canonical review —
    fixed in stage-c (A02/SC-04, SC-10 measurement, C02/SC-02+06 fencing,
    U01/SC-03, U02/SC-05, U04/SC-08, C03/C04/SC-09, D02/SC-07, A04/S02),
    partial (U06), and what stays with the owner (as-built schematic and
    measurements, in-car load test, sun readability) or open (CI, README).
    OILP_DPID_ENABLE = 1 on this branch is called out with the condition
    for merging to main. The 2026-10-10 table now points UX04 and S02 here.
    cluster_ui.c header comment: pages are DRIVE / DIAG / SNIFF (no DPF).
    [cluster_ui.c]
2026-10-10 safety: $2C off in the road build; SNIFF and $2C need P, not N
    Stage C2 deep-audit addendum, patch 1 (release configuration and
    movement admission; risk-ranking items 1 and 2).
    - OILP_DPID_ENABLE now defaults to 0: the everyday firmware never sends
    $2C/$AA, and oil pressure is read with $22 A22C only. The default host
    suite's TX mock fails on any $2C/$AA frame.
    - KOEO experiment build: python tools/build.py -D OILP_DPID_ENABLE=1.
    build.py's new -D NAME=VALUE goes to its own build-<tag>/ directory, so
    build/ is never silently a variant (.gitignore: /build-*/). The host
    suite for that build is test_oilp_dpid.c (renamed from
    test_oilp_off.c, which now duplicated the default).
    - $2C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
    [cluster_config.h, cluster_policy.h, cluster_ui.c, fdcan_obd.c, test_fdcan_obd.c, test_oilp_dpid.c]
2026-10-10 sniff: see every accepted frame, with its receive time; honest FILTER ERR
    Stage C2 deep-audit addendum, patch 2: D01, D06, D08.
    - D01: obd_rx_poll() fed the sniffer only the IDs left over after the
    known branches (selector 0x1F5, UUDT 0x5E8 and 0x7E8-0x7EA continued
    early), so SNIFF's table and fps were a silent subset. It is now fed
    every accepted standard data frame right after the type/DLC check,
    before any decoding; decoding is unchanged. Reproduced first (a host
    test with 0x1F5, 0x7E8, 0x5E8, 0x342 saw only 0x342), now 4 of 4, and
    0 with SNIFF off.
    - D06: can_sniff_feed() takes the frame's receive time (ISR) and uses it
    for change ages instead of HAL_GetTick() at drain ti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
2026-10-10 obd: transaction ownership by arrival time, total NRC-78 cap, full grouped replies; 0xFF clears oil pressure
    Stage C2 deep-audit addendum, patch 3: D02-D05. Each was reproduced by a
    host test that failed on the previous commit (see the audit's cases),
    then fixed:
    - D02: raw oil-pressure 0xFF (no-data) now clears oil_press to NaN at
    once; before, a 4.00 bar read a second earlier stayed "fresh" for 15 s.
    The raw FF stays on DIAG.
    - D03: NRC 0x78 extensions are clipped to OBD_TXN_MAX_MS (10 s) from the
    request, and obd_poll_tick() fails any transaction past it. Five 0x78s
    4.9 s apart held the only slot for 19.6 s and counting. Counted as CAP
    on DIAG line 2 (shown only when nonzero).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
    [cluster_ui.c, fdcan_obd.c, fdcan_obd.h, test_fdcan_obd.c]
2026-10-10 mil: expire by time too; display: a good fallback is no error, retry a failed init
    Stage C2 deep-audit addendum, patch 4 (items carried over from the C2
    review: MIL absolute-time freshness, LCD fallback/recovery).
    - MIL / DTC count: obd_mil_fresh() = answered one of the last 3 PID 0x01
    attempts AND within MIL_STALE_MS (15 s) of its receive time. With
    polling paused (SNIFF) no attempt fails, so the attempt counter alone
    kept a "MIL OFF" valid indefinitely. DIAG, the alert strip and
    policy_complete() use it. Host test.
    - ILI9488: a refused DMA start whose blocking fallback delivered the
    area is no longer counted as a lost area (it triggered a repaint and
    pushed towards a re-init);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
    [cluster_config.h, cluster_policy.h, cluster_ui.c, fdcan_obd.c, fdcan_obd.h, lv_port_disp.c, lv_port_disp.h, test_fdcan_obd.c]
2026-10-10 docs: Stage C2 deep-audit addendum — per-finding status table
    docs/REVIEW.md: for each addendum item (risk 1/2, D01-D08, and the C2
    carry-overs MIL time freshness and LCD fallback/init retry): changed
    functions, the host test that now passes, possible regression, and what
    still has to be checked in the truck. States plainly that none of it is
    verified on the car or the panel. The earlier canonical-audit rows for
    $2C and SNIFF now point at the new defaults (flag 0, P only).
2026-10-11 obd: the 10 s transaction cap also binds ISO-TP Consecutive Frames
    Stage C3 review C3-01. NRC-0x78 extensions were clamped to the total
    cap, but a First Frame accepted just before it started a transfer on its
    own N_Cr deadline: with pending replies at +0.1/+4.9/+8.9 s, an FF at
    +9.9 s and the last CF at +10.2 s, the CF completed the transaction (EGT
    decoded, slot closed) and the cap was never counted.
    A CF that arrived (ISR receive time) at or after await_start +
    OBD_TXN_MAX_MS now fails the transaction, counted once as CAP; the
    transfer is dropped, not decoded. A CF past only its N_Cr deadline is
    "late" and no longer also counted as BAD. Polled fallback unchanged
    (there obd_poll_tick() enf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
2026-10-11 sniff: retry a refused filter restore; truthful SNIFF state; rank by age
    Stage C3 review C3-02, plus one defect found while writing its tests.
    - Leaving SNIFF set active=false and ignored apply_filter(false): if the
    HAL refused the narrow filter, the wide one stayed installed with OBD
    polling resumed, and nothing retried — not even another "leave" (it
    returned early). Now the narrow filter is "restore pending", kept apart
    from the sniffer state, and can_sniff_service() (cluster_app_run, after
    obd_rx_poll) retries it every SNIFF_RESTORE_RETRY_MS (100 ms) until it
    sticks. DIAG shows WIDE meanwhile. Same single loop context as the
    controller restart in obd_check_health(), so no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
2026-10-11 display: host tests by fault injection; fix a failed re-init never retried
    Stage C3 review "LCD testing" gap. tests/host/test_lv_port_disp.c builds
    the real lv_port_disp.c against a mocked SPI/DMA/GPIO HAL and LVGL
    (tests/host/mock_lv_port_disp/; host_test.py now puts a test's own
    tests/host/mock_<name>/ ahead of the shared mocks). The service's
    pacing state moved from function statics to file scope (s_svc) so the
    cases can reset it.
    The cases asked for, and what they showed:
    - DMA start refused, blocking fallback OK: F counted, no lost area, no
    repaint, no re-init. Pass.
    - DMA refused and fallback fails: lost area, one full repaint. Pass.
    - 3 lost areas in a row: re-init, repaint, streak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
2026-10-11 ui: DIAG readout in three bounded lines; OIL P marked unverified
    Stage C3 review C3-03 and the "unverified oil-pressure display" note.
    - The DIAG readout was one 96-byte buffer filled with lv_snprintf()
    return values added to the offset: once a field was cut, the offset
    passed the end and every later field — the CAP/WIDE/SPI error counters
    — was silently skipped. A cat() helper (lv_vsnprintf) now clamps the
    offset; the buffer is 160 bytes.
    - It also did not fit visually: two lines of up to ~60 characters on a
    300 px label. Now three lines, each <= ~40 characters in the worst
    case, in the gap between the cards and the pager (y 382, 1 px line
    space, ends at 429; pager at 432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
2026-10-11 docs: Stage C3 review — per-finding status table
    docs/REVIEW.md: C3-01, C3-02, the LCD test gap, C3-03 and the
    unverified OIL P label, plus the two defects the new tests found (SNIFF
    ranking across the tick wrap; a failed panel re-init never retried) —
    changes, passing tests, possible regressions, what to check on the
    hardware. Nothing here is verified on the STM32, the panel or the car.
2026-10-11 docs/future: GPS odometer + diesel fuel consumption; clean build + shopping list
    gps-odometer-fuel.md: own odometer (total / drive / trip A, optional
    since-refuel) by integrating GNSS Doppler speed over epoch time, with a
    vehicle-speed fallback (broadcast 0x3E9 if the RG has it, else PID
    0x0D) whose scale is learned from GPS. Fuel: why MAF does not work on a
    diesel, candidate sources in order (PID 0x5E, newer J1979 fuel-rate
    PIDs, the OEM cluster's broadcast — found by its zero on overrun fuel
    cut —, an injection-quantity DID), formulas, fill-up calibration
    (FUEL_CAL). Storage in FRAM MB85RC256V (A/B copies with CRC; onboard SPI
    NOR as the no-purchase fallback), TRIP page sketch, EC11 en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
2026-10-11 docs/future: budget build (~$15) as the main shopping list
    The first list (~$100-150) was too expensive. The main list is now a
    budget one: ATGM336H GPS (enough for speed and the odometer; u-blox M10
    only for Dragy-grade 0-100), a car USB charger into the WeAct USB-C (or
    LM2596 + SS54 + 1.5KE27A + add-a-circuit for hidden wiring), 2N7000
    gate driver, optional EC11, OBD2 plug, perfboard, JST-XH with
    pre-crimped leads (no crimper), heat shrink, ABS box: ~$12-18. Free:
    odometer storage in the onboard 8 MB SPI NOR (journal, wear estimate
    included), the existing SN65HVD230, drive logging by our own board, KEY.
    The earlier list stays as 6a "if budget allows". gps-odometer-fuel.md:
    SPI NOR is the d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
2026-10-11 docs/future: LCSC order (~$12.7), checked against the LCSC API
    build-hardware.md 6b: the parts to order on LCSC now that power (PD65W
    module, 8-30 V in) and the WeAct cable are bought — ATGM336H-6N-74 GNSS
    (C5804601) + 25x25 patch antenna (C784398, 26 left), ALPS EC11E09244BS
    encoder with switch (C470742), 2N7000 (C9114), 10k/1k THT resistors
    (C57436/C57435), 1.5KE22A TVS for the 30 V module input (C294184),
    3.81 mm pluggable terminal blocks instead of crimped connectors
    (C441334/C440860), 1x40 female header for the WeAct (C9811), 100 nF /
    10 uF THT (C168753/C43798). Codes, stock and prices read from LCSC's
    product API on 2026-10-11. Plus: ATGM336H-6N pin hookup (PA2/PA3, VBAT
    and ON/OFF t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
2026-10-11 docs/future: GPS module chosen — ATGM336H-6N-74, NMEA at 10 Hz
    The owner accepts ~±0.1 s on 0-100, so the cheap ATGM336H-6N-74
    (C5804601) stays; firmware will parse NMEA (RMC/GGA/GSA, RMC time as the
    time base) at 10 Hz instead of u-blox UBX NAV-PVT. Upgrade path noted:
    u-blox MAX-M10S (C4153167) fits the same footprint, plus VCC_IO.
2026-10-11 docs/future: panel buttons — 12 mm metal momentary with 5 V ring LED
    build-hardware.md 6c: LCSC has next to no illuminated metal pushbuttons
    (E-Switch ones out of stock) and Narva OE-style Holden/Isuzu inserts are
    latching, 12 V-lit and AU$33-45 each, so: AliExpress 12 mm flat metal
    momentary buttons with a 5 V ring, pre-wired, ~AU$2-4 each, mounted in
    the printed display bezel. Wiring: contact to GND with 10k pull-up +
    100 nF (PD3/PD4 suggested, check the header), ring low-side through a
    2N7000 gated from PA8 with the backlight driver so the rings dim with
    the screen. Roles: next page / brightness, and a page action (trip
    reset, PERF arm/clear); the encoder becomes optional.
    Co-Authored-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
2026-10-11 docs: the truck is a Land Cruiser 100 with a Colorado RG 2.8 swap; Toyota buttons, day/night by parking lights, assembly checklist
    The vehicle is a Toyota Land Cruiser 100 (1998-2007) running a Holden
    Colorado RG 2.8 Duramax swap: data comes from the Colorado ECU, the
    cabin (switch blanks, fuses, dash illumination) is Toyota's. CLAUDE.md
    says so now.
    build-hardware.md:
    - 6c rewritten: the screen sits under the panel, so the controls are
    OE-style LC100 momentary switches (40x20 face, 39x21 cut-out, snap
    into the stock blanks, 12 V, ~US$4-7) — 2 needed, 3 optional:
    > PAGE (short next, hold 3 s brightness mode, +10 % per press as with
    KEY today), * ACTION (short page action, hold 2 s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
2026-10-11 docs: review brief for 2026-10-11 — the truck is an LC100 with a Colorado swap
    docs/REVIEW.md gets a reviewer section on top: the vehicle is a Toyota
    Land Cruiser 100 with a Holden Colorado RG 2.8 Duramax swap (CAN data
    from the Colorado ECU, cabin hardware Toyota's), review stage-c (not
    flashed), what changed after the C3 review, current check results (4
    host suites: 261 / 302 / 29 / 32 checks, 0 failed; default and
    experiment builds clean), the new docs/future design docs, the control
    scheme (Toyota LC100 momentary switches, day/night by the parking-light
    circuit through a 2N7000) and six concrete questions for the reviewer.
    The overview, vehicle-install.md intro and the cluster_config.h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
2026-10-11 docs: harness connectors for the build — AMP 1.5 kit, SN-48B
    Inline connectors at each harness break so the box comes out without
    cutting wires: power 2-pin, CAN 3-pin, GPS 4-pin, buttons 6-pin, from a
    cheap AMP Superseal-style 1.5 series 1-6 pin kit. A crimper is now needed
    (SN-48B); signal cable cores should be 0.5 mm2 to hold in the terminals.
    Docs only, no code change.
2026-10-11 fix(display): a good DMA area no longer cancels an owed panel re-init (C4-SW-01)
    The owed re-init was encoded in s_err_streak, which HAL_SPI_TxCpltCallback
    zeroes on every good pixel area. So a failed re-init followed by one good
    DMA was forgotten for good, and so was a boot init with SPI errors whenever
    the first screen went out before the first service pass (boot is shorter
    than the 1 s repaint gap). The panel could stay half-configured while SPI
    worked.
    Now s_reinit_pending is its own flag: set when LCD_RECOVER_STREAK errors
    come in a row or an init hits an error, cleared only by a clean init. The
    streak keeps its meaning (errors since the last good area) and still only
    latches the flag,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
2026-10-11 docs: C4 hardware review — free pins, 3V3-only GNSS, TVS under 30 V, one topology
    C4-HW-01: PD6 is the WeAct SPI flash CS and PD4 the microSD card detect
    (Zephyr DTS and MicroPython board definitions agree); PD3 is a DCMI line.
    Planned buttons move to PE7/PE8/PE9 and the parking-light input to PE15;
    wiring.md now lists the flash CS, card detect and DCMI pins.
    C4-HW-02: the variant-A diagram no longer feeds the GNSS from 5 V; the bare
    ATGM336H-6N is 3V3 only, a ready-made breakout is a different part.
    C4-HW-03: 1.5KE22A clamps at 30.6 V, above the PD65W's 30 V. Now
    Littelfuse 1.5KE20A (LCSC C1976464, <= 27.7 V); it will blow the fuse on a
    24 V jump start, by design. The fuse is described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
2026-10-11 fix(display): SPI error checks no longer go blind when the DIAG counter saturates (C5-SW-01)
    The window-set check in the flush and the init checks (boot and re-init)
    detected a fresh error by comparing s_spi_err before and after. That is the
    DIAG counter and saturates at 0xFFFF, so after 65535 errors a failed PASET
    sent pixels into the wrong GRAM window and a failed re-init cleared
    s_reinit_pending. They now compare s_err_seq, an unsaturated uint32 event
    count bumped in spi_err() and never reset; s_spi_err stays as the DIAG value.
    Tests: the reviewer's saturated_init_failure and saturated_window_failure,
    added unchanged (minus a redundant reset() the harness already does); they
    failed on th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
2026-10-11 feat(backlight): BACKLIGHT_ACTIVE_LOW is a build flag, default unchanged (C5-HW-04)
    The planned 2N7000 gate driver inverts PA8 -> backlight, so the default image
    (ACTIVE_LOW 1, today's direct P-FET drive) would turn the panel off at 100 %
    on that board. The macro is now #ifndef-guarded: the new board's image is
    `python tools/build.py -D BACKLIGHT_ACTIVE_LOW=0`. Default behaviour is
    unchanged; the two images differ only in backlight_set() (checked in the
    disassembly). Both build with 0 warnings. Not run on hardware.
2026-10-11 docs: C5 review — power A is bench-only, BC547 day/night input, NOR arithmetic
    C5-HW-03: variant A power (1.5KE20A + 2 A fuse + PD65W) is stated as bench /
    trial-drive only, not approved for permanent installation. Dropped the claim
    that a 24 V event "blows the fuse by design"; the fuse protects the wiring
    against shorts and is not surge or proven reverse-polarity protection; the
    27.7 V clamp is one datasheet point (10/1000 us, 54 A); the module's IC and
    capacitor ratings are a necessary check, not proof. Lists the measurements or
    the documented-module route needed for a permanent install.
    C5-HW-04: the 2N7000 backlight driver is described as a switch-over that
    needs the -D BACKLIGHT_ACTI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
2026-10-11 C6 review: BACKLIGHT_ACTIVE_LOW checked to 0/1 and shown on the ST7735; BC547 docs
    Firmware: BACKLIGHT_ACTIVE_LOW moves to app_main.h with a _Static_assert
    (not #if, where -D ...=yes would silently read as 0); =2 and =yes now fail to
    build. The inverted-driver image adds "BL INVERT" under "BRIGHTNESS" on the
    ST7735 brightness overlay: that screen has its own backlight, so a wrong
    image is still readable there while the main panel is dark. Default image
    unchanged apart from the include.
    Docs: BC547 "switches from ~1 V" corrected to start of conduction, solid
    PE15 low from ~2.5 V (forced beta 10); the powered-off backfeed through the
    base-collector junction is marked unverified, with a bench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
2026-10-11 docs: harness connectors and small parts moved to LCSC (TE Superseal 1.5)
    Genuine TE AMP Superseal 1.5 housings (2/3/4/6 pos), 282403-1 / 282404-1
    contacts for 0.35-0.5 mm2 and 281934-4 seals, MINI and ATO 2 A fuses, 47k
    and M3 standoffs now come with the LCSC order (all checked in stock via the
    LCSC/JLCPCB catalogue). Harness wire becomes 22 AWG to fit those contacts.
    What LCSC does not carry (perfboard, tape, enclosure, OBD splitter,
    add-a-circuit, tools) stays on AliExpress. Docs only.
2026-10-11 docs: GPS on a ready-made ATGM336H board; terminal-block pairs; Superseal later
    The owner does not want to hand-solder the 10x10 module: variant A now uses
    an ATGM336H breakout with antenna and 2.54 pins (AliExpress; LCSC has no
    GPS boards in stock), powered from the WeAct 3V3, which suits boards with
    or without a regulator. The bare module stays as a fallback.
    Connections: KF2EDGV/KF2EDGK 3.81 terminal blocks in pairs (2/3/4/6/8 pos),
    usable wire-to-wire; the Superseal part numbers are kept for later. No
    crimper, fine tip or copper tape needed now. Docs only.
2026-10-13 docs: harness labelling scheme — X1..X5, pin-by-pin table with colours
    Every wire labelled X<conn>.<pin> at both ends; table of X1 power, X2 CAN,
    X3 GPS, X4 buttons + ILL+, X5 display with the MCU pin and wire colour
    (display pins checked against lv_port_disp.c and Dash.ioc). Docs only.
2026-10-14 feat(obd): read the ECM's PID support maps; show them on DIAG line 3
    Mode 01 PIDs 0x00, 0x20 ... 0xC0 are read once per power-up in the slow
    slot: only maps the previous one advertises (bit 0), one request at a time
    through request(), retried every 5 s while unanswered (ECM may still be
    asleep at ACC), given up after 6. Maps in another tester's reply count too
    (their 4-byte length is now known to the mode-01 validator).
    obd_pid_support() / obd_pid_supported() expose them (1 / 0 / -1 unknown).
    DIAG line 3 now rotates every 4 s: oil probe -> maps 00/20/40 -> maps
    60/80/A0 + "5E+/-/?" (engine fuel rate). One photo of each answers what this
    E98 offers for fuel consumption (docs/future/gps-odome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
2026-10-14 feat(gps): ATGM336H on USART2 — NMEA parser, self-configuring link, DIAG status
    gps_hw.c: USART2 at register level (PA2 TX / PA3 RX, AF7), RX interrupt into
    a 1 KB ring, no DMA, bounded polled TX. Not in Dash.ioc, like the ST7735.
    gps.c: finds the module by itself. Listens at 115200, then 9600; at 9600
    sends $PCAS01,5 and, once heard at 115200, $PCAS03 (RMC + GGA) and
    $PCAS02,100 (10 Hz), and $PCAS00 (save) only after a rate change. Silent
    3 s -> search again; nothing at either rate -> retry every 10 s. Commands
    per the CASIC protocol spec V4.2.0.3 §1.6, checksums computed.
    gps_nmea.c: checksum-validated RMC / GGA, any talker; a field that does not
    parse leaves the previous values alone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
2026-10-14 feat(input): panel buttons ▶ ● ◀ on PE7-PE9 and day/night on PE15
    input.c (pure, host-tested): btn_step() is the KEY gesture logic from stage
    A made generic — EXTI-counted presses replayed as taps across a stalled
    iteration, release-edge taps with 30 ms debounce, one hold per press, burst
    cap 4 — and daynight_step(): any LOW within 100 ms counts as lights on (PWM
    dimmer), a change is taken after 500 ms.
    app_main.c: KEY (PC13, HIGH = pressed) plus ▶ PE7 / ● PE8 / ◀ PE9 (to
    ground, pull-ups, EXTI9_5). ▶/KEY tap = next page or +10% (wrap), hold 3 s =
    brightness mode; ◀ = previous page or -10%; ● = SNIFF clean point or -10%;
    ● hold 2 s reserved. Brightness mode now also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
2026-10-14 docs: carrier board 7x9 — layout drawing, WeAct header pinout, wire list
    carrier-board.svg: top view on the 24x30 grid — WeAct on sockets (P2 cols
    A-B, P1 cols O-P), X4 / X5 on the right edge, X1 / X3 / X2 on the bottom, the
    backlight driver, button pull-ups and day/night detector between them.
    carrier-board.md: P1 / P2 2x22 pinout from WeAct's schematic V12 (extracted
    from the PDF, to be checked against the silkscreen); the two ordered 1x40
    female headers suffice (pins 1-4 / 1-6 left unsocketed: GND/5V/3V3 exist at
    P2.41-44); 3.81 mm terminal blocks on the 2.54 grid by bending every second
    pin 1.27 mm; point-to-point wire list for every signal; pre-power checks;
    height budget in the 14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
2026-10-14 graphify: rebuild after PID maps, GPS, buttons/day-night
2026-10-14 docs(carrier): real bending plan for the 3.81 terminals; board on M3 nuts
    The 3.81 mm KF2EDGV/KF2EDGK pairs were the wrong pick for a 2.54
    perfboard (5.08 would sit on every second hole); the LCSC order shipped
    before it was caught, so the board uses them with bent pins.
    The previous advice (bend every second pin 1.27 mm) does not work with
    the real part. Per the KEFA drawing the pins are 0.8 mm square and
    3.7 mm long: a plain bend enters the hole at an angle, and a 1.27 mm
    step leaves nothing below a 1.6 mm board.
    New plan:
    - Every pin is stepped 0.6 mm, pairs 1-2, 3-4, ... toward each other,
    so pins land in holes 1,2,4,5,7,8,10,11. Table per connector.
    - Test-fit first: the 1.13 mm dia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
2026-10-15 fix(c7): review C7 code findings, with regression tests
    CAN-01 PID $78: sensor 1 only with mask bit 0 (SAE J1979); otherwise
    EGT goes back to NaN and is not stamped.
    CAN-02 policy_value(M_GEAR) is NaN for gear < 0. upd_ms = 0 counts as
    fresh for metric_stale_ms after boot, so -1 passed for a fresh
    value; DRIVE now uses policy_fresh().
    SW-01 ST7735: st_tx() returns bool, failures count into an unsaturated
    st_err_seq, traffic is held while a repair is owed (one 50 ms
    timeout per attempt), and st7735_status_service() restarts SPI4
    and repaints the whole screen at most 1/s. Start-up commands are
    never held; a failed SPI4 re-init is retr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
2026-10-15 docs(review): C7 status; display-upgrade table marked as pre-stage-0
    REVIEW.md: C7 section, what was fixed with which test, and what is left
    to measurements or the owner (alert hysteresis, file split, build
    profiles, CI, AutoRetransmission counter, SPI2/CAN numbers). The
    reviewer header now lists what is new since C6.
    display-upgrade.md: the "now" table described the old 9.375 MHz
    blocking SPI with the caches off. Marked as an archive snapshot, with
    today's 18.75 MHz DMA flush, caches on, ~197 ms per full frame.
2026-10-20 feat(alerts): dwell, hysteresis and an engine-running gate for alarms
    Review C7 SW-05. metric_state() judged every single reading, so:
    - a value sitting at a threshold flickered the strip;
    - the battery went red for the second the starter pulled it down;
    - a real alarm dropped the moment one sample dipped.
    alert.c filters the judged metrics (RPM, coolant, oil, ATF, EGT,
    battery, oil pressure) on top of the same thresholds:
    - a level is entered after a dwell: temperatures WARN 2 s / CRIT 1 s,
    battery 5 / 3 s, oil pressure 1 / 0.5 s, RPM at once (redline cue).
    CRIT's dwell is the shorter, so a fast rise goes straight to CRIT;
    - a level is left only after the reading is `hyst` inside the b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
2026-10-20 docs: first-flash checklist for stage-c; alert step-down wording fixed
    docs/bench-first-flash.md walks through:
    - which image to flash for which hardware (ROAD / ROAD INV / BENCH
    DEMO / BENCH FTn) and how;
    - what the LED, the ST7735 and every DIAG field should show on the bench
    now. Without a bus, TXF and TXL climb, and that is expected;
    - the DEMO scenario with the new alarm dwell;
    - FAULT_TEST 1-4 with the expected LAST RESET text;
    - GPS bring-up;
    - the carrier board (ROAD INV on the ST7735 is the check against a wrong
    backlight image);
    - what to photograph on the first time in the car: PID maps, LOOP, TXL,
    GPS vs OBD speed at 40/60/80/100.
    REVIEW.md: SW-05, SW-12 and the GPS over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
2026-10-20 graphify: update after image id, TXL counter and alert filter
2026-10-20 docs(power): tap the ACC wire directly, no add-a-circuit
    Owner's decision: the ACC feed is soldered into the ACC wire instead of
    an add-a-circuit in the fuse box.
    build-hardware.md (option A, the option-6a diagram and the checklist):
    - the 2 A fuse sits in an inline holder right at the tap; up to it the
    wire is protected only by the car's larger ACC fuse;
    - find the wire with a meter: 12 V in ACC/ON only, 0 V with the key out;
    - solder and heat shrink, not a crimp splice (vibration);
    - never OBD pin 16 or a constant +12 V (battery drain);
    - OBD splitter and fuses: owned. Inline fuse holder: confirm.
2026-10-20 docs: one wiring overview, car -> box -> display / buttons / GPS
    The connections were spread over build-hardware.md (node sketch and
    harness table X1-X5, buttons and day/night in 6c) and carrier-board.md
    (wire list to the WeAct pins), with no single picture of what goes
    where.
    docs/future/wiring-overview.svg draws it in one place:
    - the car side: ACC wire tap with the 2 A fuse at the tap, body ground,
    OBD2 splitter pins 6 / 14 / 5, the three LC100 buttons, ILL+ / TAIL;
    - the box connectors with every harness wire Xn.m;
    - the TVS, the PD65W and the CAN module (120 ohm removed);
    - the button pull-ups, the BC547 detector and the 2N7000 + Si4599
    backlight driver;
    - the WeAct pins (signal +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
2026-10-20 docs: step-by-step carrier assembly, every part and every wire
    The wiring overview was a block diagram: 3V3 / GND as flags, "pull-ups
    3 x 1k" as a box, no legs. It did not say where a resistor or a
    transistor leg actually goes.
    docs/future/assembly.md + assembly/step-1..8.svg, one subsystem per step:
    power, rails, display, backlight driver, CAN, GPS, buttons, parking
    lights.
    - Every part is drawn with its legs: TO-92 flat side towards you, legs
    down (2N7000 S G D, BC547 C B E), diode bands, resistor and capacitor
    values, terminal pins, WeAct signal + header pin. Module pins are
    shown as printed, or by function where the print is unknown (PD65W
    input, the Si4599 module: "as wired on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
2026-10-20 feat(stats): STATS page, first-drive statistics and a speedometer check
    What the first drives have to measure, kept in RAM since power-up or
    the last reset (hold the ● button 2 s on STATS):
    - trip_stats.c, per signal (the metrics, the selector, MIL): count; an
    interval histogram with its p95 bucket (to set metric_stale_ms, now a
    generous 2 / 15 s); the longest gap; min..max (to hold the alarm
    thresholds against). Also the longest loop iteration.
    - speed_cal.c: each OBD speed, as shown, paired with the GPS sample
    nearest in time (<= 100 ms). A pair counts only when the speed has
    stayed within 2 km/h for 2 s, is >= 40 km/h, and the GPS has >= 6
    satellites and HDOP <= 2. Reported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
2026-10-20 docs: harness guide, five branches from the box; buttons are 8 mm
    docs/future/harness.md + harness.svg (a tree from the box). Per branch
    X1-X5: wire, colour, label, from -> to, how to find the source with a
    meter, how to terminate it, and a check before plugging it in.
    - X1: find the ACC wire (key out / ACC / ON / START table), solder the
    tap without cutting, 2 A holder within 10 cm, body ground bolt.
    - X2: the Y splitter (one socket stays free for a scanner), pins
    6 / 14 / 5, twisted pair, ~60 ohm check with the key off.
    - X3: GPS under the windscreen, 3V3 only; swap TX / RX if DIAG says
    "GPS -".
    - X4: the three 8 mm buttons (as ordered), common return to X4.4;
    ILL+ vs ILL- table. T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
2026-10-21 docs: 1:1 carrier template to print; parking-light zone off the 3V3 bus
    docs/future/carrier-template.pdf, three A4 sheets at actual size, with
    a 50 mm ruler to check the print scale:
    1. Top (component side). Holes with column letters / row numbers;
    WeAct outline and socket strips; the used header pins with their
    signal; every terminal block with its pins already stepped (holes
    1, 2, 4, 5 ...); zones for the small parts.
    2. Bottom (solder side, mirrored, as the board lies when soldering),
    with the two bare buses drawn.
    3. Wire labels X1.1 ... X5.8, two per wire, folded around the wire;
    plus X1 ... X5 for the plugs.
    The layout check behind sheet 2 found a real clash in the plan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
2026-10-21 graphify: update after STATS page, trip statistics and speed calibration
2026-10-22 tooling + docs: working VS Code tasks on stage-c; buttons get a series 1k (audit 2026-10-22)
    VS Code (how the owner builds and flashes):
    - 'Build (make all)' failed on stage-c: the CubeIDE-owned Debug/makefile
    still listed the deleted can_gauges.c/ui_dashboard.c and none of the new
    sources. A headless STM32CubeIDE 1.19 build regenerated it (0 errors,
    0 warnings, same size as tools/build.py); the new task 'CubeIDE:
    regenerate Debug/ and build' does that on demand in its own workspace.
    - New tasks 'Build image variant' / 'Build + flash image variant'
    (tools/build.py with a picked -D: ROAD, ROAD INV for the 2N7000
    backlight driver, DEMO, FT1-4, KOEO) and 'Host tests'. CubeIDE always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
2026-10-22 docs: stage-c flashed on the bench (0501833); rollback is tag flashed-f0a0844
    The ROAD image runs: 30+ s without a reset over ST-LINK, core mostly idle,
    FDCAN / USART2 / button EXTI / display DMA interrupts enabled, GPS probing
    115200 / 9600 with no module. What the screens show is not checked by eye
    yet (checklist from section 1 on). main stops being the rollback target
    once stage-c is merged, so the checklist now names the tag.
2026-10-22 graphify: update for stage-c (build.py --flash)
2026-10-22 ui: fix page switching — page[3] held four page handles; add build.py --lint
    cluster_ui.c declared lv_obj_t *page[3] while PAGE_COUNT became 4 with
    STATS. ui.page[3] landed in the next field, ui.border: cluster_ui_set_page()
    then hid/showed the full-screen alert border instead of the STATS page, and
    the real STATS page (created last, opaque) covered every other page. On the
    bench KEY switched pages internally (ST7735 P0/P1/P3) but the panel only
    ever showed STATS. The array is now sized by PAGE_COUNT (defines moved
    above the struct).
    The -O0 Debug build gives 0 warnings for this; GCC reports it only with
    optimisation ('array subscript 3 is above array bounds'). tools/build.py
    --lint recom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
2026-10-22 feat(trip, perf): TRIP and PERF pages, own odometer, brightness kept in the SPI NOR
    Storage (spi_nor.c, nvlog.c):
    - W25Q64 on the WeAct board, SPI1 PB3/PB4/PD7, CS PD6 (pins and JEDEC
    ef 40 17 confirmed against Zephyr's board file), hand-written init like
    the ST7735 and GPS. Program and erase are started and polled, so a 4 KB
    erase never stalls the loop; bounded SPI timeouts.
    - Journal in the last 1 MB: 32-byte records [magic ver data seq crc32],
    newest valid record wins at boot, a torn slot is skipped, the next
    sector is erased ahead of time, ring of 256 sectors (~80 erases a sector
    a year at 2 h of driving a day).
    Odometer (odo.c): TOTAL / TRIP / A from GPS Doppler speed (gate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
2026-10-22 docs: TRIP / PERF pages and the SPI NOR store
    CLAUDE.md: page order and the UI_PAGE_* rule, the store / odometer /
    timer modules and their rules, brightness profiles now persistent, the
    new host tests. gps-odometer-fuel.md: odometer and storage done (fuel not,
    no source), where the implementation differs from the plan. build-hardware
    6c, bench checklist: pages, brightness kept across power-off (verified on
    the bench: a change survives a reset), what TRIP / PERF show without a car.
2026-10-22 docs: display — why the TN panel 'doubles' between the eyes; IPS options with AU prices
    TN viewing angles are asymmetric (similar 4" ILI9488 TN: 70/70 left-right,
    70 up, 50 down in its native portrait orientation); looked at along the
    bad axis, e.g. lying landscape on the bench, the ~5 degrees between the
    eyes already shift colour, worst on our dark background. Free check first:
    upright, eye level. If it still doubles: IPS. No 4" IPS SPI module exists
    (all 4" ST7796/ILI9488 are TN, 12 o'clock); 3.5" IPS ones do: DFRobot
    DFR0669 is IPS with the same ILI9488 (47.90 AUD, Core Electronics, almost
    no firmware change), Waveshare 3.5" (F) IPS ST7796S (35.30 AUD, Core),
    WS-29318 (~37 AUD, Little B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
2026-10-22 docs: display — why STM32 has so few IPS options here, and the alternatives
    Not STM32 but the interface and our board: 4"+ IPS panels are RGB / MIPI
    with no frame memory, needing LTDC (the H743 has it), a frame buffer and
    20+ pins; the WeAct LQFP100 has no SDRAM and those pins are taken, so only
    SPI modules fit, and 4" SPI modules are TN. Alternatives: an STM32H743IIT6
    core board with SDRAM + RGB connector sold with 4.3/5/7" panels (~US$60,
    same chip, code mostly ports), ST H735G-DK / H747I-DISCO, DWIN DGUS IPS
    over UART, EVE, ESP32-S3, or 3.5" IPS SPI.
2026-10-22 docs: display — one table of all 16 options with pros, cons, firmware work and order links
2026-10-22 docs: display — AliExpress lots checked in the browser; FANKE H743 board pins
    Checked live with the owner's AliExpress session (AU prices, shipping):
    - JR E-Shop 3.5" IPS ILI9488 SPI, same 14-pin header as the current red
    module, IPS No Touch variant AU$19.44 free shipping (~1 week), 4.9 stars
    / 154 reviews: buyers confirm IPS, colour inversion needed, 80 MHz SPI.
    The cheapest real drop-in. XunMing equivalent AU$20.39.
    - FANKE FK743M2-IIT6 (STM32H743IIT6 + SDRAM + RGB) AU$32.79 + 4.3" LCD
    AU$44.39; panel type not stated, and its LCD connector is specified as
    compatible with the TN AT070TN83, so ask the seller about IPS first.
    From its schematic: FDCAN1 on PB8/PB9 (PD0/PD1 are S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
2026-10-22 display: PROBE result — the 4" TN module is a real ILI9488
    The 16-bit probe showed grey: the controller took the RGB565 bytes as
    18-bit pixels (alternating magenta / green), so it is an ILI9488 and the
    existing init is the right one. Comment and docs now describe the grey
    outcome as it looks.
2026-10-22 ui: SemiBold small text, alarm-only strip tags, PC page renderer
    - F12/F14/F20 are Montserrat SemiBold (generated with lv_font_conv,
    ASCII + degree + bullet; LV_SYMBOL_* icons fall back to the built-in
    font of the same size). The thin Medium strokes were mostly
    anti-aliasing mid-tones, which the TN panel shows differently to
    each eye. +19 KB flash.
    - Alert strip: a tag (MIL CLT OIL ATF EGT BAT DTC CAN) is drawn only
    while its system is in amber/red, packed from the left; a healthy tag
    carries nothing (owner's call). All eight at 24 px pitch overlapped
    anyway. The alarm count is gone: the shown tags are the count.
    - NOMINAL could never show in the truck: policy_complete() requir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
2026-10-22 ui: no NOMINAL — the alert strip is empty when all is well
    Owner's call: with complete data and no alarm the summary says nothing;
    PARTIAL DATA, NO ECM DATA, CAN LOST and the alarm text stay. A demo
    image still says DEMO there.
2026-10-22 docs: road-test checklist for 0d3caf3; ui_render --m32 heap check
    - bench-first-flash.md §6/§7 rewritten for what the car test now
    covers: how to read the alarm-only strip, KOEO PID maps (candidates
    for the empty OIL cell, fuel rate), optional oil-pressure KOEO image,
    TRIP / PERF / journal across a power cycle, STATS MEM, daylight look,
    rollback to flashed-1d56fd2 (last road-tested). Status and DEMO
    section updated; flashed-0d3caf3 tagged.
    - tools/ui_render.py prints the LVGL heap use with every page built;
    --m32 builds for 32-bit x86 so it matches the MCU: peak 57 % of
    LV_MEM_SIZE (the 64-bit 92 % was 8-byte pointers). No heap change
    needed.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
2026-10-23 policy: oil temp is required again — it comes from DID 0x1154
    f308cd2 excused oil temp from NOMINAL when the ECM's PID map lacks 0x5C,
    on the belief that this truck never supplies oil temp. Wrong: M_OIL comes
    from the GM DID 0x1154 (works in the truck, 17 / 89-114 C), and 0x5C was
    never its source. With that change a dead 0x1154 would have left the
    strip "all good" over a missing oil temp. Reverted; the test now checks
    the opposite (a map without 0x5C does not excuse oil temp, the DID's
    value completes the data).
    CLAUDE.md's signal table led to the mistake: it listed 0x5C as not
    supported and nothing for 0x1154. Added the 0x1154 row, and replaced
    "soot / DPF not available" with what is ac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
2026-10-23 obd: DPF probe — soot, dp, regen, since-regen DIDs polled again (DIAG)
    The Astra-K DIDs 0x336A (soot, A x 100/255 %), 0x20F4 (dp, signed A
    kPa), 0x20F6 (regen, A & 1) and 0x3039 (km since regen, A x 256 + B,
    0xFFFF = no value) were dropped on 2026-07-24 (b92b875) as "never
    answered", although soot read 8 % on 07-21 and on some 07-24 photos.
    That was the polled-RX era, when replies were also lost behind the
    blocking flush; RX is interrupt-driven since stage C, so ask again —
    as a probe, not a gauge:
    - req_dpf(): one DID per second slow slot, in turn, once the PID maps
    are read (~2-3 s per DID). ECM only, decoded whoever asked.
    - obd_dpf_t: value (NaN = none / no-value code), receive st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
2026-10-23 graphify: update for the DPF probe; checklist points at flashed-7d0acf9
2026-10-23 claude: drop the pinned claude-opus-4-8 model, use the current default
2026-10-26 fix(odo): no double counting when OBD frames are older than the GPS fix (review C8 P1)
    The loop hands the newest GPS fix to the odometer (feed_gps) before it
    decodes the CAN frames of the same period (obd_rx_poll), so an OBD speed is
    often a few ms older than the fix already counted. The unsigned
    `t - gps_last_t` then wrapped, "GPS absent", and the OBD stretch was counted
    again: +4 % at a 5-10 ms loop, +35 % at 20-80 ms, +94 % with 200 ms stalls
    (model of the real loop order on the real odo.c). TOTAL is saved and never
    reset by hand, so the error was permanent.
    - odo.c: every time comparison is signed (within()): gps_present,
    odo_moving, odo_source (trip_app_obd_speed passes an rx time th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
2026-10-26 fix(gps, perf): the timer and the odometer hear that the fix is gone (review C8)
    gps.c stamped fix_ms only for an RMC with a fix, and feed_gps() fed the
    odometer, the acceleration timer and the speedometer check only when
    fix_ms changed — so a lost fix (tunnel, car park) or an NMEA stream that
    stopped was never seen: PERF stayed in READY or kept a RUN clock ticking,
    and READY + 20 s gap + fix back at 55 km/h recorded a made-up
    0-60 = 6.00 s / 0-100 = 10.00 s as LAST and BEST.
    - gps.c/h: rmc_ms (every RMC, fix or not), gga_ms and gps_gga_fresh().
    - feed_gps(): every RMC; GGA quality only while GGAs keep coming.
    - trip_app.c: gates need a current GGA; samples carry rmc_ms.
    - perf.c: a sampl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
2026-10-26 fix(input): no page reset from brightness mode; PWM-safe day/night; boot at the profile (review C8)
    - btn_hold(): in brightness mode a held ● (or ◀) only refreshes the mode
    timer. It used to run the page's reset — TRIP/A counter, PERF results,
    STATS — with nothing on the main panel to say so.
    - btn_step(): a press whose EXTI count arrives one sample after the level
    path took it (edge between the snapshot and the level read) is the same
    press, not a second tap after the release.
    - EXTI: a press counts only after the ISR has seen a release; the first
    quiet release edge read while the contact bounced shut counted as a press.
    - PE15 gets a falling-edge EXTI that latches "LOW se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
2026-10-26 fix(obd): give-ups count only real misses; BOOST on STATS; even rotation (review C8)
    Give-up counters (oil $22 A22C -> NONE after 3, DPF -> SILENT after 10,
    PID maps -> gave_up after 6) last the whole power-up, but counted every
    timeout: a request lost on one-shot TX (TXBCF), or any request while the
    ECM is silent (ACC, still asleep), so 10 s at ACC killed the oil-pressure
    probe until power-off.
    - miss_counts(): a timeout counts only if none of the transaction's TX
    buffers (request, Flow Control) ended cancelled AND the ECM sent a frame
    within ECM_ALIVE_MS (500 ms). A $2C lost on TX gives its define back.
    - PID maps: a try is used by a counted miss, not by sending; a TX-FIFO
    refusal u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
2026-10-26 fix(sniff): a byte first seen in a longer frame is a baseline, not a mover (review C8)
    An ID first seen with a short DLC primed only those bytes; when a longer
    frame of the same ID came, its extra bytes were compared with the zeroed
    table and counted as changes with a span starting at 0 — a bogus mover.
    `primed` is now the number of bytes with a baseline.
    Test: longer_dlc_is_a_baseline (fails on the old can_sniff.c).
2026-10-26 fix(ui): reset streak always shown; no stale first frame; TN-safe colours (review C8)
    - DIAG "LAST RESET": the streak goes first ("LAST RESET x3: ASSERT ...") in
    a 56-byte buffer; rb[40] used to cut "xN" off a long ASSERT text, and a
    reset storm is exactly when it matters.
    - TRIP / PERF / STATS are brought up to date in cluster_ui_set_page(): the
    page used to be drawn once with the labels of its last visit (page switch
    before lv_timer_handler, refresh only later in the iteration).
    - TN palette: a reading nothing judges (OIL P ? before validation, battery
    with the engine off) has a white dot / bar like its value; cyan read as
    "engine cold". The D gear number uses C_OK, not the old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
2026-10-26 fix(nvlog): three ways the journal could lose or roll back the odometer (review C8)
    - A program whose verify read failed (a glitch, the record fine on the chip)
    kept its seq for the retry, so two records shared a seq and at boot the
    first — older data, when newer was queued meanwhile — won. A failed verify
    now uses its seq up.
    - The newest sector was found by its slot 0 or 1 only. With both bad (two
    failed verifies in a row after moving on), the previous sector looked
    newest and this one, holding the newer records, was erased as "the next
    sector". The head search now skips any torn slots and stops at the first
    erased one.
    - A read that failed after the head scan left the st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
2026-10-26 tooling: -D checked, variant lint, Pillow-free renderer that shows every page (review C8)
    build.py
    - -D NAME must be a firmware switch (#ifndef NAME / #define NAME <default>
    in Core/Inc): a typo used to build a plain ROAD image into a directory
    named like the variant.
    - --lint-variants: also lints every Core/Src file that uses a switch, at the
    switch's other values (62 extra passes, 0 findings, ~45 s); code behind
    #if OBD_DEMO / FAULT_TEST / ... was never linted. --lint no longer leaves
    .su files in build/, and counts warnings in lv_conf.h as ours.
    - The "+" dirty mark sees untracked files and build.py itself.
    - --clean keeps build/host and build/render* (the test and renderer cach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
2026-10-26 docs: firmware docs match the code again (review C8)
    - bench-first-flash.md: a C8 status note; DIAG line 3 has five views
    (FT3's SPI line shows 4 s of every 20); a ● hold in brightness mode resets
    nothing; the carrier board needs INV in every later image (KOEO INV, DEMO
    INV; Flash task / F5 are the default image); cranking from ACC restarts
    the board (POWER ON without xN is normal); a rollback that works — the
    old tag in its own git worktree on a short path with today's build.py
    (flashed-1d56fd2 has no tools/; checked to build clean), and for the
    carrier board flashed-7d0acf9 with -D BACKLIGHT_ACTIVE_LOW=0.
    - enhanced-dids.md: the standard diesel PID probe is gone, the PID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
2026-10-26 fix(nvlog): bound the sector-head search to 8 slots
    A sector of old foreign data (no record, no erased slot) cost 128 reads,
    x 256 sectors ~2 s at every boot until the writer had gone round the ring.
    Torn slots in a row are one failed verify each; 8 covers them.
2026-10-26 docs(hw): carrier board for the car — sockets on jumpers, keyed plugs, a lane for USB-C (review C8)
    - Terminals: one hole map; for the car each KF2EDGV socket stands on short
    jumpers in ordinary plated holes, its body glued; bending only on the
    bench (no drilling: a 1.4 mm drill removes the plating the old step 6
    relied on; ~40 deg for a 0.64 mm step, not 20 deg = 0.34 mm).
    - Keys from owned parts: X1 3-pin (+12 / key / GND), X2 4-pin
    (H / L / key / GND), X4.6 key — the 12 V plugs fit only their own
    sockets, CAN can no longer land on 3V3. A fit table and how to make one.
    - USB-C: its axis pointed at X3 on row 30. X3 is now vertical in column W
    (rows 26-30), the TVS in B-H, th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
2026-10-28 fix(obd): back off after bus-off, then only listen (review C9 FW-01)
    obd_check_health() restarted the controller at every 100 ms check while
    PSR.BO was set: 600 restarts a minute modelled on this file, each one an
    error-active node back on the ECM <-> TCM bus. A fault on our side (CAN-H/L
    swapped, a dead transceiver, a bad ground) would destroy other nodes' frames
    for as long as it lasted. BO also stays set through the recovery sequence,
    so stopping again restarted it: on a busy enough bus the node never came back.
    Now one bus-off is one event (rising BO). The first of a streak restarts at
    once; each further one within 60 s waits 1 / 5 / 15 s in bus monitoring mode
    (CCCR.MON: receives, neve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
2026-10-28 fix(fault, tooling): LVGL asserts recorded; -D values checked (review C9)
    FW-02: LV_ASSERT_HANDLER was LVGL's default `while(1);`, so an exhausted
    LVGL heap - the failure to expect as pages grow - read as "LAST RESET:
    WATCHDOG", like any hang. lv_conf.h now calls fault_assert_failed(__FILE__,
    __LINE__): DIAG says "ASSERT lv_xxx.c:<line>". ui_render stubs it and stops
    with the place instead of hanging.
    Tooling:
    - build.py checks the -D value as well as the name (0 / 1, FAULT_TEST 0..4):
    `-D LCD_PROBE=on` used to build a plain ROAD image into build-lcd_probe_on/.
    Every switch also gets a _Static_assert, so a bad value edited into a
    header fails the CubeIDE build too.
    - ui_render.py: -D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
2026-10-28 docs(hw): ILL+ through 10 k at the tap, safe OBD tail, one ground rule (review C9)
    P2:
    - HW-01: X4.5 carried 12 V from the TAIL circuit (10-15 A fuse) on 22 AWG
    with no protection of its own, next to X4.4 (GND) in the terminal block:
    one stray strand blew TAIL - tail lights and dash lights out at night.
    Now 10 k in the wire right at the tap (a short anywhere after it: ~1.5 mA).
    The board is unchanged; the sense threshold moves 2.5 -> ~2.9 V, base
    current at 9 V 0.14 mA (4x margin). harness, build-hardware, carrier-board,
    assembly and the three drawings that show the tap.
    - HW-02: cutting the splitter tail left its other cores live, pin 16 (+12 V
    even with the key out) among the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
2026-10-28 docs: review C9 - findings, fixes and checks; CLAUDE.md follows the code
    docs/REVIEW.md opens with review C9 (main @ d169b6c): what was found, what
    was fixed in 65135a0 / 8894e1c / 83fe2e0, the tests that fail on the old
    code, the checks run (15 host suites, 0 failures; lint of every switch;
    renders), and what is still to verify on hardware - the bus-off check on
    the bench only, never in the truck.
    CLAUDE.md: bus-off back-off and listen-only, LVGL asserts through
    fault_assert_failed(), -D values checked by build.py and ui_render,
    ui_render's stamp / stale PNGs / new scenes, ASan only with gcc / clang.
